ahl20006/House_git/taif_house/docs/DESIGN_LANGUAGE.md

# Taif / Palm House · design language

**Theme: modern classic with a Taif spirit.** Calm, warm, simple; the Taif references are in the stone, the arches, the colonnade and a little mashrabiya, not in ornament. Recorded 30 Oct 2026 (owner); every study and detail from here on follows it. The 3D character study (`3d/character.yaml`) is to be brought in line with this list when it is next touched.

*V9.0 (layout freeze, 6 Nov 2026):* the plan is frozen; the facades and the details are the next design stage and follow this list and the facade principle R-37 (the house stands inside a fully walled private farm: the facades are designed for light, views, climate and composition, not for privacy from outside). The 3D now shows the existing farm round the house (the old house, its covered parking, the walls and the gate, the palms) as plain approximate masses, not as design.

**9 Nov 2026 (owner): NO stone on the exterior.** No stone and no stone cladding anywhere outside, the malqaf tower included: every exterior finish is *render (plaster) and paint*. The character comes from the window proportions, the arches, the depth of the recesses and the projections that make shadows, all *built into the structure* in block and concrete, not applied later. Colours: a light sand render; an optional calm honey tone on the projections; a smooth or lightly textured exterior paint. Builder's rules: plaster mesh over every block / concrete junction before rendering; drips and falls on every projection from the start. **This supersedes every "honey stone" on the exterior below** (the plinth and the corners, the colonnade's columns and the arcade, the cornices and copings, the malqaf, the ladder's pilaster): read them as the same forms in render, the projections in the honey tone. **Floors too (owner, 9 Nov 2026): no stone and no marble on any floor, inside or outside: porcelain tiles everywhere**: inside a marble-look porcelain; outside (the courtyard, the colonnade, the riwaq, the paths, the guest path) an outdoor anti-slip porcelain (R11) in a sand / honey tone. Every "stone" or "marble" floor below reads as this porcelain. The facade study (windows, shaping, finishes) follows the plan freeze (open items 20, 21).

| Element | The language |
|---|---|
| Interior walls | Warm white (cream) plaster |
| Floors | **9 Nov 2026: porcelain tiles only**: marble-look porcelain inside; outdoor anti-slip porcelain (R11) in a sand / honey tone in the courtyard, the colonnade, the riwaq and the paths. *Was:* marble inside, matte honey-coloured stone in the courtyard |
| Cornices | Very simple, thin |
| Exterior | **9 Nov 2026: render and paint only** (light sand; the projections in an optional calm honey tone); the base and the corners shaped in the structure, no stone. *Was:* cream plaster with honey stone at the base (plinth) and the corners |
| Metal | Matte black; a few brass touches in the lighting |
| Timber | Medium-to-dark walnut (doors, soffits, built-ins) |
| Arches | Semicircular (Roman): the living's entrance arch and the TV arch; **V7.1:** the courtyard arcade with three arches under the projection (two slender stone columns between C21 and C22, courtyard bay only; the living bay keeps no arches) and arched heads on all the courtyard enclosure windows (six on the gallery edge over the arcade bays, two on the family living's edge, one large one over the living's courtyard glass): a two-tier classical arcade |
| Windows and doors to outside | Black steel with divided lites; the courtyard enclosure windows with semicircular heads (V7.1), the arched heads fixed, the operable lites below |
| Colonnade | Round honey-stone columns (the three two-storey columns of the courtyard) and, in the courtyard bay, two slender Ø0.25 intermediate columns of the arcade (V7.1) |
| Stair railing | Simple black bar railing; **V8.2:** the flipped stair's lower flight open to the riwaq behind a 0.90 m black-bar balustrade, the stair well's railing on the first floor the same |
| Mashrabiya | Only in a few places, not as a theme: the malqaf's carved grille and louvred outlet (V10.0), the non-escape windows (office, suite lobby, women's majlis, dining), never on an escape window (V8.0 fire safety); **adopted (V8.2, owner):** the suite court's south side a mashrabiya screen (timber or black steel lattice, ≈ 40 % open) on the 1.10 m base up to the facade frame's soffit: the palms seen out, no view in |
| Lighting | Mostly hidden (coves, under shelves, in the arches); a few feature pieces (lanterns under the colonnade, one piece over the dining) |
| Roof and roofline (31 Oct 2026, V8.1) | Flat roof, no pitched or tiled roof anywhere. A strong honey-stone **main cornice** on the outer facade edge at roof level, all round. On the north block a raised roof screen (an "attic") set back ≈ 1.0 m behind the cornice, plastered cream with a stone coping, **1.40 m** above the roof finish (V8.1: lower and balanced; it still hides the plant) — a plain pentagon; the south wing (gym and office) keeps the cornice and a **low parapet 0.70 m**, the fall protection a black steel guardrail set back 1.0 m and not seen from the street, so the roofline steps ≈ 0.7 m; across the suite court's south side the cornice and the parapet run on as a facade frame. Above the attic only one vertical: the malqaf head (V10.0) at the courtyard's north-west corner, inside the attic's pentagon, hidden from the gate. A simple thin stone cornice between the two floors. (`studies/roof.typ`) |
| The malqaf (V10.0, owner; L5) | *The symbol of the house, seen from the courtyard where the family lives:* an RC core at the courtyard's north-west corner in render and paint (no stone): at the ground floor the foot chamber's solid rendered face with a built-in bench on the riwaq, a carved timber door with a semicircular head onto the covered strip, the breeze outlet 1.4 × 1.0 with adjustable timber louvres in the first arcade arch; at the first floor the shaft at the gallery's end with a carved arched grille (a sealed provision) and a blind arched recess where W1-1 was; above the roof the head 1.6 × 2.4 on the first bay's axis, an RC frame with rendered block ribs, 3 / 5 slender arched slots per face on the 20 cm module (dark slots, a bird mesh behind), a thin band and a two-step Hijazi crown in the honey tone, 4.5 m above the attic coping; hidden from the gate by the north facade. The plant (the filters, the fan, the silencer) in the foot chamber; nothing on the roof. (`studies/malqaf_L5.typ`, adopted; the L1 tower of V9.3 superseded.) |
| Roof ladder (V8.1) | In the suite court, a honey-stone pilaster on the gym's east wall holds the maintenance ladder behind a flush walnut-finish panel: closed, the court reads a timber panel in a stone frame; the black steel stiles rise 1.10 m above the gym roof beside the court guard. |
| Courtyard (revised 3 Nov 2026) | Matte honey-light stone floor, LEVEL, no step; modern movable outdoor furniture (sofas, armchairs in outdoor fabrics, a low table); the outdoor TV in a semicircular honey-stone surround (a visual frame, no cavity) on the kitchen wall; one honey-stone box on the kitchen wall in front of the sink window for the raised water trough (a laminar lip over stone, no spray) and the tree; linear slot drains in bronze; no pergola. |

How to read it: black steel and divided lites wherever glass meets the outside, including the courtyard enclosure (`studies/courtyard_enclosure.typ`); stone where the hand or the eye meets the ground (plinth, columns, courtyard floor, copings); walnut where the hand meets the house (doors, handrails, the TV cabinet); nothing gilded, nothing carved.
| Coat cupboard and the store door (V8.2) | At the stair's start a full-height walnut coat cupboard (flush doors, no handles seen); the store under the half landing behind a low walnut door on the riwaq. |
| Site (V8.2, `studies/site_plan.typ`) | The guest path a 1.2 m band of honey stone along the driveway with black bollard lights; the garden's 1.2 m wall in honey stone with planting behind it; the hedge a clipped evergreen 1.8 m; the service yard screen plastered cream like the house with a stone base; the LPG cabinet matte black steel. The east stack (plumbing proposal) behind a removable panel of honey-stone slats on a black frame, on the service-yard face only. |
| Facade principle (owner, 3 Nov 2026) | The house stands inside a large, fully walled private farm (a 4 m north gate and a distant south gate; everything else walled and closed). Nobody outside can see the house. The facades are designed for light, views, climate (sun, heat, dust) and composition, NOT for privacy from outside. Blank walls only where a room needs them (furniture, structure, services) or where the owner chooses privacy from the guests' path to the majlis (west side). To be applied at the facade design stage (no geometry change now): the mashrabiya stays a climate and composition element, not a privacy screen, except on the guests' west side. |
| Powder room (3 Nov 2026) | The ground-floor family powder room: a stone or marble vanity with two basins under one large mirror, cove lighting, the wall-hung WC at the far end on a stone-clad service wall, walnut door from the riwaq. |
