ahl20006/House_git/taif_house/docs/REQUIREMENTS.md

# Taif / Palm House · owner's requirements (V6, 30 Oct 2026 · updated for V9.0, the layout freeze, 6 Nov 2026)

The owner's brief written as numbered, testable requirements. Each has a criterion the design can be checked against; where the owner gave no number, the criterion is a reasonable measurable proxy and is marked *(proxy)*. The design review `docs/review/design_review.typ` → `output/Design_Review_V6.pdf` checks every requirement against the project files (`data/*.csv`, the design files and the studies) and records **met / partly / not met** with evidence.

*V9.0 (6 Nov 2026):* the layout is frozen (`PROJECT_V10.md` §5); bedroom 1 is the room for very young children next to the master suite, with no en-suite (they are bathed in the suite's bathroom), which answers R-01 / R-09 for the children's bathing; the site requirements are met at the final position set out on site (B1 5.49 m from M1; the cut wall 0.42 m from a setback counted from the boundary wall as built, 0.90 m from the deed line), to be confirmed by the official survey.

Sources for the criteria: the owner's brief (this file); municipal villa rules as published by the Ministry of Municipal and Rural Affairs and Housing (MOMAH) and reported in July 2024 (building ratio up to 75 %, two parking spaces for villas over 400 m², driver's / maid's room ≥ 6.5 m² and ≥ 2.1 m wide); the Saudi Building Code (SBC 201 general, SBC 1101 residential, SBC 501 mechanical, SBC 601/602 energy, SBC 701 plumbing, SBC 801 fire); international practice (ISO 21542 accessibility, ASHRAE 62.2 residential ventilation, ASHRAE 52.2 / ISO 16890 filters, BS EN 17037 daylight, IRC residential stair and egress figures on which SBC 1101 is based). Where a code figure could not be read from the code text it is marked *not verified* in the review.

## A · Household and life
| ID | Requirement | Criterion |
|---|---|---|
| R-01 | 5–6 permanent residents; children of mixed ages, some sharing a bedroom | ≥ 4 bedrooms (master + 3) or 3 + one room convertible to a bedroom; at least one children's bedroom ≥ 12 m² clear that takes two beds (two 0.9 × 2.0 beds, two wardrobes, a desk) |
| R-02 | Live-in maid: a maid wing as designed, with her own bath and a private route | Maid room ≥ 6.5 m² and ≥ 2.1 m wide (MOMAH 2024), window, lockable door, own bath with shower; reachable without crossing family rooms — **met V7.0:** 7.28 m² clear, 2.49 m at the bed (the kitchen's north wall moved to y 7.0) |
| R-03 | No driver room in the house (the driver lives in the farm's workers' housing) | No driver room drawn |
| R-04 | No ground-floor bedroom; no prayer room | None drawn; a multi-use room may serve prayer informally |
| R-05 | Medium storage | *(proxy)* one general store ≥ 4 m² that is not temporary, a linen cupboard, a coat cupboard at the entrance (**V8.2:** a full-height coat cupboard in the stair's start strip; the store under the half landing), pantry cabinets ≥ 1.8 m run, an outdoor / garden store |
| R-06 | Ageing in place is very important: a lift | **Decided V6.3:** a two-stop lift installed at construction, before the family moves in; car ≥ 1.1 × 1.4 m, door ≥ 0.80 m clear; the shaft size from a supplier's civil drawing (open item) |
| R-07 | Wide corridors and doors | Door clear widths ≥ 0.85 m on every daily route including bathrooms (0.80 m minimum) — **decided V6.3:** every bedroom and bathroom door a 1.00 m opening with a 0.90 m leaf (the guest WC 0.90 m opening and the maid bath 0.70 m are the recorded exceptions); corridors ≥ 1.2 m clear (1.0 m minimum) — **met V7.0:** the gallery 1.405 m clear, 1.235 m at the column sleeves (the projection 1.55 m); a 1.5 m turning circle in at least one bathroom and at the lift |
| R-08 | Step-free routes | No step between the parking, the family entrance, the lift, the living / dining, the kitchen, the courtyard's level edge and every bedroom and bathroom; thresholds ≤ 15 mm |
| R-09 | Safe bathrooms | Level walk-in showers (no tray step), grab-bar blocking at every WC and shower, non-slip floors. **Owner, 3 Nov 2026: NO shower on the ground floor and no hidden provision** (G-07 closed): ageing in place relies on the lift (R-06) and the first-floor bathrooms; the ground floor has the family powder room (WC + two basins, a 1.5 m turning circle) and the guest WC |
| R-10 | Stair safe for life | Handrails on both sides, risers ≤ 170 mm, goings ≥ 280 mm, flights ≥ 1.0 m, straight flights (stairlift-ready), lit at night, headroom ≥ 2.1 m — headroom 2.22 m (**V8.2:** the stair flipped, option B: the lower flight rises south off the lobby, the upper flight arrives beside the lift; headroom 2.22 m at tread 6 under the mirrored trimmers); **V8.0:** the stair stops at the first floor; **V8.1:** the roof by a maintenance ladder in the suite court (not a stair for life: behind a locked panel) |
| R-11 | Daily family entrance directly from the parking; two shaded parking spaces | Two covered spaces inside the plot (MOMAH 2024: two for villas over 400 m²), ≤ 10 m walk to the family door, the walk covered, no step — **V8.2 (site plan, owner):** the family's existing covered parking for two cars south of the old house (beyond the plot) stays, plus one uncovered car in the north setback strip (kept; the municipality allows it), 0.3 m from the family entrance path; the walk from the covered parking is on the driveway, uncovered: *partly* |

## B · Guests
| ID | Requirement | Criterion |
|---|---|---|
| R-12 | New men's majlis for regular weekly guests, ≈ 20–24 | Perimeter seating ≥ 24 × 0.7 m = 16.8 m, a serving route that does not cross the seats, AC not over the seats |
| R-13 | Very large events (30+) use the old majlis on the farm | The new majlis need not seat 30+; no second guest WC is required for that case |
| R-14 | Guest facilities separate from the family | Own entrance, foyer with a majaz (no straight view in), guest WC and basins reached without entering family space |
| R-15 | Full separation: a guest must never see any family area | No sightline from the guest entrance, foyer, majlis or guest WC into any family room, the courtyard, the family entrance or the family's cars; serving without eye contact |
| R-16 | Women guests are rare | A room usable by women guests reached from the family entrance without crossing the men's route |

## C · Kitchen and food
| ID | Requirement | Criterion |
|---|---|---|
| R-17 | Daily heavy Saudi cooking by the owner and his wife; kitchen closed with a door | A door on every opening of the kitchen to living space; hood ≥ 600 m³/h exhausting directly outside with make-up air; durable finishes; ≥ 2 counter runs of ≥ 3.0 m |
| R-18 | Medium pantry (cabinets) | Tall storage ≥ 1.8 m run in or beside the kitchen |
| R-19 | Outdoor kitchen with grill and tannour outside the house, next to the kitchen service door (owner, 3 Nov 2026; was: at the south-east corner) | Drawn at the SE corner, reached from the kitchen service door, downwind of the house (prevailing wind NW), with a family seating area near the palms — **V8.1:** the counter and sink against the east wall at the south-east on the service-door path, the grill and tannour apart in the garden, 3.6 m from the house (`design_gf.typ` site outlines); **V8.2:** on the site plan with the family garden round the palms; **3 Nov 2026:** the counter and sink next to the service door (under the kitchen window, a canopy optional), the grill and tannour a little apart in the yard's south part, ≥ 3 m from every door, window and the hood outlet, 13 m from the HRV intake, downwind |
| R-20 | Service yard (bins, gas) screened from the outdoor-kitchen path | Bins and the gas cabinet at the service door, behind a screen, not on the family's path to the outdoor kitchen — **V8.0:** a 1.8 m screen along the yard, the path in front of it; **V8.2:** the LPG cabinet on the screen's outer face (≥ 1.5 m from every opening, ≥ 3 m from the manhole; the rule stated); **3 Nov 2026:** the screen moved east for the counter's working strip, the gas cabinet at the screen's north end ≥ 3 m from the grill, the bins north of the service door away from the food, the workers' route along the farm's boundary wall (not the house's north facade) ending at the gas and the bins |

## D · Daily life
| ID | Requirement | Criterion |
|---|---|---|
| R-21 | Living + dining in one room ≈ 53.5 m² clear, for TV, family meals and close relatives equally | 50–57 m² clear; a dining table for 10; TV seating for 6–8 |
| R-22 | TV 85″ on the west wall inside the big arch, seating facing it, dining behind; a good sound system, no cinema | The west wall solid and full height with the TV arch and the small entrance arch; sofa 3–5 m from the screen facing west; the dining east of the seating; conduits and speaker positions provided |
| R-23 | The courtyard is the heart: daily sitting, coffee and meals (children's play in the garden, owner 1 Nov 2026) | ≥ 20 m² usable floor, seating for 4 comfortably (6 at most) with a low table for meals, the outdoor TV, lighting, a hose point and drainage; no level play zone required in the courtyard (it moves to the garden, R-30); no pergola or shade structure (`studies/courtyard_layout.typ`) |
| R-24 | **Revised 3 Nov 2026:** the whole courtyard floor LEVEL (no step anywhere), modern movable furniture (sofas, armchairs) for 4–6 with a low table, the outdoor TV on the kitchen wall (**V10.0:** the malqaf outlet moved to the first arcade arch on the west side, L5), the water + tree enclosure on the kitchen wall in front of the sink window | Drawn as decided (`studies/courtyard_layout.typ`): gentle falls from the glass lines to linear drains on the separate rain system with trap primers and an overflow route, the malqaf outlet's bottom 0.10 above the floor in the first arcade arch (V10.0), the raised water trough's rim below the sink sill (seen from the sink), a laminar lip over stone, the two basins drained separately; the north side in front of the women's majlis glass free; no pergola |
| R-25 | Dust: the house is closed most of the time; filtered mechanical fresh air | ERV / HRV with ISO ePM1 ≥ 50 % (≈ MERV 13) or better filters, slight positive pressure; airtight windows and doors; the conditioned envelope closed on all sides — **decided V7.0:** the courtyard enclosure option A; **V8.0:** a 750 m³/h class HRV in the malqaf's base; **V10.0 (owner): no HRV: a 750 m³/h filtered supply fan** (a washable pre-filter + ISO ePM1 ≥ 50 %, a silencer) in the malqaf's foot chamber at the courtyard's north-west corner, the house at a slight positive pressure, two switches and a dust relay, the hood's make-up inlet mandatory (`AIR_SYSTEM.md` v4; the MEP engineer designs it, open item 9) |
| R-26 | Owner's office, used sometimes | An office ≥ 12 m² with a desk, visitor chairs and shelves — **met:** 13.96 m² clear on the east; **V8.1:** for the owner only, reached from the suite court; visitors are met in the men's majlis |
| R-27 | Small family gym (V8.0: on the west band) | ≈ 18 m² clear; the treadmill with a manufacturer-type zone (2.0 m behind, 0.5 m each side); the other equipment; a double wall to the neighbouring bedroom (Rw ≈ 55 dB) — **met V8.0:** 19.9 m² clear incl. the entrance nib |
| R-28 | Master suite: freestanding tub plus walk-in shower; no coffee corner; medium quietness | Tub and walk-in shower drawn; no coffee corner; no noise source (plant, gym, majlis) adjacent without Rw ≥ 50 dB separation; no operable opening from a noisy room into the suite court — **V8.0:** the office (quiet) is the suite bedroom's neighbour, no door between them; the gym 4.7 m away across the court |
| R-29 | No pets | No pet provisions |

## E · Outside, energy, security
| ID | Requirement | Criterion |
|---|---|---|
| R-30 | A garden around the house (trees, lawn, seating); children's play in the garden (owner 1 Nov 2026) | **V8.2 (site plan, owner):** the family garden on the south side only, round the palms (≈ 289 m²), behind a 1.2 m rendered wall (V10.0: no stone) and a 1.8 m hedge; no other garden round the house; **no garden door from the living** (S-04 not needed, owner): the garden is reached from the kitchen's service door round the south-east corner or from the guest entrance side; the palms kept; a level play area in the garden |
| R-31 | Solar PV: full provision now, installation later | Roof area reserved and free of shade; fixing points cast before waterproofing; conduits from the roof to the panel; an inverter / battery room; a load assumed in the roof structure — **partly V8.1:** 9.8 m² on the gym roof and the office roof inside the set-back guardrail and 20.5 m² on the north block (`studies/roof.typ`); **V8.2:** the conduits down the west shaft to the utility room, where the inverter and the battery cabinet go (owner; the electrical engineer confirms space, ventilation and fire safety; the layout with the water kept away in `studies/plumbing.typ`) |
| R-32 | Power cuts with rain: backup | **Changed by the owner (V8.2, review E-05): no generator.** The backup comes from the PV and the batteries when installed; until then there is no backup during power cuts (the lift, the malqaf's fan, the pumps and the gas valve stop; the gas valve and the malqaf's dampers fail closed); an essentials circuit at the main panel for the later batteries (pumps, fridges, network, cameras, some lights, the lift's battery lowering) |
| R-33 | Security high: CCTV, alarm, video intercom at the gates and doors | Camera positions at the gate, the three doors and the yards; an alarm; intercoms at the gate and both entrances. **Owner, 1 Nov 2026: no safe room** (home-level strategy; `studies/fire_escape.typ` §4). **V8.2 (site plan):** a video intercom and camera C1 at the single gate, cameras C2–C7 round the house (the driveway, the family entrance, the guest entrance and path, the service yard, the garden, the suite court's outside), the recorder and the alarm panel in the utility room, keypads at both entrances; positions proposed, the electrical engineer designs it |

## F · Priorities and decisions
| ID | Requirement | Criterion |
|---|---|---|
| R-34 | Quality first (high budget); luxury most important in the living room and the courtyard | The living and the courtyard get the best light, proportions, materials and acoustics; nothing cheap there |
| R-37 | **Facade principle (owner, 3 Nov 2026):** the house stands inside a large, fully walled private farm (a 4 m north gate and a distant south gate; everything else walled and closed). Nobody outside can see the house. The facades are designed for light, views, climate (sun, heat, dust) and composition, NOT for privacy from outside. Blank walls only where a room needs them (furniture, structure, services) or where the owner chooses privacy from the guests' path to the majlis (west side) | Applied at the facade design stage: every wall now drawn blank or with small / high windows for privacy (the north facade first: the women's majlis, the kids' room and the family living above) is a candidate to open with larger windows (north light: soft, no direct sun); the escape windows and the climate rules (shading, dust) still govern; the list in `docs/PENDING_CHANGES.md` |
| R-36 | Fire safety at a family-home level: early warning and safe exit (owner, 1 Nov 2026) | Interconnected mains smoke alarms with sealed battery back-up in every bedroom, outside each sleeping area and on every floor, a heat alarm in the kitchen, a gas detector with shut-off and a CO alarm; every exit door opens from inside without a key; hinged escape casements without screens in every sleeping room (net ≥ 0.53 m², sill ≤ 1.12 m), the suite court as the suite's refuge; a fire blanket and an extinguisher in the kitchen, one per floor at the stair; no sprinklers, fire doors, panel, beam detectors, majlis second door or safe room (`studies/fire_escape.typ`) |
| R-35 | Recent decisions to respect | West living wall full height and solid with the big TV arch and the small entrance arch; no arches between the colonnade columns; colonnade columns to the roof; upturned edge beam; the malqaf outlet in the first arcade arch (V10.0, L5; was on the kitchen wall); kitchen service door; **V7.0:** the courtyard enclosure option A, the maid room at y 7.0, the flat roof with the main cornice and the set-back attic, the design language; **V7.1:** the arched enclosure windows and the three-arch courtyard arcade; **V8.0:** the fire safety at home level, the courtyard layout, the air system v3.1, the internal stair to the first floor only, the south wing v2; **V8.1:** the roof by a maintenance ladder in the suite court, the roofline lowered (attic 1.40 m, south parapet 0.70 m with a set-back guardrail), one site entry (the farm's 4 m main gate); **V8.2:** the stair flipped (option B) with the family bath F-b and the coat cupboard, bedroom 1 without a bath, the suite court's mashrabiya, the clerestories openable, the food route accepted, the site plan's decisions (the north parking kept, the south garden, no garden door, no generator, the septic near C1 and the tank east of peg R); **V10.0:** the malqaf at L5 (the courtyard's north-west corner), no HRV, no stone anywhere (render and paint; porcelain floors), simple controls — each present in the files as decided |
