ahl20006/House_git/taif_house/3d/README_3D.md

# 3D model · Taif / Palm House V10.0 · phases 1–3 + character study + the V7.0 – V9.0 design (enclosure, roofline, arcade, the level courtyard layout, air system v3.1, south wing v2, roof ladder, the flipped stair, the court's mashrabiya, the site elements)

**V10.0** (the malqaf at L5; no stone): the malqaf core at the courtyard's north-west corner from `design_gf.typ` `tower-csv` and the `air-*` data of `studies/air_system.typ` v4: the GF foot chamber (the dust trap `gf_air_trap_*`, the fan cabinet, the cooler's floor mark, the louvred outlet `gf_air_grille` in the first arcade arch, the carved door drawn open `gf_air_door_leaf`), the shaft opening 0.96 m² through the FF and roof slabs, the head 1.6 × 2.4 to +13.20 as an RC frame with the slender arched slots as dark voids (`roof_air_head*`, `roof_air_void_slots`, the band and the crown in the honey tone); the L1 tower, its plant room, plenum and the channel removed; the blind arch where W1-1 was (`arched_windows.blind`); the palette renamed for the no-stone decision (`honey` = the honey-tone render, `sand` = outdoor porcelain, `porcelain` inside); the `court` bookmark (the outlet arch, the blind arch and the head on one axis); the viewer's note. Renders: `char_court.png`, `char_gate.png`, `char_aerial_sw.png`.

**V9.3** (the L1 malqaf tower, superseded by V10.0): the slim shaft along the cut wall (its slab openings ≈ 1.06 m²), the rooms round it from the CSVs (the maid store, bedroom 1's cupboard); above the roof the 1.25 m honey-stone tower on the attic's corner (`roof_air_head*`, `roof_air_cap`; the slender arched openings as dark voids `roof_air_void_slots`), crown +12.18; the HRV plant room behind the attic (`roof_air_plant_*`), the plenum, the exhaust grille; the old head and base removed; a north-east aerial bookmark (`aerial_ne`); the viewer no longer clips above +10.0 m. Renders: `char_gate.png`, `char_aerial_ne.png`.

**V9.2** (small fixes, no new renders): the air tower a rectangle (1.425 × 1.0 on axes, the shaft opening ≈ 0.98 m², the head open on its north, west and east faces), the maid bath and bedroom 1 with the wedge beside it (from the CSVs), the HRV base at its V9.0 footprint, the attic 2 cm lower (coping +8.68).

**V9.1** moved the model to the final site position (`character.yaml` `site.shift` 0.91 / 6.0734, B1 6.00 m from M1; every house-attached site element with it; the parking bay on the car's turning line) and shortens the cut wall a further 0.24 m (the outline, the air tower and its shaft ≈ 1.25 m², the HRV base, the maid room, the maid bath and bedroom 1 from the CSVs, their windows on the cut); render: `char_aerial_sw.png`.

**V9.0 (layout freeze)** brought the model fully up to date, every part generated from the files: the house at its **final site position** (`character.yaml` `site.shift` 0.91 / 5.563, every house-attached site element 0.50 m further south), the **cut wall 0.12 m further out** (the outline, the air tower and its HRV base, the windows on the cut from the design files and `params.yaml`), and the **existing farm round the house** (`character.yaml` `site.elements` with `existing: true`, from `data/site_v2.csv` and the owner's answers; approximate, to be measured): the old house as a plain 3.8 m mass and its annex wall from the deed sketch, the covered parking (posts and a roof), the ground tank's lid, the septic, the farm's north and lane walls on the deed line with the 4 m gate's two posts, the two palms (trunks and crowns, heights assumed). The builder gains the element kinds `block`, `canopy` and `palm`; check 10 checks the existing farm apart (on the ground, in the north zone, nothing touching the house) and the tower's shaft bound follows the bigger tower. **Renders V9.0:** `char_aerial_sw.png` (the house, the driveway, the old house, the palms, from the south-west), `char_gate.png` (the north facade from the main gate, a new view), `char_living.png` (the main courtyard from the living), `char_court_screen.png` (the suite court with the mashrabiya).

**V8.3** rebuilds the **courtyard layout** from `character.yaml` `courtyard_layout`: the floor level (the base model's courtyard floor kept, no pit, no benches), the movable furniture (group `sunken` = the layout toggle in the viewer), the enclosure on the kitchen wall in front of the sink window (the planter rim +0.45, the raised water trough rim +0.95), the TV and its surround moved south over the grille (+0.10 … +0.45), the linear drains and the overflow; check 10 verifies it. The **outdoor kitchen** moved next to the service door (`params.yaml` `outdoor_kitchen`) and the **site elements** follow the re-planned yard (the screen, the gas cabinet, the bins, the workers' path along the boundary wall). The first-floor rooms from the CSV carry bedroom 2's en-suite and the family WC; the ground floor the powder room. Renders: `char_living.png`, `char_lobby.png`.

**V8.2** adds, all generated from the files: the **flipped stair** (`studies/structure.typ` `st` with its direction: the lower flight on the east half rising south off the lobby with its black-bar balustrade on the riwaq, the half landing at the south end with the store under it, the upper flight arriving beside the lift; the trimmers mirrored), the **larger family bath F-b** with its WC compartment (from the CSV), the **coat cupboard** (`character.yaml` `coat_cupboard`), the **suite court's mashrabiya screen** (`character.yaml` `suite_court_v2.south_side` chosen b: a timber lattice from the 1.10 base to the frame soffit, ≈ 40 % open, built by `character_3d.py`), and the **site elements** of the site plan that the builder supports (`character.yaml` `site`, group `site`: the driveway, the family, guest and workers' paths, the north parking bay, the south garden with its stone wall and the hedge, the yard screen and the gas cabinet; study, every position proposed). Check 10 verifies the screen and the site elements. Renders: `char_lobby.png`, `char_court_screen.png`, `char_aerial_sw.png`.

**V8.1** adds, all generated from the files: the **roof ladder** in the suite court (`params.yaml` `roof_design.ladder`: a honey-stone pilaster on the gym's east wall with a 0.90 × 0.30 recess, the closed walnut-finish panel, the stiles and 13 rungs, the stiles 1.10 m above the roof, the self-closing gate in the court's west guard); the **lowered roofline** (the attic 1.40 m above the roof finish, coping +8.70; the south wing parapet 0.70 m, +8.00); the **set-back guardrail** 1.10 m, 1.0 m in from the south wing's faces (`guardrail_setback`); the **outdoor kitchen** (`outdoor_kitchen`: the counter against the east wall, the grill and tannour apart); the office's east window. **Renders V8.1** (`render_views.py`): `output/char_north.png` (the north facade from the street), `char_aerial_se.png` (the roofline and the malqaf tower from the south-east), `char_suite_court_sw.png` (the suite court from its east armchair, looking west-south-west to the gym wall with the ladder panel). The other renders in `output/` are from earlier versions.

**V8.0** added the internal stair stopping at the first floor (the roof slab closed over the well, no stair room), the **air system v3.1** (the malqaf head open on three faces over the **HRV base** on the roof), the **courtyard layout** (the seating one step down, the benches, the TV in its stone surround with the grille below it, the north enclosure with the water basin and the tree; no pergola, no fountain, no sunken pit) and the **south wing v2** (the gym on the west band, the 25 m² suite court open to the south facade over a 1.10 m base with R8 as its frame, the office on the east) with the court's guards and seating.

**V7.1** adds the **courtyard arcade** (two Ø0.25 stone columns on x 5.80 at y 8.667 / 10.833 with three semicircular arch plates under the projection's soffit, courtyard bay only, decorative) and **semicircular heads** on the enclosure windows (W1 six, W2 two, W3 one; the base model cuts each opening to its crown, the character layer draws the spandrel plate and the arched frame); the family living is open to the gallery's north end (W2 only east of C21); marble floors inside, honey-light stone in the courtyard.

**V7.0** adds, all generated from the files: the courtyard enclosure windows **W1 / W2 / W3** (walls with steel windows on the former open edges, the W3 wall piece over the living's courtyard glass), the **1.55 m projection** with the colonnade at x 5.80, the **stair to the roof** (flights 3 / 4, the roof opening with R16–R18, the stair room), the **roofline** of `studies/roof.typ` (the main cornice, the band between the floors, the north block's coping, the south wing's parapet, the set-back attic with its doors and coping; `params.yaml` `roof_design`), the roof guards, the maid-wing change, and the **design-language colours** (`docs/DESIGN_LANGUAGE.md`: cream plaster, honey stone, black steel divided lites, walnut) with stone quoins and divided-lite bars on every window. The gallery railing variants (parapet / glass) are gone: the gallery edge is the wall with W1.

The 3D model is **generated from the project files, never edited by hand**. One script reads the room data, the design files, the two first-floor studies, the presentation's door and window lists and the structural study, and builds the model; any change in those files → run the script again → the 3D updates.

**Every structural element in the model is marked:** orange = *assumed, not approved by the engineer* (sizes from `studies/structure.typ`), red = *unconfirmed load path* (X5). Nothing here is a structural design.

**The character study** (tags `3d-char1`, `3d-char2`, `3d/character.yaml`) is a **STYLE STUDY, PROVISIONAL**: materials and a few added elements for the owner to compare in the viewer; the viewer says so on every view. It changes nothing in the design files, the room CSVs or `params.yaml`; see § Character study below. Revision 2 (`3d-char2`): lighter, warmer colours; the views rendered with the sun and shadows; the malqaf outlet on the kitchen wall (an owner decision recorded in `studies/air_system.typ`, `docs/AIR_SYSTEM.md`, `data/decisions.csv`) with the sunken seating under it (variant, on by default).

## What the model contains (phases 1–3)
- **Slabs** at structural levels: ground slab (−0.28 … −0.08), first-floor slab (top +3.52) with the courtyard sky, the double-height living and the L-shaped stair opening cut out, roof slab (top +7.20) with the courtyard sky and the suite court cut out. **Since V6.3 the first-floor and roof bays carry the thickness of `studies/structure.typ`** (`slabs-ff` / `slabs-roof`: 0.30 ribbed over the kitchen, dining, men's majlis, suite and office, 0.22 flat over the double-height void, 0.20 elsewhere), all assumed; the walls run to the 0.20 underside (+3.32 / +7.00) and the thicker bays hang below it (+3.22 / +6.90, +6.98 under the 0.22). The slabs run to the **outer face** of the outer walls. **Floor finishes** 0.08 on both floors (to ±0.00 and +3.60) and a 0.10 roof finish (to +7.30).
- **Outer walls** of both floors, 0.25 m, centred on the pentagon outline; **interior walls** 0.20 m on the room edges, from the structural slab top to the underside of the slab above; **open edges** (`open_edges.csv`) left open. A room edge that lies on the outline with rounded corners (the cut wall: 10.594 for 10.5943) is the outer wall, not a wall of its own (corrected in `3d-char1`: five 0.20 walls were built inside the outer ring along the cut, and the cut wall's four windows were cut through them instead of the outer wall).
- **Doors and windows of both floors**, cut through the walls with their sill and lintel pieces: 28 doors (leaves modelled closed; the courtyard glass door and the suite court door as glass) and 31 windows (glass, transparent in the viewer), among them the courtyard glazing (full height under the beams), the living glazing split by column C22, the two clerestory windows at +5.00 … +6.00, the kitchen service door and the suite bath's 0.60 m east window (X3). Heights are assumed in `params.yaml` (the plans have none yet).
- **The stair** exactly as drawn in `studies/structure.typ`: two flights of 1.21 m side by side, 22 risers × 0.164, goings 0.28, the half landing at +1.80 (store below, 1.57 m clear), the arrival at +3.60 on the first-floor slab, the L-shaped opening (≈ 8.2 m²), the trimmers B16–B18 (0.20 × 0.40 total, soffit +3.12), the balustrades (0.90 above the nosings) and the first-floor railings round the well (1.10). The headroom over every tread is checked to the underside of the beams / slab.
- **The colonnade – gallery zone:** the three colonnade columns C21–C23 (Ø0.30) from the ground slab to the roof (X8), the edge beam B3 **upturned** on x 5.6 (0.25 × 0.50 total: 0.30 above the structural slab, 0.22 above the finished gallery floor) with the gallery railing on it, the dining-step beam B5 under the suite wall (soffit +2.97), the roof edge beam R11 over the gallery strip; column C33 in the east wall (for the X3 check). **R6** (the gym roof beam on the two gym walls over the men's majlis ribs) and those two walls are **red: unconfirmed** (X5).
- **Railings** 1.10 m on the gallery edge (on the upturned beam), the family living's courtyard edge and the stair well.
- **Coloured room plates** (by room type) with the room names in the plan views; **sun positions** for Taif at 9:00 / 12:00 / 15:00 in summer and winter with shadows; three **eye-level bookmarks**.
- **The air system v3.1** (`studies/air_system.typ`, `docs/AIR_SYSTEM.md`, all assumed, orange): one tower; the dry head 2.5 m above the roof open on three faces (north, west and the cut face; the south face sits behind the HRV base) with its cap; the **HRV base** on the roof (walls 0.20, top +9.10, a door and the exhaust louvre); the shaft through both slabs to the courtyard breeze path; the grille under the outdoor TV on the kitchen's west wall. *History:* the v2.1 pit, the route-E duct and the chamber are withdrawn.
- Not yet (later phases): the rest of the structure (all columns and beams, ribbed slabs, 0.22 flat roof over the void: phase 4), lift, the roof railing on the suite court edge as a design element (phase 5; the character study shows one), IFC/OBJ export (6), site, furniture.

## Character study (style study, provisional)
`3d/character.yaml` → `3d/character_3d.py` (called by `build_3d.py`) adds **53 meshes named `chr_<group>_<material>_<label>`** from the file and the model's own data (openings, columns, beams, voids, the air system). The viewer's **character** toggle shows them and re-colours the model's own meshes by material (`assign` in the yaml: walls plaster, floors light stone, doors timber, railings bronze, the malqaf head stone …); off, the phase-3 model with its orange / red flags is what you see. The plan views always show the plain model. Nothing is edited by hand: change the yaml, run `build_3d.py`.

**Direction:** contemporary, inspired by Taif / Hijazi architecture: clean lines, natural stone, timber, deep shaded openings, a stone colonnade with an upper gallery round a courtyard open to the sky. Simple, not ornate. Flat colours only.

**Light (revision 2):** with the character on, the eye and overview views switch on the **sun with its shadows** (`sun: summer-09` in the yaml: 21 June 9:00, from the east-north-east at 48°, Taif, true north from `base.typ`) over a soft ambient light, so the forms read in light and shade; the viewer's sun menu changes it; the night view switches it off.

| Element | What the study draws | Where set |
|---|---|---|
| materials | cream plaster (light, warm) walls and parapets; warm honey-coloured Taif stone columns, plinth, feature walls, copings, the sunken seating's bench; light natural stone floors; medium warm timber soffit, pergola, screens, doors, louvres; dark bronze frames and railings; glass transparent | `palette`, `assign` |
| plinth | a stone base course 0.6 m high round the outside, 0.04 proud, the three outer doors cut through it | `plinth` |
| deep reveals | the 21 outer-wall windows' glass set back **0.20 m** from the outer face (the base model's centre-line panes are hidden); bronze frames 0.05 on all 31 windows | `reveal`, `frame` |
| colonnade | stone sleeves **Ø0.40** round C21–C23 (the assumed Ø0.30 columns stay inside), plain base and capital bands, from the finished ground floor to the roof underside | `colonnade` |
| soffit | timber soffit 0.05 under the projection (x 4.35–5.725, y 6.6–19.15, +3.27 … +3.32) and a timber fascia on the slab edge and the upturned beam (+3.27 … +3.82) | `soffit` |
| gallery edge (V7.0) | the base model's wall on x 5.80 with the steel window W1 (+3.82 … +6.75) on the B3 upstand; black steel frames and divided lites (mullions ≈ 0.78, rows ≈ 1.0) on every window | `lites` |
| ~~gallery railing on B3~~ | removed in V7.0 (W1 instead); the text here is history: **A** a plastered parapet, **B** glass with a handrail to +4.70 (toggle) | `gallery_railing` |
| ~~pergola~~ | removed in V8.0 (the courtyard layout: no pergola); the viewer's pergola toggle is hidden | — |
| mashrabiya | timber lattice screens (frame 0.06, slats 0.03 at 0.09 / 0.27) flush with the outer face on 11 windows: FF kids' room north (street); FF bedrooms 2 and 3 and the office west (driveway / street); FF bedroom 1 on the lane (2); FF suite bedroom east (service yard / neighbour); FF suite lobby onto the courtyard (the only first-floor window on the courtyard); GF women's majlis north (street); GF dining east. A proposal: edit the list | `mashrabiya.windows` |
| feature walls | Taif stone cladding 0.03 with the openings cut out: the guest entrance wall (west facade, y 19.25–24, both floors to the coping); the courtyard's east wall (kitchen below, suite lobby above, down to the sunken floor); the courtyard's north wall piers beside the women's majlis glass and the band over it (the glass stays complete) | `feature_walls` |
| malqaf outlet (owner decision, `3d-char2`) | the base model's grille (`gf_air_grille`, from `studies/air_system.typ`) now sits on the courtyard face of the **kitchen's west wall**, y 7.7–8.7, +0.15 … +0.75, directly over the sunken seating's bench; the study re-colours it timber (mashrabiya-type) and adds a stone upstand lip at its sill. The north-wall stone pier of revision 1 (A7 option 2) is removed: A7 is resolved by the move | `assign`, `sunken.upstand` |
| ~~fountain~~ | removed in V8.0: the water is in the north enclosure's basin (a laminar lip over stone, no spray) | `courtyard` |
| **courtyard layout** (V8.0, owner) | the seating one step down (−0.15) with a honey-stone nosing and a riser light, three stone benches with cushions and backs, a low table, the pit drain and the overflow; the outdoor TV in a semicircular stone surround on the kitchen's west wall with the malqaf grille below it; the north enclosure: a honey-stone box with the water basin, the lip, the pump cover, a divider, the soil and one tree. *History:* the 0.45 m sunken pit of `3d-char2` is withdrawn. The viewer's former sunken toggle shows the layout (default on) | `courtyard` (built in `character_3d.py`) |
| roof (V7.0 / V8.1) | the parapets, the cornice, the attic, the HRV base, the ladder and the set-back guardrail are base-model meshes (`params.yaml` `roof_design`), re-coloured here; black steel bar guards 1.1 m round the courtyard sky and the suite court's open edges (`suite_court_v2.guards`, with the gap for the ladder's gate), clear of the attic wall; the malqaf head stone with timber louvre slats on its three open faces | `roof`, `malqaf_louvres`, `suite_court_v2` |
| props (scale only) | two hanging lanterns under the soffit edge between the columns (the olive, the bench and the table belong to the sunken seating) | `props` |
| **TV wall** (V6.3, owner) | the living's west wall solid and full height (a base-model wall since V6.3); the character layer adds the 1.40 m entrance arch's head (+2.60, semicircular), the TV niche's 0.25 m pier, its 0.10 m arched face plate (4.40 wide, crown +3.10, segmental rise 0.45) and soffit, the low cabinet, the 85″ screen and the side shelves. The arches variant of r1–r2 is removed: **no arches between the colonnade columns** | `tv_wall` |
| views | living (inside the double-height living, looking north to the courtyard and the sunken seating), street (the guest entrance facade from the west, the driveway side), north facade, aerial from the south-west, the courtyard at night (lanterns, warm room lights, the glass glowing, a low light at the fountain) | `views`, `night` |

**What is not a decision here:** every colour and element; the stone sleeve is cladding, not a column size; the arches are decorative; the fountain is a shape (its water and drain are for the MEP engineer, A8 / A6); the sunken seating is a variant whose drain, overflow and waterproofing are for the MEP and structural engineers; the pergola's bearing on the roof edge beams is for the engineer if it stays. The malqaf outlet's position is an owner decision (`data/decisions.csv`), its sizes stay assumed.

**Renders** (`render_views.py`, headless Edge, the sun on). **V10.0:** `char_court.png`, `char_gate.png`, `char_aerial_sw.png`. *V9.3:* `char_gate.png`, `char_aerial_ne.png`. *V9.1:* `char_aerial_sw.png`. *V9.0:* `char_aerial_sw.png`, `char_gate.png`, `char_living.png`, `char_court_screen.png`. *V8.3:* `char_living.png`, `char_lobby.png`. *V8.2:* `char_lobby.png`, `char_court_screen.png`, `char_aerial_sw.png`. *V8.1:* `char_north.png`, `char_aerial_se.png`, `char_suite_court_sw.png`. *V8.0:* `char_courtyard.png`, `char_suite_court.png`, `char_tv.png`. The older renders below are kept from V7.0 / V7.1 and are not refreshed. *V7.0:* `output/char_north.png` (the north facade from the street: the main cornice, the set-back attic behind it), `char_aerial_sw.png`, `char_eye2.png`, `char_w3.png`.

## Levels: structural and finished
| | Finished (plans, sections) | Structural slab top | Slab | Underside |
|---|---|---|---|---|
| ground floor | ±0.00 | −0.08 | −0.28 … −0.08 | — |
| first floor | +3.60 | +3.52 | +3.32 … +3.52 | +3.32 |
| roof | +7.30 (finish top) | +7.20 | +7.00 … +7.20 | +7.00 |

The **finished** levels are the levels of the plans and sections (±0.00, +3.60); the **structural** slab top lies one floor finish (0.08, assumed: screed + tiles) below them. Slabs and beams are modelled at structural levels; doors, windows, the stair (risers, half landing, arrival) and the railing heights at finished levels. So a beam of 0.55 total depth under the first floor has its soffit at +2.97 = 2.97 m above the finished ground floor (the structural study quotes 3.05 "before finishes"; the difference is the finish). The engineer fixes the final levels (`docs/OPEN_ITEMS.md` item 6).

**Slab thicknesses:** 0.20 everywhere in the model for now. The structural study proposes 0.30 ribbed slabs for the 4.36–4.75 m bays (kitchen and dining roofs, men's majlis roof, suite, office) and a 0.22 flat roof over the double-height living; they are modelled when the structure is added (phase 4).

**The white dots of phase 2** along the slab lines were real: the slabs stopped at the wall centre line, 0.125 m inside the outer face, leaving a groove where the ends of the interior walls met the slab edge. The slabs now run to the outer face; the check confirms the plan extent of every slab and that every wall end meets another wall, the outer wall or an open edge.

## Files
| File | What it is |
|---|---|
| `params.yaml` | every dimension the model uses (levels, finishes, slab and wall thicknesses, opening heights, railing heights, stair waist, the marked structural elements, the sun and the bookmarks) and the source paths; nothing is hard-coded in the script |
| `build_3d.py` | builds the model → `output/taif_house_V10.0.glb`, `output/taif_house_V10.0.js` (the GLB as base64 + rooms, flags, sun, bookmarks and the character palette for the viewer), `output/model_summary.json` |
| `character.yaml`, `character_3d.py` | the character study (style, provisional): the palette, every element's sizes, the mashrabiya list, the feature walls, the arches variant, the extra views; the module that builds the `chr_*` meshes from them |
| `open_edges.csv` | the room edges that have no wall, with the source of each |
| `check_3d.py` | the checks (below); also run by `tools/check.py` |
| `viewer.html` + `lib/` | the viewer (three.js r147, vendored, works offline from the repo) |
| `render_views.py` | screenshots with headless Edge → `output/view_nw.png`, `view_se.png`, `plan_gf.png`, `plan_ff.png`, `plan_air.png`, `eye1.png` … `eye3.png`, `sun_summer_09.png` … `sun_winter_15.png`, and the character study's four `char_*.png` (others by name) |

## How to run
```
pip install trimesh shapely numpy pyyaml mapbox_earcut
python taif_house/3d/build_3d.py       # build the GLB (phases 1–3 + the character meshes)
python taif_house/3d/check_3d.py       # check it (3D CHECKS PASSED + the flagged items)
python taif_house/3d/render_views.py   # screenshots (Windows, Microsoft Edge; headless Edge needs the real GPU process: run it outside a sandbox)
```
`python taif_house/tools/check.py` runs the build and the checks as its step 6.

**Viewer:** open `taif_house/3d/viewer.html` in a browser (double-click; no server needed). Left drag orbits, the wheel zooms, right drag pans. Buttons: north-west / south-east overviews, **plan GF / plan FF** (orthographic, room colours and names, cut 1.5 m above the floor), **eye 1–3** (eye level 1.6 m: inside the double-height living looking north to the courtyard; from the courtyard looking west to the colonnade and the gallery; from the stair landing along the gallery), **living → sunken seating / street / north facade / aerial SW / courtyard at night**; a **sun** menu (Taif, true north from `base.typ`) switches on the shadows (with the character on, the eye and overview views pick the yaml's sun by themselves). Toggles hide the first floor and the roof; the slider cuts the model at any height; the flags are listed in the panel. The **character** box: character on / off, the **arches variant**, the **pergola**, the **sunken seating**, the gallery railing **parapet / glass**, **night**; a badge at the bottom right says *style study, provisional* on every character view. URL options for screenshots: `?view=nw|se|top|top_gf|top_ff|top_air|eye1|eye2|eye3|living|street|north|aerial_sw|night&roof=0&ff=0&cut=5&sun=winter-12&labels=0&ui=0&character=0|1&pergola=0|1&sunken=0|1&railing=parapet|glass&night=0|1`.

## Frame and units
- Metres. The model is in the **CSV frame** of the plans: origin = the building's north-west wall corner, x east, y south (the DXFs are in the site frame, shifted by (0.91, 3.525) m; the 3D is not shifted).
- The GLB is Y-up as glTF expects: **X = east, Y = height, Z = south** (= the plans' y). This keeps the model right-handed (not mirrored): the plans' north is −Z.
- **True north** (`base.typ`, `#let north`) is 21.4° east of the plans' north; the sun positions use it (the north arrow in the viewer shows it).

## Parameters (params.yaml)
| Parameter | Value | Note |
|---|---|---|
| finished levels | ±0.00 / +3.60 / roof slab top +7.20 | to confirm with the engineer |
| floor finish / roof finish | 0.08 / 0.10 | assumed |
| slab thickness | 0.20 default | the first-floor and roof bays from `studies/structure.typ` (0.30 / 0.22), V6.3 |
| outer / inner walls | 0.25 / 0.20 | on the centre lines |
| doors | 2.10 high | all doors; the living's entrance arch +2.60 (`openings.doors`); the lift's sliding landing doors are cut (V6.3) |
| windows | sill 0.90 / head 2.10 | default; the courtyard glazing 0.00–2.90, kitchen 1.10–2.10, bath and maid windows 1.50–2.10, majlis high windows 1.80–2.90, clerestory +5.00–6.00 … listed in params |
| railing / handrail | 1.10 / 0.90 | above the finished floor / above the nosings |
| headroom | ≥ 2.10 | over every tread, to the underside of the beams / slab |
| stair waist | 0.15 | flight slabs |
| projection width | 1.55 | checked against proj-x in `studies/ff_family.typ` (V7.0: x 5.80) |
| roof_design | cornice 0.45 × 0.30 at +6.90; band 0.12 at +3.40; north coping +7.65; south parapet +8.00 (V8.1: 0.70 above the finish); attic 1.40 above the finish set back 1.0 (coping +8.70); the HRV base (top +9.10); the ladder (`ladder`) and the set-back guardrail (`guardrail_setback`); no stair room | V7.0 / V8.1, `studies/roof.typ`, all assumed |
| sun | 21.4° N, 21 Jun / 21 Dec, 9 · 12 · 15 h | solar time |

## What is read from where
- `data/rooms_gf.csv`, `data/rooms_ff.csv`: every room, rectangles or `pts` polygons (`#` switches a row off).
- `design_gf.typ`: the outline (`outline-csv-gf`) and the air tower polygon (`tower-pts`).
- `studies/ff_family.typ`: the projection edge (`proj-x`) and the first-floor fixed elements (`fixed`: stair, lift shaft, west shaft, air tower).
- `presentation.typ`: the ground-floor doors (`gf-doors`, with their kind: hinged / sliding / double / open) and windows (`gf-windows`).
- `studies/ff_family.typ`, `studies/ff_suite.typ`: the first-floor doors (`doors`, `D(...)`) and windows (`windows`).
- `studies/structure.typ`: the stair (`st`), the columns (`columns`) and the beams (`beams-ff`, `beams-roof`) used in this phase.
- `studies/sections.typ`: the clerestory levels (`cl-sill`, `cl-head`) and the latitude; `base.typ`: true north; `studies/east_wing.typ`: the kitchen fixtures (service door check).
- `studies/air_system.typ`: every `#let air-*` tuple (tower, head, base, route, duct, clear, invert, chamber, cover, grille).
- `3d/character.yaml`: the character study (the mashrabiya windows are matched to the windows of the plans by their coordinates; the feature walls' openings are cut from the built openings).
- Doors of the plans that lie on an open edge (no leaf) cut nothing; the open edges are in `open_edges.csv`.

## Checks (check_3d.py)
1. Every room of both floors is enclosed: each piece of every room edge is on the outline, on a built wall or on a listed open edge.
2. Walls: no overlaps, every wall 0.20 m (measured in the GLB), from the structural slab top to the slab underside (or 1.20 m); the outer ring 0.25 m; **no gaps**: every wall end meets another wall, the outer wall or an open edge; **no interior wall on the outline** (the duplicate walls along the cut, corrected in `3d-char1`).
3. Slab areas measured in the GLB: GF = outline + half the outer wall (318.77 m²); FF = the same minus the courtyard sky, the double-height void and the stair opening (267.85 m²); roof minus the courtyard sky and the suite court (285.02 m²); inside the outline the floors equal the CSV rooms (309.68 m²); the voids 21.77 + 20.94 m², the stair opening 8.21 m².
4. The plan extent is the outline plus half the outer wall (13.561 × 24.25 m); the levels are those of `params.yaml` (finished and structural); every slab bay has its study thickness at the structural top (V6.3). The character meshes are excluded here and checked in 10.
5. Doors and windows: every door and window of the plans is built (28 + 31), or lies on an open edge, or is listed as skipped; every opening sits in a wall with its head below the slab; the clerestory windows at the levels of `studies/sections.typ`; the kitchen service door clear of the counters (the cooking counter starts 0.10 m south of it) and of the columns (C32 +0.40 m); the X3 window / column C33 clearance is reported as a flag (−0.05 m with the assumed 0.25 × 0.60 column along the wall: a clash that the engineer resolves by the column's size, not hidden).
6. The stair: 22 risers to +3.60, the top riser on the first-floor slab (the arrival strip), the opening edged by the trimmers, the headroom over every tread ≥ 2.10 m (minimum 2.14 m under B16; the study's 2.22 m before finishes). **V8.0:** the internal stair stops at the first floor (no flights above +3.60, the roof slab closed over the well). **V8.1:** the roof ladder (the pilaster from the court floor to the roof finish, the wall not cut, 13 rungs at 0.25–0.30, the top rung at the roof finish, toe clearance ≥ 0.18, the stiles 1.10 above the roof, the gate in the court guard), the set-back guardrail (1.10 high, 1.0 m from the faces), the outdoor kitchen (the grill ≥ 3 m from the house).
7. The structure of the zone: the colonnade from the ground slab to the roof underside (X8), the upturned edge beam and the railing on it, B5's soffit, the gym walls flagged unconfirmed (V8.0: R6 removed, R8 across the court's south side).
8. The sun: the noon altitudes equal the formulas of `studies/sections.typ` (winter 45.2°, summer 88.0°), 9:00 / 15:00 symmetric.
9. The air system: the duct (route E) runs only under the maid bath, the laundry and the kitchen (between their wall faces); the chamber under the kitchen floor against the kitchen's west wall; 0.10 m clear of the assumed pads of C25, C26, C31 (C24 / C30 stand on the tower base pit); the duct top under the assumed tie beams (−0.90); the head 2.5 m above the roof; the shaft open through both slabs; the outlet a grille on the courtyard face of the kitchen's west wall with the plenum in its base, ≥ 0.3 m north of the kitchen sink window, no floor opening and no water.
10. The character study: every `chr_*` mesh named `chr_<group>_<material>_<label>` with a palette material and listed in the summary; the viewer replaces only the 21 outer windows' centre-line glass and the B3 railing (they exist); every recessed pane 0.20 m behind the outer face (measured in the GLB); every mashrabiya on a window of the plans, inside its opening, flush with its face; the stone sleeves Ø0.40 (base band Ø0.50) from the finished ground floor to the roof underside; the parapet and the glass railing on B3 from the beam top to +4.70, the parapet as wide as the beam; the pergola inside the courtyard sky's y range, on the roof finish, ≤ 15 % of the sky; the roof parapet from the roof finish with its coping; every character mesh within the outer face + 0.04 (plinth, cladding, coping); the sunken seating: it replaces the base courtyard floor meshes (their area = the courtyard between its wall faces), the pit floor at −0.45 and the treads at −0.15 / −0.30 measured in the GLB, the level edges ≥ 1.0 m and no floor-level courtyard opening nearer than 1.0 m to the pit, the grille over the bench and ≥ 0.15 above the seat and the sunken floor with its upstand, the drain at the lowest point and the overflow above it; the fountain between the grille and the sink window; the TV wall (V6.3): the living's west wall solid to the slab underside, the entrance arch 1.40 m with its +2.60 head, the niche frame and pier, eye-to-screen ≈ 3.45 m, a ≥ 1.0 m path at the sofa's north end.
11. The roofline and the enclosure (V7.0 / V7.1); V8.0: the HRV base under the head, the suite court's south base and frame. Section 10 also checks the courtyard layout (the step, the benches, the TV surround, the enclosure, the drains).
It ends with `3D CHECKS PASSED` and the list of **flags**, or the problems. `ALL CHECKS PASSED` (tools/check.py) means the model is consistent with the files; it does not mean anything was calculated, and the character study is not a decision.

## Phases
| Phase | Content | State |
|---|---|---|
| 1 | setup, params, slabs, outer walls, voids, viewer | done (tag `3d-p2`) |
| 2 | interior walls, open edges, checks | done (tag `3d-p2`) |
| 3 | doors and windows, the stair with its opening and trimmers, the colonnade – gallery – living zone (columns, edge beam, B5, R6, R11), railings, finished / structural levels, plan views, eye-level bookmarks, sun and shadows | done (tag `3d-p3`) |
| character | the style study: materials, plinth, deep reveals, mashrabiya, stone colonnade, timber soffit, parapet / glass railing, pergola, roof parapet, fountain, props, the arches variant, more views, night | done, provisional (tag `3d-char1`) |
| character r2 | lighter, warmer colours; the sun and shadows in the views; the malqaf outlet on the kitchen wall (owner decision, air study v2.1); the sunken seating variant with its bench under the grille, drain and overflow | done, provisional (tag `3d-char2`) |
| V6.3 | the slab bays from the structural study; the TV wall (solid, entrance arch, niche) and the arches variant removed; the lift's landing doors; X3 window 0.55 |
| V7.0 | the enclosure W1–W3, the 1.55 m projection, the stair to the roof and the stair room, the roofline (cornice, band, copings, parapet, attic), the guards, the quoins and divided lites, the design-language palette; check sections 6 (upper stair) and 11 (roofline and enclosure) | done (tag `v7.0`) |
| V7.1 | the courtyard arcade (`arcade`) and the arched enclosure windows (`arched_windows`); the W3 view; marble inside | done (tag `v7.1`) | done (tag `v6.3`) |
| V8.0 | the internal stair to the first floor only, the HRV base and the three-face head, the courtyard layout (no pergola / fountain / pit), the south wing v2 with the suite court's frame and guards | done (tag `v8.0`) |
| V8.1 | the roof ladder (pilaster, recess, panel, stiles, gate), the lowered attic and parapet, the set-back guardrail, the outdoor kitchen, the office's east window; the V8.0 stair tower removed; three renders | done (tag `v8.1`) |
| V8.2 | the flipped stair (direction-aware builder and checks), the family bath F-b, the coat cupboard, the suite court's mashrabiya screen, the site elements (group `site`); three renders | done (tag `v8.2`) |
| V8.3 | the level courtyard layout (movable furniture, the enclosure on the kitchen wall, the TV moved, the drains), the outdoor kitchen by the service door and the re-planned yard, bedroom 2's en-suite and the family WC, the powder room; two renders | done (tag `v8.3`) |
| V9.0 | the final site position, the cut wall 0.12 m further out, the existing farm round the house (the old house, its annex, the covered parking, the tank, the septic, the walls and the gate posts, the two palms; kinds `block`, `canopy`, `palm`), the gate view; four renders | done (tag `v9.0`) | |
| V9.1 | the final site position (B1 6.00 m from M1), the cut wall a further 0.24 m out, the parking bay on the turning line; one render | done (tag `v9.1`) |
| V9.2 | small fixes: the rectangular air tower, the wedge to the rooms, the HRV base at V9.0, the attic +8.68; no new renders | done (tag `v9.2`) |
| V9.3 | the new malqaf tower (the slim shaft, the tower on the attic's corner, the plant room); renders: the gate, the north-east aerial | done (tag `v9.3`) |
| V10.0 | the malqaf at L5 (the core, the foot chamber's parts, the head as a frame with dark slots, the blind arch, the no-stone palette, the court bookmark; the L1 tower and the plant room removed); renders: the courtyard, the gate, the south-west aerial | done (tag `v10.0`) |
| 4 | the whole structure from the structural study (all columns and beams, ribbed slabs, the 0.22 roof over the void), marked assumed until the engineer approves | to do |
| 5 | lift, air tower head, parapets and the roof railing, the remaining railings (as design elements: the character study shows provisional ones) | to do |
| 6 | IFC / OBJ export | to do |
