ahl20006/House_git/taif_house/docs/AIR_SYSTEM.md

# Taif / Palm House · V10.0 · air system v4 · the malqaf at L5 (one tower at the courtyard's north-west corner, two separate air paths; the owner's decisions D1–D11 of 9 Nov 2026)

**V10.0 (9 Nov 2026, owner; `studies/malqaf_L5.typ` adopted, variant V-c + head F3; the fall-back F2 if the structural engineer refuses the beam additions).** The malqaf moves from the north-east cut corner (V8.0 – V9.3, superseded) to the **courtyard's north-west corner**: an *independent RC core* (walls 0.20) from its own pad to the head, inside the covered strip under the first-floor projection, against the women's majlis's wall (rebuilt in RC); nothing taken from the majlis or the family living; *no bedroom touches it* (D10). The drawings are `output/air_system.pdf` (from `studies/air_system.typ` v4: the foot chamber in plan, the section through the core, the head, the dampers, the separations, the breeze estimate, the ventilation airflow, the controls and the maintenance table) and the six-phase study `output/malqaf_L5.pdf`. **Every size and performance figure here is assumed, to be designed by the MEP engineer** (open item 9); the structure by the structural engineer (open item 22).

**v3 / v3.1 (V8.0 – V9.3) are superseded:** the tower in the cut tip, the HRV in a base or a plant room on the roof, the 10.6 m breeze channel in the ground slab under the maid bath, the laundry and the kitchen, and the grille under the outdoor TV are gone. **v1 and v2 are withdrawn** (tags `air-p1`, `air-p2`). The courtyard water is a separate system (`studies/courtyard_layout.typ`).

## The owner's goals and decisions
One tower, the symbol of the house (seen from the courtyard where the family lives, not from the gate: accepted), with two completely separate air paths: **(a) a large natural breeze for the courtyard seating** in pleasant weather (the goal, D1: ≈ 4 × the L1 system's flow), unfiltered by design (a bird mesh only); **(b) the fresh air of the house**, filtered, all year, *without an HRV* (D2): a filtered supply fan keeping the house at a slight positive pressure. No water in the air system (D9: a mobile evaporative cooler is an *option*: its space, a power point and a drain only; the water point capped); no human entry anywhere; all maintenance from a door at ground level. **Simple controls (owner, 9 Nov 2026):** two wall switches and one dust-sensor relay; every damper spring-return; no controller, no modes. **No stone:** render and paint; the honey tone on the band, the crown and the slot surrounds.

## A · The core
- **The foot chamber (GF):** outer 1.6 × 2.37 m (x 4.30–5.90, y 6.4–8.767), **1.2 × 1.97 m clear (2.36 m²)**, ≈ 3.1 m high, open above into the shaft. Inside: the *dust trap* under the shaft (a 0.8 × 0.7 GRP basin 0.30 m deep within the slab depth, a lift-out stainless grating, a trapped gully with a trap primer to the west run); the *filter cabinet + EC fan + silencer* on the west wall; the *cooler's space* 0.8 × 0.7 at the outlet (an option); a floor fall to the gully, the walls tanked to +0.30, IP44 sockets on their own RCD circuit, a lockable isolator, a capped water point. **The door:** a carved timber door **1.0 × 2.4** with a semicircular head on the south face onto the covered strip: the cooler rolls in, every cleaning task passes here.
- **The breeze outlet:** **1.4 × 1.0** (+0.10 … +1.10) in the core's east face, in the *first arch of the courtyard arcade*, adjustable timber louvres aiming the jet along the seating, the damper **D2** behind; ≈ 1 m from the seating zone's west edge; no channel.
- **The shaft (FF and above):** outer 1.6 × 1.2 m, **1.2 × 0.8 m clear (0.96 m²)**: the breeze part 0.84 m² beside the sealed Ø250 riser of path (b); smooth-rendered, self-cleaning (the dust falls to the trap); the gallery's turn past bedroom 2's bath stays 1.5 m clear. On its south face a carved arched timber grille 0.8 × 1.6 (sill +4.20): **a sealed provision** (owner), no damper now. **D1** at the shaft's head (+7.75, 1.2 × 0.8).
- **Structure (for the engineer; `studies/structure.typ` § 7, X18, X19):** the core absorbs C17, C21 and the first arcade column (now structural) and becomes *the fourth support of the west projection*: B3 / B4 first spans 6.50 → 4.33 m; its own pad ≈ 2.4 × 3.0 × 0.6 (≈ 595 kN service, ≈ 100 kPa on an assumed 150); the FF and roof slabs tied into it; the slabs' openings framed by its walls; the old north-east openings (B15 / R9) closed.

## B · The head (F3)
- Outer **1.6 × 2.4 m** on the shaft and the gallery roof (the overhang south over the gallery roof: its walls on R3 widened to 0.40 over y 6.5–8.8, on R11 and on the new beam **R-L5** (1.55 m, 0.25 × 0.45) under the south wall); an RC frame (0.30 corner piers, ring beams at the band +10.6 and the crown +12.9), the slender ribs in rendered block; a light sand render, the band, the two-step Hijazi crown (+12.9 … +13.2) and the slot surrounds in the honey tone; every projection with a drip. **Crown +13.20** (4.5 m above the attic coping); hidden from the gate and the north boundary by the north facade, 1.9 m above the roofline from the street at 14 m, seen whole from the courtyard seating.
- **Openings +11.2 … +12.6** on all four faces: 3 slender arched slots on the short faces, 5 on the long (W / E), each 0.20 m wide on the 20 cm module (free ≈ 0.83 / 1.38 m² per face); they start above the roof's recirculation bubble (≈ +11.4). The W and N faces are the catchers (Taif's warm-season evening wind W ≈ 50 %, NW ≈ 30 %, ≈ 21 km/h; the climate basis in `studies/malqaf_L5.typ` Phase 0, from the public station records; the on-site weather station confirms the faces before the head is detailed).
- Inside: a wide **20 mm bird mesh only** (no insect mesh on the breeze path) in frames lowered on cords to a 0.50 m **hatch in the west face** (+7.6 … +8.1, by the x 3.5 roof walkway), the thin **+ divider** and four lightweight **back-draught flaps** (the windward quarter feeds, the leeward shut); no louvres, no motor, no sensor in the head.
- **Wind and earthquake:** self-weight ≈ 160 kN; wind ≈ 14 kN / ≈ 40 kN·m; *earthquake as a rooftop appendage governs* (ASCE 7 § 13.3, Sds 0.15–0.35 assumed: 29–68 kN, 86–201 kN·m): the structural engineer (open item 22).

## C · Path (a): the courtyard breeze
- **Route:** the head's windward face → the flaps → D1 → the shaft (0.84 m²) → the dust trap at its foot → the chamber → the louvres and D2 → the seating. No channel, one turn.
- **The breeze, honestly** (`studies/air_system.typ` § 4, assumed loss coefficients referred to a 0.10 m² section: the L5 chain ≈ 0.12 against V9.3's 1.50): at the summer-evening mean wind (21 km/h at the mast) ≈ **1.8 m³/s**, ≈ 2.1 m/s at the louvres and ≈ 0.5–0.8 m/s at the seating 2 m away: *a clearly felt breeze*, ≈ 3.6–4.3 × the L1 system; a gentle 10 km/h wind ≈ 0.85 m³/s; a calm evening little (the stack ≈ 0.3 m³/s). About 1 800 pleasant, dust-free seating hours a year (Phase 0). The family closes the switch when it is too much.
- **The cooler (D9, option):** a 90–150 L portable evaporative cooler in the chamber moves ≈ 0.8–1.4 m³/s and cools the dry afternoon air from ≈ 35 to ≈ 20–22 °C (RH 12–20 %, ≈ 15–25 L/h of water); it cools *the people in the jet*. Provided now: the space, a power point, the floor drain; the water point capped; the malqaf is a *dry system*.

## D · Path (b): the house's fresh air (no HRV)
- **The inlet:** a downward-facing hood under the head's south overhang (+7.6), a bird mesh, **never closes** → a Ø315 duct down the chamber's south-east corner → a washable **ISO Coarse 60 % (G4) pre-filter** + an **ISO ePM1 ≥ 50 % (F7 class) fine filter** → a quiet **EC fan 750 m³/h at 250 Pa** (≈ 160 W) on anti-vibration mounts → a **0.9 m lined silencer** (≈ −15 dB; ≈ 38 dB(A) in the chamber, nothing heard in the courtyard through the 200 RC wall) → a sealed Ø250 riser in the shaft's west side → high grilles (+6.4) into the **family living** (the core's north face) and the **gallery** (south face), and at the GF (+2.7) into the **riwaq** (west face) and the **women's majlis** (north wall); the other rooms through the open plan and 15 mm door undercuts or transfer grilles. *No bedroom is ducted from the core.*
- **Airflow** (ASHRAE 62.2-2022 § 4.1.1: 0.15 L/s·m² + 3.5 L/s per bedroom + 1; ≈ 470 m² clear, 5 bedrooms): ≈ **330 m³/h normal**; the men's majlis full (24 guests, ASHRAE 62.1 assembly): ≈ **705 m³/h boost**; the fan covers it with the filters loaded. To be confirmed against SBC 501 / 1101.
- **Positive pressure:** the supply exceeds the continuous extracts (the bathrooms ≈ 150–250 m³/h, the dryer): ≈ +5–10 Pa; the house tight (D5); during a 150 µg/m³ dust event the house stays at roughly a quarter of the outdoor level. **The kitchen hood** (600–1 000 m³/h) exceeds the fan: **its interlocked, filtered, motorised make-up inlet (≈ 300 m³/h, opens with the hood) is mandatory** (owner) — without it the house would go negative and pull dust through every crack.
- **Winter:** the breeze closed, the fan at normal: ≈ 1.1 kW of heat at a 10 K difference (no heat recovery): small; boost when the house is full.
- **Filters:** a mechanical gauge on the cabinet; the fine filter changed at 200 Pa (≈ 6 months), the pre-filter washed monthly.

## E · Dampers and controls (simple)
- **D1** (the shaft's head) and **D2** (behind the outlet): insulated blades, low-leakage, **spring-return (closed on power loss)**, driven together. **No D3** (the gallery grille is a sealed provision). **D4:** a passive gravity louvre Ø160 from the chamber to the outlet, so the chamber never stays damp. The hood's make-up damper: its own, interlocked with the hood.
- **Switch 1 · MALQAF open / closed:** D1 + D2 open for the courtyard breeze whenever the family finds the evening pleasant; closed in winter, dust and when away. **Switch 2 · HOUSE FAN normal / boost:** the filtered path never stops; boost for guests, a full house, after a dust day (two speeds set once at commissioning).
- **The dust relay:** an outdoor PM2.5 sensor in a weather hood on the head's north face: above **50 µg/m³ for 10 min** D1 and D2 close by themselves and the switch's lamp shows "dust"; they reopen when the air has been below 25 µg/m³ for 30 min and the switch is on. A manual override on each actuator for the technician. *No controller, no modes.*

## F · Intake and exhausts (ASHRAE 62.1-2022 Table 5-1 allowances; `studies/air_system.typ` § 3.3)
The head and the filtered inlet ↔ the kitchen hood outlet 12.6 / 10.5 m (≥ 4.6), the east stack's vent 8.7 / 8.6 m (≥ 3), **the west stack's vent re-routed in the attic to the south-east strip** (owner, 9 Nov 2026: no exhaust stands upwind of the head in the summer-evening west wind) 10.1 m (≥ 3), the AC condensers in Z2b 3.7 m east and 2.6 m below the openings (≥ 2; their plume rises leeward in a W wind), the LPG cabinet / the generator point ≈ 12 m (≥ 4.6 / 9). The grill and tannour ≈ 12 m downwind.

## G · Maintenance (all from the carved door at ground level; no routine task enters a shaft or climbs a ladder)
| Component | Task | Interval |
|---|---|---|
| the dust trap | lift the grating, sweep / vacuum, hose to the gully | monthly; weekly in Mar–Apr |
| the pre-filter | slide out, wash, dry | monthly (the gauge) |
| the fine filter | replace | ≈ 6 months (200 Pa) |
| the gully trap | fill / flush (the trap primer) | monthly |
| the outlet louvres, the room grilles | brush, vacuum | 3 months |
| D1, D2, the dust relay | stroke test, seals; the sensor's lens | yearly (before spring) |
| the fan and the silencer | listen, check the mounts | yearly |
| the head's mesh and flaps | *the roof hatch only:* lower the frames on their cords, brush, raise; free the flaps | yearly; after a dust storm |
| the cooler (if bought) | tank and pads cleaned; drained and parked for winter | weekly in summer; October |

## Open
Owner (decided 9 Nov 2026): L5 adopted (V-c + F3, fall-back F2); no HRV; the gallery grille a sealed provision; the cooler an option; render and paint; two switches and a dust relay; the west vent re-routed; the hood's make-up inlet mandatory; the on-site weather station before the head is detailed. **MEP engineer (open item 9):** everything sized above (the fan, the filters, the silencer, D1 / D2 and the relay, the louvres and grilles, the make-up inlet, the vent re-route, the chamber's gully and electrics); the breeze estimate confirmed (a CFD or wind-tunnel check if wanted). **Structural engineer (open item 22):** the core and its pad, B3 / B4, R3 widened, R-L5, the head frame for earthquake. Sources: `studies/malqaf_L5.typ` Phases 0–6, `studies/air_system.typ` v4, `studies/roof.typ`, `studies/structure.typ`, `studies/plumbing.typ`.
