ahl20006/House_git/taif_house/docs/DETAILS.md

# Taif / Palm House · V9.0 · construction and detail notes

*V9.0 (layout freeze):* the cut wall 0.12 m further out (its columns, W4 and the tower move with it, `STRUCTURE_STUDY.md`); the set-out on site (`SITE_SETOUT.md`: the outer wall faces from M1 / D, the tolerances ± 0.10 m on a corner); no change to the building rules below. The details stage (the facades, the bathrooms' interiors, the acoustics) is next.

*V8.3:* **the courtyard level** (no step: the floor falls 1 % from the three glass lines and the riwaq door, −0.015 at the glass, to a slot drain along the kitchen wall foot at −0.06 and a slot drain at the riwaq door's threshold, an overflow gully at −0.03 on its own pipe, all to the east rain chamber; automatic trap primers; the enclosure's two basins tanked separately: the planter 0.70 deep, the raised trough rim +0.95); **the first-floor service wall on y 9.2** (a 0.20 steel-frame wall from the shaft to x 4.25 carrying the family WC's and bedroom 2's wall-hung WCs, the basin and the shower channel's trap; every outlet in the wall into the shaft); **the ground-floor powder room** (the 0.25 service wall on y 16.1 with the WC frame and bedroom 3's stack, an access panel from the serving passage; B14 a drop beam or a 3.2 m span, X21); **the outdoor kitchen** by the service door (the counter under the kitchen window, a canopy optional) and the grill platform ≥ 3 m from every opening; the facade principle R-37 for the facade stage.

*V8.2:* **the flipped stair** (the lower flight on the east half rising south off the lobby, the first riser 1.45 m in front of the entrance strip; the 0.90 m black-bar balustrade on the riwaq edge y 2.3–6.55; the store under the half landing with a low walnut door, head 1.55; the obscured half-landing window x 0, y 6.7–7.6, sill +2.60, head +3.30 in a deep shaded reveal; the glazed obscured side light at the family entrance x 2.4–2.9, sill +0.30, head +2.10; the coat cupboard 1.26 × 1.45 full height in the start strip's west half); **the family bath F-b** (the WC compartment's stack in the west shaft's wall; the wall on y 7.9 on B12; its slab on the solid west band: a thickened bay or suspended drains over the utility room and the hospitality kitchen behind panels, plumbing study principle 4); **the night lights** on bedroom 1's route (low-level, motion-sensor, for the electrical design); **the gas cabinet** (ventilated, 1.0 × 0.5, on the service-yard screen's outer face, the pipe through the screen base to the hob ≈ 3 m, the detector and the automatic valve inside); **the plumbing proposals** (`studies/plumbing.typ`: the suite bath's east service wall and the tub's plinth, the east stack's removable cladding panel 0.6 × 2.4 with a rodding eye at the yard level and at +3.3, the tanked depressed slab as the second line, leak sensors and the automatic main shut-off) are proposals until the owner decides.

*V7.0 / V8.0:* the courtyard enclosure windows W1–W3, the main cornice, the band, the attic and the parapets (`studies/courtyard_enclosure.typ`, `studies/roof.typ`); V8.1: the maintenance ladder (`studies/roof.typ` page 2); V8.0: the air system's channel and the HRV base (`studies/air_system.typ`), the courtyard layout (`studies/courtyard_layout.typ`) and the fire safety equipment (`studies/fire_escape.typ`); `PROJECT_V10.md` §4.25–4.36. Their details join this file at the detail round.

House-wide building rules and details, for the engineer, the carpenter and the contractor. The layout decisions and their reasons are in `PROJECT_V10.md`, and the open items in `OPEN_ITEMS.md`. *Concept notes, to be confirmed by the engineers.*

## Structure

### West projection (1.35 m) on an edge beam and three columns
- **What:** a first-floor slab beyond the courtyard wall line x 4.25, along y 6.5–19.25, carrying the gallery and its railing.
- **Edge beam on x 5.6:** spans ≈ 6.5 m and 6.25 m. It is seen from the courtyard and the living, so express it as the colonnade's beam.
- **Three columns**, each in an existing wall or glass line, none free-standing in a room:
  - the women's majlis south wall (y 6.5);
  - a pier in the courtyard / living glass (y 13.0);
  - the living's south wall (y 19.25).

  Each column needs its own foundation.
- **The structural engineer sizes** the slab, the beam depth, the columns and the pads.
- **Ground floor:** it changes only by the columns, their foundations, the beam line and a lower ceiling under the projection.
- **Walls on walls:** the rooms' east wall (x 4.25) stands on the ground-floor courtyard edge line, and the first-floor outer walls on the ground-floor outer walls.

### The south wing v2 over the men's majlis and the guest block (V8.0)
- **The gym** (x 0–4.25) sits inside the column frame C6 / C13 / C19 (y 19.25) – C7 / C14 / C20 (y 24): its floor the west wash block's 0.20 solid slab (2.75 m between the west outer wall and B10) plus a 1.5 m strip of the majlis roof; its east wall on **B19 between C19 and C20**; the double wall to bedroom 3 on B8 (x 2.75–4.25) and a new drop beam **B22** (C6 – C13, over the guest passage); the treadmill on the 2.75 m solid bay next to the outer wall.
- **The office** (x 10–13.311): its roof ribbed N–S onto R5 / R8 with an edge rib R19 on the court, so its west wall x 10.0 is non-load-bearing (own weight on rib B21).
- **The suite court** (x 4.25–10): a terrace on the majlis roof; its structural slab depressed 0.10–0.15 for the falls and the low thresholds; across its south side R8 carries the cornice and the parapet as a facade frame over a 1.10 m base.
- **The gym nib** (1.55 × 1.3 at the gallery end): light partitions; its roof on R3 and a 1.3 m cantilever R21 from C23.
- *History:* the L-shaped gym of V6.2 (the treadmill arm on x 11.586) and the gym roof beam R6 are gone.

### Walls on the women's majlis roof
- **The y 3.0 partition** (kids' room / family living) stands over the women's majlis, which has no wall below. Use a light partition on the slab, or a beam.

## Acoustics

### The gym and bedroom 3 (mandatory, V8.0)
- **The problem** is mostly structure-borne (footfall, the treadmill's motor); airborne noise second.
- **Wall** between the gym and bedroom 3 (y 19.25, x 0–4.25): a **double wall**, e.g. 200 mm dense block plus an independent stud lining with 50 mm mineral wool and two layers of 12.5 mm acoustic plasterboard; target **Rw ≈ 55 dB** (≈ 50 dB on site); sealed at the top; no sockets back to back, no duct through it; nothing fixed to it (the power rack is freestanding).
- **Floor:** a floating floor (resilient layer + screed, perimeter strip) or at least 20–40 mm dense rubber under the treadmill and the weights.
- **Treadmill:** anti-vibration pads; 0.5 m off the walls (the manufacturer-type zone: 2.0 m behind, 0.5 m each side); a cushioned deck and a quiet motor.
- **The office** is the suite bedroom's neighbour (quiet): a single 200 mm wall; the master bedroom has no door to it.

## Drainage and services
- **No east duct:** the kitchen extract leaves straight through the east wall; the vent stack and the suite bath drain run in one stack on the outside face of the east wall, down to the east-yard manhole. The kitchen service door (owner decision) sits at the north end of the east wall (y 6.7–7.6); the stack goes between the door and the kitchen window (y ≈ 7.8–8.3) and the hood south of y ≈ 8.4. MEP engineer to confirm.
- **Sunken bath floors:** the suite bath (over the ground-floor kitchen) and the family bath (partly over the hospitality kitchen) carry all their pipes in the floor build-up; nothing hangs in a kitchen ceiling; no drain over the master bedroom.
- **Stacked wet rooms:** the bedroom 3 bath stands exactly over the ground-floor family WC; the family bath WC is on the west shaft wall.
- **Suite court (V8.0, near-flush doors):** waterproofing on the men's majlis roof slab in a depressed zone; the floor falls **south** at 1.5 % away from the three doors to a box gutter along the south side (two outlets, internal downpipes in the south wall) with an **overflow spout** through the south wall below the threshold level; **linear slot drains** in front of each door; the membrane turned up ≥ 150 mm behind the slot drains and under the door sills (a low-threshold detail: threshold ≤ 20 mm, the grating flush). The engineer details it.
- **Courtyard (revised V8.3):** the whole floor level, falling 1 % from the glass lines (−0.015) to the slot drain along the kitchen wall foot (−0.06) and a slot drain at the riwaq door; an independent overflow gully (rim −0.03) at the south-east corner; the pipes 1 % east under the kitchen floor to the east RAIN chamber (never the foul chamber); the raised water trough and the planter each with its own drain; trap primers. The V8.0 step and benches are withdrawn.
- **Gas, if used:** a cylinder cabinet outside the east wall in the service yard, reached through the kitchen service door.

## The TV wall (V6.3)
- The living's west wall on x 4.25 (y 13.0–19.25) is a full-height 200 mm wall to the projection's slab underside; beam B4 above it bears on it from y 14.5 (the engineer may treat B4 as a hidden beam there).
- **Entrance arch** 1.40 m wide at the north end (y 13.1–14.5), head +2.60 (semicircular, springing +1.90); no leaf.
- **TV niche** between a 0.25 m pier (y 14.5–14.75) and the south wall: 4.40 m wide, 0.70 m deep into the living (the frame projects, the wall stays 200 mm), a segmental arch with its crown at +3.10 under the soffit (+3.27); inside: a long low cabinet 3.8 × 0.5 × 0.45 (y 15.05–18.85), the 85″ TV (1.9 × 1.08) centred at y 16.95 with its bottom at +0.70, shelves 0.4 deep at both ends, hidden LED in the arch and behind the TV; conduits for the sound system to the side shelves and the ceiling.
- Sofa 3.8 m facing west with its back at x 8.45 (eye ≈ x 7.90): eye-to-screen 3.47 m; the dining table behind it from x 10.4; a 1.9 m path at the sofa's north end from the entrance arch to the dining and the kitchen.

## Doors (V6.3)
- Every bedroom and bathroom door on both floors: a **1.00 m structural opening, 0.90 m leaf** (frame 50 mm each side, stop and leaf thickness ≈ 50 mm → ≈ 0.85 m clear), lever handles, 100 mm bottom rail for later kick plates.
- Hinge sides: family bath hinged at its north jamb (y 9.3) so the leaf clears the basin; bedroom 3's door at y 15.2–16.2 (south of the entry wardrobe); bedroom 3's bath door sliding (y 15.0–16.0); the suite WC closet door **sliding** (V8.0: a hinged leaf opening into the bath clashed with the bath door).
- **South wing (V8.0 / V8.1):** the gym's door from the gallery end sliding; the three suite court doors on the court's north strip: the bedroom's sliding glass, the gym's hinged into the court, the office's hinged into the office (the office's only door, V8.1); simple doors with privacy locks at most. **The roof ladder (V8.1):** the walnut-finish panel (exterior grade, marine ply or aluminium composite) on the south jamb, opening 180° onto the pilaster face, a floor drop-bolt to hold it open, a key cylinder; flush and without a hold when closed; the ladder a manufactured product with its fall-arrest rail; the self-closing gate at the top in the court's west guard.
- Not reached: the guest WC (0.90 m opening, ≈ 0.75 clear: the room is 1.3 m clear wide) and the maid bath (0.70 m: column C31 and the cut wall; to revisit with the maid wing).
- The lift: sliding landing doors (≥ 0.80 m clear) from the lobby and the gallery at y 0.9–1.9.

## Joinery and doors
- **Built-in cupboards in niches** (linen cupboard, bedroom 2 wardrobe niche):
  - **preferred:** a joinery box with its own 18 mm sides, top and frame, scribed to the walls;
  - **10 cm block jamb:** only where a side is open or a heavy sliding door needs a solid fixing, and then draw the niche 20 cm wider.
- **10 cm partitions** (an idea for later): they give a room +10 cm of clear width. Check any beam on the line, and the sound (plaster both sides, or an insulated drywall).
- **Sliding doors** to the gym (from the gallery), the suite WC closet, the suite court (from the bedroom) and the dressing wardrobes.
