ahl20006/House_git/taif_house/docs/NEXT_SESSION.md

# Next session · start here

Taif / Palm House · **V10.0, the malqaf (L5)** (git tag `v10.0`, GitHub Release "V10.0", 9 Nov 2026; V9.3 the L1 tower, superseded; V9.1 the final site position; the layout frozen since V9.0 with one approved exception at V10.0; the branch `work` is reset to `main` for the next round)

## Where we are
- **The layout is frozen** (`PROJECT_V10.md` §5, since V9.0; **one approved exception at V10.0: the malqaf at L5**, which changed the courtyard's covered strip, the riwaq's first panel and the gallery's north end): the room positions and sizes, the stairs, the wet-room positions and the site position. What may still change: the suite bathroom's drainage approach, the water system, the bathroom interiors, the facades and details (render and paint, porcelain: no stone), the engineers' results, the official survey, the levels.
- **V10.0 · the malqaf at L5** (`studies/malqaf_L5.typ`, six phases, adopted; `PROJECT_V10.md` §4.63): an independent RC core at the courtyard's north-west corner inside the covered strip: the GF foot chamber (1.2 × 1.97 clear: the dust trap, the filters + EC fan 750 m³/h + silencer, the space for a mobile cooler as an option, a carved door 1.0 × 2.4 onto the strip), the breeze outlet 1.4 × 1.0 with timber louvres in the first arcade arch facing the seating (≈ 1.8 m³/s at the summer-evening mean wind, ≈ 4 × L1), the FF shaft 1.2 × 0.8 clear at the gallery's end (the gallery grille a sealed provision), the head 1.6 × 2.4 on the roof (openings +11.2 … +12.6, crown +13.20; an RC frame, rendered block ribs, 3 / 5 slender arched slots per face, the Hijazi cornice; hidden from the gate, seen from the courtyard). The core absorbs C17, C21 and the first arcade column and is the fourth support of the west projection (B3 / B4 4.33 + 6.25; R3 widened to 0.40; the new beam R-L5; the fall-back F2 if the engineer refuses). **No HRV:** a filtered supply fan; **simple controls:** two wall switches (MALQAF open / closed, HOUSE FAN normal / boost) and one dust-sensor relay, every damper spring-return; the hood's make-up inlet mandatory; the west stack's vent re-routed to the south-east. **The north-east corner restored** to its V9.1 rooms (the maid bath straight, the maid's store the whole cut tip, bedroom 1 with the tip, no cupboard); W1-1 a blind arch; the riwaq's first panel the core's solid face with a bench.
- **No stone anywhere (owner, 9 Nov 2026):** every exterior finish render and paint (a light sand render, the projections in a calm honey tone, the forms built into the structure); porcelain floors everywhere (marble-look inside, outdoor anti-slip R11 in a sand / honey tone outside). `DESIGN_LANGUAGE.md`; the 3D palette `honey` / `sand` / `porcelain`.
- **V9.1 · the final site position:** B1 exactly 6.00 m from M1 (the shift 0.91 / 6.0734); the cut wall 6.08 m on the outer faces, 0.42 m from the boundary wall as built, 0.91 m from the deed setback line. **On site:** the third set-out (`docs/SITE_SETOUT.md` § 7, `output/setout.pdf`).
- **Levels:** from the official survey (`SITE_SETOUT.md` § 9, open item 18). **The whole farm:** approximate, to be measured (open item 16).
- **3D** up to date (V10.0: the core, the head, the blind arch, the no-stone palette, the `court` bookmark); the V10.0 renders `3d/output/char_court.png`, `char_gate.png`, `char_aerial_sw.png`.
- **Review status V10.0:** `output/Design_Review_status_V10.0.pdf` (E-01 resolved by L5; E-02 the filtered fan, open for the MEP design).

## The next work, in this order
1. **The bathrooms and WCs interior study** (use `output/Taif_House_V10.0_presentation.pdf`): the master suite's bath and WC closet, bedroom 2's and bedroom 3's en-suites, the family WC upstairs, the ground-floor powder room, the guest WC and basins, the maid bath (back to its V9.1 shape, no channel under it): the fixtures, their clearances, the finishes (porcelain, no stone or marble), the lighting, the vanities, the ventilation (the extracts against the malqaf's positive pressure); the suite bath's drainage approach (a / b) decided with it (open items 10, 11).
2. **The water system study:** the tankers, the ground tanks, a roof tank, the pumps, the greywater lines to the south garden with diversion chambers; the malqaf's capped water point and gully (open item 10; V&V V-05).
3. **The engineers' package:** the structure (X5, the malqaf core and head: the pad, B3 / B4, R3, R-L5, earthquake; the soil report), the MEP (the air system v4: the fan, the filters, the dampers and the dust relay, the hood's make-up inlet, the vent re-route; the plumbing), the lift supplier (open items 2–7, 9–11, 14, 22); with it the official survey and the engineering office's answer on the setback (open items 1, 18) and the measurements of the existing farm (16).
4. **The full verification and validation review** of the frozen layout.
5. **The facades and the details** (open items 20, 21: the facade study in three stages, D11 bands; render and paint; acoustics R-37, items 8, 15, 17).

## What to open
| File | What it is |
|---|---|
| `output/Taif_House_V10.0_presentation.pdf` | the A3 set, 12 sheets (the plans with every room, door and fixture, the site at the final position, the roof, the sections, the elevations, the decisions) |
| `output/malqaf_L5.pdf` | the malqaf L5 study (Phases 0–6: the climate, the variants, the structure, the facade, the air system, the head, the decision sheet), adopted |
| `output/Design_Review_status_V10.0.pdf` | the review status after V10.0; the reviews: `output/Design_Review_V6.pdf`, `archive/VV_Review_V8.3.pdf` |
| `output/setout.pdf`, `docs/SITE_SETOUT.md` | the set-out sheet (re-issued 8 Nov 2026) and the field record |
| `output/air_system.pdf`, `output/roof.pdf`, `output/structure.pdf` | the air system v4, the roof (the head, the zones), the structure (the core, X18 / X19) |
| `output/site_plan.pdf`, `output/whole_farm.pdf`, `output/plumbing.pdf` | the site and services plan, the whole farm, the plumbing study (proposals) |
| `output/design_gf.pdf`, `output/design_ff.pdf`, `output/guest_wing.pdf`, `output/east_wing.pdf`, `output/ff_family.pdf`, `output/ff_suite.pdf` | the plans and the room studies |
| `output/taif_ground_floor_V10.0.dxf`, `output/taif_first_floor_V10.0.dxf`, `output/taif_roof_V10.0.dxf` | CAD, see `docs/README_DXF.md` |
| `3d/viewer.html` | the 3D (the plain model and the character study, with the site and the existing farm; the `court` bookmark) |

## Compile and check
```
python taif_house/tools/check.py      # compiles everything (the presentation and the review status included), rebuilds the three DXFs and the 3D: must end with ALL CHECKS PASSED
typst compile --root taif_house taif_house/presentation.typ taif_house/output/Taif_House_V10.0_presentation.pdf
typst compile --root taif_house taif_house/docs/review/review_status.typ taif_house/output/Design_Review_status_V10.0.pdf
python taif_house/3d/render_views.py char_court.png char_gate.png char_aerial_sw.png   # the V10.0 renders (headless Edge)
```
Tools: Typst 0.15, Python 3.10+ with ezdxf, shapely, trimesh, pyyaml, mapbox_earcut, pdftotext (on Windows from Git for Windows: `C:\Program Files\Git\ucrt64\bin`) or pypdf (`pip install pypdf`). The 3D renders need headless Edge outside a sandbox (`3d/README_3D.md`). Work on the branch `work`; record every change in `docs/PENDING_CHANGES.md`.
