ahl20006/House_git/taif_house/docs/OPEN_ITEMS.md

# Taif / Palm House · V10.0 · open items

Grouped by who has to act. **V10.0 (9 Nov 2026):** the malqaf at L5 adopted (item 9 rewritten for the air system v4; item 22 added for the structural engineer; item 2's spans); the breeze channel under the maid bath is gone, so the bathrooms interior study has no constraint from it any more. **V9.3 (8 Nov 2026):** the L1 tower (superseded by L5). The numbers match `data/open_items.csv` and presentation sheet 10. `tools/check.py` checks that every item is listed here. **V9.1 (8 Nov 2026):** item 1 updated (B1 6.00 m from M1 after the owner's car test, the cut wall a further 0.24 m shorter: 0.91 m / 0.42 m); item 18 gains the levels note (the finished floor, the plinth, the entrance steps or ramps, the courtyard and garden levels and the sewer falls from the official survey). **V9.0 (layout freeze, 6 Nov 2026):** item 1 updated (the house set out on site at its final position, the cut wall shorter: 0.90 m / 0.42 m); **bedroom 1's shower closed** (the young children's room, bathed in the master suite: no en-suite); item 16 is now the existing farm to measure; items 10 and 18 updated (the septic serves both houses, the inlet −1.24). **Closed in V8.3:** the ground-floor shower (G-07: not needed, owner; the powder room instead); the plumbing decisions of 3 Nov 2026 (the east stack external, trap primers, rain / sewage separate). **Closed in V8.2:** the clerestory glazing (openable, as drawn), bedroom 1's bathroom (option A), the suite court's south side (a mashrabiya screen), the food route (accepted), the site and services plan (done as a study: its open points are the survey, the municipality and the plumbing decisions below).

## Survey
1. **Envelope gap (the setback margin): 0.91 m from the deed setback line, 0.42 m from the wall as built** (8 Nov 2026: B1 6.00 m from M1 after the owner's car test, the cut wall a further 0.24 m shorter to keep the 0.42 m; V9.0: the owner set the house out on site and moved it 1.24 + 0.50 m south, B1 5.49 m from M1; the cut wall 0.12 m shorter after the field reading of 2.30 m to the boundary wall at its tightest point; the governing line is the lane notch on the cut wall). The official survey, and **the engineering office's answer on whether the setback is counted from the deed line or from the wall as built** (the wall stands 0.62 m inside the deed line along the cut): `docs/SITE_SETOUT.md` with `studies/setout.typ`.

## Structural engineer
2. **Edge beam and columns:** the edge beam on x 5.80 (spans ≈ 4.33 m to the malqaf core and 6.25 m, V10.0; was 6.5 + 6.25) and the three columns under the first-floor west projection: beam depth, column sizes and their foundations.
3. **Men's majlis roof and the guest block under the south wing v2** (X5 revised, improved, not verified): the gym inside the column frame (B19 between C19 and C20, a new B22 under the double wall), the suite court terrace on the majlis roof (a depressed zone, falls, planters), the office wall x 10.0 on rib B21 (non-load-bearing), R8 across the court's south side carrying the cornice, the parapet and the mashrabiya screen; the treadmill bay's vibration.
4. **Roof ladder** (V8.1): the rendered pilaster (V10.0: no stone) on the gym's east wall in the suite court that holds the ladder's recess (the 0.20 wall on B19 not cut, X20), the ladder's fixings and the gate posts on R3; the 1.10 m guardrail set back 1.0 m on the south wing (anchors through the waterproofing). The engineer and the ladder supplier; the fall protection confirmed by the specialist under the Saudi requirements.
5. **First-floor walls off ground-floor lines:** y 3.0 over the women's majlis; the suite walls over the kitchen (and, if the plumbing proposal (b) is adopted, the suite bath's 0.20 m service wall on the depressed slab); the gym nib and the office wall over the men's majlis. Light partitions on the slab, or beams. The family bath's wall on y 7.9 stands on B12.
6. **Floor-to-floor height 3.6 m** (assumed): confirm the levels; **the flipped stair (V8.2):** headroom 2.22 m at tread 6 under the mirrored trimmers B16′–B18′ (0.30 m trimmers give 2.32), the first-floor opening turned round; the handrails.
7. **Soil report:** none yet: the footing type and depth, the lift pit, the malqaf core's pad (V10.0)'s base and sump (X9), the soakaways.

## Acoustics
8. **Acoustic wall** between the gym and bedroom 3 (south wing v2): a double wall (target Rw ≈ 55 dB airborne, sealed at the top, nothing fixed to it), a floating floor or dense rubber under the treadmill, anti-vibration pads. Acoustic / structural engineer to set the build-ups, then test on site. Details in `DETAILS.md`.

## MEP / plumbing engineer
9. **Main ventilation system** (`docs/AIR_SYSTEM.md`, v4, V10.0: the malqaf at L5): the breeze path (the head's mesh and flaps, D1 at the shaft's head, the dust trap, the outlet louvres and D2), the filtered supply fan 750 m³/h (a washable pre-filter + an ISO ePM1 ≥ 50 % filter, a silencer) with high grilles into the family living, the gallery, the riwaq and the women's majlis, the hood's interlocked make-up inlet (mandatory), the west stack's vent re-routed to the south-east, the chamber's gully and electrics, the two switches and the dust relay. *MEP engineer:* size and confirm (the breeze ≈ 1.8 m³/s at 21 km/h, the separations); every figure assumed.
10. **Plumbing study rounds 1–2** (`studies/plumbing.typ` → `output/plumbing.pdf`, 11 pages, **proposals**) **with the owner's decisions of 3 Nov 2026:** the east stack external on the east wall behind removable cladding; automatic trap primers on the rarely used drains; rain and sewage fully separate, the condensate by tundishes / trapped air-breaks; no ground-floor shower. **Still open:** the suite bath's drainage approach (a: every drain in the sunken tanked slab, they fit at the limit / b: the east service wall + the tub's plinth, recommended); the heaters (two cylinders, west ≈ 100–120 L in the utility room, east ≈ 150 L in the laundry, or a roof heat pump with a ring main); the utility room's door moved south (y 9.45–10.2); the water system (**the next study**: the tankers, the ground tanks, a roof tank, the pumps, the greywater lines to the south garden with diversion chambers); the septic's inlet level (−1.24 computed; a pump at the gate's collector chamber if the surveyed inlet is higher than −1.19). Then the plumbing engineer designs everything marked assumed.
11. **East-wall stack:** the stack outside the east wall at y 7.05 behind a removable cladding panel (recommended over an internal duct, plumbing round 2 A3), its four branch fittings at +3.4 … +3.9 and a rodding eye, the vent 1.0 m above the roof; the kitchen extract through the east wall; the hood clear of the stack. The MEP engineer sizes and details it.

## Owner
12. **Laundry service door · decided:** a lockable 0.90 m door in the kitchen's east wall at its north end, to the east service yard. Lock and hardware with the joinery.
13. **Foyer majaz only partial:** the entrance door and the majlis opening overlap in the short foyer. Accept it, or add a curtain or a short screen.
14. **Lift shaft size:** the lift is installed at construction (two stops); the shaft 2.25 × 2.2 is a placeholder until a supplier's civil drawing is chosen. Its headroom above the first-floor stop must be **≤ 3.40 m** (or ≤ 3.70 m with a 0.30 m raised head hidden behind the coping); the lift does not serve the roof.

## Design (next rounds)
15. **Daylight:** a daylight simulation of the courtyard and the double-height living with the final levels.
16. **The existing farm to measure** (V9.0; the owner's answers placed approximately): the old house and its annex (W1–W4, A1–A4), the covered parking (P1–P4), the ground tank (K0–K2, its lid and fill point), the reserved tank's place, the septic's position and inlet level; where guests park; the south gate, the workers' house, the service gate. The tapes from M1, D and R are on the field sheet (`docs/SITE_SETOUT.md` § 8); then `data/deed_sketch.csv` and the studies are corrected. *(Bedroom 1's shower, the former item 16, is closed in V9.0: the young children's room, no en-suite.)*
17. **Facade principle (R-37):** to be applied at the facade design stage: the walls now blank or with small / high windows for privacy are candidates to open (the women's majlis north window, the kids' room north window, a north-light clerestory for the family living, the dining and suite east windows, the office's east window, the men's majlis south sills); the west guest side keeps its privacy (owner); the escape windows and the climate rules still govern.

## Survey, municipality (from the site plan, V8.2; V9.0)
18. **Septic, tanks and levels (survey):** the existing septic *outside the north wall near corner C1* serves the old house and takes the new house's drains (owner, V9.0): its inlet level, its capacity for both houses and its condition; the street level at the gate, the farm's levels: all approximate in `studies/site_plan.typ`. Then the drainage falls are re-checked (a pump at the gate's collector chamber if the inlet is higher than −1.24). **Levels (8 Nov 2026):** the ground falls slightly to the south; the owner accepts raising the house on a plinth if needed: the finished floor level, the plinth, the steps or a ramp at the family and guest entrances, the courtyard and garden levels and the sewer falls are to be set from the official survey's levels (`SITE_SETOUT.md` § 9).
19. **Municipality:** the septic's reuse and its legal position outside the wall (the drain crossing under it), the rain soakaways and their overflows, the gas cabinet and the Civil Defense's villa requirements (access, water, alarms). Parking in the north setback strip is allowed (owner, 2 Nov 2026).

## Structural engineer (V10.0)
22. **Malqaf core and head (L5):** an independent RC core at the courtyard's north-west corner on its own pad (≈ 2.4 × 3.0 × 0.6; ≈ 100 kPa assumed on 150), absorbing C17, C21 and the first arcade column; the fourth support of the west projection (B3 / B4 first spans 6.50 → 4.33 m: re-size); R3 widened to 0.40 over y 6.5–8.8; the new beam R-L5 (1.55 m) under the head's south wall; the head frame for wind and *earthquake* (Sds for the site); the slabs' ties; the north-east slab openings closed. Fall-back F2 if the beam additions are refused.

## Facades (after the plan freeze; owner, 9 Nov 2026)
20. **Facade study (three stages):** after the plan freeze and once the windows are set: (1) the windows (sizes, positions, the GF and FF windows on one vertical axis, the 20 cm module); (2) the shaping with the structure: the recesses, the projections, the arches and the cornices built in block and concrete; (3) the finishes: *render and paint only, no stone* (a light sand render, an optional calm honey tone on the projections). Builder's rules from the start: plaster mesh over every block / concrete junction, drips and falls on every projection.
21. **D11 facade bands:** walls in 20 cm block; around the windows 30 cm block bands projecting 10 cm (inner face flush), full height from the base to the cornice like pilasters; the GF and FF windows on one vertical axis; all window and band sizes on a 20 cm module. Checks: 30 cm block in Taif (availability, price), the continuity of the wall insulation, the render and mesh at the band edges.

## The next items, in order (from the review status `output/Design_Review_status_V10.0.pdf`; V10.0: the bathrooms interior study first, then the water system, then the engineers' package)
1. **The official survey and the engineering office's answer on the setback** (deed line or wall as built) (1).
2. **Measure the existing farm on site:** the old house, the covered parking, the tanks and the septic's inlet level (16, 18).
3. **The water system study:** the tankers, the ground tanks, a roof tank, the pumps, the greywater lines to the south garden with diversion chambers (10).
4. **The suite bathroom's drainage approach** (10, 11).
5. **The full verification and validation review of the frozen layout (V9.1).**
6. **The engineers:** structure X5 (2–6), the soil report (7), the MEP sizing (9–11), the lift supplier (14).
7. **The bathrooms' interior study.**
8. **The facades and the details**, acoustics included (8, 15, 17, 20, 21: after the plan freeze; render and paint, no stone); the municipality (19).
