ahl20006/House_git/taif_house/docs/PROJECT_V10.md

# Taif / Palm House · V10.0 · master document · layout freeze, final site position, the malqaf (L5)

Concept design of a two-storey courtyard house in Taif. This document describes the whole house as of **V10.0** (git tag `v10.0`, 9 Nov 2026: **the malqaf moved to the courtyard's north-west corner (L5)**, adopted from `studies/malqaf_L5.typ`: an independent RC core inside the covered strip with the foot chamber (the dust trap, the filters and the fan, the space for a cooler, a carved door onto the strip) and the breeze outlet in the first arcade arch facing the seating (≈ 4 × the L1 breeze), the shaft at the gallery's end, the head 1.6 × 2.4 on the roof in render and paint; the core the fourth support of the west projection; the HRV replaced by a filtered supply fan; the north-east corner restored to its V9.1 rooms; no stone anywhere (render and paint; porcelain floors); simple controls: two switches and a dust relay), **V9.3** (git tag `v9.3`, 8 Nov 2026: **the new malqaf tower**, adopted from `studies/malqaf_tower.typ`: at the north-east corner, a slim shaft along the cut wall with straight room walls, a honey-stone tower on the attic's corner with a head of slender arched openings 3.5 m above the attic and a Hijazi cornice, the HRV in a hidden plant room behind the attic, the breeze channel at full width), **V9.2** (git tag `v9.2`, 8 Nov 2026: small fixes: the utility room's label, **the air tower back to a rectangle of 0.90 m² clear** with the wedge beside it given to the maid bath and bedroom 1, the HRV base at its V9.0 footprint, **the attic 2 cm lower** so it is hidden from the north boundary) and **V9.1** (git tag `v9.1`, 8 Nov 2026): **the final site position**, corner B1 exactly **6.00 m from M1** after the owner's car test on site (a full forward turn into the north strip without any manoeuvre needs it; a further 0.51 m south), and **the cut wall shortened again** (a further 0.24 m outwards) so it keeps **0.42 m from the boundary wall as built** (0.91 m from the deed setback line); the set-out sheet re-issued, the site items updated, the levels to be set from the official survey. The layout stays frozen (§5) since **V9.0, the layout freeze** (git tag `v9.0`, 6 Nov 2026), which added to V8.3 the **site set out on site** by the owner (day 1, the diagonals exact) and the **final position** (1.24 + 0.50 m further south, corner B1 5.49 m from peg M1); the **cut wall 0.12 m shorter** after the field reading of 2.30 m at its tightest point (0.42 m from the boundary wall as built, 0.90 m from the deed setback line); the **whole-farm base v2** (the deed is the boundary authority) with **the old house and its majlis, the covered parking, the water tanks and the septic** placed from the owner's answers (approximate, to be measured); and **bedroom 1 as the young children's room without an en-suite** (§4.54–4.60). V8.0–V8.3 brought the fire safety, the courtyard layout, the air system, the south wing v2, the roof ladder, the stair flip, the site and services plan, the plumbing study and decisions, bedroom 2's en-suite and the family WC, the powder room, the level courtyard, the outdoor kitchen by the service door and the facade principle R-37 (§4.31–4.53). The open items are listed in `OPEN_ITEMS.md`, the next steps in `NEXT_SESSION.md`, the field record in `SITE_SETOUT.md`. The figures below come from the project files: `data/*.csv`, the design files and the studies. They match the presentation `output/Taif_House_V9.0_presentation.pdf` (12 sheets; sheet 01 the site, sheet 06 the south wing and the suite, sheet 09 the decisions, sheets 11–12 the roof and the elevations) and the review status `output/Design_Review_status_V9.0.pdf`. The plumbing study, the site plan and the whole-farm study are studies: their positions and sizes are proposals until the survey and the engineers confirm them.

*Concept design, not for construction. Structure, services, levels and the site survey still need the engineers' and the municipality's review.*

---

## 1. Coordinates and site

- **Units:** metres. **Origin:** survey peg **M1**, the east post of the gate.
- **Axes:**
  - x runs east, square to the M line;
  - y runs along the M line, **southwards**;
  - the DXFs draw y pointing up, so a point (x, y) is (x, −y) in the DXF.
- **Two frames:**
  - **CSV frame:** the room coordinates in `data/rooms_gf.csv` and `data/rooms_ff.csv`. The ground floor's north-west wall corner is at (0, 0).
  - **Site frame:** CSV + shift.
- **Placement** (`design_gf.typ`, also used by the first floor):
  - shift **(0.91, 6.0734)** (V9.1, 8 Nov 2026): **B1 (the north-west outer corner) exactly 6.00 m from M1** (0.785 m east of the M line, 5.948 m south), a further 0.5104 m south: the owner's car test on site showed that a full forward turn from the gate into the north strip, in one move, needs it (`studies/site_plan.typ` page 2: the swept path); total 2.248 m south of the V8.3 design position (3.825); before (V9.0, 5.563): the owner set the house out on site on 4 Nov 2026 with corner B1 exactly 5.00 m from M1 (shift 5.063, 1.238 m further south than V8.3's 3.825), then moved it a further **0.50 m south** on 6 Nov 2026 (`studies/shift_south.typ`): B1 5.49 m from M1; the west face 0.785 m east of the M line throughout; to be confirmed by the official survey;
  - rotation **0°**, so the house is square to the M line;
  - true north is **21.4°** off the M line and the prevailing NW wind **23.6°** off.
- **Site data** (`base.typ`, fixed):
  - the plot and the buildable envelope (**667.87 m²**);
  - the driveway on the west, the lane on the north-east, the north street wall;
  - pegs M1–M4 on the M line (y 0, 6.36, 18.52, 28.8; M2–M4 are gone on site, M4 is re-established from M1 and D); **V9.0: the site baseline v2** (`data/site_v2.csv`, written by `tools/site_frame.py` from the field check of 3 Oct 2026 in UTM; `base.typ` asserts its literals against it within 2 cm): the dakka corner **D** (−5.49, 27.89), the reference pegs **R** (−1.19, 35.05) and **S** (16.27, 34.48), the plot corner C1 (−16.70, 3.08), the well (−4.63, 64.11); **the deed is the boundary authority**;
  - palms **P1 (20.6, 28.09)** and **P2 (21.39, 31.87)**, both beyond the south facade.
- **Set out on site (V9.0; the sheet re-issued for V9.1 on 8 Nov 2026: B1 6.00 / 22.82, B2 12.90 / 27.72, B3 18.25 / 25.87, B4 33.43 / 19.97, B5 30.21 / 6.69 from M1 / D; the third set-out moves every block 0.51 m straight south from its V9.0 place, then B2 0.27 m east and B3 0.51 m north; `docs/SITE_SETOUT.md`, `studies/setout.typ` → `output/setout.pdf`):** the owner set the five corners out with a string and two tapes from M1 and D on 4 Nov 2026 (M1 → D 28.50 against 28.43; the sides and the diagonals 27.78 / 26.33 exact; four corrections kept as lessons: two arcs cross twice, confirm every corner with a third distance or a diagonal); then the field readings: B2 2.40 m and the cut wall's tightest point **2.30 m** (re-measured precisely) to the boundary wall's inner face (the model gives 2.92 to the deed line: the wall stands **0.62 m inside the deed line** along the cut), B1 4.77 m to the old house's yard wall. The second set-out moves every block 0.50 m straight south along the string and B2 / B3 for the shorter cut wall (§4.55–4.56). Targets from M1 / D: B1 5.49 / 23.31 · B2 12.43 / 27.96 · B3 18.25 / 25.87 · B4 32.97 / 19.92 · B5 29.70 / 6.53.
- **The whole farm (V9.0, `studies/whole_farm.typ` → `output/whole_farm.pdf`):** the 20 deed corners (7 737.7 m²), the 4 m main gate (M1 its east post) and the estimated east service gate, the well, the palms, D, R, S, the sheep barn and the shade house, the workers' house (estimated), and the **existing buildings from the owner's answers of 5 Nov 2026** (approximate, to be measured, `SITE_SETOUT.md` § 8): the **old house** (one storey, reinforced concrete, the old majlis inside it) **west of the driveway** along the west boundary as on the deed sketch (digitised, ± 1–3 m); its **covered parking for two cars south of it**, west of the driveway; the **existing ground tank south of it, west of the driveway near peg R**, the reserved tank beside it (west), the water truck on the driveway, the supply pipe across the driveway to the utility room (27.8 m); the **septic outside the north wall near C1 serves the old house and takes the new house's drains**. Nothing of the farm lies south of the build land; where guests park is still to be decided.
- **The site and services plan (V8.2; V9.1 at the final position; `studies/site_plan.typ` → `output/site_plan.pdf`, 5 pages, 19 checks, a study: every position proposed, to confirm with the official survey and the engineers):** one entry, the farm's 4 m main gate; the 3.95 m driveway stays (nothing of the house, its cornice or its windows enters it; the cornice 0.49 m clear); **one uncovered family car in the north setback strip, kept** (V9.1: the bay on the car's turning line, y 1.77–4.27, 1.68 m off the north wall; **the swept path of the design car, a large SUV 5.0 × 2.0 m with an 11.8 m turning circle: one forward move from the gate into the bay, 0.69 m from the house's walls (0.18 at V9.0 on the same line), 0.55–0.56 m from the gate posts: the 4 m gate now governs**; the family entrance path 8.76 m); guests walk a 1.2 m honey-stone **guest path** along the driveway's east edge from its south end to the guest entrance (13.2 m, bollard lights); workers and deliveries along the farm's north boundary wall and the lane-side strip to the **service yard** (bins, the 1.8 m screen, the LPG cabinet ≥ 1.5 m from every opening and ≥ 3 m from the grill); the **family garden on the south only** round the palms (≈ 236 m² at V9.1), behind a 1.2 m honey-stone wall (west) and a 1.8 m hedge (north-east); no garden door from the living (owner). Utilities: the tanks as above; the foul drains of both clusters (the east main 38.8 m, the west branch 19.8 m) run north and west to a collector chamber inside the gate, a chamber at every change of direction, the driveway crossed once, under the wall 1.4 m west of the gate's post to the septic (the inverts on assumed falls: the inlet at **−1.24**; its capacity for both houses, its inlet level and a pump if it is higher are for the engineer and the survey); **rainwater fully separate** (two soakaways with surface overflows, V9.1 moved to stay ≥ 5 m from the walls: the east one into the garden's east corner, the south one into the garden's deep west part; never into the septic); **solar PV provision** with the inverter and batteries in the utility room; **no generator** (owner); a video intercom at the gate, seven cameras, the alarm panel in the utility room; Civil Defense: the gate 4.02 m and the driveway 3.95 m take a vehicle. Levels to be set from the survey.
- **Outside the house (V8.3, `design_gf.typ` site outlines, `3d/params.yaml` `outdoor_kitchen`, `studies/site_plan.typ`):** the outdoor counter and sink against the east wall *next to the kitchen's service door* (CSV y 8.3–10.1, under the kitchen window, a few steps from the door; a canopy over it optional); the grill and tannour a little apart in the yard's south part (x 16.5–17.6, y 12.6–13.8: ≥ 3 m from every door, window and the hood outlet, ≈ 12 m from the malqaf's filtered inlet (V10.0), downwind of the house in the north-west wind); the service yard re-planned: the 1.8 m screen at x 15.2 (a 1.15 m working strip at the counter), the LPG cabinet on the screen's outer face at its north end (≥ 3 m from the grill), the bins north of the service door away from the food; the workers' route proposed along the farm's north boundary wall and the lane-side strip (not the house's north facade), ending at the gas and the bins. One entry to the site: the farm's 4 m main gate.

## 2. Outline, envelope and gaps

- **Ground-floor outline** (wall centre lines, CSV): (0, 0) → (10.461, 0) → (13.311, 5.245) → (13.311, 24.0) → (0, 24.0) (V9.1: the cut wall a further 0.24 m outwards, parallel; V9.0 (10.188, 0) → (13.311, 5.749); V8.3 (10.051, 0) → (13.311, 6.0)).
  - A pentagon whose north-east corner is cut parallel to the lane down to y 5.245; the east wall then runs straight south. The cut wall is 5.97 m on centre lines, **6.08 m on the outer faces** (V9.0 6.65, V8.3 6.93).
  - **13.311 × 24.0 m on axes, 13.561 × 24.25 m outside.** Outline on axes 311.99 m²; outside footprint **321.11 m²**, including the courtyard.
- **First-floor outline:**
  - the same as the ground floor: the first-floor outer walls stand on the ground-floor outer walls (311.99 m² on axes);
  - the courtyard sky and the double-height void (40.16 m², 3.15 m wide) have no floor; the suite court (25.30 m², V8.0) is a terrace open to the sky on the men's majlis roof, its south side the facade frame;
  - the 1.55 m west projection over the courtyard and the void is carried by an edge beam and three columns at x 5.80 (§4.15, §4.25);
  - the conditioned house is closed round the open courtyard by the steel windows W1 / W2 / W3 (§4.25), arched since V7.1 (§4.30), over a three-arch arcade in the courtyard bay.
- **Walls:**
  - allowances 250 mm outer, 200 mm inner, 100 mm dry block partitions (maid wing), ≈ 60 mm steel window frames on the courtyard edges (V7.0);
  - rooms are stored on wall centre lines; clear areas subtract half of each wall.
- **Gaps:**

| Gap | Value | Where it comes from |
|---|---|---|
| Ground-floor outer west face → M line | **0.785 m** | `design_gf.typ` (m-gap) |
| First-floor outer west face → M line | **0.785 m** | `design_ff.typ` (on the ground-floor wall) |
| Nearest outer wall face → setback line (the lane notch on the cut wall; the north street line 3.04 m away at B1) | **0.91 m** from the deed line · **0.42 m** from the wall as built (field 2.30 m; V9.1) | `design_gf.typ` (env-gap), `SITE_SETOUT.md` row 25 (to confirm by survey) |
| Palms P1 / P2 → outer walls (trunk faces) | **5.99 m / 6.97 m** | `presentation.typ` (sheet 01) |
| Floor to floor (assumed) | **3.60 m** | `studies/sections.typ` (to confirm) |

- **Grid of main lines (CSV):**
  - x = 0 · 2.75 · 4.25 · 5.80 (the colonnade) · 8.95 · 10.0 (the office wall, V8.0) · 13.311;
  - y = 6.5 · 13.0 · 19.25 · 24.0 (the kitchen's north wall is a partition at y 7.0 since V7.0; the beam line stays at y 6.5).
- **Bands, west → east:**
  - west band 0–2.75;
  - riwaq 2.75–4.25;
  - middle band 4.25–8.95 (4.70 m on axes = **4.50 m clear**);
  - east band 8.95–13.311.

## 3. Room schedules

Room numbers follow the CSV order (G.. ground floor, F.. first floor), as in the presentation and the DXFs. *Axes* = wall centre lines; *clear* = inside the walls as drawn.

### 3.1 Ground floor (`data/rooms_gf.csv`, `design_gf.typ`, studies `guest_wing.typ` and `east_wing.typ`)

| No. | Room | Axes (m) | Axes m² | Clear m² | Purpose · doors · rules |
|---|---|---|---|---|---|
| G01 | Courtyard | polygon | 27.19 | – | The cool heart, open to the sky, enclosed on four sides; its west 1.55 m under the first-floor projection, a colonnade with a three-arch arcade in this bay (V7.1). **V10.0 (L5):** an L-shape: the malqaf core takes the north-west corner of the covered strip (x 4.40–5.80, y 6.5–8.667), so the first arcade arch holds the *breeze outlet* 1.4 × 1.0 with its timber louvres facing the seating; the first arcade column is absorbed in the core. **V8.3 layout** (`studies/courtyard_layout.typ`): the whole floor level (no step), movable modern sofas and armchairs for 4–6 facing the outdoor TV on the kitchen wall (in a rendered surround), the water + tree enclosure in front of the sink window, linear drains on the rain system. Floor: outdoor anti-slip porcelain in a sand / honey tone (V10.0: no stone). |
| G02 | Women's majlis | 4.7 × 6.5 | 30.55 | 28.24 | North of the courtyard. Women guests come in through the family door. Solid wall to the maid wing. |
| G03 | Living (double height) | 4.7 × 6.25 | 29.38 | 27.83 | South of the courtyard: double height with two clerestory windows on the suite court (V8.0: the winter noon sun on their whole height). Entered from the riwaq through a 1.40 m arched opening; its west wall is solid with the arched TV niche 4.40 × 0.70 m (V6.3). Column 2 stands in the glass to the courtyard, column 3 in its south wall. |
| G04 | Men's majlis | 10.56 × 4.75 | 50.16 | 46.77 | The full width on the south. Entered only from the foyer, through a 1.80 m opening with no door. High south windows; the main seating at the east end. Its roof carries the gym's strip, the suite court terrace and the office (V8.0). |
| G05 | Maid bath | polygon | 4.58 | 3.77 | WC, basin and compact shower; door from the maid room only, 0.70 m. **V10.0:** back to its V9.1 shape (y 1.0–2.8 up to the cut wall, straight walls; the WC in the cut-wall corner, the basin and the shower on the west wall); no breeze channel under it any more (the malqaf moved to the courtyard, L5); a store off it (G21). |
| G06 | Maid room | polygon | 9.55 | 8.41 | Behind a 100 mm partition, y 2.8–7.0 (V7.0); the municipal minimum met; **V9.0 / V9.1: the cut wall 0.12 + 0.24 m further out (7.28 → 7.69 → 8.41 m² clear)**. V8.0: its window an escape casement 1.14 × 1.00 at sill +1.10, obscured below +1.60, no screen (V9.1: slid north along the cut, y 3.4–4.4). |
| G07 | Laundry | 1.7 × 4.2 | 7.14 | 6.2 | y 2.8–7.0. Open entrance from the kitchen. Machines, sink, shelves on the solid west wall, 0.95 m walkway (the breeze channel's covers in its floor, V8.0). |
| G08 | Kitchen | 4.36 × 6 | 26.17 | 23.99 | y 7.0–13.0. The heavy kitchen, isolated: door to the dining, an open entrance to the laundry, a lockable 0.90 m service door to the east service yard. **V8.0:** the sink under its courtyard window (y 7.3–8.9) looking at the water and the tree, the dishwasher south of it, the counter on to y 12.9 (the outdoor TV on the other face of the wall); the cooking run on the east wall (hob and hood y 10.2–11.2); a filtered make-up air inlet under the stone band, interlocked with the hood. **V8.2 (plumbing proposal):** the suite bath above it keeps all its drains out of the kitchen's ceiling (a service wall or the sunken tanked slab); nothing under the hood zone. **V8.3:** the outdoor counter outside the service door; the courtyard enclosure in front of the sink window. |
| G09 | Living (normal height) · dining | 4.36 × 6.25 | 27.26 | 25.63 | One room with the living; the ceiling height changes on x 8.95. Door to the kitchen. |
| G10 | Lift (shaft placeholder) | 2.25 × 2.2 | 4.95 | 4 | Installed at construction (V6.3), two stops; the roof is not served. |
| G11 | Family lobby + riwaq | polygon | 30.3 | 26.02 | From the family entrance (with a glazed obscured side light, x 2.4–2.9) to the men's majlis wall; **V8.2:** the lobby takes the former entry cupboard's strip; the flipped stair's lower flight rises south off it behind a 0.90 m black-bar balustrade (the stair open to the riwaq); the coat cupboard at the stair's start, the store under the half landing. **V10.0 (L5):** its first courtyard panel (y 6.8–8.9) is the malqaf core's solid rendered face with a built-in bench; the riwaq keeps the 0.15 m sliver between its glazing line and the core's wall; a high filtered-air grille on the core's west face. |
| G12 | Stair | 2.75 × 5.7 | 15.68 | 13.89 | Open, no door. **V8.2 (flipped, option B):** the lower flight on the east half rises south straight off the lobby (the first riser 1.45 m in front of the entrance strip), the half landing at the south end (a small obscured west window, sill +2.60), the upper flight on the west half arrives at the north end beside the lift's first-floor door; a full-height **coat cupboard** in the west half of the start strip; the **store under the half landing** (south end, 1.65 m, a low door onto the riwaq). It stops at the first floor; the roof by the maintenance ladder in the suite court (V8.1). Headroom 2.22 m at tread 6. |
| G13 | Utility room (shaft inside) | 2.75 × 2.5 | 6.88 | 5.81 | The west shaft, the main panel, the manifold and the water heater behind one door; **V8.2:** the inverter and battery cabinet here too (owner), kept away from the water (the plumbing study's layout; the room flagged small, ≈ 4.3 m² free; the door proposed moved south). |
| G14 | Hospitality kitchen | 2.75 × 2.5 | 6.88 | 5.81 | A light kitchen for coffee, tea, dates and desserts, open to the riwaq. |
| G15 | Family powder room (WC · 2 basins) | 2.75 × 3.2 | 8.8 | 7.58 | **V8.3 (owner):** the family basins and WC as one luxurious powder room (≈ 7.6 m² clear): a stone / marble vanity with two basins under a large mirror on the north wall, cove lighting, the wall-hung WC at the south end on a 0.25 service wall (bedroom 3's stack inside it, an access panel from the serving passage), a 1.00 door from the riwaq, a 1.5 m turning circle; separate from the hospitality kitchen; **no shower on the ground floor** (ageing in place relies on the lift and the first-floor bathrooms). |
| G16 | Serving passage (2 doors) | 2.75 × 1.4 | 3.85 | 3.03 | The only family / guest link: two doors never open together, both locked from the family side. |
| G17 | Guest WC | 1.5 × 1.75 | 2.63 | 2.02 | Door 0.90 m in the south wall behind a screen wall. |
| G18 | Guest basins (trough · 3 taps) | 1.5 × 2.15 | 3.22 | 2.53 | One trough with three taps. |
| G19 | Guest passage | 1.25 × 3.9 | 4.88 | 3.79 | From serving door 2 to the foyer. |
| G20 | Foyer + entry | 2.75 × 2.6 | 7.15 | 6 | Double door 1.40 m; a 1.80 m opening into the men's majlis. |
| G21 | Maid store | polygon | 1.78 | 1.29 | **V10.0:** the whole cut tip north of the y 1.0 partition, off the maid bath (door 0.60): cleaning things and linen on shelves (was the L1 air tower's shaft and a small store, V9.3). |
| – | Malqaf core (not a room) | 1.4 × 2.167 | 3.03 | 2.36 | **V10.0 (L5): the malqaf's foot chamber** at the courtyard's north-west corner inside the covered strip (RC walls 0.20; outer faces x 4.30–5.90, y 6.4–8.767): the dust trap, the filter cabinet + EC fan + silencer, the space for a mobile evaporative cooler (an option), a carved timber door 1.0 × 2.4 on its south face onto the strip, the louvred breeze outlet 1.4 × 1.0 in its east face (the first arcade arch); the shaft (1.2 × 0.8 clear) above it at the gallery's end, the head 1.6 × 2.4 on the roof (§ 4.63). |

- **Rooms:** 281.76 m² on axes, excluding the courtyard and the malqaf core.
- **Totals:** 308.95 m² on axes including the courtyard (27.19 m², the L-shape), and 311.99 m² with the malqaf core (3.03 m², V10.0) = the outline on axes.

### 3.2 First floor (`data/rooms_ff.csv`, `design_ff.typ`, studies `ff_family.typ` and `ff_suite.typ`)

| No. | Room | Axes (m) | Axes m² | Clear m² | Purpose · doors · rules |
|---|---|---|---|---|---|
| F01 | Upper gallery (on the west projection) | polygon | 31.86 | 27.84 | The family corridor on the 1.55 m projection, closed to the courtyard by the arched steel windows W1 (**V10.0:** five windows and one blind arch: W1-1 is a blind arched recess beside the malqaf shaft); **V8.2:** the flipped stair arrives at its north end beside the lift; **V10.0 (L5):** the malqaf shaft (1.2 × 0.8 m clear) stands in its north end against the family living's wall, the gallery turning past bedroom 2's bath at 1.5 m clear, a carved arched grille on the shaft's south face as a sealed provision; at its south end the gym's door and the suite door. |
| F02 | Linen cupboard | 2 × 0.7 | 1.4 | 0.95 | At the gallery's north end. |
| F03 | Family WC (gallery) | 2.75 × 1.3 | 3.57 | 3.15 | **V8.3 (owner):** the F-b bath's north strip as a family WC (≈ 2.8 m² clear): a wall-hung WC in the west cell behind a screen wall (not seen from the gallery when the door stands open), a basin on the screen's face; its door from the gallery (x 2.75, y 8.2–9.1); the fixtures on the service wall y 9.2 straight into the shaft. Serves the family living, the kids' room and the gallery; **V9.0 (owner): it stays WC + basin** (bedroom 1's young children are bathed in the master suite). |
| F04 | Bedroom 2 bath (en-suite) | polygon | 5.85 | 4.67 | **V8.3 (owner):** bedroom 2's en-suite from the F-b bath's south part plus the former wardrobe niche (≈ 4.7 m² clear): a level walk-in shower 1.0 × 1.6 at the east end with a linear channel along the service wall (its trap in the wall), the wall-hung WC on the same service wall (shared with the family WC, both into the shaft), the vanity in the west niche under the shaft's south wall; its door from inside bedroom 2 (x 1.7–2.6 on y 11.0). No pipe in the floor; over the GF utility room and hospitality kitchen. |
| F05 | Bedroom 2 | 4.25 × 3.4 | 14.45 | 12.88 | Bed 1.4 × 2.0 with its head on the south wall, a 2.0 m wardrobe on the east wall, a desk under the west window (an escape casement, no screen); **V8.3:** its own bath beside the shaft (the former wardrobe niche is the bath's vanity niche); the bed is in view from its door (noted). |
| F06 | Bedroom 3 bath | 2.2 × 1.7 | 3.74 | 2.96 | En-suite, over the GF family WC. |
| F07 | Bedroom 3 | polygon | 16.87 | 15.02 | An entry with a wardrobe, then the room; its south wall is the double wall to the gym (V8.0, Rw ≈ 55 dB). |
| F08 | Kids' room (study + gaming) | 4.7 × 3 | 14.1 | 12.49 | Desks under the north window, a gaming corner. |
| F09 | Family living | 4.7 × 3.5 | 16.45 | 14.85 | On the courtyard edge behind two arched windows W2. |
| F10 | Family link | 1.2 × 1.2 | 1.44 | 1.1 | To bedroom 1 and the suite door. |
| F11 | Bedroom 1 | polygon | 19.43 | 17.3 | **The young children's room next to the master suite (V9.0, owner):** one room, **no en-suite**; the children are bathed in the master suite's bathroom. **V10.0:** the cut tip is the room's again (y 0–5.3 to the cut wall, no slanted inner wall, no cupboard): the bed's head on the north wall, a north window beside it, the two cut-wall windows (the first an escape casement); nothing of the malqaf touches it (D10). |
| F12 | Owner's office | 3.31 × 4.75 | 15.73 | 13.96 | **East** beside the suite bedroom, **no door to it**. For the owner only (V8.1): reached from the suite court (the owner bedroom → court → office, the family gym → court → office); visitors are met in the men's majlis. One simple door from the court (into the office); a 0.90 east window at y 22.8–23.7 and the south window. Desk facing the south window, sofa, shelves, a fixed TV. |
| F13 | Gym | polygon | 22.2 | 19.92 | **V8.0, the west band** (4.25 × 4.75 + an entrance nib 1.55 × 1.3 at the gallery end) inside the column frame C6 / C13 / C19 – C7 / C14 / C20: the treadmill (Life Fitness T5 class, assumed) along the length on the stiff 2.75 m solid bay with 2.0 m behind and 0.5 m each side, a power rack with the barbell and the pull-up bar, kettlebells, a bike, the pilates mat, a fixed TV; windows west and south; its court door free from the gym side. |
| F14 | Suite court (open to the sky) | polygon | 25.3 | – | **V8.0** from the gym to the office, open to the sky, four sides: the three court doors (bedroom, gym, office) on a 1.2 m strip along its north edge, the seating (a sofa, two armchairs, a table, plants) in the south part; the floor falls south to a box gutter with an overflow, linear drains at the near-flush doors; its south side the facade frame with a 1.10 m base, the infill the owner's choice (a mashrabiya screen recommended). **V8.1:** the roof ladder in a honey-stone pilaster on the gym's east wall at its north end (behind a locked walnut-finish panel). A fresh-air area, not an exit. |
| F15 | Suite lobby | 1.35 × 5.4 | 7.29 | 5.98 | From the family link to the bath, the dressing and the bedroom. |
| F16 | Suite bath | polygon | 10.24 | 8.84 | Freestanding tub by the east window (it stays), walk-in shower on the east wall, double vanity on the west wall; the floor depressed 0.15 and tanked over the kitchen, to the stack outside the east wall. **Plumbing proposal (b), V8.2:** an east service wall (wall-hung WC, a wall-drain channel, the tub on a plinth) so nothing but the channel body lies in the floor and nothing in the kitchen's ceiling. |
| F17 | Suite WC (closet) | 1.1 × 1.5 | 1.65 | 1.14 | WC with shattaf; its door sliding (V8.0). The plumbing proposal (b) hangs the WC on the service wall straight into the stack behind it. |
| F18 | Suite dressing | 3.01 × 3.45 | 10.39 | 9.05 | His and hers wardrobes, display, make-up table. |
| F19 | Suite bedroom | polygon | 26.03 | 23.6 | King bed facing south; its court door (sliding glass) opens onto an entry zone formed by a full-height wardrobe 0.6 × 2.3 (the sight-line test: the bed hidden from the gym and office doors and from the court seating with the doors open); the east escape window y 15.0–18.6. |

- **Rooms:** 222.7 m² on axes indoors (V9.0: bedroom 1 +0.67 with the cut wall), plus the suite court 25.30 m².
- **Master suite:** **55.60 m²** (lobby, bath, WC closet, dressing, bedroom).
- **Doors:** every bedroom and bathroom door a 1.00 m opening with a 0.90 m leaf (≥ 0.85 m clear), except the guest WC (0.90) and the maid bath (0.70).
- **Fixed elements:** stair (flipped, V8.2: it arrives at the gallery's north end beside the lift), lift shaft, west shaft and the malqaf shaft (V10.0, at the gallery's north end) rise from the ground floor.

## 4. Design decisions and their reasons

1. **Courtyard house.** A small, shaded courtyard at the centre, enclosed on four sides and open to the sky; the rooms the family uses most open onto it; quiet outer walls with small openings.
2. **One living room, two heights.** The courtyard half double height (a chimney with high windows), the east half (the dining) normal height with the first floor above.
3. **West service band.** The family entrance, the lift, the stair (with the coat cupboard in its start strip, V8.2), the utility room with the shaft and the west wash block in one band: services rise in one place, one stiff core.
4. **West wash block and the two-door serving passage.** One strip of wet rooms on one drain run; the guest side has no door onto the riwaq; the only link is a passage with two doors never open together, both locked from the family side.
5. **Hospitality kitchen.** A light kitchen beside the serving passage; the east kitchen is the heavy one.
6. **Guest foyer and majaz.** The double door at one end of the foyer and the majlis opening at the other (partial in the short foyer: open item 13).
7. **Trough basins.** One trough with three taps for the guests.
8. **Men's majlis.** Full width on the south, entered only from the foyer; high south windows; the main seating at the east end.
9. **East service block and maid wing.** The kitchen on the courtyard lines, isolated; the laundry along the women's majlis wall; the maid room and bath in the sloped corner, reached only through the kitchen and the laundry. The maid room meets the municipal minimum since V7.0 (§4.26).
10. **The malqaf** (V8.0: §4.33; V9.3: §4.62; **V10.0: §4.63**). An independent RC core at the courtyard's north-west corner (the foot chamber with the breeze outlet in the first arcade arch, the shaft at the gallery's end, the head 1.6 × 2.4 on the roof); the north-east corner back to its V9.1 rooms.
11. **Lift at construction, two stops (V6.3).** Ground and first floor; the shaft 2.25 × 2.2 a placeholder; the lift does not serve the roof (the roof by the maintenance ladder, V8.1).
12. **Utility room and shaft.** The west shaft inside a utility room with the panel, the manifold and the water heater.
13. **Plumbing strategy** (V8.2: the plumbing study rounds 1–2, `studies/plumbing.typ`; V8.3 decisions, §4.49: the east stack external behind removable cladding, automatic trap primers on the rarely used drains, rain and sewage fully separate with the condensate by tundishes; the suite bath's approach still open). Two clusters, no third: west round the shaft (one buried run under the wash block, now falling *north* to the driveway's chamber), east along the east wall (kitchen, laundry, maid bath buried east to the yard's foul chamber; the suite bath to one stack outside the east wall behind removable cladding). Both to a collector chamber inside the gate and under the wall to the septic near C1. Rain fully separate: the courtyard's drain and overflow and the suite court's gutter to their own chambers and soakaways. Every size assumed, to be designed by the plumbing engineer.
14. **First-floor zoning.** The family part on the north and west around the courtyard; the south wing (V8.0: the gym west, the suite court, the office east) and the master suite to the south and east.
15. **West projection on columns** (V5.0; restored in V6.1; 1.55 m since V7.0). The gallery on a 1.55 m projection over the courtyard and the void, carried by an edge beam on x 5.80 on three columns in existing wall or glass lines; the first-floor west wall on the ground-floor west wall, 0.785 m from the M line. *History:* the split projection of V5.1 was reverted in V6.1 (branch `v5-split-projection`, tag `v6.0`).
16. **Kids' room.** Study and gaming on the north side; a fourth bedroom later.
17. **Family living on the courtyard.** A view, not a path.
18. **Bedrooms.** Bedroom 1 one room without a bath, the young children's room next to the master suite (option A of V8.2; V9.0, §4.60); bedroom 2 with its en-suite and bedroom 3 with its own bath; a family WC (WC + basin) off the gallery by the shaft (V8.3, §4.47).
19. **Master suite.** A lobby to the bath, the dressing and the bedroom (a bent entry); the bedroom on the suite court; V8.0: no door to the office, an entry zone at its court door (§4.35).
20. **Owner's office.** On the east beside the suite (V8.0); for the owner only, reached from the suite court; visitors are met in the men's majlis (V8.1, §4.37).
21. **Gym.** V8.0: on the west band (§4.35). *History:* the L-shaped gym of V6.2 (the treadmill alone in an arm at the east end against the suite bedroom) is replaced.
22. **Suite court and the clerestory light.** V8.0: the court runs from the gym to the office and to the south facade (§4.35); the double-height living's two clerestory windows (+5.00 … +6.00) get the winter noon sun on their whole height (V7.1: 81 %), the obstruction seen from them falls from 40° to 31°. Their privacy: the sill is 1.40 m above the court floor; they stay openable, as drawn (decided V8.2; the court is no escape route, so no fire-resisting glazing is needed).
22a. **Decisions of 3D phase 3** (24 Oct 2026): X8 the colonnade to the roof; drop beams hidden by gypsum ceilings; the projection edge beam upturned (preference); the kitchen service door; X3 resolved in V6.3.
23. **V6.3 quick fixes from the design review** (tag `review-1`): the TV wall, the lift at construction, door widths, X3, slab thicknesses in the 3D, the two-children test, the house 0.30 m south.
24. **Two-children bedroom test (V6.3).** Bedroom 3 takes two beds, two wardrobes and two desks; bedroom 2 two beds, two wardrobes and one desk (`tools/bedroom_test.py`).
25. **Courtyard enclosure, option A** (V7.0): black steel divided-lite windows W1 / W2 / W3 close the conditioned house round the open courtyard; the projection 1.55 m, the sky 3.15 m.
26. **Maid room to the municipal minimum** (V7.0): the kitchen's north wall to y 7.0 as a partition; maid room 7.28 m² clear, 2.49 m at the bed.
27. **Roof access** (V7.0, *superseded*): the main stair continued to the roof with a stair room; since V8.0 the stair stops at the first floor, and since V8.1 the roof is reached by the maintenance ladder (§4.34).
28. **Roofline: flat roof, main cornice, set-back attic** (V7.0; lowered in V8.1, §4.38). A honey-stone main cornice at +6.90 … +7.35 all round, a thin band at +3.40, honey stone at the plinth and the corners; on the north block a coped upstand (+7.65) and the attic screen set back 1.0 m, a plain pentagon (no stair room) with openings to the strip, the gym roof and the office roof; the south wing a low parapet with a set-back guardrail, so the roofline steps. Above the attic only the malqaf on its HRV base (north-east).
29. **Design language** (V7.0, `DESIGN_LANGUAGE.md`): modern classic with a Taif spirit.
30. **Arched enclosure windows and the courtyard arcade** (V7.1): semicircular heads on W1 (six), W2 (two), W3 (one), crowns +6.60; two Ø0.25 stone columns between C21 and C22, three arches under the projection (decorative unless the engineer uses them).
31. **Fire safety at home level** (V8.0, owner; review E-08; `studies/fire_escape.typ`). Early warning and safe exit: interconnected mains smoke alarms with sealed battery back-up in every bedroom and on the routes, a heat alarm in the kitchen, CO and gas detectors, extinguishers on each floor and in the kitchen, a fire blanket; escape casements without screens or fixed mashrabiya in every sleeping room (the maid room's at sill +1.10); thumb-turns on the exit doors; the family escape plan. Not adopted: sprinklers, fire doors, a panel, beam detectors, a second majlis door, a safe room (R-33). *The first floor's exits (V8.1):* the main stair plus the escape window of every sleeping room (the home-level strategy); no second stair. The suite court is a fresh-air area for the suite, the gym and the office (open to the sky, walled, no way down), not an exit; the maintenance ladder in it is no escape device and the roof is no escape route.
32. **Courtyard layout** (V8.0, owner; *revised in V8.3, §4.50: the step and the benches removed, the enclosure moved to the kitchen wall*; review Y-02 / Y-03 / Y-04 / E-03; `studies/courtyard_layout.typ`). The seating one step down (−0.15, a honey-stone nosing, a riser light) from the colonnade edge to the kitchen wall, three built-in benches for six to eight and a low table; the outdoor TV (65″ outdoor-rated) in a semicircular honey-stone surround on the kitchen wall, the malqaf grille below it with a manual louvre, the switches for the damper, the assist fan and the fountain beside it; the north enclosure: one honey-stone box with a water basin (a laminar lip, no spray) and a planter for one tree (Laurus nobilis or Ficus nitida); no pergola (open item 18 of V7 resolved); children play in the garden; the drainage section (levels, the drain, an independent overflow, pipes east). **The kitchen sink window** moved north to y 7.3–8.9 over the sink (the dishwasher south of it), leaving the TV wall solid.
33. **Air system v3 / v3.1** (V8.0, owner; review E-01; `studies/air_system.typ`, `AIR_SYSTEM.md`). **One tower, two completely separate paths:** (a) a gentle natural breeze for the courtyard seating in pleasant weather — a head open on three faces with back-draught flaps (its south face is behind the HRV base), a breeze shaft ≈ 0.54 m², a spring-return damper, a shallow 0.9 × 0.20 channel inside the ground slab with eight removable covers (no pit, no entry, nothing notched), the plenum and the grille under the TV, a quiet EC assist fan behind the grille on its own switch; (b) the fresh-air intake of the house's ventilation: a service compartment ≈ 0.21 m² with its own louvre and a pre-filter, a 750 m³/h class HRV in a **base under the tower** (one mass, top +9.10, 0.40 above the lowered attic coping since V8.1, 1.65 m clear, serviced from the roof through doors), supply and extract risers in the compartment; ASHRAE 62.2 rates ≈ 330 m³/h continuous / ≈ 705 m³/h with 24 guests; an ISO ePM1 ≥ 50 % filter; the AC condensers south of the tower; the kitchen hood separate with an interlocked make-up inlet; continuous + boost, a dust mode, everything closing on a power failure. No water, no pads, no earth pipes. Every figure assumed, to be designed by the MEP engineer.
34. **Roof access by a maintenance ladder** (V8.1, owner: cost and appearance; `studies/roof.typ` page 2). A manufactured vertical fixed ladder (black matte, non-slip rungs, corrosion-protected, a central fall-arrest rail) in a 0.90 × 0.30 recess of a honey-stone pilaster added on the court face of the gym's east wall at its north end (the 0.20 wall on B19 not cut; X20), away from the seating and the door strip; 3.70 m from the court floor to the gym roof, 13 rungs at 0.28, the top rung level with the roof finish, toe clearance 0.20 m, the stiles 1.10 m above the roof as the transfer handholds; behind an exterior-grade walnut-finish panel that opens 180°, held open by a drop-bolt, locked with a key and not climbable when closed (children); a self-closing gate in the court's west guard onto a landing pad on the gym roof; an IP65 light and a slot drain at the foot. The guarding is continuous from the ladder to every piece of equipment. Workers enter through the house (gym → court); the fall protection is confirmed by the specialist under the Saudi requirements. **The internal stair stops at the first floor** (V8.0): no flights 3–4, no stair room, the roof slab closed over the well.
35. **South wing v2** (V8.0, owner; `studies/ff_suite.typ`, `studies/south_wing.typ`). *The gym* on the west band over the guest block, inside the column frame (its load path traced: the west outer wall, B10, B19 between C19 and C20, the double wall on B8 and a new B22), with an entrance nib at the gallery end (the gym and the gallery only touch at a corner); the treadmill along the length with the manufacturer-type zone on the stiff 2.75 m bay; a double wall to bedroom 3. *The suite court* from the gym to the office, open to the sky (25.30 m² axes): the three court doors on a 1.2 m strip along its north edge (bedroom sliding; gym into the court, free from the gym; office into the office, free from the court, key from the office side), the seating in the south, near-flush doors with linear drains and a box gutter. *The office* on the east, no door to the bedroom, one fixed TV in it and one in the gym (no pivoting panel). *Privacy without a screen:* the sight-line test with the doors open fails at the court seating without a fix; the smallest fix, an entry wardrobe 0.6 × 2.3 inside the bedroom, hides the bed from every point tested. *The court's south side* (solid / mashrabiya / 1.1 m wall) compared; the mashrabiya recommended, drawn as proposed, the owner chooses (open item 18). *Structure:* R6 removed; X5 revised, improved, not verified.
36. **Smaller V8.0 changes:** the maid bath's WC in the cut-wall corner (the air channel's throat); the maid room's escape casement at sill +1.10; the suite WC door sliding; the PV zones moved to the gym and office roofs; a fourth attic opening to the office roof.
37. **The office for the owner only** (V8.1, owner). Office visitors are met in the men's majlis; the office is reached from the suite court only (the owner from the bedroom, the family from the gym), with one simple door and no visitor lock logic; a 0.90 east window; the suite bedroom's escape window y 15.0–18.6.
38. **Roofline lowered and balanced; the outdoor kitchen; one site entry** (V8.1, owner; `studies/roof.typ`). The attic 1.40 m above the roof finish (coping +8.70; was 1.80 / +9.10; **V9.2: 1.38 / +8.68**, hidden again from the north boundary at the final site position): the sight lines re-run, it hides 1.2 m condensers on 0.10 pads (+8.60) and the tank from the street and the lane at every distance (the units specified ≤ 1.2 m). The south wing a visible parapet 0.70 m above the finish (+8.00; was 1.10 / +8.40) with a continuous 1.10 m black steel guardrail set back 1.0 m (not seen from the street), the strip outside it a no-go zone; the step 0.70 m; the 1.0 m strip in front of the attic a no-go zone (harness). Walkways from the ladder's pad to the tank, the HRV doors, the condensers and the PV; the PV inside the guarded zones (south wing 9.8 m², north block 20.5 m²). The HRV base stays at +9.10 as the malqaf's plinth (option: lower it). The outdoor kitchen: the counter and sink against the east wall on the service-door path, the grill and tannour apart in the garden (3.6 m from the house). The lane service gate is dropped: the farm's single 4 m main gate is the only entry.

39. **Main stair flipped, option B; the larger family bath F-b; the lobby** (V8.2, owner, from `studies/stair_flip.typ`). The lower flight on the east half rises south straight off the family lobby (the first riser 1.45 m in front of the entrance strip), the half landing at the south end, the upper flight on the west half arrives at the gallery's north end beside the lift's door; the trimmers mirrored (B16′–B18′), the first-floor opening turned round, headroom 2.22 m at tread 6. The freed south landing room and the old bath become **one family bath (F-b)** with a separate WC compartment by the shaft's stack, a double basin and the shower; the entry cupboard removed (the lobby takes its strip) and a full-height **coat cupboard** in the west half of the start strip; the lower flight open to the riwaq behind a 0.90 m black-bar balustrade; the **store under the half landing** with a low door onto the riwaq; a small obscured **west window at the half landing** and a glazed obscured **side light at the family entrance**.
40. **Bedroom 1 without a private bathroom** (V8.2, owner, option A of `studies/bedroom1_bath.typ`): the wet areas stay in the two clusters; low-level motion-sensor night lights along the route bedroom 1 → living → gallery → family bath (a note for the electrical design).
41. **The ground-floor shower deferred to the plumbing study** (V8.2, owner; `studies/gf_shower.typ`): P1 preferred (the family WC + basins as one accessible wet room with a level shower, B14 becomes a drop beam), P1-lite the fallback; decided with the plumbing scenario (§4.46).
42. **The suite court's south side: a mashrabiya screen** (V8.2, owner): a timber or black steel lattice on the 1.10 m base up to the frame soffit (+4.70 … +6.60, ≈ 40 % open): the palms seen out, no view in; built in the 3D.
43. **The clerestory windows stay openable** (V8.2, owner): the double-height living's clerestories on the suite court as drawn (sill 1.40 m above the court floor); open item 14 closed.
44. **The food route to the men's majlis accepted** (V8.2, owner; review X-01): the route from the kitchen through the dining and the riwaq to the serving passage stays; very large events use the old majlis on the farm; no outside service path, no serving door.
45. **The site and services plan** (V8.2, owner's brief and decisions; `studies/site_plan.typ`, a study): see §1. The decisions: the single 4 m gate; the north-strip parking kept; the guest path; the south garden and no garden door; the service yard and the gas cabinet rule; the existing tank east of peg R and the reserve beside it; the septic outside the wall near C1 with the drains north and west to it; no generator; the inverter and batteries in the utility room; intercom and cameras. Every position proposed, to confirm with the survey and the engineers.
46. **The plumbing study, rounds 1–2** (V8.2, `studies/plumbing.typ` → `output/plumbing.pdf`, **proposals, not applied**; review E-03, G-07; open item 10). Round 1: the principles (two clusters, buried GF drains with cleanouts and a chamber per cluster, stacks in the shaft or an accessible duct, FF baths on sunken tanked slabs or suspended only over service rooms, real vents, deep traps, anti-odour drains, a manifold water system with a cabinet per floor, one heater per cluster, leak sensors and an automatic shut-off), the inventory of 22 wet points, the overlay (every first-floor wet room over a wet or service room except the suite bath over the kitchen), the constraints map, the scores, the scenarios A / B / C with the recommendation B (+ C's duct, reversed in round 2), the utility room layout (flagged small). Round 2: the baseline (B; the tub stays by the window); rain and sewage fully separate and the condensate connections per device; **the suite bath over the kitchen** in dimensioned sections: (a) every drain in the sunken slab (they fit, at the limit) or **(b) an east service wall** (wall-hung WC straight into the stack, a wall-drain channel with its trap in the wall, the tub on a 0.12 m plinth with its trap and an AAV accessible, the vanity's jointless chase; the channel body ≈ 1.4 × 0.3 m the one local opening; nothing in the kitchen's ceiling, nothing under the hood zone) — **(b) recommended**; **the east stack external behind removable cladding** (recommended over an internal duct in the kitchen's corner); one page of every drain-smell source and its prevention. Every size assumed, to be designed by the plumbing engineer; the owner's decisions are open item 10.

47. **Bedroom 2's en-suite and the family WC upstairs** (V8.3, owner; `studies/ff_family.typ`). The F-b bath by the west shaft is split: bedroom 2's en-suite (y 9.2–11.0 with the former wardrobe niche as its vanity niche, ≈ 4.7 m² clear: a level walk-in shower 1.0 × 1.6 with a linear channel along the service wall, a wall-hung WC, the vanity; its door from inside bedroom 2) and a family WC (y 7.9–9.2, ≈ 2.8 m² clear: a wall-hung WC behind a screen wall, a basin; its door from the gallery). Every fixture on one 0.20 service wall on y 9.2 into the shaft, no pipe in the floor; the gallery and the guard round the stair opening untouched; bedroom 3's bath unchanged. Result: the suite, bedrooms 2 and 3 have their own bathrooms plus a family WC upstairs; bedroom 1 waits (§4.53).
48. **No ground-floor shower; the family powder room** (V8.3, owner; review G-07 closed as not needed; `studies/guest_wing.typ`). Ageing in place relies on the lift and the first-floor bathrooms. The family basins and the family WC become one powder room 2.75 × 3.2 (≈ 7.6 m² clear): a stone / marble vanity with two basins and a large mirror on the north wall, a wall-hung WC on a 0.25 service wall at the south end (bedroom 3's stack inside it, an access panel from the serving passage), a 1.00 door from the riwaq, separate from the hospitality kitchen; the hidden beam B14 becomes a drop beam or the slab spans 3.2 m (the engineer, X21).
49. **Plumbing decisions** (V8.3, owner; `studies/plumbing.typ`). The east stack external on the east wall behind removable cladding (not the internal duct); automatic trap primers on the rarely used drains; rain and sewage fully separate and the condensate by tundishes / trapped air-breaks adopted; the suite bathroom's drainage approach (option b, the service wall) not decided, open for discussion.
50. **Courtyard layout revised** (V8.3, owner; `studies/courtyard_layout.typ`). The sunken step and the built-in benches removed: the whole courtyard floor level with gentle falls to linear drains (the rain system, trap primers, an overflow gully); modern movable sofas and armchairs for 4–6 with a low table facing the TV; the fountain + tree enclosure moved to the north end of the east (kitchen) wall in front of the sink window (the tree north, rim +0.45; a raised water trough south, rim +0.95 under the sill +1.10, seen from the sink); the TV and its stone surround moved south (y 9.82–11.28, +0.60 … +1.46) with the grille below (+0.10 … +0.45); the north side in front of the women's majlis glass freed; the seating zone 12.1 m² (+1.6 m²) and the whole 28 m² floor on one level; no pergola.
51. **The outdoor kitchen next to the service door; the service yard re-planned** (V8.3, owner; `studies/site_plan.typ`): see §1.
52. **Facade principle** (V8.3, owner; R-37, `DESIGN_LANGUAGE.md`). The house stands inside a large, fully walled private farm; nobody outside can see it. The facades are designed for light, views, climate (sun, heat, dust) and composition, not for privacy from outside; blank walls only where a room needs them or where the owner chooses privacy from the guests' path to the majlis (west side). Applied at the facade design stage; the walls now blank or with small / high windows for privacy are candidates to open (the list in the changelog's V8.3 fold-in).
53. **Bedroom 1's hotel-layout en-suite (B4) studied, not applied** (V8.3; `studies/bedroom1_bath.typ` page 3). The room is a 13.9 m² clear wedge; the programme (a 3.84 m² shower room, a 1.9 m² entry, a ≥ 10 m² clean bedroom) needs more than the room holds; criteria 2 and 3 fail in every variant; B4-b is the best (a 7.3 m² L bedroom, the two doors at a corner, the shower room over the laundry and the maid bath only). Option A stands; *V9.0: not adopted* (§4.60: the young children's room).

54. **The site set out on site** (V9.0, owner, 4 Nov 2026; `docs/SITE_SETOUT.md`, `studies/setout.typ`). With a string and two tapes from M1 and D (R and S as checks), all five corners set and checked; M1 → D 28.50 (+0.07); the sides and the diagonals 27.78 / 26.33 exact; the perimeter string 74.0 (round the blocks, accepted). The four corrections (B5, B4 at the wrong arc crossing, B3 at a tangent crossing, B2) are the lesson: two arcs cross twice, confirm every corner with a third distance or a diagonal. The house **1.238 m further south** than V8.3 (B1 5.00 m from M1, the owner's car test at the gate); the set-out sheet takes the status from the tightest point on any wall (every edge sampled at 5 cm), not only the corners.
55. **The final position: a further 0.50 m south** (V9.0, owner, 6 Nov 2026; `studies/shift_south.typ`, 0.50 m adopted). The field readings (B2 2.40 m and the cut wall's tightest point 2.20–2.30 m to the boundary wall's inner face) showed the wall 0.6–0.7 m inside the deed line, so the day-1 position kept only 0.20–0.30 m from a setback counted from the wall; 0.50 m south is the smallest move that reaches the owner's 0.40 m target at both readings, within the ground the owner checked, for 7 m² of garden: **B1 5.49 m from M1**, the north strip 5.58 m deep at B1, the car bay 2.04 m off the north wall, the palms 5.99 / 7.14 m. Studied and *not adopted* (for the record): a rotation about B2 (`studies/rotation_b2.typ`), the three steps west / rotate / cut (`studies/placement_steps.typ`).
56. **The cut wall 0.12 m shorter** (V9.0, owner, 6 Nov 2026; option A of `studies/cut_wall.typ` at the precise field reading of **2.30 m**). The cut wall moved outwards, parallel: B2 (10.051, 0) → (10.188, 0), B3 (13.311, 6.0) → (13.311, 5.749), the cut 6.93 → **6.65 m** on the outer faces; the margin **0.42 m from the wall as built** (a 2 cm tape cushion over the 0.40 target; 0.32 m at the 2.20 reading) and **0.90 m from the deed setback line**; 0.14 m possible later. The maid room +0.42 m² (7.69 clear), the maid bath +0.25, the air tower and its HRV base +0.14, bedroom 1 +0.67; the cut-line columns C30–C32 and the RC wall W4 move with it, the tower beams B15 / R9 1.78 m, the roof's cut edge, the cornice and the attic's set-back follow. The second reading of that day (14.63 m to the string on the opposite side) does not match the model and is kept as a loose check only (`SITE_SETOUT.md` row 25).
57. **The whole-farm base v2** (V9.0; `tools/site_frame.py`, `data/site_v2.csv`, `studies/whole_farm.typ`). The owner's field check of 3 Oct 2026 in UTM is the source of truth for the site, converted into the design frame; `base.typ` asserts its literals against it; **the deed is the boundary authority** (20 corners, 7 737.7 m²). R and S are least-squares reference pegs (no longer ± 2 m helpers); C1 is 10 m further west than assumed; the well at (−4.63, 64.11). The old house and its annex were digitised from the deed's sketch (`data/deed_sketch.csv`, 7 corners, rms 1.36 m).
58. **The existing buildings: the owner's answers** (V9.0, 5 Nov 2026; `studies/site_plan.typ`, `studies/whole_farm.typ`). The old house (the old majlis inside it) west of the driveway as on the deed sketch; its covered parking (2 cars) south of it, west of the driveway, the car route gate → driveway → a right turn into it; the existing ground tank south of it near peg R (3.4 m from R, 8.4 m from the new house), the reserved tank beside it, the truck on the driveway, the supply pipe across the driveway at y 36.5 and under the guest path band to the utility room (27.8 m); the brief's south boxes (farm parking, tanks) withdrawn; nothing of the farm south of the build land. *Open:* where guests park; every position approximate until measured (`SITE_SETOUT.md` § 8).
59. **The septic serves both houses** (V9.0, owner, 5 Nov 2026). The existing septic outside the north wall near C1 serves the old house and takes the new house's drains: a chamber at every change of direction (a new chamber inside the wall at (−4.8, 1.7), the wall crossed 1.4 m west of the gate's post), the driveway crossed once at the gate; the east main 38.4 m, the west branch 19.3 m, the inlet at −1.24 on the assumed falls (≈ 0.84 m below the assumed ground at the gate). Its capacity for both houses, its inlet level and a pump if it is higher are for the engineer and the survey.
60. **Bedroom 1: the young children's room** (V9.0, owner). Bedroom 1, next to the master suite, is the room for very young children; they are bathed in the master suite's bathroom: no en-suite (option A kept); the family WC upstairs stays WC + basin; `studies/bedroom1_bath.typ` (B, B4) and `studies/bedroom1_ensuite.typ` (a simple shower room that works by the numbers, barely as a room) are *not adopted*. The V&V finding V-03 is closed.

61. **The final site position: B1 6.00 m from M1; the cut wall shortened again** (V9.1, owner, 8 Nov 2026). The owner's car test on site: a full forward turn from the gate into the north strip, without any manoeuvre, needs corner B1 exactly 6.00 m from M1 (the west face kept 0.785 m east of the M line): the house moved a further 0.5104 m south (the shift 0.91 / 6.0734; 2.248 m south of the V8.3 design position, 1.01 m south of the day-1 blocks). The move gave the cut wall 0.24 m of margin, so the cut wall moved outwards a further 0.24 m, parallel (B2 x 10.188 → 10.461, B3 y 5.749 → 5.245 on the centre lines; the outer cut 6.65 → **6.08 m**) and keeps **0.42 m from the wall as built** (the same 2 cm tape cushion at the 2.30 field reading; 0.32 at 2.20) and **0.91 m from the deed setback line**; B2 0.58 / 1.20 m. The maid room 8.41 m² clear (+0.72), the maid bath 3.68 (+0.44), bedroom 1 15.74 (+1.10), the air tower 1.78 m² on axes; the maid room's escape window and bedroom 1's second window slid north along the cut; the cut-line columns C30–C32, W4, B15 / R9 (2.05 m), the roof's cut, the attic line, the HRV base and the plant zone follow. The site re-checked edge-sampled (`studies/site_plan.typ`, 19 checks; `studies/setout.typ`): the swept path of a large SUV fits in one forward move (0.69 m to the house, 0.55 m to the gate posts); the parking bay on the turning line (1.68 m off the wall); the route to the old house 4.77 m at B1 (measured, it widens southwards); the driveway 3.95 m; palm 1 5.99 m, palm 2 6.97 m; the south garden ≈ 236 m²; the tanks 7.8 m from the house; the sewer's main 38.8 m with the septic's inlet still at −1.24 (assumed falls); the two soakaways moved to stay ≥ 5 m from the walls (the east one out of the narrow strip into the garden's east corner, the south one into the garden's deep west part). **Levels:** the ground falls slightly to the south; the owner accepts raising the house on a plinth: the finished floor, the plinth, the entrance steps or ramps, the courtyard and garden levels and the sewer falls are set from the official survey's levels.

62. **The new malqaf tower** (V9.3, owner, 8 Nov 2026; `studies/malqaf_tower.typ`, adopted: L1, head (c), 3.5 m, the flat Hijazi cornice). The old tower looked like a box on a box at the corner and its shaft made awkward corners inside. *Inside:* a slim shaft hugging the cut wall, 0.575 × 1.565 m clear = 0.90 m² (the breeze shaft 0.54, the HRV compartment 0.30, an airtight partition), behind one new 200 mm wall parallel to the cut with a square end wall, the tip a solid corner pier; the maid bath (3.04 m² clear) and bedroom 1 (15.10) each with one straight wall parallel to the cut; a store (0.56) off the maid bath and a cupboard (0.56) in bedroom 1 north of the y 1.0 partition; bedroom 1's first cut window slid 0.15 m south. *Cleaning without entry:* a 0.40 × 0.40 access panel at the shaft's foot from the maid bath, nothing into bedroom 1, a 0.50 m roof hatch in the tower's south face behind the attic (the top damper, the pre-filter), the bird-mesh frames lowered on cords to it, the shaft smooth-rendered. *Above the roof:* a 1.25 m square honey-stone tower on the attic's corner (1.0 m behind the north facade, 0.77 m behind the cut facade): a plain shaft, a cornice band, a head of 4 slender openings per face each with a small semicircular top, a flat two-step Hijazi cornice, its crown +12.18 (3.5 m above the attic coping); a low plenum behind the coping joins it to the shaft; no louvres. *The HRV* in a 1.6 × 1.4 m plant room behind the attic (top +8.60, never seen; doors on its south face), its exhaust low in the attic's cut wall 4.6 m from the intake on the tower's west face; the old wide base removed. *The breeze channel* at its full 0.90 m width under the maid bath (no throat): ≈ 1.37 × the V9.2 courtyard flow; **constraint for the bathrooms interior study: the maid bath's WC and shower drains stay off the channel's line.** *The location* (the study's pages 6–7): the corner kept against the courtyard corner, the west band and the kitchen: only service space taken, the cleanest intake, seen from the gate (3.3 m) and the street. *Structure (for the engineer):* the tower ≈ 71 kN, the wind ≈ 21 kN·m at the roof (assumed), on the roof slab over W3 with a ring beam.

63. **The malqaf moved to the courtyard's north-west corner (L5)** (V10.0, owner, 9 Nov 2026; `studies/malqaf_L5.typ`, a six-phase study, adopted: variant V-c, head F3; the fall-back F2 if the engineer refuses the beam additions; an *approved exception to the layout freeze*: the courtyard's covered strip, the riwaq and the gallery change). *Why:* the breeze at the seating is the goal (D1): the L5 outlet in the first arcade arch, ≈ 1 m from the seating with no channel, delivers ≈ 4 × the L1 system's flow in the same wind (≈ 1.8 m³/s at the summer-evening mean of 21 km/h, ≈ 0.5–0.8 m/s felt); the tower touches no bedroom (D10); all maintenance from a door at ground level; the core helps the structure; the symbol of the house seen from the courtyard where the family lives (not from the gate: accepted). *The core:* RC walls 0.20 from its own pad (≈ 2.4 × 3.0 × 0.6) to the head, inside the covered strip against the women's majlis's wall (rebuilt in RC): the GF foot chamber 1.2 × 1.97 m clear (the dust trap, a 0.8 × 0.7 × 0.3 GRP basin with a lift-out grating and a trapped gully; the filter cabinet + EC fan 750 m³/h + a 0.9 m silencer; the space for a mobile evaporative cooler, an option: a power point, the floor drain, the water point capped; IP44 sockets; a carved timber door 1.0 × 2.4 on the south face onto the strip), the breeze outlet 1.4 × 1.0 (+0.10 … +1.10) with adjustable timber louvres and the damper D2 in the first arcade arch; the FF shaft 1.2 × 0.8 clear (0.96 m²) at the gallery's end (the gallery's turn past bedroom 2's bath 1.5 m), a carved arched grille on its south face as a sealed provision; D1 at the shaft's head. *The head (F3):* 1.6 × 2.4 outer on the shaft and the gallery roof (its walls on R3 widened to 0.40 over y 6.5–8.8, on R11 and on the new beam R-L5 of 1.55 m), an RC frame (0.30 corner piers, ring beams at +10.6 and +12.9) with rendered block ribs, 3 / 5 slender arched slots per face (+11.2 … +12.6, free ≈ 0.83 / 1.38 m² per face), a 20 mm bird mesh in frames lowered on cords to a 0.5 m hatch in the west face, the + divider and four back-draught flaps, the band and the two-step Hijazi crown in the honey tone, the crown +13.20 (4.5 m above the attic coping); hidden from the gate and the north boundary by the north facade, seen whole from the courtyard seating. *Structure:* the core absorbs C17, C21 and the first arcade column (now structural) and becomes the fourth support of the west projection: B3 / B4 first spans 6.50 → 4.33 m; ≈ 595 kN on the pad; earthquake governs the head (all assumed, `studies/structure.typ` § 7, X18, X19). *Air (v4, `studies/air_system.typ`, `AIR_SYSTEM.md`):* two paths after the head: the large unfiltered breeze (bird mesh only) and the small filtered supply (a never-closing inlet under the head's south overhang → a washable pre-filter + an ISO ePM1 ≥ 50 % filter → the fan → the silencer → a Ø250 riser → high grilles into the family living, the gallery, the riwaq and the women's majlis; the house at a slight positive pressure); *no HRV*; the kitchen hood's interlocked make-up inlet mandatory; the west stack's vent re-routed in the attic to the south-east strip. *Controls (owner): simple:* two wall switches (MALQAF open / closed; HOUSE FAN normal / boost) and one outdoor dust-sensor relay that closes D1 and D2 above 50 µg/m³; every damper spring-return; no controller, no modes. *The rooms:* the courtyard an L-shape (27.19 m² on axes), the riwaq's first glass panel the core's solid face with a built-in bench, the women's majlis's small 0.5 m courtyard panel lost, W1-1 a blind arch, the gallery less the shaft; the L1 tower, its HRV plant room, plenum and the breeze channel under the maid bath removed; the north-east corner back to its V9.1 rooms with straight walls: the maid bath (3.77 m² clear), the maid's store the whole cut tip (1.78 m² on axes), bedroom 1 taking the tip (19.43 m² on axes, no slanted inner wall, a north window). *Record:* `studies/malqaf_L5.typ` (adopted), `studies/malqaf_tower.typ` (L1, superseded), `studies/ne_corner.typ`; the renders `3d/output/char_court.png`, `char_gate.png`, `char_aerial_sw.png`.

64. **No stone anywhere; porcelain floors** (V10.0, owner, 9 Nov 2026; `DESIGN_LANGUAGE.md`). No stone and no stone cladding on the exterior (the malqaf included): every exterior finish is render and paint (a light sand render; the projections, the bands, the cornices, the plinth, the quoins, the colonnade's sleeves and the arcade's columns formed in block and concrete and rendered in a calm honey tone), the character from the window proportions, the arches, the depth of the recesses and the projections; plaster mesh over every block / concrete junction, drips and falls on every projection. No stone and no marble on any floor: a marble-look porcelain inside, an outdoor anti-slip porcelain (R11) in a sand / honey tone outside (the courtyard, the colonnade, the riwaq, the paths, the guest path). **Every "honey stone", "stone" or "marble" in the decisions above reads as the same form in render, or as this porcelain.** The 3D palette follows (`3d/character.yaml`: `honey`, `sand`, `porcelain`).

## 5. Layout freeze (V9.0)

From V9.0 the layout is frozen: a change to anything in the first list needs a new owner decision recorded in `data/decisions.csv` and a new version. **One approved exception (V10.0, owner, 9 Nov 2026): the malqaf at L5** (§ 4.63): the courtyard's covered strip, the riwaq's first panel and the gallery's north end changed for the malqaf core; the north-east corner went back to its V9.1 rooms. The freeze continues from V10.0.

**Frozen:**
- **The room positions and sizes** of both floors as in `data/rooms_gf.csv` and `data/rooms_ff.csv` (§3), the outline with the shortened cut wall, the west projection and its three columns, the courtyard and its enclosure, the double-height living, the suite court.
- **The stairs and the lift:** the flipped main stair (V8.2), its headroom, the lift shaft's place (its size waits for the supplier), the roof ladder in the suite court.
- **The wet-room positions:** the two clusters (west round the shaft: the powder room, the guest WC and basins, the hospitality kitchen, the utility room; bedroom 2's en-suite, the family WC, bedroom 3's bath upstairs; east along the east wall: the kitchen, the laundry, the maid bath; the suite bath, the suite WC upstairs), the east stack outside the east wall, no ground-floor shower, no en-suite for bedroom 1.
- **The site position (V9.1):** the shift (0.91, 6.0734), B1 6.00 m from M1, square to the M line, the cut wall 6.08 m (0.42 m from the wall as built), the set-out tapes of `SITE_SETOUT.md` § 4. The levels (the finished floor, the plinth, the entrance steps or ramps) are not frozen: they come from the official survey.

**May still change:**
- **The suite bathroom's drainage approach** (a: every drain in the depressed slab / b: the east service wall) and the utility room's fit-out.
- **The water system:** the tankers, the ground tanks, a roof tank, the pumps, the greywater lines to the south garden with diversion chambers.
- **The bathroom interiors** (fixtures, finishes, lighting, the vanities).
- **The facades and the details** (R-37: the walls to open, the window sizes and heights within the rooms' walls, the mashrabiya, the finishes (render and paint, porcelain: no stone, § 4.64), the acoustics; the facade study in three stages, open items 20, 21).
- **The engineers' results:** the structure (X5, X21, the edge beam, the soil), the MEP sizing (the malqaf's filtered fan and dampers, the heating, the plumbing), the lift supplier's shaft: a structural size may move a wall face by centimetres, not a room.
- **The official survey:** if it moves the deed line or the wall, the house moves as a whole (the shift), never room by room.

## 6. Construction notes

The construction and detail notes (structure, the edge beam and columns, the gym's acoustic separation, the suite court's low thresholds, drainage, joinery, doors) are in **`docs/DETAILS.md`**.

## 7. Changelog

| Version | Date | What changed |
|---|---|---|
| V1–V2 (C1) | before 11 Oct 2026 | Early concept: 6 × 5 m courtyard, west service band, men's majlis 10 × 5.5 m (`archive/rooms_C1.csv`). |
| V3.0 | 11 Oct 2026 | Compact courtyard house on site option Z3; services in a utility room; one living room with two heights. |
| V3.1 | 15 Oct 2026 | Site option Z4; one west wash block with the two-door serving passage; the east service block; `pts` column for non-rectangular rooms. |
| V3.2 | 16 Oct 2026 | Slope to y 6.0 and width 13.311 m; building 0.26 m east (west face 0.785 m from the M line); middle band 4.50 m clear; living low partition. |
| V3.3 | 16 Oct 2026 | Building 0.5 m longer south; future lift placeholder; hospitality kitchen; serving passage 1.4 m; trough basins; foyer double door and majlis opening. |
| V3.4 | 16 Oct 2026 | Smaller air tower (1.0 m deep); the freed space to the maid wing. |
| V4.0 | 16 Oct 2026 | Ground floor final: maid bath 1.8 m, maid room ≈ 6.0 m² clear accepted; repo cleaned. |
| V4.1 | 17 Oct 2026 | First-floor baseline: zoning (suite east, children west, family living north) and the first room layout. |
| V5.0 | 20 Oct 2026 | First floor designed room by room; ground floor coordinated (east duct removed, three columns for a 1.35 m inward projection); first presentation set. |
| V5.1 | 24 Oct 2026 | Split west projection accepted (M-line approval pending, no columns); L-shaped gym rejected; treadmill at the gym's west end. |
| V6.0 | 24 Oct 2026 | Clean release: everything labelled V6.0; A3 presentation with 10 sheets; first-floor DXF; master document and open-items list; extended checks. No design change. |
| V6.1 | 24 Oct 2026 | Split projection reverted to the V5.0 columns solution: the full 1.35 m inward projection on an edge beam and three columns at x 5.6. |
| V6.2 | 24 Oct 2026 | L-shaped gym with the treadmill arm at the east end (owner's choice), with acoustic separation; suite court 11.97 m². |
| 3D phases 1–3 | 24 Oct 2026 | 3D model generated from the CSVs (`3d/`), doors and windows, the stair, the colonnade zone, viewer and checks; tags `3d-p2`, `3d-p3`. |
| Structural study | 24 Oct 2026 | `studies/structure.typ` / `docs/STRUCTURE_STUDY.md` (tags `struct-p1`, `struct-p1b`): column grid, beams, slabs, items for the engineer; every size assumed. |
| Air system studies | 24 Oct 2026 | Tags `air-p1` (a walk-in tunnel with a water channel) and `air-p2` (a dry malqaf with a small duct): both withdrawn by the V8.0 concept (§4.33). |
| 3D character | 28 Oct 2026 | `3d/character.yaml` (tags `3d-char1`, `3d-char2`): the style study. |
| Design review | 30 Oct 2026 | `docs/REQUIREMENTS.md` and `docs/review/design_review.typ` → `output/Design_Review_V6.pdf` (tag `review-1`): 55 findings, 3 critical. |
| V6.3 | 30 Oct 2026 | Quick fixes from the design review (§4.23). |
| V7.0 | 31 Oct 2026 | Courtyard enclosure (option A), maid room to the municipal minimum, roof access with the main stair and the stair room, the set-back attic and the main cornice, the design language; the roof study, the enclosure study, the review status; the 3D; a roof DXF. |
| V7.1 | 31 Oct 2026 | Arched courtyard enclosure windows and the three-arch courtyard arcade. |
| V8.0 | 1 Nov 2026 | **Fire safety (home level), courtyard layout, air system (one tower: courtyard breeze + HRV intake), external stair tower (office visitors and roof access; internal roof stair removed), south wing v2 (gym west, large suite court, office east), maid room and kitchen window changes.** In detail, folded from `PENDING_CHANGES.md`: the fire study (review E-08) and the owner's home-level decision applied (alarm marks on both plans, the bedroom windows without fixed mashrabiya, the maid window as an escape casement at +1.10; R-33 without the safe room, R-36); the courtyard layout study and decisions (the seating one step down, the TV wall with the stone surround and the grille below it, the north enclosure, no pergola, the drainage section); the kitchen sink window to y 7.3–8.9; the air system v3 / v3.1 (`studies/air_system.typ`, `AIR_SYSTEM.md`: one tower, two paths, the shallow channel, the assist fan, bird mesh, the HRV base, the condensers south, the make-up inlet; structure note X19); the south wing study (`studies/south_wing.typ`), its first application (an L gym, a 2.5 m court) and the v2 adopted (the gym west, a 25 m² court, the office east; the sight-line test and the entry wardrobe; the court's south side compared); the external stair tower, the internal stair stopped at the first floor, the roof study rewritten (no stair room, a plain-pentagon attic, PV on the gym and office roofs, walkways from the tower), the outdoor kitchen and the service gate; the structure (B19 / B20 / B21 / B22, R6 removed, R8 as the court's frame, R19–R21, X4 superseded, X5 revised and improved, not verified, X16, X19); the fire route via the court not counted while the clerestories are openable glass; the 3D builder brought up to date (the stair tower, the HRV base, the three-face malqaf head, the courtyard layout, the suite court with its base and frame, no stair room, the attic door-head fix) and five renders; the presentation rebuilt (12 sheets), the DXFs regenerated, the review status `Design_Review_status_V8.pdf`. Two check failures fixed on the way (the east wing study's label, the decisions sheet's overflow). |
| V8.1 | 1 Nov 2026 | **V8.1: external stair tower removed (office visitors met in the men's majlis; the office reached from the suite court only); roof access by a maintenance ladder in a recess of the gym's east wall in the suite court; roofline lowered and balanced (attic 1.40 m, south-wing parapet 0.70 m with a set-back 1.10 m guardrail); lane service gate dropped (the farm's single 4 m main gate is the only entry); outdoor kitchen relocated; fire study updated (main stair + escape windows).** In detail, folded from `PENDING_CHANGES.md`: the external stair tower, its gates, landings, roof door and the office's visitors' door removed; the office from the suite court only with simple doors and a 0.90 east window, the suite bedroom's escape window restored to y 15.0–18.6; the maintenance ladder in a recess of a stone pilaster on the gym's east wall (one enlarged plan and section in `studies/roof.typ` page 2; X20 in `studies/structure.typ`); the attic 1.40 m (+8.70), the south parapet 0.70 m (+8.00) with the 1.10 m guardrail set back 1.0 m, the walkways and the PV re-planned, a no-gap check of the guarding; the outdoor kitchen relocated (the counter at the east wall, the grill apart), the lane service gate dropped; the fire study (one stair + the escape windows, the court a fresh-air area, not an exit); the 3D (the ladder, the panel, the stiles, the gate, the set-back guardrail, the outdoor kitchen; three renders), the DXFs, the presentation, the review status V8.1. *Study only at V8.1:* the stair flip (`studies/stair_flip.typ`, recommendation: flip with conditions; adopted in V8.2). |

| V8.2 | 3 Nov 2026 | **V8.2: stair flipped (option B), larger family bath F-b, coat cupboard and lobby; bedroom 1 without a private bath (night lights); ground-floor shower deferred to the plumbing study (P1 preferred); suite court's south side a mashrabiya; clerestories openable; food route accepted; site and services plan (single 4 m gate, optional north parking kept, guest stone path, south family garden, service yard and gas cabinet, existing water tank + reserved tank, existing septic near C1, PV provision without a generator, intercom and cameras); plumbing study rounds 1–2 (proposals).** In detail, folded from `PENDING_CHANGES.md`: the stair flip applied (`studies/structure.typ` `st` with its direction, B16′–B18′, X15; the 3D's direction-aware stair; `studies/ff_family.typ`, `studies/fire_escape.typ`, the plans' alarm marks), the family bath F-b with its WC compartment (`data/rooms_ff.csv`: the landing row removed), the lobby and the coat cupboard (`data/rooms_gf.csv`: the entry cupboard row removed; `design_gf.typ` inner boxes), the riwaq balustrade and the store door, the half-landing window and the entrance side light; the stair flip study marked adopted; the studies bedroom 1's bath (A adopted) and the ground-floor shower (deferred, P1 preferred); the food route accepted (X-01); the owner's decisions recorded (bedroom 1 A with night lights, the GF shower deferred, the court's mashrabiya, the clerestories openable); the site and services plan (`studies/site_plan.typ`, 5 pages, 14 checks) with the owner's corrections (the parking kept with the swept path; the septic outside the wall near C1 and the tank east of peg R; the drains rerouted north with the inverts computed; the rain separate; the inverter and batteries in the utility room); the plumbing study rounds 1–2 (`studies/plumbing.typ`, 11 pages, 16 checks; proposals); the 3D (the flipped stair with its balustrade, the coat cupboard, the larger family bath, the suite court's mashrabiya screen, the site elements the builder supports; three renders: `char_lobby.png`, `char_court_screen.png`, `char_aerial_sw.png`), the presentation (sheet 01 the site plan, the stair, the decisions), the DXFs V8.2, the review status V8.2. The plumbing recommendations stay proposals. |

| **V8.3** | **3 Nov 2026** | **V8.3: bedroom 2 en-suite and family WC upstairs; ground-floor powder room (no ground-floor shower); level courtyard with movable seating, the fountain and tree in front of the kitchen window, the TV moved south; outdoor kitchen by the service door; plumbing decisions (external east stack, trap primers, rain / sewage separate); facade principle R-37; bedroom 1 hotel en-suite studied, not applied.** In detail, folded from `PENDING_CHANGES.md`: bedroom 1's B4 studied in three variants (page 3 of its study, not applied); the F-b bath split into bedroom 2's en-suite and the family WC on one service wall (`data/rooms_ff.csv`, `studies/ff_family.typ`, `studies/sections.typ`, `studies/fire_escape.typ`, X21, the 3D open edges); the plumbing decisions recorded; the courtyard revised (`studies/courtyard_layout.typ` rewritten; the 3D builder and checker rewritten; `studies/air_system.typ` grille +0.10 … +0.45; `design_gf.typ` marks); the outdoor kitchen by the service door and the yard re-planned (`studies/site_plan.typ` 16 checks, `design_gf.typ`, `3d/params.yaml`, the 3D site elements; no leftover stair-tower element); the facade principle (R-37, the design language) with the list of walls to open at the facade stage: (1) the women's majlis north window → a wide north window without a screen; (2) the kids' room north window → full height / wider; (3) a north-light clerestory over the kids' room for the family living (no outer wall of its own); (4) the dining east window → clear glass; (5) the suite lobby / dressing east windows → larger; (6) the office's east window → larger; (7) the men's majlis high south windows → lower sills for the garden; (8) the west guest-side windows keep their privacy (the owner's choice), bedrooms 2 and 3's escape windows as they are, the maid wing's cut-wall windows as they are (the lane is outside the farm wall); the workers' route proposed along the farm's boundary wall; no ground-floor shower and the powder room (`data/rooms_gf.csv`, `studies/guest_wing.typ`, `design_gf.typ`, `presentation.typ` doors, the 3D open edges); the decisions 47–53; the 3D model (two renders: `char_living.png`, `char_lobby.png`), the presentation V8.3 (12 sheets; the decisions table at 4.0 pt), the DXFs V8.3, the review status V8.3. |

| V9.0 | 6 Nov 2026 | **V9.0 Layout freeze: site set out on site (day 1, diagonals exact) and final position (1.24 + 0.50 m south, B1 5.49 m from M1); cut wall shortened 0.12 m (field 2.30 m; margin 0.42 m from the wall as built, 0.90 m from the deed); whole-farm base v2 (the deed is the boundary authority), the old house with its majlis, the covered parking, the water tanks and the septic placed; stair flipped; bedroom 2 en-suite, family WC upstairs, ground-floor powder room; bedroom 1 for young children without en-suite; level courtyard with movable seating, the fountain and tree at the kitchen window; outdoor kitchen by the service door; plumbing decisions (external east stack, trap primers, rain / sewage separate); facade principle (walled private farm).** In detail, folded from `PENDING_CHANGES.md` (23 entries, 4–6 Nov 2026): the field instructions and the set-out sheet (`docs/SITE_SETOUT.md`, `studies/setout.typ`, the status from the tightest point on any wall; `studies/site_test.typ` superseded); the field results of day 1 with the four corrections and the method warning; the house 1.238 m south (the shift 5.063, every house-attached site element moved with it); the site base v2 (`tools/site_frame.py`, `data/site_v2.csv`, `base.typ` asserts it; R, S, C1, the well); the whole farm (`studies/whole_farm.typ`, the deed sketch digitised); the field sheet § 8 for the old house, the carport and the tank; the owner's answers on the existing buildings and the septic (the route with a chamber at every bend, the inlet −1.24); the field readings B2 2.40 m and B1 4.77 m (rows 23–24), the tightest point 2.20–2.30 m (row 18) and its precise re-measure 2.30 / 14.63 (row 25); the studies `rotation_b2`, `placement_steps`, `shift_south`, `cut_wall`, `bedroom1_ensuite` (for the record); the 0.50 m south adopted (the shift 5.563, every site literal, the set-out sheet re-issued); the cut wall 0.12 m further out (the outline, the rooms, the structure, the roof, the air tower, the windows on the cut, the 3D data); bedroom 1 the young children's room (§4.60); the layout freeze (§5); the 3D brought up to date (the final position, the shortened cut wall, the existing farm round the house: the old house, its annex, the covered parking, the tank, the septic, the walls and the gate, the two palms; four renders: `char_aerial_sw.png`, `char_gate.png`, `char_living.png`, `char_court_screen.png`); the presentation V9.0 (sheet 01 the site position and the farm, sheet 03 the bands, sheet 09 every decision, sheet 10 the open items); the DXFs V9.0; the review status V9.0 (the V6 review and the interim V&V review of V8.3); the V8.x outputs to `archive/`; `design_gf.typ`'s env-gap measured to the setback lines only (the M line has no setback; at the final position it had returned the west face's 0.785 m). |
| V9.1 | 8 Nov 2026 | **V9.1: final site position, B1 6.00 m from M1 (car test); cut wall shortened again to 0.42 m from the wall as built; set-out sheet re-issued; site items updated; levels to be set from the survey.** In detail, folded from `PENDING_CHANGES.md`: the house a further 0.5104 m south (the shift 0.91 / 6.0734; every house-attached item of the site plan and the 3D site data moved with it); the cut wall a further 0.24 m out (the outline, the tower, the HRV base, the maid room, the maid bath, bedroom 1 and their windows, C30–C32, W4, B15 / R9, the roof's cut, the attic line and the plant zone, the room CSVs, the east wing, the family part, the suite, the plumbing, the fire and the shower studies); the record studies (the cut wall study, bedroom 1's en-suite study) kept at their V9.0 geometry; the set-out sheet and `SITE_SETOUT.md` §§ 4, 5, 7 (the third set-out); the site re-checked: the swept path of the design car drawn (one forward move, the gate now governs), the parking bay on the turning line, the soakaways moved (≥ 5 m from the walls), the garden, the palms, the tanks, the sewer, the guest path; the levels note (`SITE_SETOUT.md` § 9, open item 18); the roof study's sight line from the north boundary updated to the new distance (6.09 m, was 3.8 at V8.3: the attic coping's top edge now shows ≈ 7 mm above the cornice line from there; the condensers and the tank stay hidden from every distance); the site plan's pages fitted again; the decision row; the review status V9.1 (S-01, S-03, S-08, V-01, V-06, V-07); the 3D (the new position, the shorter cut wall; one render: the aerial from the south-west); the presentation V9.1 (12 sheets, checked sheet by sheet), the DXFs V9.1; the V9.0 set archived. |
| V9.2 | 8 Nov 2026 | **V9.2: small fixes: utility room label, air tower back to ≈ 0.90 m² (rooms gain), attic hidden.** In detail, folded from `PENDING_CHANGES.md`: the utility room G13 labelled on the presentation's plans and the low store door under the stair's half landing labelled "store"; the air tower a rectangle 8.95–10.375 × 0–1.0 on axes (1.43 m², was the whole cut tip 1.78 m²), 1.20 × 0.75 = 0.90 m² clear (the breeze shaft 0.54, the partition, the HRV intake compartment 0.28), its east face a new 200 mm wall on x 10.375, the head still +9.80, the 3D shaft opening 0.98 m²; the wedge between it and the cut wall to the maid bath (a shelf niche, 3.68 → 3.85 m² clear) and bedroom 1 (a shelf cupboard, 15.74 → 15.91 m² clear); the maid room does not touch the tower (8.41 m², unchanged); the HRV base kept to its V9.0 footprint (5.84 m², was 6.49); B15 / R9 1.43 m and the structure note; the east wing study's overlap test for the non-convex maid bath; the attic 2 cm lower (1.38 m above the finish, coping +8.68): hidden again from the north boundary (13 mm below the cornice's sight line, was 7 mm above), the condensers and the tank still hidden, the roof check back to "hidden"; the presentation V9.2 (12 sheets, checked), the DXFs V9.2, the 3D rebuilt (no new renders); the V9.1 presentation, DXFs and model archived. |
| V9.3 | 8 Nov 2026 | **V9.3: the new malqaf tower (north-east corner, slim shaft with straight room walls, head of slender arched openings 3.5 m above the attic, Hijazi cornice, honey stone; the HRV in a hidden plant room; the breeze channel at full width).** In detail, folded from `PENDING_CHANGES.md`: the slim shaft (0.575 × 1.565 m clear = 0.90 m²) behind one new wall parallel to the cut, the square end wall and the corner pier; the maid bath (3.04 m² clear) and bedroom 1 (15.10) with straight walls, the new maid store (G21, 0.56) and bedroom 1's cupboard (F20, 0.56), the bath's fixtures and the bed re-placed, bedroom 1's first cut window 0.15 m south; the access panel, the roof hatch, the mesh frames on cords; the 1.25 m honey-stone tower on the attic's corner (head (c), +12.18, the Hijazi cornice), the plenum; the HRV plant room behind the attic (1.6 × 1.4, top +8.60), the old base removed, the walkways; the channel at full width (≈ 1.37 × V9.2's flow) and the drains' constraint for the bathrooms study; the structure notes; the 3D (the tower, the plant room, the north-east aerial, the viewer's +10 m clip lifted; renders: the gate and the north-east aerial); the malqaf study marked adopted; the presentation V9.3, the DXFs V9.3; the V9.2 set archived. |
| **V10.0** | **9 Nov 2026** | **V10.0: the malqaf moved to the courtyard's north-west corner (L5): breeze at the seating ≈ 4× L1, foot chamber with dust trap, filters, fan and cooler space, head F3 on the first bay's axis, the core as the fourth support of the west projection; the HRV replaced by a filtered supply fan; the north-east corner restored; no stone anywhere (render and paint; porcelain floors); simple controls (two switches and a dust relay).** In detail, folded from `PENDING_CHANGES.md`: the six-phase L5 study (`studies/malqaf_L5.typ`: the climate basis from the public station records, three variants, the structure, the facade, the air system and the controls simplified by the owner, the head F3, the decision sheet) and its renders on a copy of the model; the north-east corner study; the no-stone and porcelain decisions; the adoption: the room data (the courtyard L-shape, the riwaq's sliver, the gallery less the shaft, the maid bath and the store back to V9.1, bedroom 1 with the tip), `design_gf.typ` (`tower-csv`, the door and the outlet), the FF studies, the east wing, the plumbing (the gully to the west run, the vent re-routed), the roof (the head 1.6 × 2.4, no plant room, the guard from the head's corner, the hatch, the elevations), the structure (the core, C17 / C21 / the arcade column absorbed, B3 / B4 4.33 + 6.25, R3 widened, R-L5, B15 / R9 removed), `studies/air_system.typ` v4, the courtyard layout study (the outlet in the west arcade), the presentation (the malqaf door, the outlet, the blind arch, the texts, render and porcelain), the 3D (the core, the head as a frame with dark slots, the trap, the fan cabinet, the cooler mark, the louvres and the open door; the blind arch; the palette `honey` / `sand` / `porcelain`; the `court` bookmark; the checks rewritten), the DXFs; the L5 study marked adopted, the L1 study superseded; open items 9 and 22; the V9.3 set and the V9.1 review status archived. |

Earlier documents (the ground-floor V4 description, the first-floor brief, the decisions log, the construction notes, the split-projection study and the V8 and V9 master documents `PROJECT_V8.md`, `PROJECT_V9.md`) are in `archive/docs/`. Every version is a git tag (`v3.1` … `v10.0`); the branch `work` is reset to `main` after each release for the next round. The construction notes are in `docs/DETAILS.md`.
