ahl20006/House_git/taif_house/docs/README_DXF.md

# DXFs · Taif / Palm House V10.0 · ground floor, first floor and roof

*V10.0:* the malqaf core at the courtyard's north-west corner (the AIR-TOWER layer, from `tower-csv`), the L-shaped courtyard, the riwaq's sliver, the maid store in the whole cut tip, bedroom 1 with the tip (no cupboard), the gallery less the shaft; the malqaf head (1.6 × 2.4, +13.20) on the roof plan, no plant room. *V9.3:* the L1 slim shaft along the cut wall, the malqaf tower (1.25 square, +12.18) and the HRV plant room (superseded). *V9.2:* the air tower a rectangle (0.90 m² clear), the maid bath and bedroom 1 with the wedge beside it, the attic coping +8.68. *V9.1:* the house at its final site position (the shift 0.91 / 6.0734, B1 6.00 m from M1) with the cut wall a further 0.24 m out (6.08 m on the outer faces); the three DXFs are regenerated from the same files. *V9.0 (layout freeze):* B1 5.49 m, the cut wall 0.12 m out.

Two DXFs for anyone working in CAD (AutoCAD, BricsCAD, DraftSight, LibreCAD, QCAD …), one per floor. Both are in the same coordinate frame, so they overlay exactly.

| File | Shows | Same plan as |
|---|---|---|
| `output/taif_ground_floor_V10.0.dxf` | the site, the ground-floor outline, every room, doors, windows and openings, special walls, the fixtures of both blocks, the first-floor edges above | `output/design_gf.pdf` |
| `output/taif_roof_V10.0.dxf` | the site, the roof outline, the north block / south wing line, the holes (courtyard sky, suite court, malqaf shaft), the attic line, the maintenance ladder's pilaster in the suite court and the set-back guardrails (V9.0), the lift shaft, the reserved zones, the outlets, the walkways, the guards and the attic doors (`tools/make_dxf_roof.py` from `studies/roof.typ`) |
| `output/taif_first_floor_V10.0.dxf` | the site, the first-floor outline (and the ground-floor outline dashed), every room with its number, the voids, the fixed elements, doors, windows, furniture | `output/design_ff.pdf` |

## Units and coordinates
- **Units:** metres (`$INSUNITS = 6`). Draw scale 1:1.
- **Origin:** (0, 0) = survey peg **M1** (east post of the gate).
- **Axes:** x is east, square to the M line; y runs along the M line. The Typst drawings count y southwards; the DXFs have y pointing **up** (north up), so a Typst point (x, y) is (x, −y) in the DXF.
- **The building** sits on site option **Z4**, shifted (0.91, 3.825) from the room coordinates (V6.3: 0.30 m further south than before, provisional until the survey) in `data/rooms_*.csv`, with rotation 0°:
  - **ground floor:** a pentagon 13.311 × 24.0 m on wall centre lines (13.561 × 24.25 outside), its north-east corner cut along the lane down to y 6.0;
  - **first floor:** the same outline (the first-floor walls stand on the ground-floor walls); the 1.55 m west projection over the courtyard and the void (V9.0) is carried by an edge beam on x 5.6 and three columns.
- **Walls:** room outlines are on **wall centre lines**; wall thickness is not drawn. Clear sizes (`docs/PROJECT_V6.md`) assume 250 mm outer, 200 mm inner and 100 mm dry partition walls.
- **Extended data:** every room polyline carries its name and area as extended data (application `HOUSE`), so a CAD user can list them. The first-floor room labels carry the room numbers F01–F21.

## Layers
**Ground floor:**
| Layer | What is on it |
|---|---|
| SITE-LAND / -ENVELOPE / -DRIVEWAY / -LANE / -SOUTH | plot, buildable envelope, driveway, lane and north wall, south line |
| SITE-PALMS · SITE-PEGS | palm trunks (r 0.265) and 1 m circles · survey pegs M1–M4 |
| BUILDING-OUTLINE · COURTYARD | ground-floor outline · courtyard, open to the sky |
| ROOMS-FAMILY / -GUEST / -SERVICE / -CIRC / -CORE · ROOM-LABELS | one closed polyline per room, by use · name and area |
| AIR-TOWER | the malqaf core at the courtyard's north-west corner (V10.0, L5) |
| DOORS · OPENINGS · WINDOWS · WALLS-SPECIAL | doors · openings without a door · windows · solid wall to the women's majlis, kitchen / basins wall, WC screen wall, family / guest line |
| FIXTURES | east block: counters, machines, bed, wardrobe, shower, WC, basin · west block: hospitality counter, basin counter, trough, shoe cabinet |
| MARKS | service shaft, under-stair store, the three columns, the living's ceiling-height change, the first-floor edge beam above (x 5.8) |
| ENTRIES · ANNOTATION | family and guest entry arrows · title, north arrow, scale bar |

**First floor:**
| Layer | What is on it |
|---|---|
| SITE-* | as on the ground floor |
| BUILDING-OUTLINE · GF-OUTLINE | first-floor outline · ground-floor outline below (dashed) |
| VOIDS | the courtyard (open to the sky) and the double-height living (no floor) |
| ROOMS-FAMILY / -GUEST (master suite) / -SERVICE / -CIRC / -OPEN (suite court) / -GYM / -CORE · ROOM-LABELS | one closed polyline per room · number, name and area |
| DOORS · OPENINGS · WINDOWS | hinged doors · sliding doors and openings · windows |
| FURNITURE | furniture and fixtures from the two first-floor studies, including the treadmill on the gym's west band and the suite court's seating (V9.0) |
| MARKS | the edge beam of the west projection (x 5.8) and the three columns below it |
| ANNOTATION | title, scale bar |

## How to regenerate
```
pip install ezdxf
python taif_house/tools/make_dxf.py       # ground floor
python taif_house/tools/make_dxf_ff.py    # first floor (needs typst on PATH)
python taif_house/tools/make_dxf_roof.py  # roof (needs typst on PATH; reads the <roof-data> metadata of studies/roof.typ)
```
- **`make_dxf.py`** reads:
  - `base.typ` (site);
  - `design_gf.typ` (shift, rotation, outline, the malqaf core, marks, door and window lines);
  - `data/rooms_gf.csv`;
  - `studies/east_wing.typ` and `studies/guest_wing.typ` (fixtures).
- **`make_dxf_ff.py`** reads the `<ff-data>` metadata of `design_ff.typ` with `typst eval`. That is the rooms of `data/rooms_ff.csv` already placed on the site, plus the doors, windows and furniture of the two first-floor studies.

Nothing is typed in twice: change the design there, then run the scripts again.

## How to check
```
python taif_house/tools/check.py
```
It rebuilds both DXFs and checks that every room in each DXF has the same area as its CSV. It must end with **ALL CHECKS PASSED**.

## Limits
These are concept drawings: wall centre lines, no wall thickness, no dimensions, no levels. Ground-floor doors and windows outside the two studied blocks are not in the DXF; the presentation shows them as indicative.
