ahl20006/House_git/taif_house/docs/notes.md

# Taif / Palm House · decisions log

The current version is **V5.1** (24 Oct 2026, git tag `v5.1`). The ground floor is described in full in **`docs/GROUND_FLOOR_V4.md`** (with its V5.0 and V5.1 changes); the first floor in **`docs/FIRST_FLOOR_BRIEF.md`** (V5.1 section); construction notes in **`docs/DETAILS.md`**. This file is the running log: what was decided, version by version (newest first). Older sections keep the file names and sizes of their time.

## Files and how to check
- `design_gf.typ` + `data/rooms_gf.csv`: the ground floor (plan, schedules, philosophy). `design_ff.typ` + `data/rooms_ff.csv`: the whole first floor (plan, schedule, light check). Both use the site in `base.typ`.
- `data/rooms_*.csv`: one row per room (name, x, y, w, d, angle, frame, colour, pts). `#` at the start of a name switches a row off. `pts` ("x y; x y; …") is only for rooms that are not rectangles.
- `studies/guest_wing.typ` (west wash block), `studies/east_wing.typ` (east service block): ground-floor studies. `studies/ff_family.typ` (first floor part 1: family part) and `studies/ff_suite.typ` (part 2: owner's office, gym, suite court, master suite): the first-floor design with furniture, doors, drains and checks; `design_ff.typ` checks that `data/rooms_ff.csv` matches them room for room. `studies/site_test.typ` + `studies/building.csv`: the footprint against the site.
- `tools/check.py` compiles everything into `output/`, cross-checks the studies and the CSV and rebuilds the DXF (`output/taif_ground_floor_V5.1.dxf`, see `docs/README_DXF.md`); it must end with "ALL CHECKS PASSED". `tools/schedule.py` prints the room schedule (axes and clear areas).
- Versions on GitHub: tags `v3.1` … `v3.4`, `v4.0` (ground floor final), `v4.1` (first-floor baseline), `v5.0` (first floor designed, ground floor coordinated) and **`v5.1`** (split west projection, rectangular gym); GitHub Releases up to V5.0; superseded files are in `archive/`.

## Changes in V5.1 (24 Oct 2026 · git tag `v5.1`)
Two study branches, two owner decisions:
- **Split west projection: accepted** (branch `v5-split-projection`, merged; record `docs/VARIANT_SP.md`, comparison on `design_ff.pdf` page 5 and presentation sheet 07).
  - The V5.0 1.35 m projection over the courtyard and the double-height void is split: **0.675 m inward** (x 4.25–4.925, a plain cantilever carrying only the gallery and its railing, **no columns**: the three V5.0 columns at x 5.6 are removed from both floors) and **0.675 m outward** beyond the ground-floor west wall (x 0 → −0.675, south of y 10.4; the first-floor west wall on cantilever beams). The whole west band moves 0.675 m west; stair, lift, landing and west shaft stay.
  - West rooms 4.25 m on axes (≈ 4.0 m clear); gallery ≈ 1.225 m clear; **courtyard sky opening 3.35 → 4.025 m on axes (≈ 3.825 m clear)**, the double-height void the same. The outward part shades the top of the ground-floor west wall from the afternoon sun and roofs the guest entrance.
  - **Condition (top open item, before construction drawings):** the first-floor west face is **0.11 m from the M line**. Municipality / engineering office to confirm that an upper-floor projection this close is allowed. **If not, go back to the V5.0 solution** (full 1.35 m inward projection on three columns at x 5.6, tag `v5.0`).
  - Forced changes, accepted: **family bath 2.075 m wide (≈ 3.74 m², was 4.95)** because the shaft is fixed; bedroom 2 wardrobe niche 1.5 → 2.175 m; gym 9.06 → 9.74 m and suite court 7.71 → 8.39 m (both 0.675 m longer); gallery 2.18 m wide at the stair top; west doors, windows and furniture 0.675 m west.
  - Engineer: the first-floor west wall on cantilever beams (beams, wall load, deflection); confirm the 0.675 m inward cantilever needs no columns.
- **L-shaped gym: rejected** (branch `v5-gym-L`, not merged, kept for reference; study `studies/ff_gym_L.typ` on that branch). A treadmill arm up the east end to the suite bedroom wall would have taken 3.45 m² from the suite court (15.42 → 11.97 m² on V5.0) and put the treadmill's noise and vibration against the master bedroom. The gym stays a rectangle along the south facade, not touching the suite bedroom; the suite court stays full size, open to the sky and private.
- **Treadmill at the gym's west end** (away from the master suite): 0.9 × 2.0 m, 0.5 m clear behind and on each side, dense rubber floor and anti-vibration pads. It runs along the gym's length (east–west): along the depth (north–south) it would fill 2.5 of the 2.525 m clear depth and block the way from the door, which is also at the west end. Then barbell + rack, kettlebells, pull-up bar, pilates mat, one cardio machine, and an optional bench at the east end; a 1.0 m walkway along the north wall (checked in `studies/ff_suite.typ`).
- **Files:** everything labelled V5.1; DXF renamed `taif_ground_floor_V5.1.dxf`; presentation `output/Taif_House_V5.1_presentation.pdf` (9 sheets: the 8 sheets + the split-projection comparison as the record of the decision); new `studies/sp_compare.typ`; the V5.0 presentation PDF stays in tag `v5.0` and its GitHub Release.

## V5.0 · first floor designed, ground floor coordinated (20 Oct 2026 · git tag `v5.0`)
- **First floor, family part** (`studies/ff_family.typ`):
  - north band: *kids' room (study + gaming)* 4.7 × 3.0 and the *family living* 4.7 × 3.5 on the courtyard edge, a view not a path (the way to the family link walks behind the sofa);
  - *west projection* 1.35 m over the courtyard and the double-height void (x 4.25–5.6) carrying the gallery; courtyard sky and void 4.70 → 3.35 m; three columns at x 5.6 (or a plain cantilever, engineer);
  - west band 4.25 m wide: *family bath* by the west shaft (bedrooms 1, 2, family living, kids' room), *bedroom 2* 4.25 × 3.4, *bedroom 3* with its *own bath* over the GF family WC;
  - *bedroom 1*: one room, no bath, its south wall straight on y 6.5 (the courtyard's north edge, on the GF kitchen wall);
  - the visitors' office upstairs is gone; the WC became the family bath; linen in the gallery's north cupboard.
- **First floor, the L** (`studies/ff_suite.typ`): *owner's office* 4.25 × 4.75 (west), *gym route*, *gym* 9.06 × 2.75 (sliding doors), the *suite court* 7.71 × 2.0 (the old light strip + terrace, walled on four sides, open to the sky, in front of the clerestory windows), and the *master suite* 55.6 m²: lobby 1.35 m (entered from the family link), *luxury bath* (freestanding tub, walk-in glass shower, double vanity, WC in its own closet), *luxury walk-in dressing*, bedroom with the king bed facing the court.
- **East duct removed:** kitchen extract straight through the east wall; vent stack and suite bath drain to a stack outside the east wall.
- **Ground floor V5.0** = V4.0 + the duct removal + the three projection columns (x 5.6, y 6.5 / 13.0 / 19.25). Nothing else moved.
- **Presentation:** `presentation.typ` → `output/Taif_House_V5.0_presentation.pdf`, 8 sheets for sharing (walls drawn with thickness, doors and fixtures, room IDs G01–G22 / F01–F21, Arabic notes); some ground-floor doors and windows outside the studied blocks are indicative.
- **Files:** `design_ff.typ` and `data/rooms_ff.csv` rebuilt for V5.0 (the V4.1 versions and `zones_ff.csv` are in `archive/`); DXF renamed `taif_ground_floor_V5.dxf`; `docs/DETAILS.md` started (construction notes); `tools/check.py` also compiles and checks the two first-floor studies.
- **Open:** engineer (projection, gym loads over the men's majlis, y 3.0 partition), MEP (east-wall stack, hood position), clerestory sill vs the court floor, daylight check of the narrower courtyard, bedroom 1 far from a bathroom (≈ 17 m).

## First floor V4.1 · baseline frozen (17 Oct 2026 · git tag `v4.1`)
- The coordinated revision is frozen as **First floor V4.1**, the baseline; the ground floor stays V4.0. No geometry changed.
- **Decisions:**
  - suite east (the lobby distributes to the bedroom, dressing and bathroom); children west around the shared bath; family living north at the stair top; office at the stair top; bedroom 1 + bath at the east duct;
  - men's majlis roof fully used: bedroom 3 (west), gym (middle), terrace (east), 2.0 m light strip in front of the two small clerestory windows, a railing (not a parapet) on the gym roof edge;
  - gym kept (≈ 16 m², small family gym; the engineer checks loads and vibration);
  - terrace kept (may be reduced later).
- Open items and review order: `docs/FIRST_FLOOR_BRIEF.md` (V4.1 section). Next session: `docs/NEXT_SESSION.md`.

## First floor · coordinated revision (17 Oct 2026)
- **Men's majlis roof now used:** bedroom 3 (west, 3.05 × 4.75 = 14.5 m²), gym (middle, 16.2 m²) behind a 2.0 m open light strip only as wide as the double-height living's south wall (9.4 m²), suite terrace (east, 20.7 m²).
- **Gym access:** a 1.2 m route from the end of the upper gallery (no bedroom, not the suite, not across the strip). This is why bedroom 3 is 3.05 m wide, not the 4.25 m asked for.
- **Clerestory:** two small windows 1.0 × 1.0 m (sill +5.00, head +6.00); the main light comes from the courtyard.
- **Light check:**
  - gym with a parapet: 0 % winter noon sun on the windows, 42 % sky;
  - gym with a railing: 81 % / 100 %;
  - proposal: a railing on the gym roof.
- **Suite:** the lobby now opens to the bedroom, dressing and bathroom; the bed is not visible from the suite door.
- **Family living:** seating 15.75 m² outside a 0.9 m route.
- **Office and bedroom 1:** office 10.6 m² (≈ 9.1 m² clear); bedroom 1 13.8 m² + bath 5.0 m² round the east duct.
- **Children's study** (4.5 m²) in the freed west-band piece.
- **Circulation:** 45.6 m² + 4.2 m² route in the family living.
- **Not committed:** waiting for the owner's comments.

## First floor · re-zoned layout (17 Oct 2026)
- **Re-zoned** as one move, instead of fixing option A room by room: master suite east · children together in the west around the west shaft · family living north at the stair top · office north · bedroom 1 + bath at the east duct · linen in gallery cupboards · gym deferred.
- **Results:**
  - bedroom 2 13.3 m², bedroom 3 17.6 m², shared bath 5.5 m², 1–2 m from both bedroom doors and stacked over the ground-floor wet strip;
  - family living 18.3 m²; office 12.2 m²; visitors' WC kept;
  - suite: lobby 3.5, bathroom 10.0, walk-through dressing 9.7, bedroom 32.1 m²;
  - circulation 38.5 m² (was ≈ 48).
- **Men's majlis roof:** no room on it; open roof 29.5 m² + terrace 20.7 m².
- **Light check** with clerestory size, sky view and reflection, three open-roof sizes compared: a 1.5 m strip blocks the winter sun; 3.5 m is the minimum; the full roof is proposed.
- **Open:** children's rooms 2.75 m wide; bedroom 1 small; walk-through dressing in the suite.
- **Not committed:** waiting for the owner's comments.

## First floor · first room layout from option A (17 Oct 2026)
- **Furnished test:** option A as zoned does not work. With bedrooms 2 + 3 over the women's majlis, bedroom 1 and the suite can only be reached through a bedroom.
- **Adjusted layout:**
  - a family gallery along the courtyard's north side, with a link to the suite door;
  - bedroom 2 north (14.6 m²); bedroom 3 south-west (20.2 m²);
  - family living 10.3 m² + the open gallery;
  - bedroom 1 11.7 + bath 4.0 m² over the maid wing;
  - master suite over the kitchen + dining (lobby / passage 7.8, bathroom 10.7, dressing 9.5, bedroom 27.3 m²) with a 20.7 m² terrace on the men's majlis roof (palm side);
  - office, visitors' WC, shared bath and linen store in the west band.
- **Gym deferred:** it can't be reached without crossing the open strip. The whole roof over the men's majlis middle stays open (22.3 m²).
- **Section:** a 1.5 m open strip with a room behind blocks the winter sun on the clerestory; ≈ 3.5 m would be needed, so keep the full roof open.
- **Plumbing rule corrected:** short sloped drain runs to the shaft / duct as coordination points. The suite bath drains in a sunken floor (not in the kitchen ceiling).
- **Not committed:** waiting for the owner's comments.

## First floor · programme and zoning options (17 Oct 2026)
- Programme and rules recorded in `docs/FIRST_FLOOR_BRIEF.md` §7–8.
  - Private suite: lobby, bedroom, dressing, bathroom, private terrace.
  - Family: bedroom 1 with bath; bedrooms 2 + 3 with a shared bath; family living; gym over the men's majlis.
  - Upper gallery.
  - Office and visitors' WC at the stair top.
  - No laundry upstairs.
- Key finding: with the plumbing rule (wet rooms only at the west shaft or the east duct), bedroom 1 + bath must go over the maid wing and the master suite over the kitchen, with their bathrooms back to back at the east duct; the visitors' WC and the shared bath go at the west shaft.
- Available first-floor area 225.6 m² on axes, programme ≈ 153.5 m² + gallery + terrace + open roof: almost no spare.
- Two zoning options drawn in `design_ff.typ` (zones in `data/zones_ff.csv`):
  - **A:** bedrooms 2 + 3 north, family living + gym south-west, suite with a large terrace over the men's majlis east.
  - **B:** family living north (the hub at the stair top), bedrooms 2 + 3 south-west, gym south-east, smaller suite and terrace.
- Waiting for the owner's choice before drawing rooms.

## Changes in V4.0 (16 Oct 2026 · ground floor final)
8. The 0.2 m freed by the smaller air tower goes to the maid bath, not the maid room:
   - Air tower unchanged from V3.4: 1.0 m deep, 1.37 m² on axes, ≈ 0.88 m² clear, at least ≈ 0.93 m wide.
   - Maid bath from the tower (y 1.0) to y 2.8, 1.8 m deep, up to the cut wall: 3.84 m² on axes, ≈ 3.03 m² clear.
   - Maid room and laundry back to V3.3: maid room y 2.8–6.5, 7.06 m² on axes, ≈ 6.04 m² clear; laundry 1.70 × 3.7, walkway ≈ 0.95 m.
   - Doors back to their V3.3 places: maid room → maid bath 0.70 m clear (the wall on the maid side is ≈ 0.73 m long, so it is tight: sliding or opening out); laundry → maid room at the north end of the partition. Bath vent window back to y 2.0–2.6.
   - **Decision:** the maid room stays at ≈ 6.0 m² clear; the 6.5 m² target is dropped (the sloped cut wall makes the north part too narrow).
- East duct (≈ 0.6 × 0.6 m) placed in the kitchen's north-east corner (CSV x 12.711–13.311, y 6.5–7.1), next to the hood and the outside wall; position to confirm with the MEP engineer.
- Repo cleaned and frozen as V4.0: folder `taif_house/` (was `concept_V3.0/`); `design_gf.typ`, `data/rooms_gf.csv`; `docs/`, `output/`, `archive/`; `tools/check.py`, `tools/schedule.py`; master document `docs/GROUND_FLOOR_V4.md`; first-floor starting point `design_ff.typ`, `data/rooms_ff.csv`, `docs/FIRST_FLOOR_BRIEF.md`. base.typ: only two text lines changed (comment and the empty-room message), no geometry.

## Changes in V3.4 (16 Oct 2026 · change 7)
7. Smaller air tower, the space goes to the maid wing:
   - Air tower 1.2 → 1.0 m deep (its south edge 0.2 m north), still bounded by the north wall, the cut wall and the solid wall to the women's majlis: 1.37 m² on axes, ≈ 0.88 m² clear, at least ≈ 0.93 m clear wide at its narrow north end (one person can step in to clean; main cleaning from a roof hatch).
   - Maid bath moved 0.2 m north, same 1.6 m depth (y 1.0–2.6), still up to the cut wall: 3.33 m² on axes, ≈ 2.57 m² clear (was ≈ 2.72: it sits where the slope is narrower). Door from the maid room now 0.60 m (sliding or opening out).
   - Maid room grew 0.2 m north (north wall on the bath's new south wall, y 2.6): 7.24 m² on axes, ≈ 6.18 m² clear (was ≈ 6.04; the 6.5 m² clear target is still not reached, because the added strip is the narrowest part of the slope). Bed 0.9 × 2.0 and wardrobe still fit; both maid doors stay at the north end.
   - Owner decision: the laundry also grows 0.2 m north (1.70 × 3.9, y 2.6–6.5) so no strip is left above it; the 100 mm partition just gets 0.2 m longer. Laundry ≈ 5.74 m² clear, walkway ≈ 0.95 m unchanged.
   - Unchanged: kitchen, exterior walls, the windows in the cut wall (the bath vent moved 0.2 m north with the bath), the access chain kitchen → laundry → maid room → maid bath.

## Changes in V3.3 (16 Oct 2026 · six owner changes on Revision 02)
6. Building 0.5 m longer to the south (north wall and NE cut unchanged on site). The 0.5 m goes in at y 6.0 in the middle and east columns and at the utility / coffee line (y 10.4) in the west column:
   - middle: women's majlis 6.0 → 6.5 m; courtyard, living and men's majlis 0.5 m south, sizes unchanged;
   - east: the maid wing gains 0.5 m (to y 6.5); the kitchen moves 0.5 m south unchanged (still on the courtyard lines);
   - west: coffee corner 2.0 → 2.5 m; everything south of it 0.5 m south; family lobby + riwaq 0.5 m longer.
   - Maid wing: 100 mm dry block partition between laundry and maid room, moved 0.15 m towards the maid room (x 10.5 → 10.65); laundry 1.70 × 3.7 with ≈ 0.95 m clear beside the 0.6 m machines; maid room 7.06 m² on axes, ≈ 6.04 m² clear (the 6.5 m² clear target is NOT reached even with all the extra space; the slope ends at y 6.0, so the maid room now has 0.5 m of straight east wall again). Exterior walls and air tower unchanged; interior walls straight and square.
   - Kitchen: no island, two parallel counter runs (sink on the courtyard wall, hob and hood on the east outside wall).
1. Lift becomes a future placeholder: "Lift (future · shaft placeholder)" 2.25 × 2.2 at the west of the column (≈ 2.0 × 2.0 m clear shaft) + "Entry cupboard" 0.5 × 2.2 beside it (shallow, ≈ 0.4 m clear, opening onto the family lobby: shoes, coats).
   - For about 10 years from now; two stops only (ground and first, no roof stop; the roof by the stair); sized for a standard Saudi-market villa lift (4–6 persons, wheelchair-capable); final size from a supplier's civil drawing (use the largest of 2–3 quotes); ask the supplier what a future roof stop would need.
   - Build now: shaft walls on both floors; pit (≈ 1.2 m, to confirm) built and covered, clear of drains and the air tunnel; first-floor roof slab over the shaft designed to open later; a separate electrical line; the shaft is a store until then.
   - Lift door onto the family lobby: the entry cupboard stands in front of the shaft's east wall, so its south ≈ 1.0 m is built as removable joinery; when the lift comes, that part is removed to form the lift door reveal (drawn as "future lift door").
2. "Coffee corner (open use)" becomes "Hospitality kitchen" 2.75 × 2.5 (≈ 5.8 m² clear): light (clean) kitchen for coffee, tea, dates, desserts and reheating; serving base for the men's majlis. Open to the riwaq, no door, no hob; L-counter on the north wall and the west wall (the wall shared with the family basins stays plain), small sink, under-counter fridge, microwave, kettle and coffee things, storage for cups and trays, small extract fan. The full-height wall to the family basins stays. The main east kitchen is the heavy (dirty) kitchen.
3. Serving passage: no shelf, no fixed equipment; 1.6 → 1.4 m on axes (1.20 m clear). The guest WC's south wall is on the men's majlis north wall line (y 19.25); the guest WC grew northwards to 1.5 × 1.75 (≈ 1.3 × 1.55 clear). Guest basins 2.0 → 2.15 m deep (owner decision: they take the 0.15 m left by the new line); guest passage 3.7 → 3.9 m; foyer unchanged. The two serving doors stay.
4. Guest basins renamed "Guest basins (trough · 3 taps)": one trough ≈ 1.8 m with three taps on the east wall.
5. Foyer: outside entrance = double door 1.40 m (two leaves, opening in) at the north end of its west wall; opening into the men's majlis = 1.80 m, no door, at the south end of its east wall (≈ 0.65 m of wall left at its north end); shoe cabinet and bisht / shemagh hooks on that wall facing the entrance. NOTE: in a 2.6 m foyer a 1.40 m door and a 1.80 m opening cannot be fully offset; they overlap by ≈ 0.75 m, so the bent entry is partial (a curtain or a short screen in front of the opening would close the view). Guest entry arrow and door marks updated.
- Documentation-only notes (no geometry change):
  - Stair 2.75 × 5.7 m is good (≈ 16.4 cm risers, 28 cm goings, ≈ 1.10 m flights, ≈ 1.2 m half landing for a 3.6 m storey); the engineer confirms the floor-to-floor height, headroom at the slab opening (≥ ≈ 2.1 m) and handrails. The store under the half landing stays.
  - Utility room and shaft: size and position correct; the west shaft serves the west wash block and first-floor bathrooms above or beside it only.
  - Plumbing: kitchen, laundry and maid bath drain under the slab straight out to the east (manhole in the east service yard), with a small east duct (≈ 0.6 × 0.6 m) for the vent stack, any first-floor bathroom above the east side and the kitchen extract. Water: one line from the main manifold through the ceiling, with a small secondary manifold in the laundry. Coordinate drain depths with the air tunnel, which also runs under the east side. A separate plumbing study (plumbing.typ) will be made later.
  - Family basins: straight counter, no cupboards opposite (≈ 0.75–0.8 m in front, plus the open riwaq). Family WC: WC and basin, no shower (showers on the first floor).
  - Men's majlis: size unchanged (10.561 × 4.75); high windows on the south wall (light and privacy); main seating at the east end, away from the entrance; air-conditioning hidden in the ceiling or on the end wall, not above the seats.
  - Maid room window in the sloped wall: high sill (≥ 1.5 m) for privacy from the lane.
  - Gas (if used): cylinder / tank cabinet outside the east wall in the service yard, short line to the kitchen.
- Site test: data/building.csv active row "Z4 V3.3" (outside faces 13.561 × 24.25, NE cut 3.311 × 6.093, centre (7.5655, 15.525)); the V3.2 row is kept switched off. Envelope gap still 0.05 m (the 0.5 m env-margin test still shows NO).

## Changes in V3.2 (16 Oct 2026 · Revision 02, five owner notes)
1. The slope runs on to the south end of the maid room (y 6.0); the east wall then goes straight south. Width on axes 13.0 → 13.311 m; the extra 0.311 m went to the kitchen, dining and men's majlis.
2. Building moved 0.26 m east (shift 0.65 → 0.91): outer west face 0.525 → 0.785 m from the M line, inside the fixed north position and rotation.
3. Middle band exactly 4.50 m clear: 4.75 → 4.70 m on axes (its east edge moved 0.05 m west to x 8.95; the laundry gained those 5 cm).
4. Walls and openings: a full-height wall between the coffee corner and the family basins (each opens to the riwaq on its own); no stair door and no living-room door (open entrances); the living room's west wall becomes a 1.20 m low partition.
5. Serving passage 1.1 → 1.6 m on axes (1.40 m between walls = 0.20 m shelf + 1.20 m clear); door 1 0.90 m, door 2 1.05 m. The guest block (guest WC, 3 basins, guest passage, foyer) moved 0.50 m south as one; the south facade moved 0.50 m south, so the living, dining and riwaq are 0.50 m longer and the men's majlis keeps 4.75 m.
- Privacy note: with the low partition opposite serving door 1, the living room is no full screen for someone standing; family privacy now rests on the two serving doors never being open together (the V3.1 rule "solid living-room wall opposite door 1" is withdrawn).
- Laundry: ≈ 0.75 m clear beside the 0.6 m machines (below the earlier 0.9 m aim); check the real appliances.
- Site drawing extras of Revision 02 (garden, parking) are illustrations only and not in the model.
- design_v3.typ now stops with an error if the outer wall face crosses the envelope, and prints the envelope and M-line gaps in the plan note.
- Site test: data/building.csv now has the active row "Z4 Rev 02 (V3.2)" on outside wall faces: 13.561 × 23.75 m, NE cut 3.311 along the north facade × 6.093 down the east facade, centre (7.5655, 15.275); the old Z3 and Z4 rows are kept switched off with #. Result: 311.99 m², west face 0.79 m from the M line, palms 6.06 / 8.21 m clear, but only 0.05 m to the envelope, so the 0.5 m env-margin test in site_test.typ shows NO (decision open: keep the 0.5 m allowance or lower it).

## Changes in V3.1 (15 Oct 2026)
- Building moved from Z3 to Z4 (0.75 m wider through the middle): courtyard, women's majlis and double-height living each 4.75 m wide; east rooms moved 0.75 m east; building 0.375 m further west.
- Men's majlis west wall moved onto the west band line (x = 2.75).
- Family basins, family WC and guest wing redesigned as ONE west wash block, with a two-door serving passage as the only family / guest link.
- East service block redesigned: kitchen 4 × 6.5 on the courtyard lines, laundry on the women's majlis wall, maid room and maid bath running up to the sloped cut wall.
- `base.typ`: optional `pts` column for rooms that are not rectangles (site data unchanged).
- Studies moved to `studies/`; one DXF of the whole design added (`design_v3.dxf`).

## Open choices
- OPEN DECISION (not drawn): a small service door from the laundry to the east service yard, kept locked with the owner's key only, for rubbish and deliveries.
- Foyer: accept the partial bent entry (≈ 0.75 m overlap of door and majlis opening) or add a curtain / short screen.
- Maid room ≈ 6.2 m² clear (V3.4), still below the 6.5 m² target.
- Stair size with the engineer (≈ 2.75 × 5.7 m for a 3.6 m storey).
- Use of the coffee corner (open use) in the west wash block.
- Deliveries reach the kitchen through the family entrance (no service door, to keep the kitchen isolated).
- Structure: the engineer to set the grid; the east band works as its own 4 m bay.
- First floor: later (wet rooms to stack over the north of the west wash block and over the maid bath / laundry).

## Ideas for later (not in the drawing)
- Removable desert (evaporative) cooler with a fan at the tunnel's courtyard outlet, in a wall niche with water, drain and power; removed when not needed.
- Tunnel cleanable (≈ 1.2 m high), sloped to a drain, hatches at both ends.
- Use the tunnel as the pre-cooled fresh-air intake for the AC; consider an ERV (energy recovery ventilator).
- Route AC condensate water to the evaporative cooler pad.
- Split AC outdoor units on a screened roof plant area (or one VRF outdoor unit), not in a shaft; refrigerant and condensate pipes run in the service shaft.
- Services built for life: walk-in service shaft, service ceiling above the riwaq, manifolds, access panels, wet rooms stacked over the shaft.

## Services built for life (V3.0, 11 Oct 2026; updated 15 Oct)
- The service shaft sits INSIDE a utility room (2.75 × 2.5 m): shaft, main electrical panel, water manifold with isolation valves, water heater (ventilated) and cleaning equipment, all behind one door from the riwaq.
- Shaft: closed box ≈ 1.0 × 1.2 m clear (≈ 1.5 × 1.2 m with walls), sealed walls, one full-height maintenance door facing east; a 0.9 m clear zone in front of that door is never used for storage.
- The shaft is in the corner touching the west wash block (coffee corner), so drainage runs stay short; first-floor bathrooms must stack above or beside it.
- Store under the stair's half landing (≈ 2.75 × 1.0 m, ≈ 1.6 m headroom), door onto the riwaq; drawn inside the stair, not counted as extra area.
- Code note: the Saudi Building Code sets no fixed size for a closed pipe shaft; ≈ 0.6 × 0.6 m is the practical minimum for a pipe-only duct and ≈ 1.0 × 1.2 m is comfortable for a two-storey villa. Sources were general professional guidance, not the code text; confirm with the SBC, the municipality and the plumbing engineer.

## One living room, two heights (V3.0, 11 Oct 2026; sizes updated for Z4)
- Living is one open room, 9.061 × 6.25 m in V3.2 (8.75 × 5.75 m in V3.1), split by a ceiling-height change only (no wall):
  - Living (double height), middle band south of the courtyard, 4.70 × 6.25 m (V3.2): faces the courtyard, high operable clerestory windows for stack ventilation; simple 4.70 m roof span; open to the riwaq through a 1.40 m opening, then a 1.20 m low partition.
  - Living (normal height) · dining, east band south of the kitchen, 4.361 × 6.25 m (27.26 m², V3.2): daily dining beside the kitchen door; ducts and lighting in its ceiling; the first floor continues above it (and above the kitchen and maid wing).
- No upper floor over the double-height part or the courtyard.
- Possible south clerestory windows over the men's majlis roof: first-floor decision, noted only.

## West wash block (V3.0 on Z4, 15 Oct 2026)
- Family basins, family WC and the guest wing are now ONE section: the west wash block, x 0–2.75, y 10.4–24.0 (2.75 × 13.6 m = 37.4 m² in V3.3; 13.1 in V3.2; 12.6 in V3.1), between the utility room (north), the riwaq (east, x 2.75–4.25) and the men's majlis (east, from y 18.75). Layout study: studies/guest_wing.typ (local y + 10.4 = CSV y); the same rooms are in data/rooms_v3.csv.
- One strip of wet rooms on one drain run, north → south:

  | Room | w × d (m) | m² |
  |---|---|---|
  | Hospitality kitchen (V3.3, was Coffee corner) | 2.75 × 2.5 | 6.88 |
  | Family basins (2) | 2.75 × 1.5 | 4.13 |
  | Family WC + basin | 2.75 × 1.7 | 4.68 |
  | Serving passage (2 doors) | 2.75 × 1.4 (V3.3) | 3.85 |
  | Guest WC | 1.5 × 1.75 (V3.3) | 2.63 |
  | Guest basins (trough · 3 taps) | 1.5 × 2.15 (V3.3) | 3.23 |
  | Guest passage | 1.25 × 3.9 (V3.3) | 4.88 |
  | Foyer + entry | 2.75 × 2.6 | 7.15 |
  | **Block** | **2.75 × 13.6** | **37.40** |

- Family side: coffee corner and family basins are each open to the riwaq (no doors), with a full-height wall between them (V3.2); the family WC door is off the basin niche. The coffee corner (counter, small sink, under-counter fridge) is the serving base; its final use is still open.
- Serving passage = the ONLY link between family and guests, with only two doors (no wall or door in the middle). V3.2: 1.6 m deep on axes, 1.40 m between walls: a 0.70 × 0.20 shelf and 1.20 m clear in front of it; door 1 0.90 m, door 2 1.05 m. The family opens door 1 from the riwaq, puts coffee, trays or food on the shelf, closes door 1 and calls the host; the host opens door 2 from the guest passage, collects and closes it. The two doors are never open together. Door 1 locks from the riwaq side and door 2 from inside the passage, so the family controls both.
- Bent entry (majaz): an open door 2 shows only the passage, the blank south wall of the family WC and the closed door 1 at the far end. The guest side has no door onto the riwaq.
- V3.1 rule withdrawn in V3.2: the living-room west wall opposite door 1 is now a 1.20 m low partition, so privacy rests on the two serving doors.
- Guest side: guest WC (WC + hand spray only), door in its south wall at the west end, opening inwards; its west wall continues 0.6 m south as a screen wall so the WC door is out of sight from the passage. Three guest basins in one row along the east wall, open to the guest passage. Guest entrance in the foyer's west wall (y ≈ 22.1), door to the men's majlis in its east wall. V3.2: the whole guest side moved 0.50 m south (sizes unchanged); guest passage ≈ 1.025 m clear.
- Plumbing: the family WC and guest WC sit 1.1 m apart; the drain crosses under the serving passage floor, with a cleanout access point there. First-floor bathrooms should stack over the north part of the block, near the shaft.
- Replaces: Family basins (2) 2.75 × 2.8, Family WC + basin 2.75 × 3.5, Guest wing 2.75 × 6.3 and the old riwaq → guest wing door. The men's majlis west wall is on the west band line (x = 2.75), 10.25 × 4.75 m.

## East service block (V3.0 on Z4, 15 Oct 2026)
- Layout study: studies/east_wing.typ (stand-alone; main CSV = local + (8.95, 0)). Block = the east band x 8.95–13.311, from the north wall (y 0) to the kitchen's south wall (y 13.0 in V3.3); not a rectangle, the NE corner is cut by the lane wall from (10.051, 0) to (13.311, 6.0), one continuous slope to y 6.0, then straight (V3.3: 0.5 m of straight east wall at the maid room's south end). Block 46.91 m², no leftover slivers.
- Rooms, north → south:

  | Room | Where (main CSV) | Size | m² |
  |---|---|---|---|
  | Air tower | tip of the cut corner, 1.0 m deep (V3.4) | polygon | 1.37 |
  | Maid bath | y 1.0–2.6, up to the cut wall | sloped, 1.6 m on the majlis wall | 3.33 (≈ 2.57 clear) |
  | Laundry | x 8.95–10.65, y 2.6–6.5, on the women's majlis wall | 1.70 × 3.9 | 6.63 |
  | Maid room | x 10.65 → cut wall, y 2.6–6.5 | sloped + 0.5 m straight | 7.24 (≈ 6.18 clear) |
  | Kitchen | x 8.95–13.311, y 6.5–13.0 | 4.361 × 6.5 (≈ 4.14 clear) | 28.35 |

- Main cross walls on the house lines: y 6.0 (women's majlis / courtyard) and y 12.5 (dining). The kitchen runs exactly with the courtyard.
- Kitchen isolated: door only to the dining (south) and an open entrance (no door) to the laundry at its north-west corner; no door to the courtyard, riwaq or women's majlis. Sink run on the courtyard wall under the window, hob and hood on the east (outside) wall, fridge and tall storage at the south-east beside the dining door, extra window on the east wall. ≈ 2.94 m between the counter lines (V3.2); no island (only 0.6 m deep would fit); room for a small breakfast table.
- Laundry: washer, dryer, utility sink and folding counter in one line on the solid west wall (women's majlis side, no opening), ≈ 0.75 m clear beside the machines (V3.2); no outside wall, so a mechanical extract fan to the roof.
- Maid route only kitchen → laundry → maid room → maid bath; no external door. Both maid doors sit at the north end (laundry → maid room at the north end of the laundry's east wall; maid room → maid bath in the room's north wall), so the single bed (0.9 × 2.0) takes the wide south part along the y 6.0 wall, with a wardrobe on the west wall. Make the bath door sliding or opening out so the two doors do not clash.
- Maid room ≈ 6.21 m² on centre lines (≈ 5.10 m² clear, under the earlier 6.5 m² target, accepted); high-sill window in the cut wall (lane side). Maid bath (WC, basin, compact shower) with a vent window in the cut wall.
- One wet line down the west side of the block: maid bath, laundry machines and kitchen sink; cleanout access in the laundry.
- Air tower kept in the tip of the cut corner (V3.4: 1.0 m deep, ≈ 1.37 m² on centre lines, ≈ 0.88 m² clear; was ≈ 1.71 m² on centre lines, ≈ 1.1 m² clear), cleaned from a roof hatch.
- Solid wall (no door, no window) between the maid wing / laundry and the women's majlis.
- Replaces: Maid bath 1.7 × 2, Maid room 2.75 × 2.8, Laundry 4 × 1.5, Kitchen 4 × 5.
- Drawing engine: base.typ now accepts an optional `pts` column in the room CSV ("x y; x y; …", CSV coordinates) for rooms that are not rectangles; design_v3.typ shifts and rotates those points with the building. Site data in base.typ is unchanged. The maid bath and maid room use it.
