ahl20006/House_git/taif_house/output/east_wing.pdf

# East service block · kitchen, laundry, maid wing · layout study (V10.0: the malqaf moved to the courtyard, L5)

Taif / Palm House · Ground floor V7.1 · block = CSV x 8.95–13.311, y 0–13.0 (NE corner cut) · 49.22 m² · scale 1 m = 1.15 cm · north up

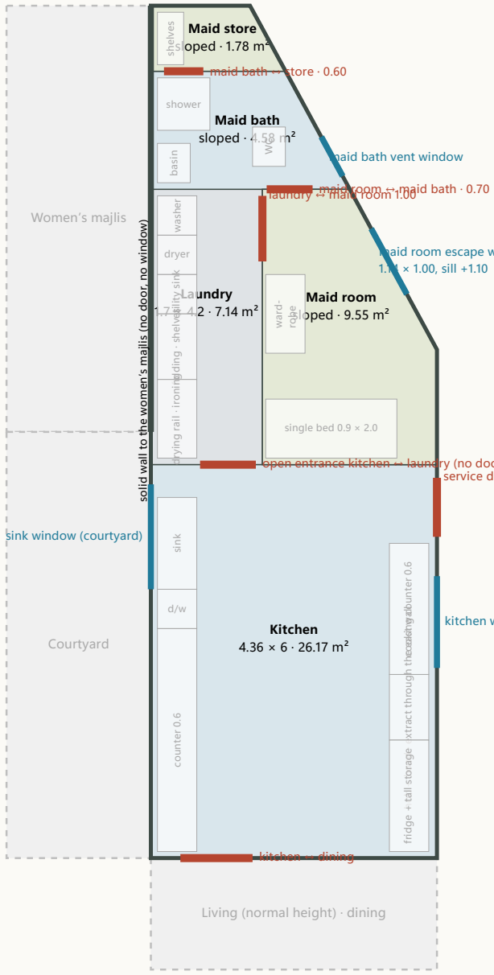
[picture p10: figure]
Women’s majlis; Courtyard; Living (normal height) · dining; Laundry 1.7 × 4.2 · 7.14 m²; Kitchen 4.36 × 6 · 26.17 m²; Maid bath sloped · 4.58 m²; Maid store sloped · 1.78 m²; Maid room sloped · 9.55 m²; sink; d/wcounter 0.6; washer; single bed 0.9 × 2.0; ward-; robe; shower; basin shelves; sink window (courtyard); 1.14 × 1.00, sill +1.10; maid bath vent window; kitchen ↔ dining; maid bath ↔ store · 0.60

cooking counter 0.6 hob + hood · extract through the east wall fridge + tall storage

# dryer utility sink folding · shelves drying rail · ironing

solid wall to the women’s majlis (no door, no window)

kitchen window (east)

maid room escape window

service door 0.90 · east yard · lockable open entrance kitchen ↔ laundry (no door) laundry ↔ maid room 1.00 maid room ↔ maid bath · 0.70

1 m

### Rooms

Room | w × d (m) | m²
Maid bath | sloped (to the cut wall) 4.58
Maid store | sloped (to the cut wall) 1.78
Maid room | sloped (to the cut wall) 9.55
Laundry | 1.7 × 4.2 | 7.14
Kitchen | 4.36 × 6 | 26.17
Leftover slivers along the cut | | 0
Block | | 49.22

✓ All rooms inside the block, no overlaps

Route Family: living (normal height) · dining → kitchen

(south door).
Maid: kitchen → laundry → maid room → maid bath. No external door and no other door: all her movement passes through the kitchen.
Cooking: sink on the courtyard wall under its window (y 7.3– 8.9, looking at the courtyard’s fountain and tree; the outdoor TV on the courtyard face of the wall further south), hob and hood on the east (outside) wall, so heat and smoke leave the house; fridge and tall storage at the south-east, next to the dining door; the east duct in the north-east corner.

### Rules

- Kitchen isolated: doors only to the dining area (south) and the laundry (north). No door to the courtyard, riwaq or women’s majlis.
- Kitchen 4.361 × 6.0 m on axes (26.17 m², ≈ 24.0 m² clear, ≈ 4.136 m clear wide), y 7.0–13.0 (V6.4: its north wall is a nonload-bearing partition 0.5 m south of the structural line y 6.5, so the maid room reaches the municipal minimum). No island: two parallel counter runs, the sink run 5.4 m on the courtyard wall and the cooking run 3.0 m (y 8.2–11.2, the hob and hood at y 10.2–11.2 south of the east window) plus the fridge and tall storage on the east outside wall; ≈ 2.94 m between the counter fronts. The heavy (dirty) kitchen; the hospitality kitchen in the west block is the light one.
- Laundry vertical on the west wall (women’s majlis side), 1.70 × 4.2 m (x 0–1.70, y 2.8–7.0; ≈ 6.2 m² clear), from the kitchen up to the maid bath: open entrance from the kitchen in its south wall (no door); washer, dryer, utility sink, folding shelves and a drying rail in one line on the west wall (solid, no opening, the wet wall 200 mm); 0.95 m clear walkway beside the 0.6 m machines; maid room door at the north end of its east wall. The maid’s only route. No outside wall: a mechanical extract fan to the roof.
- Maid room east of the laundry behind a 100 mm partition (insulated gypsum board or 100 mm block, the owner may change it later), y 2.8–7.0; the slope ends at y 5.245, then 1.0 m of straight east wall (≈ 9.55 m² on centre lines, ≈ 8.41 m² clear (8 Nov 2026: the cut wall a further 0.24 m out; V9.0 7.69), 2.49 m clear wide at the bed (y 6.0–7.0), 2.22 m at y 6.0: the municipal ≥ 6.5 m² and ≥ 2.1 m are met, V6.4). Doors from the laundry and to the maid bath both in the north part (the laundry door’s swing y 2.9–3.9 stays clear of the wardrobe at y 4.1–5.3); single bed 0.9 × 2.0 along the south wall and a wardrobe on the west wall; window in the cut wall: an escape casement 1.14 × 1.00 with the sill at +1.10 (fire safety, owner 1 Nov 2026; net clear 1.04 × 0.90 = 0.94 m²), obscured glass below +1.60 for the privacy from the lane, no screen.
- Maid bath 1.8 m deep (y 1.0–2.8, from the store to the maid room), running up to the cut wall (V10.0: back to its V9.1 shape, ≈ 4.58 m² on axes, ≈ 3.77 m² clear; the WC back in the cut-wall corner: no breeze channel under the bath any more): WC, basin, compact shower; vent window in the cut wall; door only from the maid room, 0.70 m clear (sliding or opening out; the wall there is only ≈ 0.73 m long).
- Main cross walls: y 7.0 (kitchen / maid wing, V6.4: a straight non-load-bearing block partition on a thickened slab or ground beam; the structural line y 6.5 keeps its beam B6 inside the laundry / maid room ceiling, hidden by the gypsum ceiling, carrying the first-floor wall above) and y 13.0 (dining). Exterior walls and the air tower fixed; all interior walls straight and square. Walls: the maid bath block with waterproofing (wet room); 100 mm for the dry laundry / maid partition; 150–200 mm for walls carrying pipes (maid bath, laundry sink wall).
- Solid wall (no door, no window) between the maid wing and the women’s majlis.
- Breeze channel (studies/air_system.typ v3): a 0.9 × 0.20 channel inside the ground-slab depth on x 1.25 (CSV 10.2) under the maid bath (a 0.5 throat between the shower and the WC, moved to the cut-wall corner), the laundry walkway and the kitchen walkway to the plenum under the sink counter (CSV y 10–11) and the grille under the outdoor TV; removable sealed covers flush with the laundry and kitchen floors; the walls y 1.0, 2.8 and 7.0 cross it with a slot above their ground beams (A3, nothing notched).
- The cut tip (V10.0): the maid’s store, ≈ 1.78 m² on axes (≈ 1.3 m² clear), shelves on its west wall, the 0.60 door from the maid bath; the malqaf moved to the courtyard’s northwest corner (studies/malqaf_L5.typ, adopted): nothing of the air system in this block.
- Plumbing: kitchen, laundry and maid bath drain under the slab straight out to the east, to a manhole in the east service yard; no east duct; the vent stack runs up the outside face of the east wall and the kitchen extract leaves straight through the east wall at the hood. Coordinate drain depths with the air tunnel (also under the east side).
- Service door (owner decision): a lockable 0.90 m door in the kitchen’s east wall at its north end (y 7.2–8.1, V6.4), near the laundry, to the east service yard (rubbish, deliveries, gas); the cooking counter starts 0.1 m south of it (y 8.2); the stack outside the east wall sits between the door and the kitchen window (y 8.1–8.7, 0.6 m: MEP to confirm); the hood (y 10.2–11.2) is clear of the door and of column C32 (y 5.7–6.3). Gas (if used): cylinder cabinet outside the east wall in the service yard.
