ahl20006/House_git/taif_house/output/malqaf_L5.pdf

# Malqaf L5 · the courtyard’s north-west corner · a decision-grade study in phases

ADOPTED (V10.0, owner, 9 Nov 2026): L5, V-c + F3 (the fall-back F2 if the engineer refuses the beam additions) · applied in the design files (studies/air_system.typ v4, the room data, the plans, the roof, the structure,
the 3D, the presentation); this study stays the record of the decision.

STUDY ONLY: no design file is changed until the owner adopts L5 · the owner’s decisions D1–D11 (9 Nov 2026) are the brief · PHASE 0: the geometry check and the climate basis (the next phases follow the owner’s reply) · every figure ASSUMED unless measured; final sizes by the structural and MEP engineers.

### 0.1 · The brief’s coordinates against the repo (V9.3)

The brief | The repo
Courtyard x 4.25–8.95, y 6.5–13.0 | rooms_gf.csv: 4.7 × 6.5 centred 6.6 / 9.75 | ✓
Seating zone x 5.925–8.85, y 7.1–12.3 | air_system.typ air-sunken | ✓
GF covered strip x 4.25–5.80, y 6.5–13.0 | the FF projection 1.55 m (B4 x 4.25 → B3 x 5.80); clear ≈ 1.35–1.45 (the riwaq’s glazing line and the colonnade) | ✓
Women’s majlis x 4.25–8.95, y 0–6.5 · FF family living x 4.25–8.95, y 3.0–6.5 | rooms_gf.csv, rooms_ff.csv | ✓
Family lobby + riwaq x 2.25–4.25 | partly: x 2.25–4.25 only for y 0–2.2 (the lobby); along the courtyard x 2.75–4.25 (1.5 m) | ≠
Riwaq glazing on x 4.25 | glass y 6.8–8.9 and 10.7–12.7, the courtyard glass door y 9.1–10.5 (presentation.typ) | ✓
FF gallery x 4.25–5.80 (y 6.5–19.25) + x 2.75–4.25 (y 2.2–9.2), ≈ 3.05 m wide at y 6.5–9.2 | rooms_ff.csv (also x 2.25–4.25 for y 0.7–2.2) | ✓
W1 × 6 on x 5.80: y 6.783–8.383 … 17.408–19.008; sill +3.82, springing +5.80, crown +6.60 | ff_family.typ, 3d/params.yaml | ✓

C21 (5.8, 6.5), C22 (5.8, 13.0), C23 (5.8, 19.25), Ø 0.30 · and
C17 at (4.25, 6.5)
structure.typ (C17: 0.25 × 0.50, to the roof) | ✓
B3 on x 5.80, 6.50 + 6.25, upturned or drop · B4 on x 4.25, drop, soffit +3.10 · R11 on C21–C22, soffit +6.75 · the projection slab 0.20 E–W 1.55 m | structure.typ | ✓

Levels GF ±0.00, FF +3.60, roof finish +7.30, attic coping
+8.68 · Z3 x 2.85–4.15, y 1.0–3.5
roof.typ (V9.2 attic) | ✓
Baseline L1 (V9.3): NE corner, shaft 0.90 m², crown +12.18 | air_system.typ, roof.typ (V9.3) | ✓

Mismatches: (1) the riwaq is 1.5 m wide along the courtyard (x 2.75–4.25), 2.0 m only at the lobby (y 0–2.2); (2) the covered strip’s clear width ≈ 1.35–1.45 m depending on the glazing build-up (to fix in Phase 1). Also noted: a column C17 already stands at (4.25, 6.5), the corner the L5 core starts from (Phase 2); at y 6.5–9.2 the FF gallery is 3.05 m wide only because its west half (x 2.75–4.25) is the stair’s arrival zone: a core across the whole strip (V-b) leaves 1.5 m on axes, ≈ 1.3 clear, below the brief’s 1.5 m clear (⚠ caution for Phase 1).

### 0.2 · The wind (Taif station, 10 m mast, 2011–2025)

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
May–Sep · evening

20.7 km/h · calm 1.2 %

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
May–Sep · afternoon

21.3 km/h · calm 0.6 %

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
Nov–Feb · night

6.9 km/h · calm 26.6 %

Mon | N | NE | E | SE | S | SW | W | NW | km/h | calm
Jan | 7.1 | 5.9 | 10.1 | 12.9 | 21 | 16.1 | 16.3 | 10.6 | 11.7 | 14.2
Feb | 6.3 | 6.3 | 11.3 | 12.4 | 17.9 | 18.2 | 17.7 | 9.8 | 13.9 | 10.9
Mar | 4.2 | 4.1 | 7.8 | 11 | 19.1 | 17.4 | 24.9 | 11.4 | 15 | 8.5
Apr | 3.2 | 4 | 7.1 | 11.3 | 18.2 | 19.4 | 26.5 | 10.2 | 14.9 | 6.7
May | 4.5 | 5.2 | 6.2 | 7.1 | 13 | 16.9 | 33.2 | 13.9 | 13.8 | 6.8
Jun | 8 | 8.4 | 6.4 | 3.9 | 4.4 | 8 | 35.7 | 25.3 | 16.8 | 3.8
Jul | 7.2 | 3.8 | 1.4 | 0.6 | 1.1 | 4.2 | 44 | 37.6 | 21.7 | 1.4
Aug | 8.9 | 6.2 | 2.9 | 1.4 | 2.1 | 5 | 40.7 | 32.8 | 19.6 | 2.3
Sep | 7.2 | 10.6 | 10.8 | 7.2 | 8 | 10.6 | 25 | 20.7 | 13.8 | 7.4
Oct | 3.4 | 6.8 | 14.3 | 19.1 | 18.9 | 10.8 | 15.9 | 10.7 | 11.5 | 12.1
Nov | 4.6 | 4.5 | 10.3 | 15.2 | 22.1 | 14.1 | 17.6 | 11.7 | 10.7 | 13.9
Dec | 5.6 | 4.7 | 12 | 15.8 | 21.2 | 14.1 | 15.1 | 11.3 | 10.9 | 14.5

% of the non-calm hours by the direction the wind blows FROM; calm < 2 km/h. Bold blue: ≥ 25 %. Station at the airport (21.48 N 40.54 E, 1 478 m), ASSUMED representative of the farm (its terrain and obstacles to be checked on site).

## Phase 0 · when the malqaf works · dust · summer cooling · winter closing

Month | Jan | Feb | Mar | Apr | May | Jun | Jul | Aug | Sep | Oct | Nov | Dec
Tmax / Tmin (°C) | 23 / 10.2 | 25 / 11.7 | 27.6 / 14.6 | 30 / 17.2 | 33.5 / 20.4 | 36.2 / 24 | 35.5 / 25.3 | 35.5 / 24.9 | 35 / 22.6 | 31 / 17.9 | 26.6 / 14.1 | 23.9 / 11.3
the coldest nights (p10, °C) | 7 | 8 | 11 | 14 | 18 | 21 | 23 | 23 | 20 | 15 | 12 | 8
15 h: T · RH | 22.2 · 36% | 24.3 · 30% | 26.9 · 25% | 28.9 · 26% | 32.4 · 19% | 35.6 · 12% | 34.9 · 15% | 34.7 · 20% | 34.2 · 15% | 30.2 · 19% | 25.6 · 34% | 23.3 · 36%
21 h: T · RH | 16.3 · 57% | 18.2 · 50% | 20.8 · 45% | 22.7 · 46% | 26.2 · 36% | 29.3 · 24% | 29 · 26% | 28.5 · 37% | 28 · 35% | 24 · 45% | 19.8 · 59% | 17.3 · 57%
evening wind (km/h) | 12 | 14.7 | 16.4 | 16.9 | 17.5 | 21.1 | 24.6 | 22.9 | 17.5 | 13.3 | 11 | 11
dust days / year | 3.1 | 6.3 | 11 | 8.3 | 5 | 8 | 5.5 | 7.8 | 3.7 | 1.2 | 0.5 | 1.8
seating 16–23: dust hours | 4.7 % | 8.5 % | 17.3 % | 10.8 % | 6.4 % | 12.1 % | 8.4 % | 11.4 % | 4.8 % | 1.3 % | 0.7 % | 2.9 %
pleasant & dust-free | 21 % | 43 % | 65 % | 70 % | 76 % | 47 % | 53 % | 62 % | 71 % | 89 % | 65 % | 34 %
≈ hours / month | 53 | 96 | 162 | 169 | 188 | 113 | 132 | 154 | 170 | 221 | 157 | 84
too hot > 32 °C | 0 % | 0 % | 0 % | 1 % | 14 % | 36 % | 29 % | 25 % | 22 % | 2 % | 0 % | 0 %
too cool < 18 °C | 46 % | 24 % | 8 % | 5 % | 1 % | 0 % | 0 % | 0 % | 0 % | 1 % | 11 % | 35 %
cooler outlet at 15 h (°C) | – | – | – | 18.6 | 19.8 | 20.3 | 20.8 | 21.8 | 20.2 | 18.3 | – | –

Pleasant = 20–32 °C with 7–35 km/h at the 10 m mast (the head at ≈ +12 m: ≈ 4 % more), the family’s seating hours 16:00–23:00 (ASSUMED); dust = an ISD synoptic report with dust or sand in the present weather (06–09, 30–35). Cooler = a direct evaporative cooler at 80 % saturation efficiency on the 15 h mean (wet bulb by Stull 2011), ASSUMED.

### 0.3 · What the climate says

- When the malqaf works: ≈ 1699 h a year of pleasant, dust-free seating hours (58 % of 16:00–23:00): the best months October
(89 %), May (76 %), April, September, March and November (65–71 %); the summer evenings 47–62 % (the rest too hot → the cooler, D9); December–January 21–34 % (too cool → closed).
- The faces that matter: the warm-season evening wind comes from the west (≈ 50 %) and the north-west (≈ 30 %), at ≈ 21 km/h (≈ 6 m/s, calm 1 %); the afternoons add the north and north-east (≈ 25 %). Priority: the W face, then the N face (a NW wind strikes both at 45°); E and S faces matter only in the cool season’s light night winds (S / SE, calm 27 %), when the malqaf is closed anyway.
- Dust: ≈ 62 dust days a year (mostly dust in suspension; a dust-storm code or a visibility below 1 km on less than 1 day a year), the most in March (11) and June–August (8); ≈ 5–17 % of the seating hours. The dust arrives as often from the east and south-east (≈ 35 %) as from the west: a dust trap at the foot and a PM2.5 sensor are essential; the filtered path must never depend on the breeze path.
- Summer cooling (D9): the afternoon air is very dry (RH 12–20 %, the wet bulb 16–19 °C): a direct evaporative cooler would deliver ≈ 20–22 °C air from 35 °C, June–September: an excellent potential for a mobile cooler in the shaft’s foot.
- Winter: the evenings below 18 °C on ≈ 35–46 % of December–January seating hours, the coldest nights ≈ 7–8 °C: the breeze path must close tight and insulated (D5).
- ⚠ CAUTION · the station is the airport’s 10 m mast; the farm’s own exposure (terrain, trees, the old house to the west) is unknown: a simple anemometer on the roof for a few weeks would confirm the faces before Phase 5.

### 0.4 · Thresholds for the control modes (to finalise in Phase 4)

Mode | Switching (outdoor sensors; ASSUMED)
Normal | breeze damper open: 20 ≤ T ≤ 32 °C and PM2.5 ≤ 35 µg/m³; the filtered fan always on
Clear day | also the gallery window: 18 ≤ T ≤ 30 °C, PM2.5 ≤ 15, wind ≤ 30 km/h
Dust | all breeze openings shut: PM2.5 > 50 for 10 min (reopen < 25 for 30 min); the fan up for positive pressure
Cold | breeze shut: T < 18 °C (or < 20 °C after sunset, Nov–Mar); the fan at its minimum
Summer | T > 32 °C: the cooler on in the foot, the breeze damper open to feed it, the gallery window shut
High wind | gusts > 45 km/h: the damper half-closed (dust and noise)

### Open questions for the owner

1. Where exactly is the farm (distance and height from the airport; hills or trees to the west and north-west)? Can a small roof anemometer run for a few weeks?
2. Are 16:00–23:00 and 20–32 °C the right seating hours and comfort band for the family?
3. Accept the PM2.5 thresholds (35 / 50 µg/m³) and the winter closing at 18 °C?
4. L5 frees the north-east corner: the corner study’s bedroom swap (studies/ne_corner.typ) is then not needed. Confirm Phase 1 can assume the corner returns to its V9.1 rooms?

ًء مساًء غربية )نحو ٪50( وشمالية غربية )نحو ٪30( بسرعة نحو 21 كم/س، فاألولوية لوجهي البرج الغربي ثم الشمالي. في السنة نحو 1699 ساعة جلوس )من 4 عصرا إلى 11 ليال( لطيفة وخالية من الغبار، وأفضلها أكتوبر ومايو والربيع
ملخص المرحلة :0 الرياح في الطائف صيفا والخريف؛ صيفا تكون الحرارة عالية في ثلث الوقت تقريبا فيعمل المبرد الصحراوي )الهواء جاف جدا فيخرج المبرد ًء هواًء بنحو 20–°22م(، ًء وشتاًء ُيُيغلق الملقف حين تقل الحرارة عن °18م. الغبار نحو 62 يوما في السنة وأكثره في مارس والصيف، فال بد من مصيدة غبار وحساس للغبار. البيانات من محطة مطار الطائف وتحتاج تأكيدا في موقع المزرعة.

Phase 0 checks passed (4) · Sources: Meteostat bulk hourly data, station 41036 Taif (bulk.meteostat.net), 2011–2025, 128 500 records; NOAA NCEI Integrated Surface Database (ISD) global-hourly, station 41036099999, 2015–2024, synoptic reports (noaa-global-hourly-pds); Windfinder, Taif Regional Airport statistics (prevailing W, 259°, 2011–2026); weatherandclimate.eu, Climate of Taif (monthly normals, which agree with the station means above); “Spatial and temporal variations in the incidence of dust storms in Saudi Arabia revealed from in situ observations” (Geosciences 2019; Cranfield and Exeter repositories: the west 5–15 dust-storm events a year, the spring peak). Reproduce: python tools/climate_taif.py.

Phase 1 · L5 geometry and variants · the north-west corner of the courtyard, inside the covered strip

The owner’s answers to Phase 0 (9 Nov 2026) applied. Every core by its outer faces (RC walls 0.20, ASSUMED); its north wall is the y 6.5 wall rebuilt in RC (nothing taken from the women’s majlis or the family living); its west face on x 4.30 keeps the gallery’s west passage 1.52 m clear. GF: the outlet (green) and the door (brown). FF: the passage widths (red). Roof: the head may grow north over the family living’s roof (D7: ≥ the shaft, a funnel). 1 m = 0.415 cm.

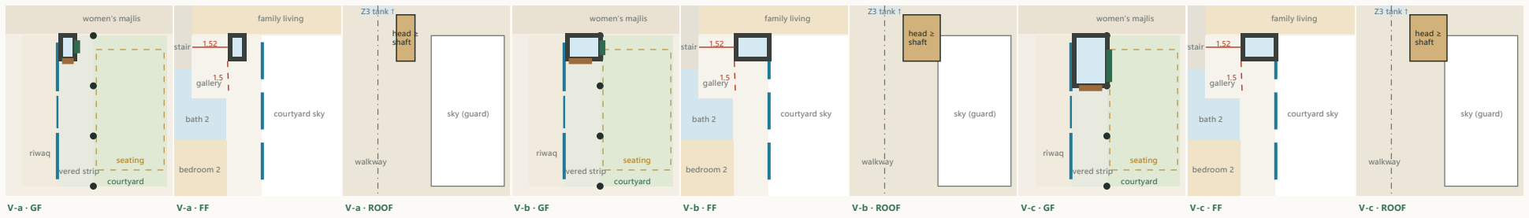
[picture p15: figure]
courtyard; seating; covered strip; women’s majlis; riwaq; family living; bath 2; stair; gallery; bedroom 2; courtyard sky; sky (guard); Z3 tank ↑; walkway; head ≥ shaft; V-a · ROOF; V-b · ROOF; V-c · ROOF

Variant | Shaft clear | Breeze area | Foot chamber | Outlet (free) | Door | Fits (cooler / filters / dust trap) | What is lost | Breeze (L1 V9.3 = 1)
V-a · corner core (west half of the strip) | 0.4 × 0.8 = 0.32 m² | 0.2 m² | 0.4 × 0.8 = 0.32 m² | 0.7 × 0.9 (0.38 m²) | 0.5 m | no: 0.40 m clear wide, no cooler, no door ≥ 0.9 | strip 0.9 m² · gallery 0.9 m² · riwaq glass 0.8 m solid · W1-1 untouched (a 0.7 m dead pocket beside the core) | 1.2 (≈ 0.53 m³/s)
V-b · full-strip core | 1.2 × 0.8 = 0.96 m² | 0.84 m² | 1.2 × 0.8 = 0.96 m² | 0.8 × 0.9 (0.43 m²) | 1 m | tight: the cooler OR the filter cabinet, no standing room, the door must slide | strip 1.7 m² · gallery 1.7 m² · riwaq glass 0.8 m solid · W1-1 covered (Phase 3) | 2.7 (≈ 1.12 m³/s)
V-c · full-strip core, the foot chamber in the first arcade bay | 1.2 × 0.8 = 0.96 m² | 0.84 m² | 1.2 × 1.97 = 2.36 m² | 1.4 × 0.9 (0.76 m²) | 1 m | yes: the cooler at the outlet, the filter cabinet + EC fan, the dust trap, a standing space at the door | strip 3.5 m² · gallery 1.7 m² · riwaq glass 2.1 m solid · W1-1 covered (Phase 3) | 3.5 (≈ 1.48 m³/s)

Finishes (owner, 9 Nov 2026): render and paint, no stone. The L5 core and its head are designed in render and paint: a light sand render; the projections (the cornice band below the head, the crowning Hijazi cornice, the arch surrounds of the head’s openings and of the courtyard outlet) in the optional calm honey tone. Every projection, arch and cornice is formed in the RC core and block (not applied), with a drip and a fall on its top; plaster mesh over every block / concrete junction before rendering. No stone anywhere on the tower (this replaces the “honey stone” of studies/malqaf_tower.typ and of the V9.3 tower). Phase 5 designs the head on this basis.

Breeze: the air study’s loss chain referred to its 0.10 m² section, with the same head pressure for all (ΔCp 0.8, the summer-evening mean wind 21 km/h): L1 (V9.3, the channel at full width) 0.42 m³/s. The L5 head’s pressure is not yet the same (§ 1.3). Riser = the filtered path’s Ø315 duct compartment (0.12 m²) inside the core. All ASSUMED.

Phase 1 · the foot chamber (V-c), the outlet, the door · the passage limit · the wind shadows

shaft above

dust trap (floor basin,
grating, drain)

riser (b)

mobile cooler
0.8 × 0.7 × ≤ 1.6

filters
+ EC fan

outlet 1.4 × 0.9 (louvres)

carved door 1.0 m → the covered strip

water · drain · IP44

C21 inside the wall

V-c · the GF foot chamber · 1 m = 2.3 cm

### 1.1 · The passage limit sets the shaft (a finding)

- At the first floor the gallery’s north arm (x 2.75–4.25, beside the stair) turns into the strip (x 4.25–5.80) between the core’s south face and bedroom 2′s bath (its north-east corner at (4.35, 9.10)). For ≥ 1.5 m there the core’s south face must stay at y ≤ 7.6: the shaft is at most 1.2 × 0.8 m clear (0.96 m²), the same order as L1. It is enough aerodynamically (its loss is ≈ 2 % of the chain: the head and the outlet govern), but it is not the “large” shaft of D7. Options: accept a 1.2 m turn (the shaft 1.2 × 1.1 = 1.32 m²), or move bath 2′s north-east corner (a room change).
- The foot chamber is free of that limit: under the gallery floor it may run south; V-c ends it at the first arcade column (y 8.667), so the outlet fills the first arch of the courtyard arcade, facing the seating along the colonnade line (no channel, the route ≈ 1 m).

### 1.2 · The foot chamber (V-c), the outlet, the door

- Clear 1.20 × 1.97 m (2.36 m²), ≈ 3.1 m high (to the FF slab) and open above into the shaft. The dust trap: a 0.8 × 0.7 floor basin under the shaft (a lift-out stainless grating, a 0.25 m deep sump, a drain to the courtyard drainage); the filtered path’s riser in the north-west corner, its filter cabinet + EC fan (0.45 × 0.60) at the west wall; the cooler’s place at the outlet; a water point (capped until a cooler is bought: the malqaf is a dry system, owner 9 Nov 2026), a floor drain, a dedicated circuit and IP44 sockets.
- The cooler (D9): the common portable desert coolers sold in the Kingdom run from ≈ 45 L tanks (≈ 0.4 × 0.35 × 1.0 m) to 90–150 L (≈ 0.6–0.8 × 0.5–0.7 × 1.3–1.6 m); the chamber is laid out for the larger envelope 0.8 × 0.7 × 1.6 m (ASSUMED: the owner’s shortlist to confirm), rolled in through the door, its outlet against the grille.
- The outlet: 1.4 × 0.9 m in the first arch, sill +0.10, adjustable timber louvres or a pierced precast-concrete grille, rendered and painted (≈ 60 % free, 0.76 m²) aiming the air along the seating; a motorised insulated damper behind it (Phase 4).
- The door: 1.0 m clear, full height (≈ 2.4 m), a carved timber door on the chamber’s south face, opening onto the covered strip (the strip south of the core, 1.55 × 4.2 m, stays the riwaq’s courtyard edge).

### 1.3 · The wind shadows (first estimate; Phase 5 confirms)

- The old house (one storey, ≈ 4–5 m, the owner): for a due-west wind its east face is 13 m upwind of L5 (12.6 m for WSW; nothing upwind for WNW–NW). Its recirculating wake is ≈ R = 7.6 m long and ≈ 1.5–2 H (≈ 7–9 m) high near it: L5 is beyond it, and a head above ≈ +10 is above its decaying wake. ✓
- ⚠ CAUTION · the new house’s own roof matters more: L5 stands 5.1 m behind the west facade, where the flow separating over the parapet and the attic is at its highest: R = 12.5 m, the recirculation bubble ≈ 2.7 m high at 6.2 m from the west edge (L1 sits near its tail, ≈ 11.2 m). With the L1 head’s openings (+10.35 … +11.73) the L5 west face would breathe partly inside the bubble (top ≈ +11.42). Phase 5 to set the L5 openings from ≈ +11.0 up to ≈ +12.6, the crown ≈ +13.2 (≈ 4.5 m above the attic), or accept a weaker west face in a pure west wind (the north face still catches NW).

### 1.4 · The on-site weather station (the owner’s question)

- Where: on the build land at the L5 spot or as close as possible (≈ 6 m east of the M line, ≈ 14 m south of the gate), in the open, not on the old house’s roof (its own disturbance).
- Height: the anemometer ≥ 6 m above the ground, ideally 10 m (the airport’s standard, and the tower head’s ≈ +12 m), on a guyed telescopic mast; a second, cheap sensor at ≈ 4 m would show the old house’s shadow.
- What: an ultrasonic anemometer (no moving parts) or a cup + vane, temperature / humidity, a PM2.5 sensor if possible; 1-minute averages, logged; ≥ 4–6 weeks, the evenings with a west wind included. We compare it with the airport for the same days.

Open questions for the owner (Phase 1): (1) V-c (recommended) with the shaft limited to 0.96 m² by the gallery’s 1.5 m turn, or accept a 1.2 m turn for a 1.32 m² shaft? (2) The riwaq’s first glass panel (y 6.8–8.9, 2.1 m) becomes solid in V-c (the glass door and the 2.0 m south panel stay): OK? (3) The carved door on the chamber’s south face into the covered strip: OK? (4) The Phase 0 answer had blanks: the farm’s distance and direction from the airport, the trees or hills to the west; and whether to add the winter late mornings (Dec– Jan 10:00–13:00 average ≈ 20–23 °C) to the seating hours.

ملخص المرحلة :1 ُقُقورنت ثالثة بدائل للملقف في الركن الشمالي الغربي للفناء. الممر العلوي يفرض حدا: ليبقى عرض االلتفاف 1.5 م عند حمام غرفة النوم 2 ال يتجاوز المجرى في الدور األول 1.2 × 0.8 م صافيا )0.96 م²(، وهذا يكفي هوائيا ألن الخسارة الكبرى في الرأس والفتحة. التوصية:
: غرفة القاعدة في الدور األرضي تمتد إلى أول عمود في الرواق المقّوّو 1.2 × 1.97 م صافيا( وفيها مصيدة الغبار وخزانة المرشحات والمروحة ومكان المبرد الصحراوي المتنقل، وفتحة الهواء 1.4 × 0.9 م داخل أول قوس مقابل الجلسة مباشرة، وباب خشبي منحوت بعرض 1 م. | البديل )ج( س )
النسيم المق ّدّدر نحو 3.5 أضعاف الموقع الحالي. البيت القديم على بعد 13 م غربا فال يحجب الرأس، لكن سقف البيت الجديد نفسه يحدث دوامة فوقه فيجب رفع فتحات الرأس إلى نحو 11+ حتى 12.6+ م )المرحلة 5(. محطة الطقس: على أرض البناء في موضع البرج، بارتفاع 6 م على األقل واألفضل 10 م، لمدة 4–6 أسابيع.

Phase 1 checks passed (5) · sources: data/rooms_gf.csv / rooms_ff.csv (V9.3), studies/structure.typ (C17, C21, B3, B4, R11), 3d/character.yaml (the arcade columns at y 8.667 / 10.833), data/deed_sketch.csv (the old house), ASHRAE Handbook — Fundamentals 2021, ch. 24 (Airflow around buildings: R, Hc, Xc, Lc); cooler sizes from Saudi and Gulf retail listings (Carrefour KSA 90 L, Aftron / Alhayyat / ALM 150 L).

Phase 2 · structure · the L5 core as an independent RC core, the fourth support of the west projection

The owner’s Phase 1 answers applied: V-c, the shaft 1.2 × 0.8 m clear (the gallery’s turn kept at 1.5 m); the riwaq’s first glass panel solid; the carved door on the chamber’s south face; the winter late mornings added (Dec–Jan 10:00–13:00: ≈ 61 % pleasant, ≈ 113 h a year more, ≈ 1812 h in all); no stone (render and paint). Every figure ASSUMED (no soil report, no SBC 301 site data): concept values for the structural engineer.

pad 2.4 × 3 × 0.6

shaft’s S wall from the FF slab (lintel) B4 4.3 m ⁽was 6.50⁾ | B3 4.3 m · R¹¹ 5.5 m
C17 → core | B2 / R1 → C21 → core

arcade col. → core

arcade col.

C22

outlet

door 1.0

PLAN (structure) · 1 m = 0.95 cm

pad −0.60 … −1.20

FF +3.52

roof +7.20

dust trap

cooler

openings
+11.0 … +12.6

crown +13.20

attic +8.68

SECTION N–S at x ≈ 5.1 · y 5.0–9.6

y 6.5 | 8.67

### 2.1 · The core

- An independent RC core (walls 0.20) from its own pad (−0.60) to the head: the shaft on the wall centre lines x 4.4–5.8, y 6.5–7.5 (outer 1.6 × 1.2), the foot chamber’s walls to the arcade column line y 8.667 at the ground floor. Its north wall is the y 6.5 wall rebuilt in RC (the majlis’s face unchanged); the riwaq’s glazing on x 4.25 is not load-bearing and stays a glazing line south of the chamber.
- Absorbed: C17 (4.25, 6.5) into the core’s north-west corner, C21 (5.8, 6.5) into its north-east corner, the decorative arcade column at y 8.667 into the chamber’s south-east corner (it becomes structural). Kept: C22, C23 and the second arcade column (y 10.833).
- One pad 2.4 × 3 × 0.6 m under the core and the chamber (it replaces three pads), with a 0.35 m recess for the dust trap’s sump.

### 2.2 · The fourth support (the owner’s question)

1. B4 (x 4.25): its first span 6.50 → 4.3 m (cast with the chamber’s west wall).
2. B3 (the edge, x 5.80): 6.50 → 4.3 m on the chamber’s east wall; R11 (the roof edge) 6.50 → 5.5 m on the shaft.
3. Reduced: the first-span moments ≈ 56 % less, the deflections ≈ 80 % less: B3 and B4 could drop from 0.25 × 0.50 to ≈ 0.25 × 0.40 there (B3′s upturn stays: it is W1′s sill); C21 is no longer a separate column; the core also stiffens the west projection sideways (the slender C22 / C23 sway less).
4. C21 and C17 disappear as separate members; B2′s and R1′s first span (C17 → C21, 1.55 m) becomes the core’s north wall.
Beam | Line · how | Span was → now (m) | q kN/m | On the core kN
B3 | x 5.80, FF · bears on the chamber’s east wall to the arcade column line | 6.5 → 4.33 | 12 | 52
B4 | x 4.25, FF, drop · cast with the chamber’s west wall (it overlaps the wall’s outer 0.075 m: a local widening or a nib) | 6.5 → 4.33 | 25 | 108.3
R11 | x 5.80, roof · bears on the shaft’s east wall | 6.5 → 5.5 | 10 | 37.5
B2 / R1 | y 6.5, FF / roof · their first span (C17 → C21) is the core’s north wall | 1.55 → – | 10 | 14
Vertical loads (service, ASSUMED) | kN
the shaft’s walls (−0.60 → +7.20) | 162.5
the foot chamber’s walls (less the outlet and the door) | 58.6
the head above the roof (1.6 × 1.6, to +13.20, the cornices, the top slab) | 162.2
the beams and slabs above (the table on the left) | 211.8
total on the pad | 595.1
the pad’s bearing (with its weight) vs 150 kPa assumed | 97.7 kPa

### 2.3 · The tower above the roof: wind and earthquake

- The head is a cantilever 5.9 m above the roof finish, 1.6 × 1.6 m (the shaft 1.6 × 1.2 plus a 0.4 m funnel overhang north on the head’s base slab, D7), its self-weight ≈ 162.2 kN.
- Wind (q 1.1 kPa, Cf 1.3, ASSUMED SBC 301 for Taif to the engineer): 13.5 kN, 39.8 kN·m at the roof.
- Earthquake as a rooftop appendage (SBC 301 / ASCE 7 § 13.3, ap 2.5, Rp 2.5): with Sds 0.15 / 0.25 / 0.35 (ASSUMED range for Taif) Fp = 29.2 / 48.7 / 68.1 kN, 86.1 / 143.5 / 201 kN·m at the roof: the earthquake governs, not the wind. The RC tube takes it easily (≈ 0.31 MPa, the openings ignored): the head is an RC frame (four corner piers ≥ 0.30 × 0.30, a ring beam at the band, one at the crown) with the slender ribs between the openings as non-structural block or precast infill, rendered.
- Connections: the FF slab and the roof slab cast into the core (starter bars), so the core is tied at both levels; the shaft’s openings in the slabs are framed by its own walls (no trimmers); the head’s base slab cantilevers 0.4 m north over the family living’s roof.

### 2.4 · Openings in the core: lintels and limits

- Ground floor: the outlet 1.4 × 0.9 in the east wall (sill +0.10; a lintel at +1.00, the wall above deep); the south wall is the door: a 1.0 m door in 1.2 m clear, i.e. the wall becomes a 1.4 m lintel at +2.40 over it on the east and west walls; the shaft’s south wall starts at the FF slab on a 1.2 m lintel across the chamber.
- First floor and above (Phase 3 / 4): the gallery window into the shaft and the filtered-air grilles ≤ 50 % of a wall’s length, ≥ 0.25 m from the corners, lintels ≥ 0.30 deep.

Open questions for the owner (Phase 2): (1) The head 1.6 × 1.6 with a 0.4 m funnel overhang north, or the head = the core (1.6 × 1.2) with only the cornices projecting? (2) Agree that the head is an RC frame with block / precast ribs between its openings (rendered)?
(3) The Phase 0 / 1 blanks are still open: the farm’s distance and direction from the airport, what lies to the west. For the engineer: the soil report (q allowable), SBC 301 wind and Sds for the site, B3 / B4 sections after the shorter spans, the pad and the slabs’ ties to the core.

ملخص المرحلة :2 الملقف نواة خرسانية مستقلة بجدران 20 سم على قاعدة واحدة )2.4 × 3.0 م( من األساس إلى الرأس، وجدارها الشمالي هو جدار المجلس نفسه بعد صبه خرسانة. تبتلع النواة العمودين 17C و21C وعمود الرواق األول )فيصير إنشائيا(، فتصبح الدعامة الرابعة للبروز الغربي: يقصر بحر الجسرين 3B و4B من 6.5 م إلى نحو 4.3 م )العزوم أقل بنحو ٪55 والترخيم بنحو ٪80(، ويمكن تخفيف مقطعيهما، وتزيد صالبة البروز جانبيا. الحمل الكلي نحو 595 كيلونيوتن، والضغط على التربة نحو 98 كيلوباسكال )مفترض(. الرأس فوق السطح يحكمه الزلزال ال الرياح، وُيُيبنى إطارا خرسانيا بأعمدة في أركانه واألضالع بين الفتحات حشوة غير إنشائية ملّيّيسة. كل األرقام تقديرية للمهندس اإلنشائي.

Phase 2 checks passed (3) · sources: studies/structure.typ (C17, C21, C22, B2, B3, B4, R1, R11, the projection slab), 3d/character.yaml (the arcade columns), SBC 301 / ASCE 7-16 § 13.3 (the appendage formula), the climate script for the winter mornings. Concept only.

Phase 3 · the courtyard’s west face · the malqaf as the head of the colonnade · three options

The owner’s Phase 2 answers applied: the head 1.6 × 1.6 with a 0.4 m funnel overhang north; an RC frame with corner piers and ring beams, the ribs in rendered block; no stone and no marble anywhere, floors included (marble-look porcelain inside, anti-slip R11 porcelain outside, recorded). Render and paint: a light sand render, the projections (the band, the cornices, the arch surrounds) in the calm honey tone. Red dotted: the bay axes (GF arches = FF windows) and the head’s axis. 1

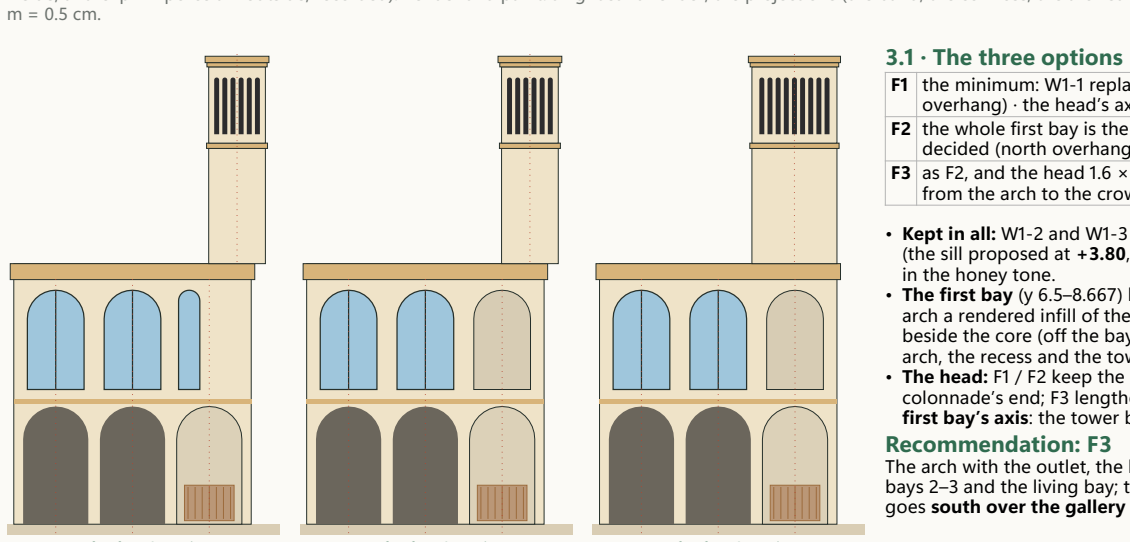
[picture p16: figure]
3.1 · The three options; in the honey tone.; Recommendation: F3

F1 · west face from the seating (N →) | F2 · west face from the seating (N →) | F3 · west face from the seating (N →)
F1 | the minimum: W1-1 replaced by a 0.6 m arched window beside the core (off the bay axis); the head as decided (north overhang) · the head’s axis −0.78 m from the first bay’s axis
F2 | the whole first bay is the malqaf’s: the outlet in the first arch, a blind arched recess above it on the same axis; the head as decided (north overhang) · the head’s axis −0.78 m from the first bay’s axis
F3 | as F2, and the head 1.6 × 2.4 m over the whole first bay (overhang 1.2 m south over the gallery roof, on R11 / R3): one vertical from the arch to the crown · the head’s axis 0.02 m from the first bay’s axis
- Kept in all: W1-2 and W1-3 (bays 2–3) and the three living-bay windows W1-4…6 on their axes; their sill / springing / crown logic (the sill proposed at +3.80, 2.80 m high, on the module); the GF arcade’s bays 2–3 open; the band at +3.40 and the main cornice
- The first bay (y 6.5–8.667) becomes the malqaf’s: at the GF the outlet (1.4 × 1.0, timber louvres) fills the first arch, the rest of the arch a rendered infill of the core; at the FF the core covers the north 0.8 m of W1-1, so W1-1 goes: F1 puts a narrow 0.6 m window beside the core (off the bay axis: ⚠ D11); F2 and F3 make a blind arched recess (1.6 × 2.80, 0.10 deep, render) on the bay axis: the arch, the recess and the tower read as one.
- The head: F1 / F2 keep the decided north overhang: the head stands 0.78 m north of the first bay’s axis, half of it beyond the colonnade’s end; F3 lengthens the head south over the gallery roof (1.6 × 2.4 m, its walls on R11 and R3) so it rises exactly on the first bay’s axis: the tower begins the colonnade.

The arch with the outlet, the blind arch and the head on one vertical axis make the malqaf the head of the row without touching bays 2–3 and the living bay; the head grows to 3.84 m² (a bigger funnel, D7). It changes one Phase 2 answer: the funnel overhang goes south over the gallery roof (1.2 m) instead of north (0.4 m). If the owner keeps the north overhang: F2.

Phase 3 · from the courtyard looking north · from the riwaq · the gallery’s grille into the shaft · the filtered-air grilles · D11

carved
door

gallery (end-on)

lost

looking NORTH from the seating (W ←)

the core’s west face
(was glass 6.8–8.9)

bench

filtered air

glass door

B4 (soffit +3.10)

the RIWAQ looking east (N ←)

family living

bath 2

arched grille 0.8 × 1.6
+ insulated damper

filtered → living

filtered → gallery (high) W¹⁻² →

1.50

FF plan of the core · 1 m = 1 cm

### 3.2 · The gallery’s window into the shaft (path a, clear days)

- On the shaft’s south face at the FF (facing the gallery’s turn): an arched carved-timber grille 0.8 × 1.6 (sill +4.20, springing +5.40, a semicircular head; the W1 language in small) with an insulated, low-leakage motorised damper behind it in the wall: nothing swings into the 1.5 m passage or into the 0.8 m shaft. Owner (9 Nov 2026): a provision only: the opening formed and the grille fitted with a sealed removable panel behind it, no damper now; it reads as a carved panel.

### 3.3 · The filtered-air grilles (path b)

- From the fan in the foot chamber up the sealed riser: a high linear grille (0.8 × 0.2) through the core’s north wall into the family living (+6.4, acoustically lined), one on its south face into the gallery (+6.4, above the timber grille); at the GF high grilles into the riwaq (the core’s west face, +2.7) and the women’s majlis (its north wall, +2.7). D10 kept: no bedroom touches the core.

### 3.4 · What else changes

- ⚠ CAUTION · the women’s majlis loses its small courtyard glass panel at x 5.1–5.6 (0.5 m, inside the core’s north wall); its main courtyard glass x 6.0–8.1 stays.
- The riwaq’s first panel (y 6.8–8.9) becomes the core’s rendered west face: a built-in timber bench along it (the riwaq’s resting place) and the high filtered-air grille.
- The carved door (1.0 × 2.4, a semicircular head) faces the covered strip, seen from the seating beside the first arch.

### 3.5 · D11 compatibility (not designed here)

- On the module: every new size above (checks below); W1′s sill at +3.80 (not +3.82) makes it 2.80 m high.
- ⚠ CAUTION · D11 bands around each W1 (1.6 + 2 × 0.30 = 2.20 m) are wider than the arcade’s bay (2.1667 m): the bands of neighbouring windows would overlap. The facade study should read D11 on this face as shared pilaster bands on the column axes (0.30, 1.87 m clear between them, W1 1.6 inside): the GF columns and the FF pilasters on the same axes.
- ⚠ CAUTION · the arcade’s bays (6.50 / 3 = 2.1667 m) are not on the 20 cm module (the structure’s grid): keep them, or adjust at the facade study.

Open questions for the owner (Phase 3): (1) F3 (the head 1.6 × 2.4 over the first bay, its overhang south over the gallery roof, on the colonnade’s axis) or F2 (keep the decided 1.6 × 1.6 with the north overhang)? (2) The gallery’s “window” into the shaft as a carved arched grille with an insulated damper behind it (not an opening casement): OK? (3) W1′s sill at +3.80 (on the module): OK? (4) The bench along the riwaq’s new solid wall: OK? (5) The farm’s location and what lies to the west are still blank.

ملخص المرحلة :3 يصبح الباكية األولى من الرواق المقّوّوس باكية الملقف: في األرضي فتحة الهواء بشيش خشبي داخل القوس األول، وفي العلوي قوس أعمى غائر بنفس محور القوس )بدل النافذة األولى التي تغطيها النواة(، وتبقى النوافذ األخرى على محاورها فوق أقواس األرضي. التوصية 3F: يمتد رأس البرج جنوبا فوق سقف الممر )1.6 × 2.4 م( ليقوم تماما على محور الباكية األولى، فيبدأ البرج صف األعمدة بخط رأسي واحد من القوس إلى التاج؛ وإن بقي البروز شماال كما تقرر فالخيار 2F. نافذة الممر إلى المجرى شبكة خشبية منحوتة مقّوّوسة خلفها خانق معزول، ومخارج الهواء المرشح عالية إلى الممر وجلسة العائلة والرواق والمجلس. يفقد المجلس لوح زجاج صغيرا )0.5 م(، وفي الرواق كنبة خشبية على الجدار الجديد. مالحظة لدراسة الواجهات: أشرطة 11D حول كل نافذة أعرض من الباكية، فاألفضل أن تكون أكتافا مشتركة على محاور األعمدة.

Phase 3 checks passed (3) · sources: 3d/params.yaml (W1, W2), 3d/character.yaml (the arcade), presentation.typ (the courtyard glass), studies/roof.typ (the cornice, the band). Render and paint only (owner, 9 Nov 2026).

Phase 3 · addendum (owner, 9 Nov 2026) · the riwaq and the strip at eye level, the chamber door open

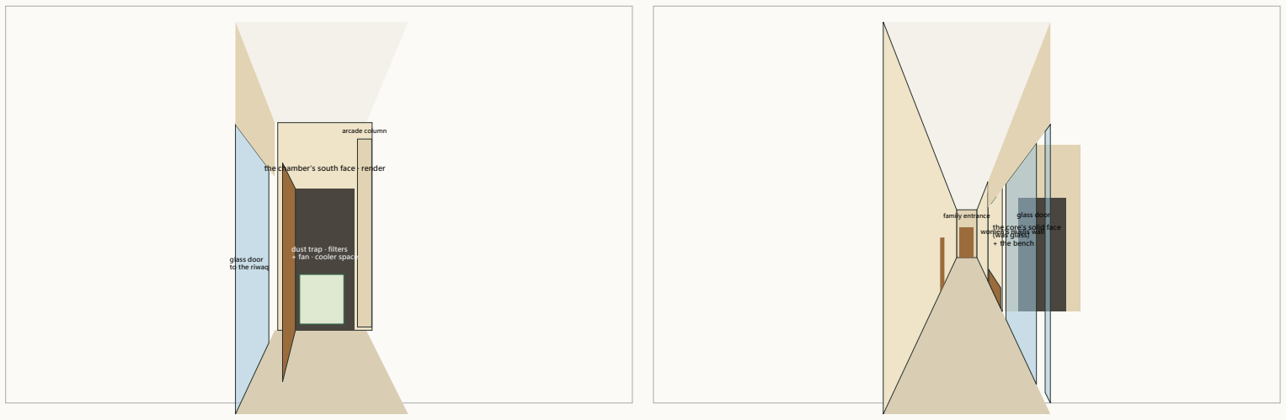
[picture p17: figure]
the chamber’s south face · render; dust trap · filters + fan · cooler space glass door; to the riwaq; arcade column; the core’s solid face (was glass) + the bench; glass door; women’s majlis wall; family entrance

A · in the covered strip, 2.8 m from the chamber, looking north (the door open)

B · in the riwaq, 3.5 m before the glass door, looking north

### What the eye sees

- A · from the covered strip: the strip’s north end is now the chamber’s rendered south face with the carved door (1.0 × 2.4, a semicircular head) opening onto the strip; the glass door to the riwaq on the left, the first arcade column on the right and, beyond it, the courtyard. The door open shows the dust trap’s grating, the filter cabinet and the free space for a cooler. Nothing is seen of the outlet from here (it faces the courtyard, on the chamber’s east face).
- B · from the riwaq: the riwaq’s courtyard side reads, from near to far, the glass panel, the glass door, then 2.4 m of solid rendered wall (the core’s west face, the bench along it at +0.45, the small high grille of filtered air), then the women’s majlis wall. The riwaq keeps its light from the glass door and the south panel; the solid piece ends the glass where the majlis wall begins, so it reads as one wall from the majlis to the glass door, not as a lost window.

### Before fixing the riwaq’s solid wall

- The strip’s first panel (y 6.8–8.9) was glass only because the enclosure study glazed the whole riwaq edge; with the chamber behind it, glass would show a plant room. Recommendation: the solid face with the bench, as drawn; the alternative, a high clerestory strip of obscured glass (+2.2 … +2.6) above the bench, would light the chamber a little and keep a line of glass: the owner’s call, both work.

Both views: one-point perspectives, the eye 1.6 m above the floor; the finishes render and paint (the walls light sand), porcelain floors (owner, 9 Nov 2026); the furniture omitted. The 3D renders of Phase 5 show the same corner from the courtyard.

ملحق المرحلة :3 منظوران بمستوى العين: )أ( من الممر المسقوف نحو الشمال: نهاية الممر صارت واجهة غرفة القاعدة الملّيّيسة وفيها الباب الخشبي المنحوت مفتوحا يكشف مصيدة الغبار وخزانة المرشحات ومكان المبرد؛ باب الفناء الزجاجي يسارا وعمود الرواق يمينا. )ب( من الرواق نحو الشمال: لوح الزجاج ثم الباب الزجاجي ثم 2.4 م من جدار مصمت ملّيّيس )وجه النواة الغربي( عليه الكنبة الخشبية ومخرج الهواء المرشح عاليا، ثم جدار مجلس النساء؛ فُيُيقرأ جدارا واحدا من المجلس إلى الباب الزجاجي ال نافذة ضائعة. التوصية: الجدار المصمت مع الكنبة، والبديل شريط زجاج معتم عا ٍلٍل فوقها.

Phase 4 · the air system · two paths after the head · dampers · positive pressure · exhausts

The owner’s Phase 3 answers applied: F3 (the head 1.6 × 2.4 over the first bay, the overhang south over the gallery roof), the carved grille (a sealed provision), W1′s sill +3.80, the bench, the majlis’s 0.5 m panel lost, D11 as shared pilasters later. Owner, 9 Nov 2026: keep it simple: a family home, not a smart building (§ 4.6). Every figure ASSUMED: the MEP engineer designs and sizes it.

head: 4 faces
bird mesh
+ divider + flaps

the south overhang (F3)

(a) breeze
shaft

# 0.84 m² (b⁾ riser Ø³¹⁵ dust trap

cooler
(option) filters
+ fan

D1 top damper (+7.75)

outlet 1.4 × 1.0
+ D2 damper

gallery grille
+ D3 damper
(b) inlet: a hood under the overhang, +7.6, never closes intake duct in the chamber’s SE corner

→ family living (N), gallery (S)

→ riwaq (W), women’s majlis (N)

SECTION N–S through the core (y 5.8–9.6, stretched ×2.2) | 4.1 · The two paths after the head
- The head (Phase 5): four faces of slender openings +11 … +12.6 behind a 20 mm bird / leaf mesh; inside, the + divider and the four back-draught flaps (the windward quarter feeds, the leeward quarters shut).
- (a) The breeze path: the head → D1, the top damper at the shaft’s head (+7.75, 1.2 × 0.8) → the shaft (0.84 m²) → the dust trap (a 0.8 × 0.7 × 0.3 basin under the shaft, a lift-out grating, a drain) → the foot chamber → the courtyard outlet 1.4 × 1.0 with its louvres and D2 behind them → the seating. Provision only (owner): the gallery’s carved grille, closed and sealed behind a removable panel, no damper now. No filter: mesh only, by design (D3 of the owner).
- (b) The filtered path: its inlet never closes: a downward-facing hood (0.6 × 0.6, a bird mesh) under the head’s south overhang (+7.6; rain- and dust-shadowed, 3.4 m below the breeze openings), a Ø315 duct down the chamber’s south-east corner → the filter cabinet (ISO Coarse 60 % (G4), washable synthetic, 500 × 500 × 48 → ISO ePM1 ≥ 50 % (F7 class), 500 × 500 × 292 bag or compact; ePM2.5 ≥ 65 % if the PM2.5 log asks for more) → the EC fan (750 m³/h at 250 Pa, ≈ 160 W) → a silencer (a 0.9 m lined attenuator, ≈ −15 dB) → a sealed Ø250 riser in the shaft’s west side → high grilles into the family living and the gallery (+6.4), and at the GF the riwaq and the women’s majlis (+2.7); the other GF rooms through the riwaq (door undercuts / transfer grilles, as the house’s air moves anyway). The kitchen hood’s interlocked make-up inlet is mandatory (owner; ≈ 300 m³/h, studies/
air_system.typ).

### 4.2 · The dampers (two, insulated, low-leakage, spring-return)

- D1 at the shaft’s head and D2 behind the outlet’s louvres: both insulated, low-leakage, spring-return (they close on power loss), driven together by the one wall switch MALQAF open / closed and closed by the dust relay. No D3 (the gallery grille is a sealed provision). D4: a passive gravity louvre Ø160 from the chamber to the outlet (no motor). The hood’s make-up damper: its own, interlocked with the hood (mandatory).

### 4.3 · Positive pressure and the hood

- The fan supplies 325 m³/h (normal) / 704 (boost) into a tight envelope (D5); the extracts (the bathrooms, ≈ 150–250 m³/h continuous, the dryer) are smaller: the house runs at ≈ +5–10 Pa (the fan’s speeds set once at commissioning; no sensor). Every door is undercut 15 mm or has a transfer grille so the pressure is one.
- ⚠ CAUTION · the kitchen hood (600–1 000 m³/h) exceeds the supply fan: without its make-up inlet the house would go negative and pull dust through every crack and the malqaf’s grille. The interlocked make-up inlet (filtered, motorised, opens with the hood) is mandatory (owner, 9 Nov 2026); the fan does not replace it.

### 4.4 · Exhausts and plumes relative to the head (openings +11 … +12.6)

Source | Distance | Position
bathrooms' extract (the west stack's vent) | 5.7 m | ⚠ UPWIND in a W wind: re-routed in the attic to the south-east strip (owner, 9 Nov 2026)
kitchen hood outlet (east wall) | 12.4 m | downwind, 7.5 m, 8.8 m below the openings
east stack's vent | 8.7 m | downwind, 7.3 m
AC condensers Z2b (hot air) | 5.8 m | east, 3.7 m in plan from the head’s east face, 3.1 m below the openings; their hot plume rises leeward in a W wind
the plumbing's drain vents (the east stack, the family WC's stack) | 8.7 m | south-west, 6.4 m; terminals ≥ 1.5 m above the roof
the LPG cabinet, the generator point (the yard) | 14 m | downwind, ≥ 8 m, 11 m below

⚠ CAUTION · the bathrooms’ vent in the west shaft is the one source upwind in the summer-evening west wind: its terminal must end ≥ 1.5 m above the roof (+8.8), 2.2 m below the head’s openings and 3.6 m away, or, decided by the owner (9 Nov 2026): re-routed in the attic to the south-east strip (Phase 6 checklist).

Phase 4 · insulation and moisture · sensors · the control modes · maintenance · performance

### 4.5 · Insulation, acoustics, moisture

- The core’s walls facing the gallery and the family living: 200 RC (Rw ≈ 55 dB) + 50 mm mineral wool and a 2 × 12.5 board lining on the room side (the breeze shaft stays smooth render inside); the fan’s cabinet acoustically lined, on anti-vibration mounts; the filtered-air grilles with 0.6 m lined duct before them.
- Thermal: D1 and D3 insulated blades; the shaft’s walls facing rooms with 50 mm insulation inside the lining (the shaft is outdoor air in winter).
- The foot chamber (wet): tanked to +0.30 and a fall to a trapped gully (a trap primer), the dust trap in GRP, the cooler’s space with a drip tray (an option only, D9: the malqaf is a dry system), the water point capped, IP44 sockets at +1.2 on their own RCD circuit, a lockable isolator; the passive D4 louvre so the chamber never stays damp.

### 4.6 · Controls (owner, 9 Nov 2026: a family home, not a smart building)

- Two wall switches by the courtyard door: (1) MALQAF open / closed (D1 + D2 together, a lamp); (2) HOUSE FAN normal / boost. One automatic safety: an outdoor dust sensor relay (PM2.5 > 50 µg/m³ for 10 min → D1 and D2 close by themselves, the lamp shows “dust”; they reopen when the air is clean for 30 min if the switch is on). Every damper spring-return: closed on power loss. No controller, no modes. A mechanical filter gauge on the cabinet (change the fine filter at 200 Pa). Winter nights, dust seasons, holidays: the family turns switch 1 off.

### 4.8 · Maintenance (all from the carved door at ground level)

What | How | When
the dust trap | lift the grating, sweep / vacuum the basin, hose to the drain | monthly; weekly in Mar–Apr
the pre-filter | slide out, wash, dry, back | monthly (the dP light)
the fine filter | replace | ≈ 6 months (dP 200 Pa)
the cooler | tank and pads cleaned; drained and parked for winter | weekly in summer; Oct
the dampers D1–D4 | stroke test, seals | yearly (before spring)
the gully trap, the drain | fill / flush | monthly
the outlet louvres, the grilles | brush | 3 months
the head’s mesh and flaps | the roof hatch only: brush the mesh, free the flaps | yearly; after a dust storm

### 4.7 · What the two switches do

Switch | ON | OFF
1 · MALQAF | D1 + D2 open: the courtyard breeze, whenever the family finds the evening pleasant (Phase 0: ≈ 1 800 such hours a year) | D1 + D2 shut: winter, dust, away. The dust relay forces OFF while the air is dirty
2 · HOUSE FAN | boost (704 m³/h): guests, after a dust day, a full house | normal (325 m³/h): always on; the filtered path never stops; the hood’s own make-up inlet opens with the hood

### 4.9 · Rough performance (ASSUMED, for the MEP engineer)

- The breeze (Normal): at the summer-evening mean wind (21 km/h at 10 m) ≈ 1.82 m³/s through the outlet (≈ 2.2 m/s at the louvres, ≈ 0.5–0.8 m/s at the seating 2 m away: a clearly felt breeze); at 10 km/h ≈ 0.86 m³/s (gentle); in a calm the stack alone ≈ 0.15 m³/s. L1 (V9.3) at 21 km/h ≈ 0.42 m³/s: ≈ 4.3 × (Phase 1 said 3.5 with the smaller head; F3′s head is larger).
- If a cooler is added later (an option, D9): a 90–150 L portable cooler moves ≈ 0.8–1.4 m³/s and cools the dry afternoon air from ≈ 35 to ≈ 20–22 °C (Phase 0: RH 12–20 %); its water ≈ 15–25 L/h; the jet along the seating ≈ 1 m/s. The courtyard is open to the sky: it cools the people in the jet, not the courtyard.
- Winter: the breeze closed; the fan at its minimum ≈ 150 m³/h costs ≈ 0.51 kW at 10 K (≈ 1.11 kW at the normal rate): small; no heat recovery (D2 of the owner), so the family leaves the fan at normal and sets boost when the house is full.
- Dust: the relay has shut the breeze; the fan (boost if the family sets it) with the fine filter (≥ 50 % of PM1, ≈ 80 % of PM2.5) holds the indoor PM2.5 at roughly a quarter of the outdoor level during a 150 µg/m³ event (the house tight, D5).

Answered by the owner (9 Nov 2026): the filters and the fan in the foot chamber with a silencer; the gallery grille a sealed provision; the cooler an option (the malqaf a dry system); the bathrooms’ vent re-routed to the south-east; the hood’s make-up inlet mandatory; wall switches only, one dust relay, spring-return dampers; F3 provisional on one section (Phase 5); the riwaq at eye level (Phase 3 addendum).

ملخص المرحلة :4 بعد رأس البرج مساران: )أ( مسار النسيم الكبير بال مرشح )شبك طيور فقط(: خانق علوي 1D، ثم المجرى، ثم مصيدة الغبار في القاعدة، ثم فتحة الفناء 1.4 × 1.0 م بخانق 2D خلف الشيش؛ وشبكة الممر العلوي تجهيز فقط مغلق ومحكم. )ب( المسار المرشح الصغير: مدخل ال ُيُيغلق أبدا تحت بروز الرأس الجنوبي، ثم مرشح خشن قابل للغسل ومرشح ناعم ومروحة هادئة 750 م/³س مع كاتم صوت في غرفة القاعدة، تدفع ًء هواًء مرشحا إلى الممر وجلسة العائلة والرواق والمجلس فيبقى البيت تحت ضغط موجب. التحكم بسيط كما قرر المالك: مفتاحان على الجدار )الملقف مفتوح/مغلق، والمروحة عادي/قوي( وأمان آلي واحد: حساس غبار يغلق الخانقين بنفسه في الغبار، وكل الخوانق ُتُتغلق عند انقطاع الكهرباء. ال وحدة تحكم وال أنماط. المبرد الصحراوي خيار فقط )مكان ومقبس وتصريف، والماء مسدود(؛ تهوية الصرف الغربية ُتُتحَّوَّول إلى الجنوب الشرقي؛ مدخل الهواء التعويضي لشفاط المطبخ إلزامي. الصيانة كلها من الباب المنحوت في الدور األرضي. النسيم المق ّدّدر نحو 1.8 م/³ث في مساء صيفي عادي.

Phase 4 checks passed (4) · sources: studies/air_system.typ (the ventilation rates 325 / 704 m³/h, the hood’s make-up, the loss chain), studies/plumbing.typ (the vents), studies/roof.typ (Z2b), ASHRAE 62.1 / 62.2-2022, ASHRAE 62.1 Table 5-1 (separations), ISO 16890 (the filter classes), EN 1751 (damper leakage classes). Concept only.

## Phase 5 · the tower head · F3 on the roof beams · visibility · shadows · roof access

Short, as the owner asked. The head 1.6 × 2.4 (F3): an RC frame with 0.30 corner piers and ring beams at the band (+10.6) and the crown (+12.9), the slender ribs in rendered block; render and paint: light sand, the band, the crown and the slot surrounds in the calm honey tone, every projection formed in the structure with a drip. The openings +11.2 … +12.6 on all four faces (the W and N faces matter, Phase 0); the crown +13.2 (4.5 m above the attic coping, 5.9 above the roof finish).

attic +8.68

bubble ≈ +11.4

N face (1.6)

+7.30 roof finish

attic +8.68

bubble ≈ +11.4

W face (2.4)

+7.30 roof finish

R3 widened
0.25 → 0.40

R11
(as is)

gallery roof +7.30

the head’s W and E walls
on R3 and R11

E–W section · y ≈ 8.2 · 1 m = 1.24 cm

the south wall (y 8.7) on a new 1.55 m beam R-L5 (0.25 × 0.45) between R3 and R11

### 5.1 · F3 on the existing roof beams (the owner’s condition)

- East wall (centre x 5.80): on R11 as it is (0.25 × 0.45, C21 → C22). West wall (centre x 4.40): on R3 (x 4.25, 0.25 wide) widened to 0.40 (faces 4.125–4.525) over y 6.5–8.8, cast with the roof slab: the wall (4.30–4.50) then bears fully. South wall (y 8.6–8.8): on a new short beam R-L5 (1.55 m, 0.25 × 0.45) between R3 and R11 under the slab. North part (y 6.4–7.6): the core’s own walls from the foundation.
- Verdict: F3 stands on the existing beams with two small additions (0.15 m more on R3 over 2.3 m, one 1.55 m beam). If the engineer refuses them, F2 (the head 1.6 × 1.6 on the core alone, the north overhang) is the fall-back; nothing else changes.

### 5.2 · Openings and mesh

- 3 slots on the short faces, 5 on the long: free ≈ 0.83 / 1.38 m² per face (the W face the main catcher); 20 mm bird mesh in galvanised frames behind the slots, the + divider and the four back-draught flaps inside; a 0.5 m hatch in the head’s west face (+7.6 … +8.1) from the roof for the mesh, once a year.

### 5.3 · Visibility (the method of studies/malqaf_tower.typ)

From | Seen above the roofline
the gate (the char_gate camera) | hidden
the north boundary, 6.1 m off the facade | hidden
the north street, 14 m off the facade | 1.9 m
the far side of the street, 25 m | 3 m
the courtyard seating | 5.8 m: the whole tower rises from the sky hole’s west edge
- ⚠ CAUTION · unlike L1, L5 is not seen from the gate or the north boundary (it stands 6.4 m behind the north facade): the symbol reads from inside the house (the courtyard, the gallery) and from the street beyond ≈ 10 m; from the gate the house shows its plain roofline.

### 5.4 · Shadows on the courtyard (the head’s top 13.2 m above the courtyard floor; sun positions ASSUMED)

Sun | alt / az | shadow | Where
winter noon | 45.2° / 180° | 13.1 m | off the courtyard (north / west: the family living’s and the gallery’s roofs)
winter 15:30 | 27° / 228° | 25.9 m | off the courtyard (north / west: the family living’s and the gallery’s roofs)
summer noon | 88° / 180° | 0.5 m | off the courtyard (north / west: the family living’s and the gallery’s roofs)
summer 15:00 | 50° / 272° | 11.1 m | across the courtyard’s north part to y ≈ 7.7 at the east wall: welcome shade on the seating’s north end
summer 17:30 | 20° / 290° | 36.3 m | across the courtyard’s north part to y ≈ 9 at the east wall: welcome shade on the seating’s north end
- Winter: the tower shades nothing in the courtyard (its shadow goes north). Summer afternoons and evenings: a moving band of shade across the seating’s north half, 1.6–2.4 m wide: welcome. Mornings: the shadow falls west, outside the courtyard.

### 5.5 · The roof

- The head stands inside the attic (x ≥ 0.875 ✓); the courtyard sky hole’s guard (1.10, black steel) now starts at the head’s south-east corner (y 8.8) instead of C21: the head’s wall is the guard for y 6.5–8.8. The north-block walkway (x 3.5) passes 0.8 m west of the head: the mesh hatch opens onto it. Distances: the tank Z3 (x 2.85–4.15, y 1.0–3.5) ≈ 2.9 m north-west, the condensers Z2b (x ≥ 9.6) 3.7 m east, the west stack’s vent re-routed away (Phase 4).
- Removed with L5: the L1 tower, its plant room and plenum at the north-east corner; the attic’s north-east corner returns to its V9.1 pentagon.
5.6 · 3D
- Rendered on a copy of the adopted model (3d/malqaf_L5_views.py: the L1 tower, plant room and plenum taken out, the roofline rings rebuilt, the L5 core and head added in render colours; the adopted files untouched): the next page, from the courtyard seating and from the gate. The L1 shaft’s interior walls at the north-east corner stay in the copy (not visible from these cameras).

ملخص المرحلة :5 رأس البرج 1.6 × 2.4 م إطار خرساني بأعمدة في األركان وجسور ربط عند الحزام والتاج، واألضالع بين الفتحات بلك ملّيّيس؛ لياسة ودهان: رملي فاتح، والحزام والتاج وإطارات الفتحات بلون عسلي هادئ، وكل بروز مصبوب مع الهيكل. الفتحات من 11.2+ إلى 12.6+ فوق دوامة السطح، والتاج .13.2+ يقوم 3F على الجسور الحالية بإضافتين صغيرتين: توسيع 3R بمقدار 15 سم على 2.3 م، وجسر قصير 1.55 م تحت الجدار الجنوبي؛ وإال فالبديل 2F. البرج ُيُيرى كامال من جلسة الفناء )نحو 5.8 م( ومن الشارع على بعد 14 م فأكثر )نحو 1.9 م(، وال ُيُيرى من البوابة وال من الحد الشمالي ألنه خلف الواجهة بنحو 6.4 م: رمز البيت من الداخل ال من البوابة. ظالله صيفا بعد العصر تعبر شمال الفناء على الجلسة )مرغوب(، ًء وشتاًء تقع شماال خارج الفناء. الصور ثالثية األبعاد في الصفحة التالية على نسخة من النموذج.

Phase 5 checks passed (4) · sources: studies/structure.typ (R3, R11), studies/roof.typ (the attic, the guard, the walkways, Z2b, Z3), 3d/character.yaml (the gate camera), studies/sections.typ (the noon sun), studies/malqaf_tower.typ (the visibility method). Concept only.

## Phase 5 · L5 in 3D (a copy of the model; render and paint; style study, provisional)

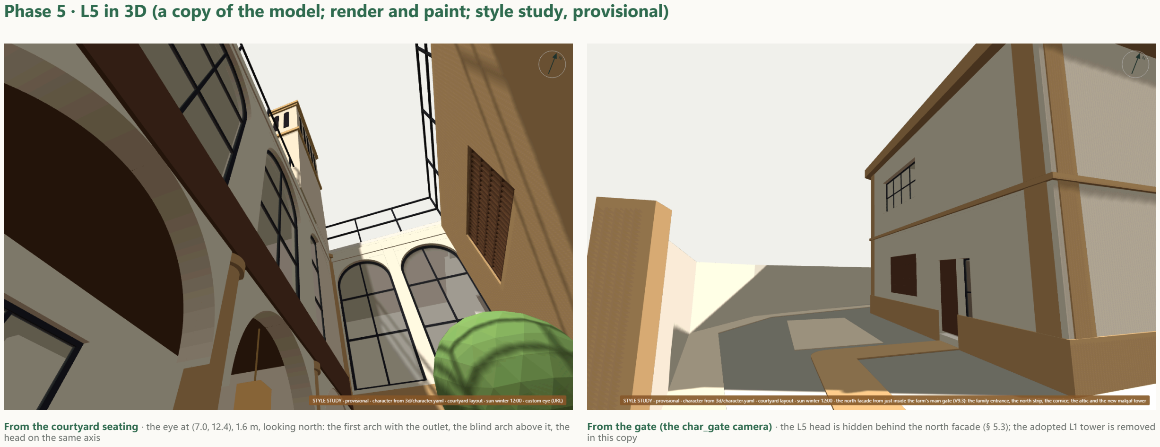
[picture p18: page 12]

From the courtyard seating · the eye at (7.0, 12.4), 1.6 m, looking north: the first arch with the outlet, the blind arch above it, the head on the same axis

From the gate (the char_gate camera) · the L5 head is hidden behind the north facade (§ 5.3); the adopted L1 tower is removed in this copy

## Phase 6 · the decision sheet · L5 (V-c + F3) against L1 (V9.3), L2 for reference

The owner’s Phase 5 answers: the gate visibility does not change his view (the tower is the symbol from the courtyard, where the family lives; the breeze at the seating is the goal, D1); the riwaq’s solid wall with the bench; F3 with the two beam additions (R3 widened to 0.40 over 2.3 m, one 1.55 m beam), F2 the fall-back. Every figure ASSUMED the engineers confirm.

Criterion | L5 · the courtyard’s north-west corner (V-c + F3) | L1 · the north-east cut corner (V9.3, adopted) | L2 · reference
Breeze at the seating (L1 = 1.00; the same wind, assumed) | ≈ 4.3 (≈ 1.8 m³/s at 21 km/h: the outlet in the first arch, no channel) | 1.00 (≈ 0.42 m³/s: 10.6 m of channel, the outlet under the TV) | ≈ 1.1
Breeze route, shaft foot → the seating | ≈ 1 m | ≈ 10.6 m | ≈ 2 m
Filtered-air intake (cleanliness) | good: a never-closing hood under the overhang, every exhaust ≥ 5.7 m, the west vent re-routed | best: the NE corner, the vents 8.3 m, the condensers 4.6 m | fair: 2.7 m to the condensers
Rooms taken | the covered strip 3.5 m² (a by-product, D6), the gallery 1.7 m², the riwaq’s 2.1 m glass panel, the majlis’s 0.5 m panel | the maid bath −0.8 m², bedroom 1 −0.8 m² (+ a store and a cupboard) | the women’s majlis −1.4 m², the family living −1.4 m²
Bedrooms touched (noise, fear) | none (D10: GF the courtyard, FF the gallery) | bedroom 1 shares the shaft’s wall; the maid bath below | none
Structure | an independent RC core from its own pad; the head an RC frame (earthquake governs) | a slim shaft in the cut wall, the tower on W3 with a ring beam, a plenum box | best: on W3 and the courtyard wall
Help to the west projection | yes: the fourth support, B3 / B4 first spans 6.50 → 4.33 m, C17 and C21 absorbed | none | none
Maintenance access | all from the carved door at ground level the roof hatch once a year for the mesh | a 0.4 m panel in the maid bath + the roof hatch; the channel’s 8 floor covers | a panel in the majlis
Cooler readiness (option, D9) | yes: the space, a power point, a drain in the foot chamber | no: a 0.9 × 0.2 channel in the slab, no room | cramped
Winter closing | D1 + D2 shut by the switch; the house unaffected | the top damper; the channel’s covers in the laundry and kitchen floors | a damper
Facade / character | the tower begins the colonnade: the outlet arch, the blind arch and the head on one axis; W1-1 lost | a tower on the attic’s north-east corner, apart from the courtyard | a tower over the majlis corner
Seen from the gate · the street (14 m) | hidden · 1.9 m | 3.3 m · 4.1 m | hidden · 1.4 m
Seen from the courtyard seating | 5.8 m, the whole tower | ≈ 1 m of the crown | 4.9 m
Shadows on the courtyard | summer afternoons: a band of shade on the seating’s north half winter: none | none (far corner) | summer afternoons on the north part
Cost index (assumed; the HRV dropped in all, D2) | ≈ 1.2: the core and pad, the head frame, the door, the beam additions; minus the slab channel, the covers, the plenum, the NE shaft and tower; B3 / B4 lighter | 1.00 (V9.3) | ≈ 0.9

Green = better, amber = a price, red = a drawback. L2 from studies/malqaf_tower.typ pages 6–7 (the courtyard’s north-east corner in the women’s majlis), re-based on L1 V9.3 = 1.00.

### Recommendation

L5. It serves the owner’s goal (D1) about four times better than L1 at the seating, touches no bedroom, is cleaned from a door at ground level, holds a cooler, strengthens the west projection and puts the symbol where the family lives. Its prices are the covered strip’s north end and 1.7 m² of the gallery, one gallery window turned into a blind arch, two glass panels, a cost index of ≈ 1.2 and a tower that the gate does not see. L1 stays the cleanest intake and the one seen from the gate; it remains the adopted design until the owner adopts L5.

### Open items for the engineers (on adoption)

Who | What
Structural | the soil report (the pad’s bearing, assumed 150 kPa); the core’s walls and pad, the ties to the FF and roof slabs; B3 / B4 re-sized for 4.33 m spans; R3 widened, the new R-L5; the head frame for wind and earthquake (Sds for the site); the first arcade column as a structural member; the slab openings closed at the north-east corner
MEP | the fan (750 m³/h, 250 Pa) and its silencer; the filters (ISO Coarse 60 % + ePM1 ≥ 50 %); D1 / D2 insulated spring-return dampers and the dust relay (PM2.5 50 / 25 µg/m³); the outlet louvres and the gallery / living / riwaq / majlis grilles; the hood’s make-up inlet (mandatory); the west vent re-routed to the south-east; the chamber’s gully, the capped water point, the IP44 circuit; the breeze estimate (≈ 1.8 m³/s) confirmed
Owner | the on-site weather station (≥ 6 m, 4–6 weeks); a cooler shortlist (the 0.8 × 0.7 × 1.6 m envelope); the carved door and the outlet grille as joinery
Already recorded | the facade study (open item 20) and D11 (open item 21) for the facades phase after the plan freeze; no stone, render and paint; porcelain floors

## Phase 6 · the adoption checklist (the commit “L5 adopted”, then the release V10.0)

Where | What changes if L5 is adopted
Data | data/rooms_gf.csv: the maid bath and the maid room back to their V9.1 polygons, the maid store removed; the courtyard polygon less the core (x 4.25–5.80, y 6.5–8.767); data/rooms_ff.csv: bedroom 1 back to its V9.1 polygon (no slanted inner wall), the cupboard removed; the upper gallery less the shaft (x 4.25–5.80, y 6.5–7.6); data/decisions.csv: the adoption row (L5 · V-c · F3 · D1–D11 · the simple controls)
Plans | design_gf.typ: tower-pts → the L5 shaft; the women’s majlis’s 0.5 m courtyard glass panel removed; the riwaq’s glass y 6.8–8.9 → the core’s solid face with the bench; the chamber’s carved door; the outlet in the first arch; the maid bath’s fixtures free again (no channel); design_ff.typ (via ff_family.typ): the shaft in the gallery, W1-1 replaced by the blind arch, bedroom 1 V9.1 with its first cut window back at y 1.6–3.2
Air | studies/air_system.typ: v3 → L5: the shaft, the head (+11.2 … +12.6, crown +13.2), the foot chamber, the dust trap, the outlet 1.4 × 1.0 + D2, D1, the filtered path (the inlet under the overhang, the filters, the 750 m³/h fan, the silencer, the grilles), the two switches and the dust relay, the cooler space (option); removed: the HRV, the plant room, the plenum, the breeze channel under the maid bath and its covers; kept: the hood’s make-up inlet (mandatory); docs/AIR_SYSTEM.md rewritten
Roof | studies/roof.typ: the head polygon and levels, the plant room zone removed, the attic’s north-east corner back to V9.1, the sky hole’s guard from the head’s SE corner, the walkway and the mesh hatch, the sight lines; the west stack’s vent re-routed to the south-east (with studies/plumbing.typ)
Structure | studies/structure.typ: the RC core and its pad, C17 and C21 absorbed, the first arcade column structural, B3 / B4 spans 6.50 → 4.33 (sections to re-check), R3 widened to 0.40 over y 6.5–8.8, the new beam R-L5 (1.55 m), the head frame (ring beams at the band and the crown), the slab ties; removed: B15 / R9 and the slim shaft’s wall at the north-east corner (the slabs close)
Other studies | east_wing.typ (the V9.1 maid wing, the tower polygon removed, the expected total in tools/check.py), ff_family.typ, ff_suite.typ, plumbing.typ (the maid bath, the chamber’s gully, the hrv-intake point, the constraint text removed), gf_shower.typ, site_plan.typ (the intake point), courtyard_enclosure.typ / courtyard_layout.typ (the first bay’s outlet, the blind arch, the riwaq’s solid face), sections.typ (check the tower); malqaf_tower.typ, ne_corner.typ, malqaf_L5.typ marked record / adopted
3D | 3d/params.yaml (the plant room removed, W1-1 and the riwaq panel removed, the majlis panel), 3d/build_3d.py (the L5 core, chamber and head; the L1 tower, plant room and plenum code removed; the roofline cuts), 3d/ check_3d.py (the shaft, the head, the attic corner), 3d/character.yaml (no stone: every exterior material plaster / render, the projections in the honey tone; the floors porcelain; the arcade’s first bay; the bookmarks and captions), the viewer’s notes; the renders (the courtyard, the gate, an aerial)
Presentation | presentation.typ: sheets 02, 03, 04, 06 (the plans), 05 (the courtyard enclosure: W1-1 → the blind arch), 08 (the schedules), 09 (the decisions), 10 (the open items), 11 (the roof), 12 (the elevations and sight lines); every “honey stone” and “marble” → render / porcelain (owner, 9 Nov 2026); the DXFs regenerated
Docs | PROJECT_V9.md → V10.0 (§1, §2, §3, §4 the new decisions, §5 the layout-freeze exception: the courtyard’s covered strip and the gallery changed by the owner’s L5 decision, §7), OPEN_ITEMS.md (item 9 rewritten, the new engineer items below), DESIGN_LANGUAGE.md (the malqaf row), NEXT_SESSION.md, the READMEs, PENDING_CHANGES.md cleared

Order of work: the data and the plans first (the room polygons, the courtyard and the gallery, the maid wing and bedroom 1 back to V9.1), then the air, roof and structure studies, then the 3D and the presentation, then the docs and the release; tools/check.py and 3d/check_3d.py must pass at every step (their expected totals and tower checks change with the data). Not changed by L5: the site position, the cut wall, the set-out, the south wing, the suite, the kitchen, the stair, the lift.

Phase 6 checks passed (2) · The study ends here; the owner decides and sends the adoption + release V10.0 prompt.

# الملقف: ملخص القرار للمالك وزوجته

ما هو الملقف ولماذا؟ برج يلتقط ريح الطائف المسائية )غربية وشمالية غربية صيفا( وينزلها إلى جلسة الفناء نسيما طبيعيا قويا، وهو أيضا مدخل الهواء المرشح للبيت. هو الفكرة التي تجعل العائلة تستمتع بجو الطائف في فنائها، ورمز البيت من الداخل.

أين يقف؟ في الركن الشمالي الغربي للفناء، داخل الممر المسقوف تحت بروز الدور األول، مالصقا لجدار مجلس النساء دون أن يأخذ منه شيئا. في الدور األرضي غرفة صغيرة )1.2 × 2 م( بباب خشبي منحوت على الممر المسقوف، فيها مصيدة الغبار والمرشحات والمروحة ومكان لمبرد صحراوي متنقل إن أردتم الحقا. فتحة الهواء داخل أول قوس من الرواق المقّوّوس، مقابل الجلسة مباشرة. في الدور األول مجرى 1.2 × 0.8 م في طرف الممر العلوي، والممر يبقى بعرض 1.5 م. فوق السطح برج 1.6 × 2.4 م بلياسة رملية فاتحة وحزام وتاج بلون عسلي، فتحاته رأسية نحيلة مقّوّوسة، يبدأ به صف أقواس الفناء بخط واحد من القوس إلى التاج.

ماذا نكسب؟ نسيم في الجلسة نحو أربعة أضعاف الموقع الحالي في الركن الشمالي الشرقي؛ ال يالمس البرج أي غرفة نوم )ال ضوضاء وال خوف لألطفال(؛ الصيانة كلها من باب في الدور األرضي بال ساللم؛ مكان جاهز لمبرد صحراوي؛ النواة الخرسانية تصير دعامة رابعة لبروز الدور األول فيقوى الهيكل؛ ظل لطيف على شمال الجلسة في أمسيات الصيف؛ ويختفي البرج القديم وغرفة المعدات من سطح الركن الشمالي الشرقي، وتعود غرفة األطفال وحمام الخادمة وغرفتها إلى أشكالها المستقيمة.

ماذا ندفع؟ نهاية الممر المسقوف )نحو 3.5 م²( ونحو 1.7 م² من الممر العلوي؛ أول نافذة مقّوّوسة في الممر العلوي تصير قوسا أعمى غائرا؛ لوح زجاج الرواق األول يصير جدارا مصمتا عليه كنبة خشبية، ويفقد المجلس لوحا صغيرا )نصف متر(؛ التكلفة نحو 1.2 من البديل الحالي )تقدير(؛ والبرج ال ُيُيرى من البوابة، بل من الفناء ومن الشارع البعيد.

كيف ُيُيستعمل؟ مفتاحان على الجدار: الملقف مفتوح أو مغلق، والمروحة عادي أو قوي. حساس غبار واحد يغلق الملقف بنفسه في الغبار، وكل الخوانق ُتُتغلق تلقائيا عند انقطاع الكهرباء. ًء شتاًء تغلقون الملقف بالمفتاح، والبيت يبقى مهّوّوى بالمروحة المرشحة. ال مبرد اآلن؛ الملقف نظام جاف، والمبرد خيار للصيف القادم.

ماذا يحتاج بعد؟ المهندس اإلنشائي )التربة، النواة وقاعدتها، تقصير الجسرين 3B و4B، توسيع الجسر 3R وجسر قصير جديد، إطار الرأس للزالزل(، ومهندس الميكانيكا )المروحة والمرشحات والكاتم، الخانقان وحساس الغبار، مدخل الهواء التعويضي لشفاط المطبخ، تحويل تهوية الصرف الغربية إلى الجنوب الشرقي(، ومحطة طقس صغيرة في الموقع لبضعة أسابيع لتأكيد اتجاه الريح.

يبقى األنظف لمدخل الهواء والوحيد الذي ُيُيرى من البوابة، لكنه يعطي ربع النسيم ويالمس غرفة نوم وُتُتصان مصيدته من حمام الخادمة. القرار للمالك؛ وبعده ُيُير َسَس | التوصية: اعتماد الموقع 5L( البديل ج مع الرأس 3F). البديل الحالي 1L ل أمر
االعتماد واإلصدار 10.0V.
