ahl20006/House_git/taif_house/output/plumbing.pdf

Plumbing and wet-room study · round 1 · inventory, overlay, constraints, scores, alternatives, three scenarios, the utility

# room · Taif / Palm House V8.1 · STUDY ONLY

Design review E-03, G-07 · open item 10 · 2 Nov 2026 · the latest geometry (the flipped stair, the family bath F-b, the south wing v2, the maid room and kitchen changes, the site plan’s manholes and septic route) · every size is assumed, to be designed by the plumbing engineer · nothing in the design files changes until the owner decides

Principles applied in every scenario (owner’s goals: maintenance without breaking floors or walls, no smells, low

## leak risk, quality, controlled cost)

1. Two clusters only: west round the shaft (the utility room, the hospitality kitchen, the family powder room, the guest WC and basins; above: the family WC and bedroom 2′s bath on one service wall by the shaft (3 Nov 2026), bedroom 3′s bath) and east along the east wall (the kitchen, the laundry, the maid bath; above: the suite bath and its WC closet). No third cluster (bedroom 1 stays without a bath: decided).
2. Ground floor: the drains buried under the ground slab, a cleanout at every change of direction, an inspection chamber outside each cluster (the west manhole on the driveway, the east manhole in the yard), reachable from above; then the collector manhole and the existing septic (site plan).
3. Stacks: vertical stacks inside the west shaft (doors on each floor) or an accessible duct (scenario C: an internal east duct); acoustic (triple-layer) pipes on every stack; the east stack today runs outside the east wall behind a removable cladding.
4. First-floor bathrooms: a sunken waterproofed slab (0.10–0.15 m, the leak kept inside the bathroom) wherever the bay allows it (the ribbed bays; the suite bath has it, X10), OR suspended drains only above service rooms and corridors behind access panels with acoustic lagging; never above bedrooms, the majlis, the living or the kitchen’s hood zone.
5. No smell: real vent stacks to the roof (the west shaft and the east stack; ≥ 3 m from the filtered inlet and the malqaf head; the west vent re-routed to the south-east strip, V10.0), deep-seal traps (≥ 75 mm) on every fixture, anti-odour floor drains (membrane or ball type, with a primer) on the rarely used drains: the courtyard, the suite court, the laundry and the utility room, the malqaf’s dust-trap gully.
6. Water: a manifold system (one continuous PEX pipe from the manifold to each fixture, no buried joints), a manifold cabinet per floor near the shaft with a valve per fixture (west: the utility room GF, the family bath’s wall FF; east: the laundry GF, the suite WC closet’s wall FF); one water heater per cluster close to its bathrooms (west: the utility room; east: the laundry, serving the kitchen, the maid bath and the suite bath above); a booster pump from the tank (site plan) with a main sediment filter in the utility room; an RO unit at the kitchen sink.
7. Leak protection: leak sensors under the heaters, the washer, the dishwasher and every basin cabinet, wired to an automatic main shut-off valve after the filter; drip trays under the heaters and the washer, drained to a floor drain; the first-floor bathrooms’ sunken slabs are the second line.

## 1 · Inventory: every wet point (both floors and the roof)

Fl. | Room | Fixtures | Drains to | Branch m | Use
GF | Hospitality kitchen | sink | W-RUN | 0.3 | daily
GF | Family powder room | 2 stone basins (vanity) | W-RUN | 0.5 | daily
GF | Family powder room | wall-hung WC (south service wall) | W-RUN | 0.5 | daily
GF | Guest WC | WC + basin | W-RUN | 1.1 | guests
GF | Guest basins | trough, 3 taps | W-RUN | 3.2 | guests
GF | Utility room | heater drip tray · condensate | W-SHAFT | 0.3 | rare
GF | Kitchen | sink + dishwasher | E-MH | 9 | daily
GF | Laundry | washer · dryer · utility sink · floor drain | E-MH | 13.5 | daily / rare (floor drain)
GF | Maid bath | WC · basin · shower | E-MH | 14.1 | daily
GF | Courtyard | 2 linear drains (level floor) · overflow · trough + planter | RAIN | 6.2 | rain / washing
GF | Air tower | malqaf foot chamber: the dust trap's gully · the floor drain (V10.0, L5) | W-MH | 22.9 | rare
FF | Bedroom 2 bath | shower channel (trap in the service wall) | W-SHAFT | 2.2 | daily
FF | Bedroom 2 bath | wall-hung WC (service wall) | W-SHAFT | 0.9 | daily
FF | Bedroom 2 bath | vanity basin (niche on the shaft) | W-SHAFT | 0 | daily
FF | Family WC | wall-hung WC + basin (service wall) | W-SHAFT | 0.1 | daily
FF | Bedroom 3 bath | shower · WC · basin | FWC | 0.5 | daily
FF | Suite WC closet | WC | E-STACK | 0.5 | daily
FF | Suite bath | shower (east wall) | E-STACK | 1.6 | daily
FF | Suite bath | tub (by the east window) | E-STACK | 3.1 | weekly
FF | Suite bath | double vanity (west wall) | E-STACK | 3 | daily
FF | Suite court | 3 linear drains · box gutter · overflow | RAIN | 3.2 | rain
roof | Roof | 11 outlets → internal downpipes | RAIN | — | rain
roof | Roof (plant) | AC condensate (Z2b) | E-STACK | — | daily (summer)

Branch = the horizontal drain from the fixture to its collector (the buried run, a stack or the manhole), measured on the routes drawn; the roof outlets (11) and the AC / HRV condensate are listed, not scored. Total of the scored branches: 86.7 m.

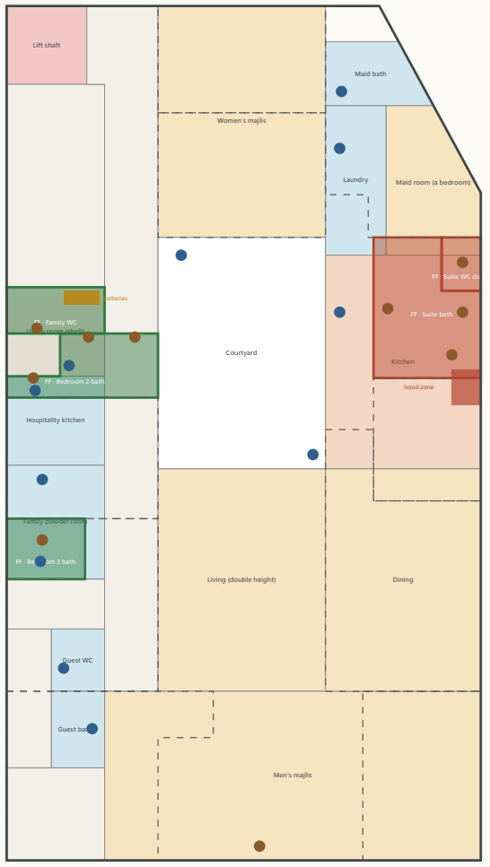
[picture p27: figure]
Lift shaft; Utility room (shaft); Hospitality kitchen; Family powder room; Guest WC; Guest basins; Women's majlis; Courtyard; Living (double height); Men's majlis; Maid bath; Maid room (a bedroom) Laundry; Kitchen; Dining; FF · Bedroom 2 bath; FF · Family WC; FF · Bedroom 3 bath; FF · Suite bath; FF · Suite WC closet; hood zone; batteries

OVERLAY · the first-floor wet rooms (green = over a wet / service room, red = over the kitchen) on the ground floor · dots: wet points (blue GF, brown FF) · 1 m = 0.56 cm

2 · Constraints map · what lies under each first-floor wet room · the stacks and the routes to the septic

west band: solid 0.20

riwaq: solid 0.20

women's majlis roof: solid 0.20 | maid wing: solid 0.20 (no sunken zone without thickening)

kitchen roof: ribbed 0.30 (the suite bath sunken 0.15 inside it, X10)

dining roof: ribbed 0.30
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
