ahl20006/House_git/taif_house/3d/output/char_aerial_se.png

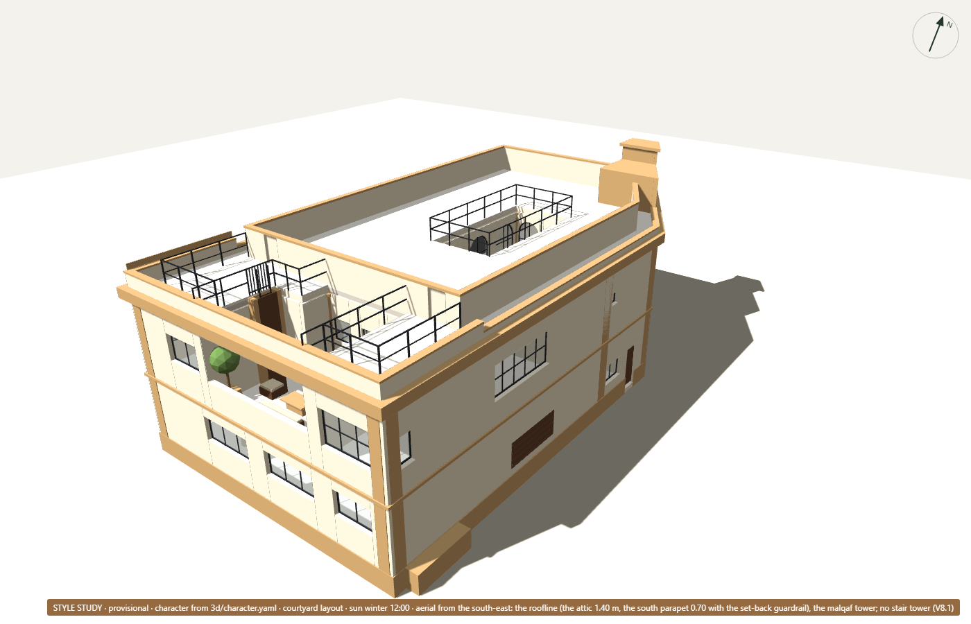
taif_house/3d/output/char_aerial_se.png
