ahl20006/House_git/taif_house/3d/output/char_aerial_sw.png

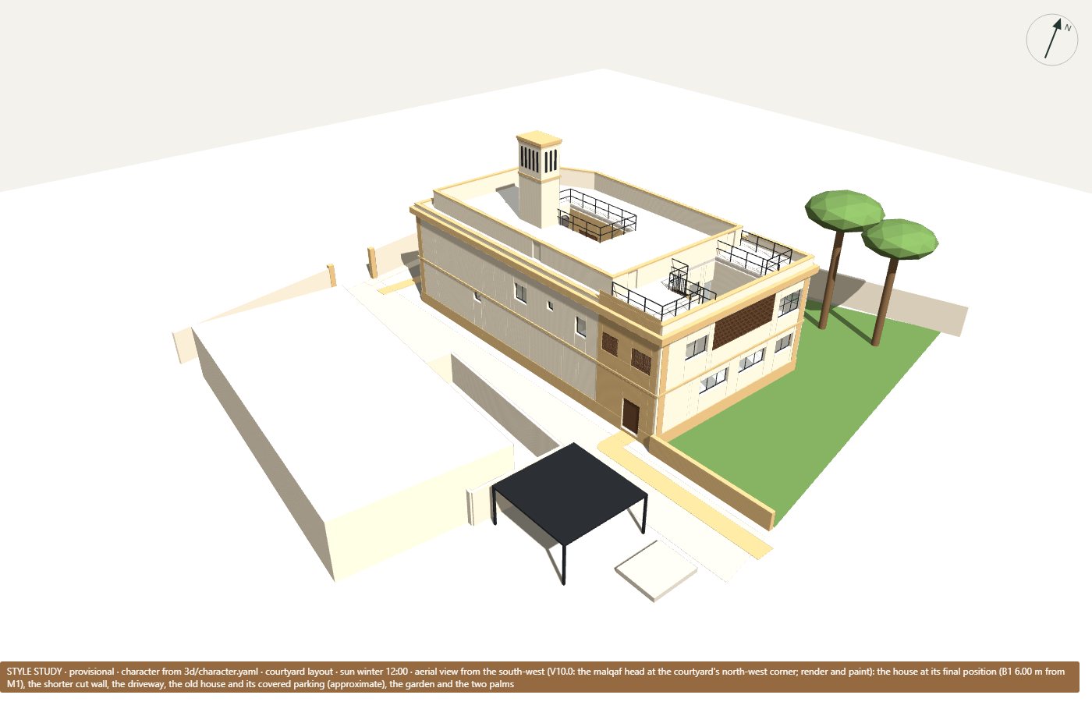
taif_house/3d/output/char_aerial_sw.png
