ahl20006/House_git/taif_house/3d/output/char_court_screen.png

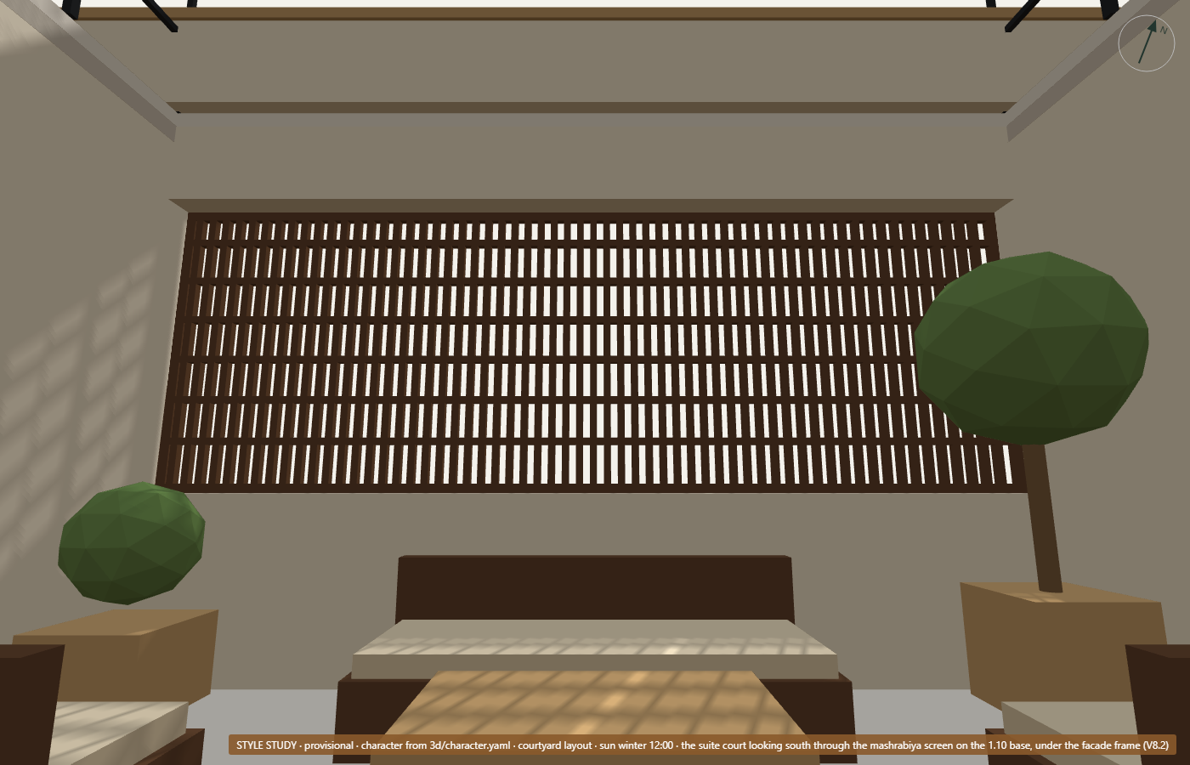
taif_house/3d/output/char_court_screen.png
