ahl20006/House_git/taif_house/3d/output/char_gate.png

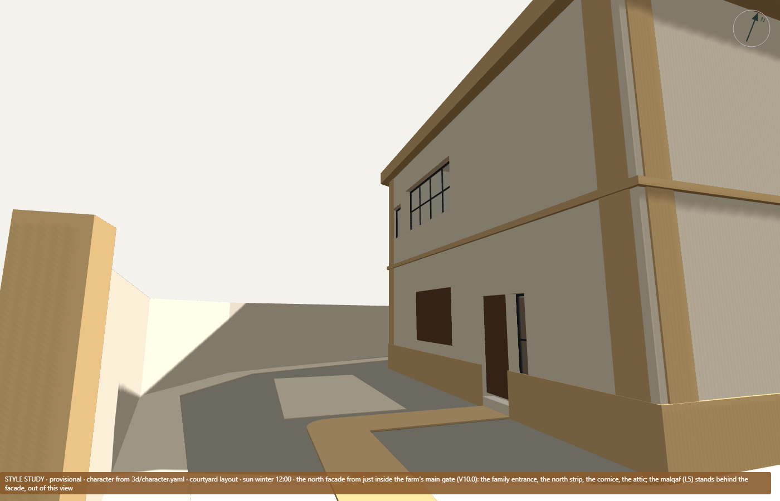
taif_house/3d/output/char_gate.png
