ahl20006/House_git/taif_house/3d/output/char_living.png

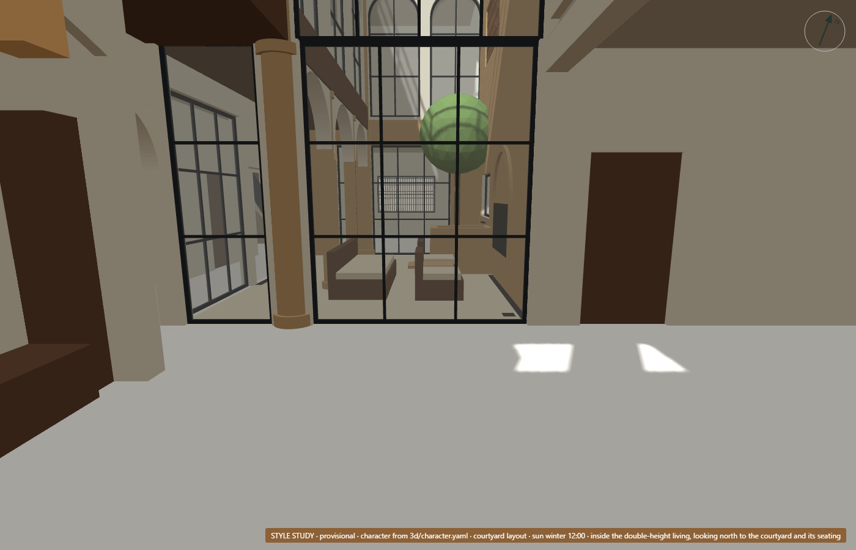
taif_house/3d/output/char_living.png
