ahl20006/House_git/taif_house/3d/output/char_north.png

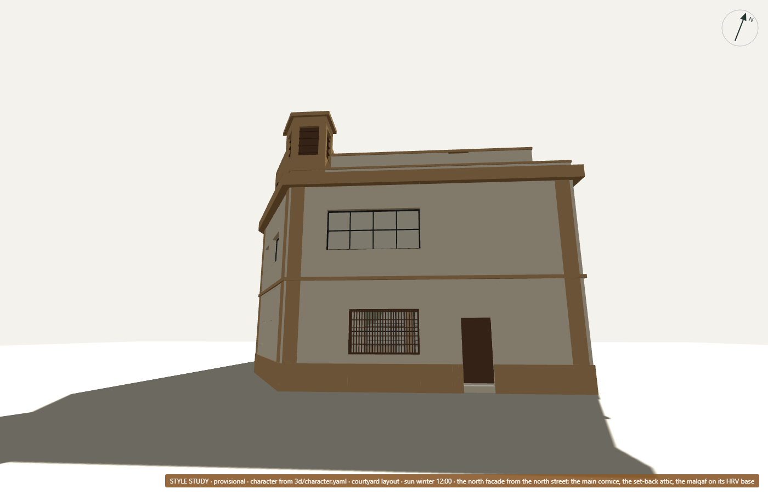
taif_house/3d/output/char_north.png
