ahl20006/House_git/taif_house/3d/output/char_suite_court.png

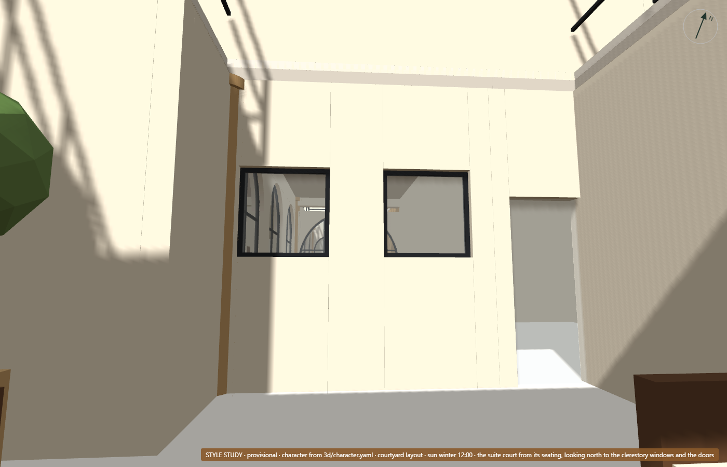
taif_house/3d/output/char_suite_court.png
