ahl20006/House_git/taif_house/3d/output/char_suite_court_sw.png

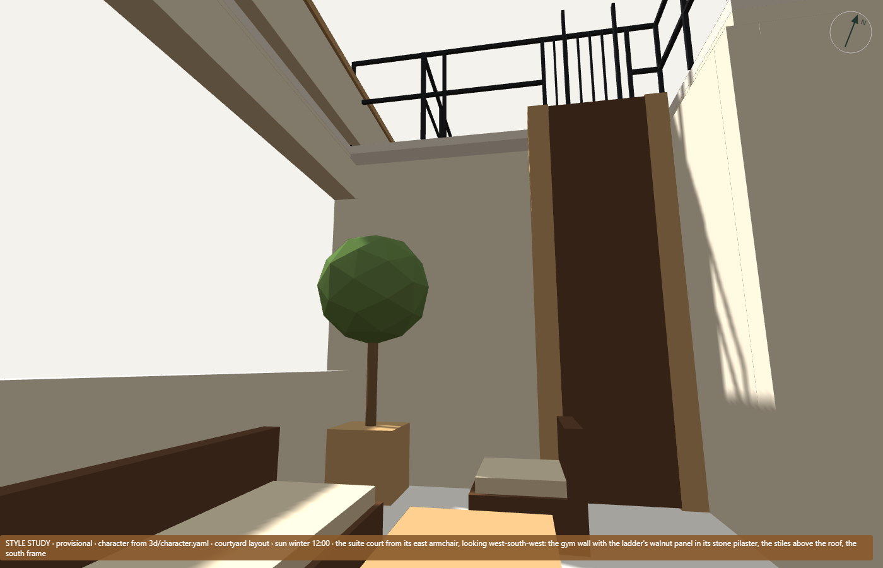
taif_house/3d/output/char_suite_court_sw.png
