ahl20006/House_git/taif_house/3d/output/eye2.png

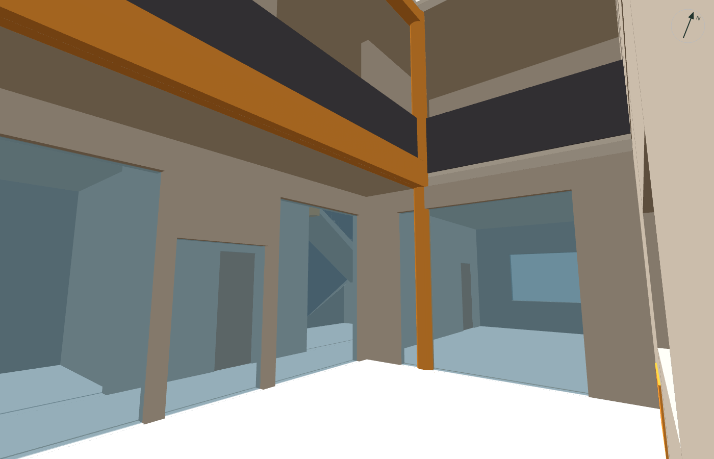
taif_house/3d/output/eye2.png
