ahl20006/House_git/taif_house/3d/output/malqaf_gate_a25.png

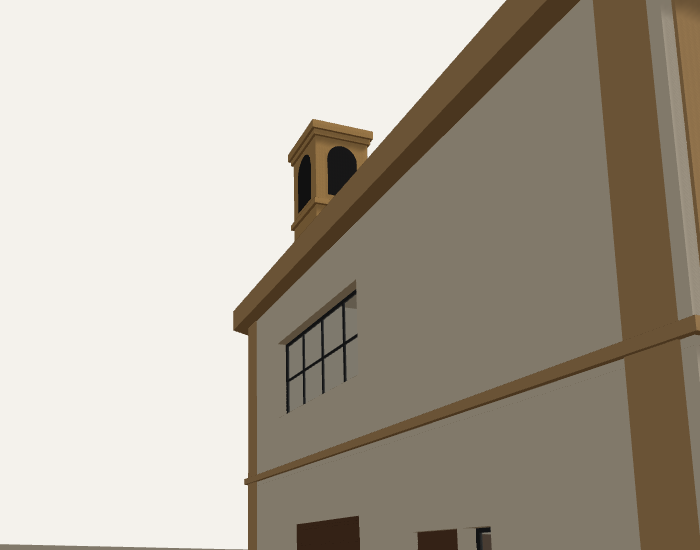
taif_house/3d/output/malqaf_gate_a25.png
