ahl20006/House_git/taif_house/3d/output/malqaf_L5_gate.png

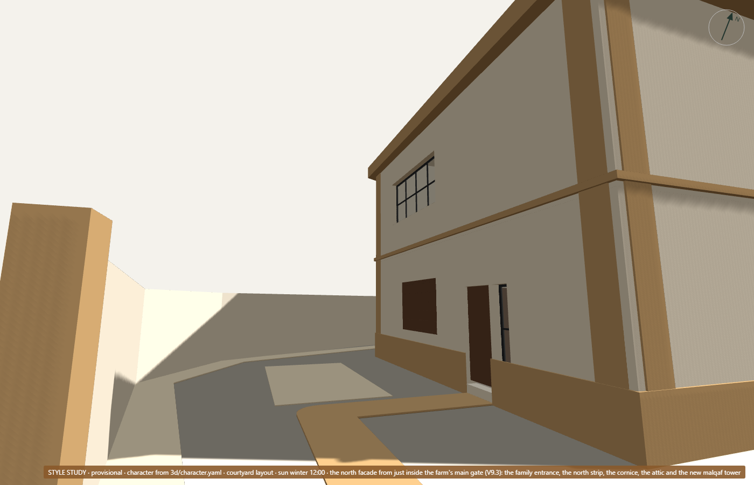
taif_house/3d/output/malqaf_L5_gate.png
