ahl20006/House_git/taif_house/3d/output/plan_ff.png

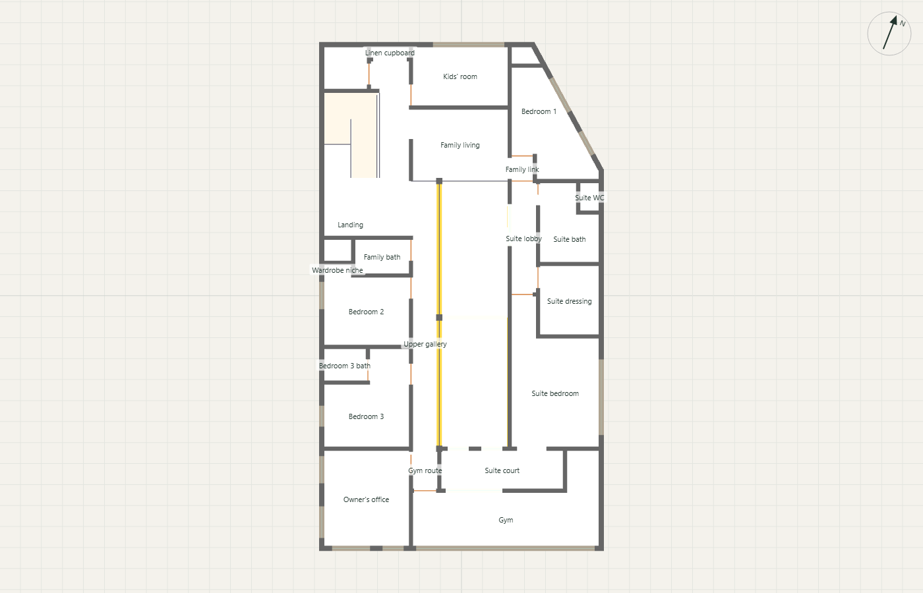
taif_house/3d/output/plan_ff.png
