ahl20006/House_git/taif_house/3d/output/sun_winter_09.png

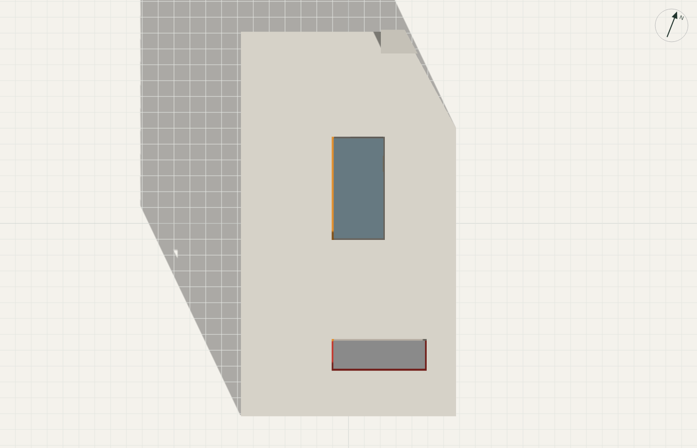
taif_house/3d/output/sun_winter_09.png
