ahl20006/House_git/taif_house/3d/output/sun_winter_12.png

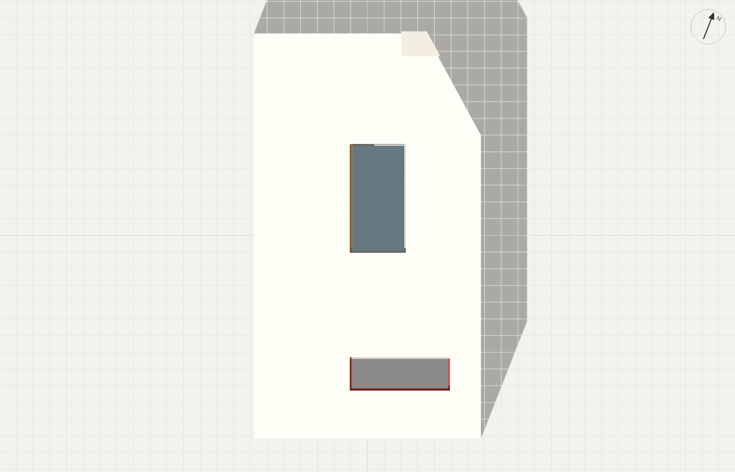
taif_house/3d/output/sun_winter_12.png
