ahl20006/House_git/taif_house/3d/output/view_nw.png

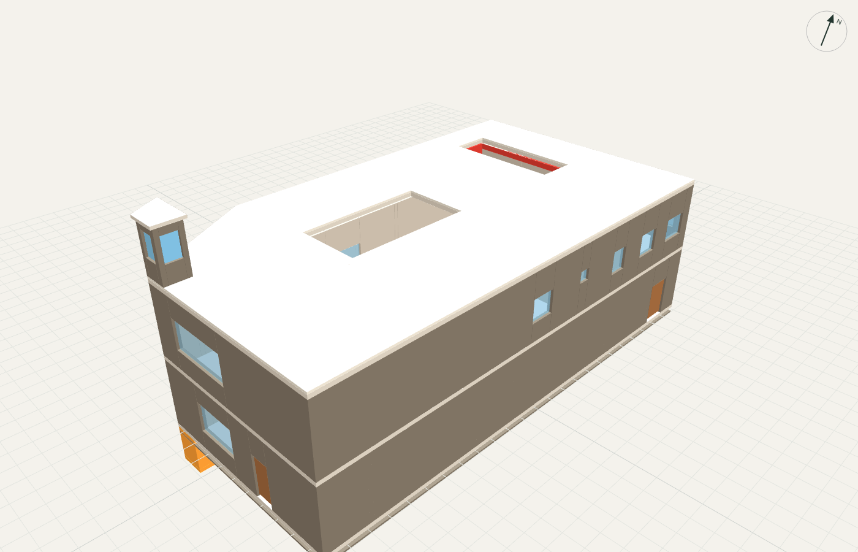
taif_house/3d/output/view_nw.png
