ahl20006/House_git/taif_house/3d/output/view_se.png

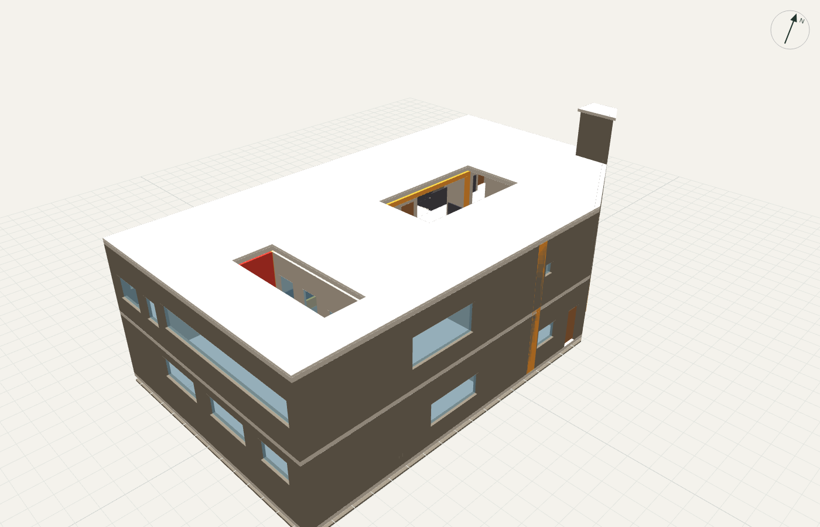
taif_house/3d/output/view_se.png
