ahl20006/House_git/taif_house/site/inputs/taif_north_zone_final_v2.png

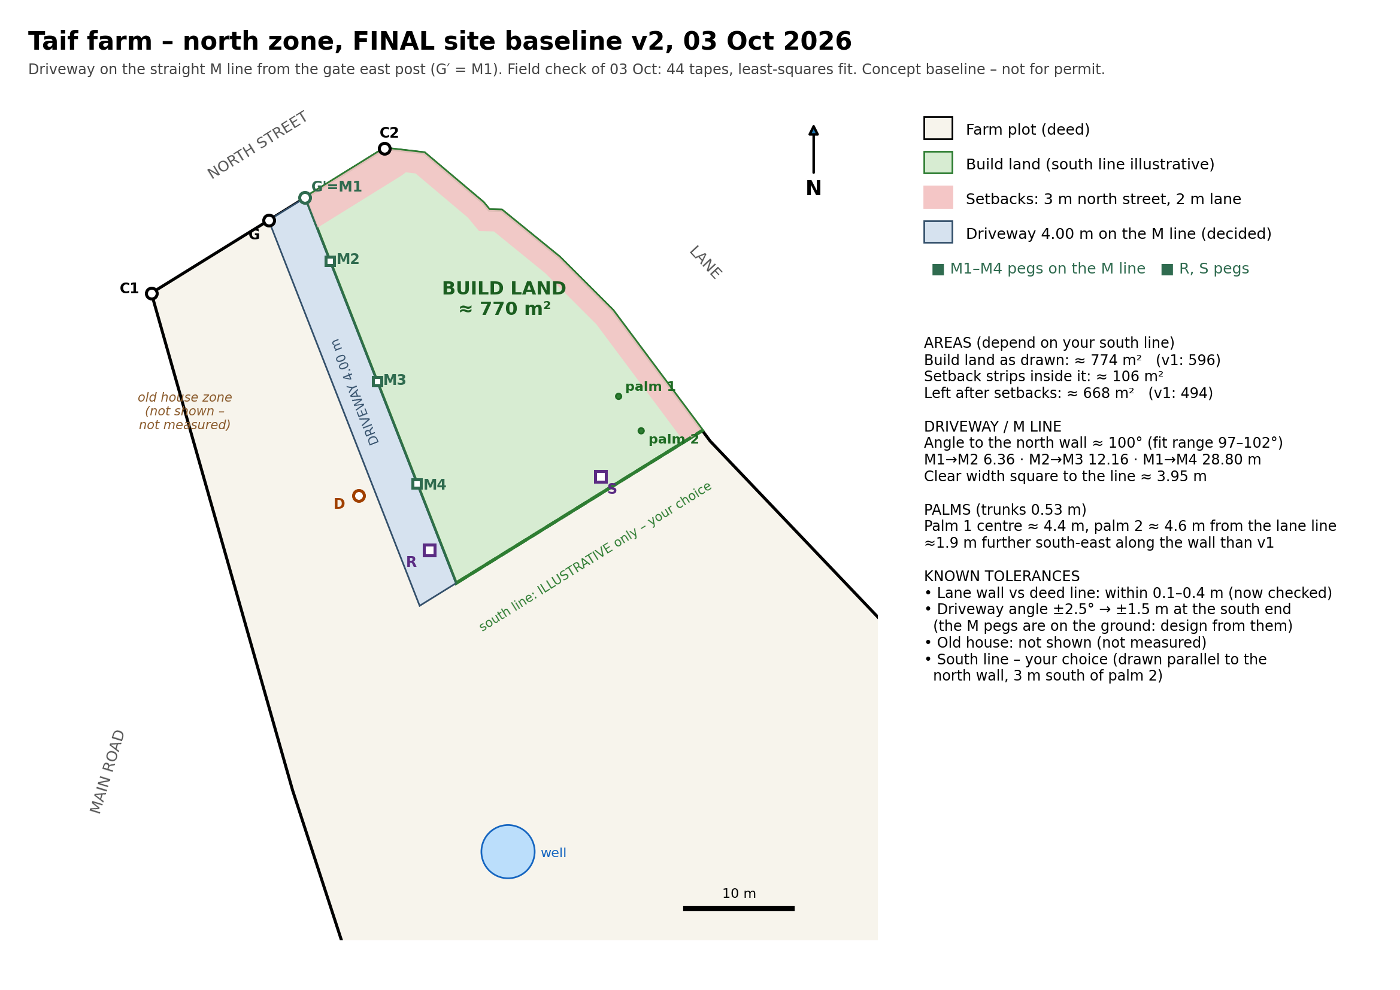
taif_house/site/inputs/taif_north_zone_final_v2.png
