ahl20006/House_git/taif_house/site/inputs/taif_north_zone_final_v2.dxf

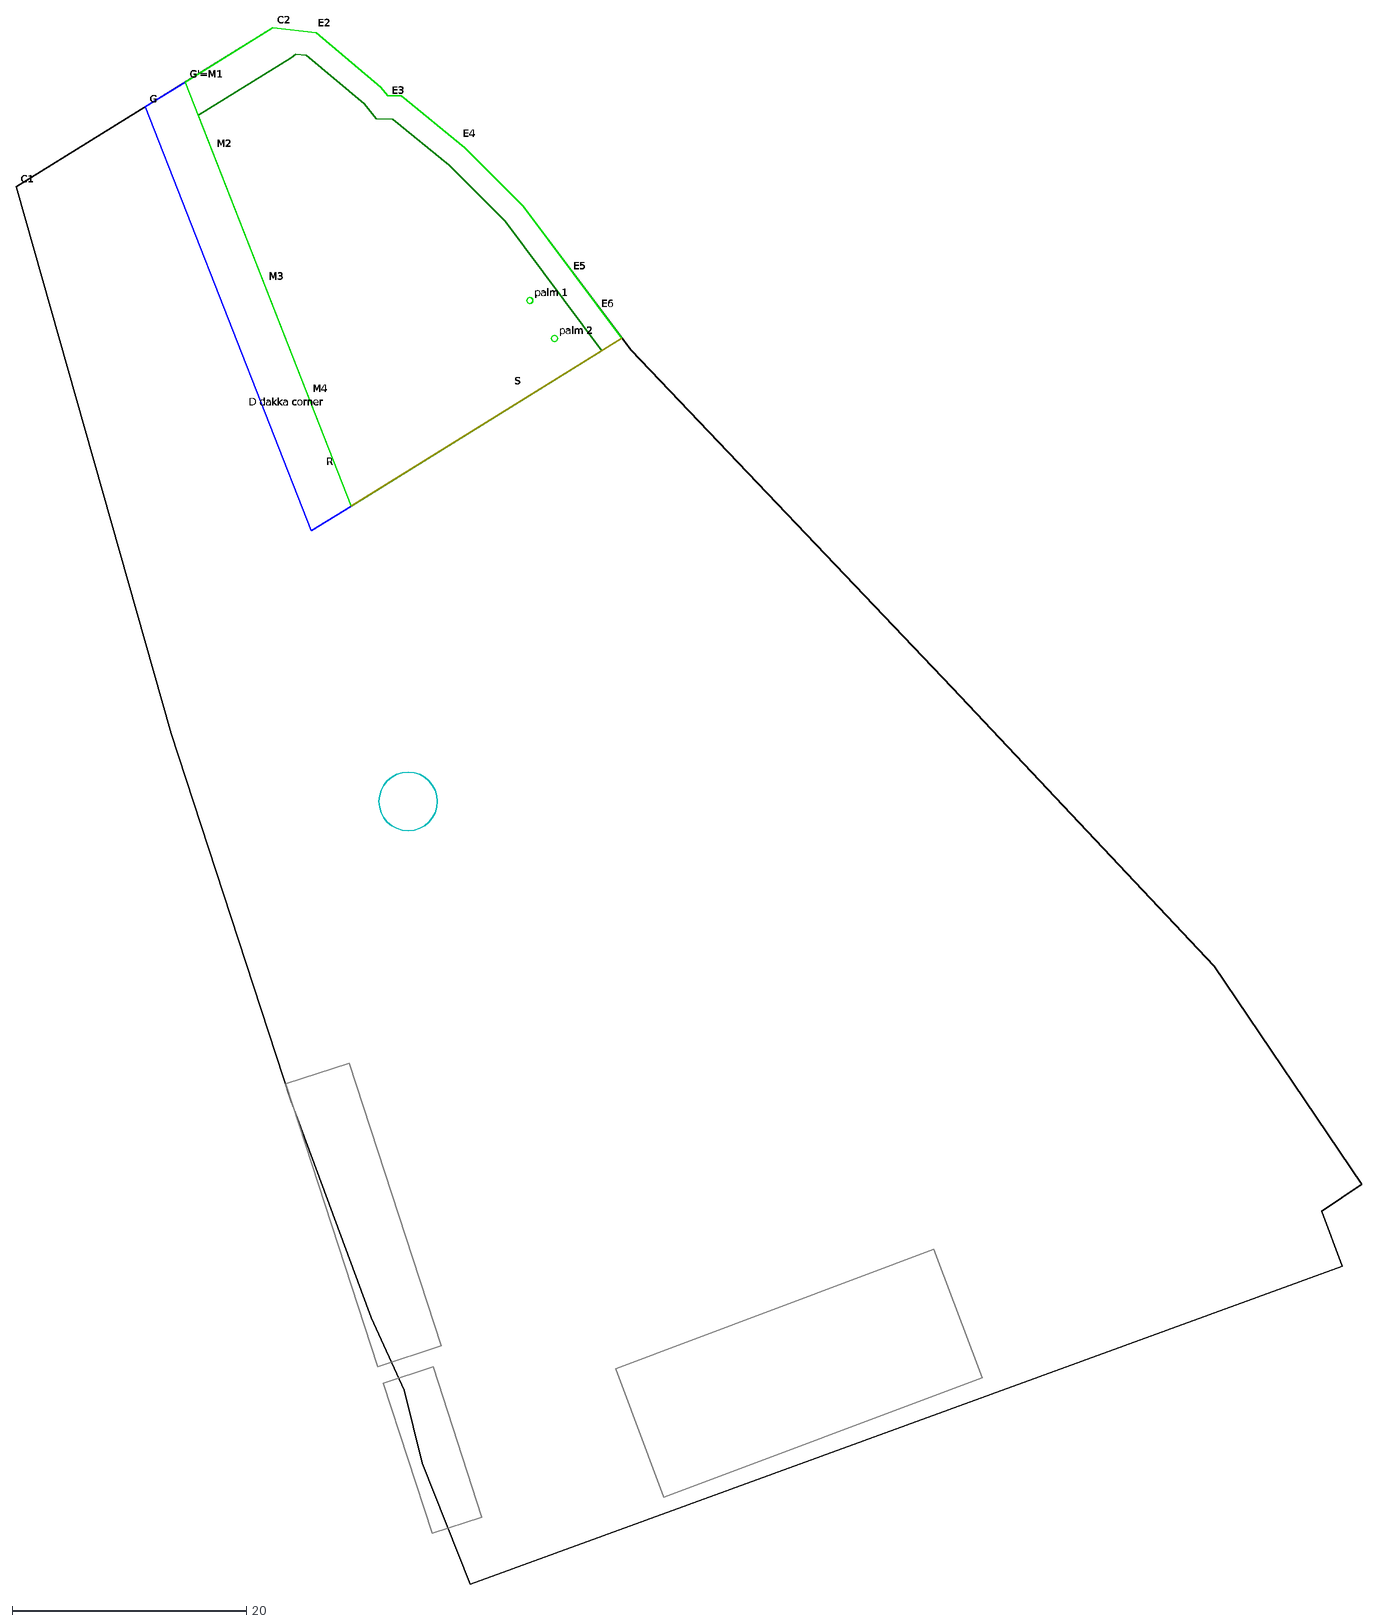
[picture p59: CAD file, 2026-11-05]
taif_house/site/inputs/taif_north_zone_final_v2.dxf
palm 1
palm 2
C1
C2
G
G'=M1
M2
M3
M4
D dakka corner
R
S
E2
E3
E4
E5
E6
