ahl20006/House_git/(list of files, cad)

Other CAD files:
concept_V3.0/design_v3.dxf
taif_house/output/taif_roof_V10.0.dxf
taif_house/output/taif_ground_floor_V10.0.dxf
taif_house/output/taif_first_floor_V10.0.dxf
taif_house/archive/taif_roof_V9.3.dxf
taif_house/archive/taif_ground_floor_V9.3.dxf
taif_house/archive/taif_first_floor_V9.3.dxf
taif_house/archive/taif_first_floor_V9.2.dxf
taif_house/output/taif_roof_V9.3.dxf
taif_house/archive/taif_ground_floor_V9.2.dxf
taif_house/output/taif_ground_floor_V9.3.dxf
taif_house/archive/taif_roof_V9.2.dxf
taif_house/output/taif_first_floor_V9.3.dxf
taif_house/archive/taif_first_floor_V9.1.dxf
taif_house/output/taif_roof_V9.2.dxf
taif_house/archive/taif_roof_V9.1.dxf
taif_house/output/taif_first_floor_V9.2.dxf
taif_house/archive/design_v3.4.dxf
taif_house/archive/taif_first_floor_V6.0.dxf
taif_house/archive/taif_first_floor_V6.1.dxf
taif_house/archive/taif_first_floor_V6.2.dxf
taif_house/archive/taif_first_floor_V6.3.dxf
taif_house/archive/taif_first_floor_V7.0.dxf
taif_house/archive/taif_first_floor_V7.1.dxf
taif_house/archive/taif_first_floor_V8.0.dxf
taif_house/archive/taif_first_floor_V8.3.dxf
taif_house/archive/taif_first_floor_V9.0.dxf
taif_house/archive/taif_ground_floor_V5.1.dxf
taif_house/archive/taif_ground_floor_V6.0.dxf
taif_house/archive/taif_ground_floor_V6.1.dxf
taif_house/archive/taif_ground_floor_V6.2.dxf
taif_house/archive/taif_ground_floor_V6.3.dxf
taif_house/archive/taif_ground_floor_V7.0.dxf
taif_house/archive/taif_ground_floor_V7.1.dxf
taif_house/archive/taif_ground_floor_V8.0.dxf
taif_house/archive/taif_ground_floor_V8.3.dxf
taif_house/archive/taif_ground_floor_V9.0.dxf
taif_house/archive/taif_ground_floor_V9.1.dxf
taif_house/archive/taif_roof_V7.0.dxf
taif_house/archive/taif_roof_V7.1.dxf
taif_house/archive/taif_roof_V8.0.dxf
taif_house/archive/taif_roof_V8.3.dxf
taif_house/archive/taif_roof_V9.0.dxf
taif_house/output/taif_first_floor_V6.0.dxf
taif_house/output/taif_first_floor_V6.1.dxf
taif_house/output/taif_first_floor_V6.2.dxf
taif_house/output/taif_first_floor_V6.3.dxf
taif_house/output/taif_first_floor_V7.0.dxf
taif_house/output/taif_first_floor_V7.1.dxf
taif_house/output/taif_first_floor_V8.0.dxf
taif_house/output/taif_first_floor_V8.1.dxf
taif_house/output/taif_first_floor_V8.2.dxf
taif_house/output/taif_first_floor_V8.3.dxf
taif_house/output/taif_first_floor_V9.0.dxf
taif_house/output/taif_first_floor_V9.1.dxf
taif_house/output/taif_ground_floor_V4.dxf
taif_house/output/taif_ground_floor_V5.1.dxf
taif_house/output/taif_ground_floor_V5.dxf
taif_house/output/taif_ground_floor_V6.0.dxf
taif_house/output/taif_ground_floor_V6.1.dxf
taif_house/output/taif_ground_floor_V6.2.dxf
taif_house/output/taif_ground_floor_V6.3.dxf
taif_house/output/taif_ground_floor_V7.0.dxf
taif_house/output/taif_ground_floor_V7.1.dxf
taif_house/output/taif_ground_floor_V8.0.dxf
taif_house/output/taif_ground_floor_V8.1.dxf
taif_house/output/taif_ground_floor_V8.2.dxf
taif_house/output/taif_ground_floor_V8.3.dxf
taif_house/output/taif_ground_floor_V9.0.dxf
taif_house/output/taif_ground_floor_V9.1.dxf
taif_house/output/taif_ground_floor_V9.2.dxf
taif_house/output/taif_roof_V7.0.dxf
taif_house/output/taif_roof_V7.1.dxf
taif_house/output/taif_roof_V8.0.dxf
taif_house/output/taif_roof_V8.1.dxf
taif_house/output/taif_roof_V8.2.dxf
taif_house/output/taif_roof_V8.3.dxf
taif_house/output/taif_roof_V9.0.dxf
taif_house/output/taif_roof_V9.1.dxf
