ahl20006/House_git/building.csv

name | x | y | w | d | angle | frame | colour
#Z3 pentagon cut 3 x 5.52 | 7.0 | 14.7 | 12.75|3|5.52 | 22.5 | 0 | M | family
Z4 pentagon cut 3 x 5.52 | 7.0 | 14.7 | 13.5|3|5.52 | 22.5 | 0 | M | family
