ahl20006/House_git/taif_house/studies/building.csv

name | x | y | w | d | angle | frame | colour
Z4 ground floor V6.3 pentagon cut 3.311 x 6.093 | 7.5655 | 15.525 | 13.561|3.311|6.093 | 24.25 | 0 | M | family
