ahl20006/House_git/taif_house/output/site_test.pdf

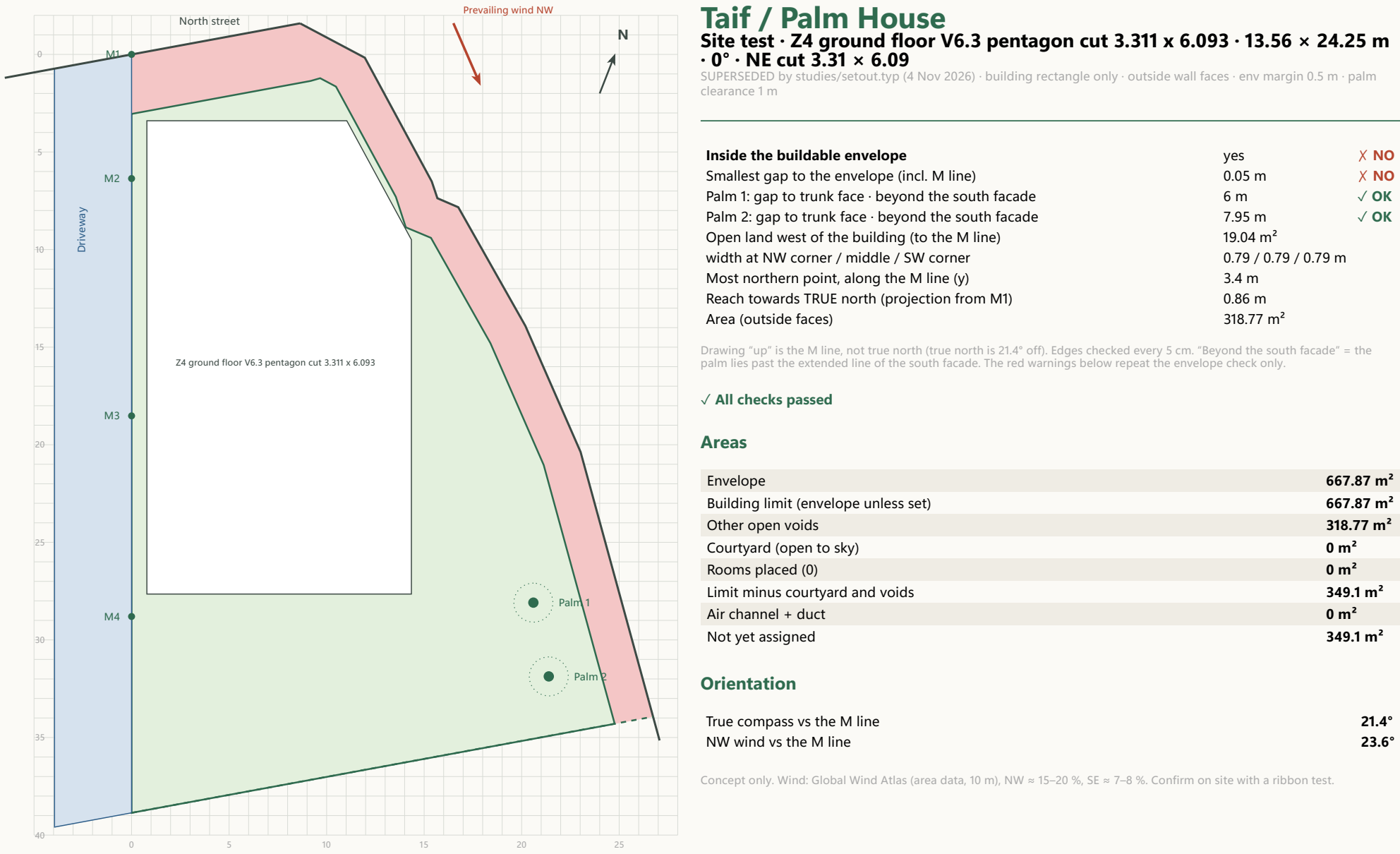
[picture p63: figure]
Prevailing wind NW; Palm 1; Palm 2; Driveway; North street; Taif / Palm House; · 0° · NE cut 3.31 × 6.09; clearance 1 m; Inside the buildable envelope; yes; Area (outside faces); ✓ All checks passed; Areas; Envelope; Building limit (envelope unless set); Other open voids; Courtyard (open to sky); Rooms placed (0); Limit minus courtyard and voids; Air channel + duct; Not yet assigned; Orientation; True compass vs the M line; NW wind vs the M line

Z4 ground floor V6.3 pentagon cut 3.311 x 6.093

10 m · drawing scale 1:256

## Site test · Z4 ground floor V6.3 pentagon cut 3.311 x 6.093 · 13.56 × 24.25 m

SUPERSEDED by studies/setout.typ (4 Nov 2026) · building rectangle only · outside wall faces · env margin 0.5 m · palm

Smallest gap to the envelope (incl. M line) | 0.05 m | ✗ NO
Palm 1: gap to trunk face · beyond the south facade | 6 m | ✓ OK
Palm 2: gap to trunk face · beyond the south facade | 7.95 m | ✓ OK
Open land west of the building (to the M line) | 19.04 m²
width at NW corner / middle / SW corner | 0.79 / 0.79 / 0.79 m
Most northern point, along the M line (y) | 3.4 m
Reach towards TRUE north (projection from M1) | 0.86 m

Drawing “up” is the M line, not true north (true north is 21.4° off). Edges checked every 5 cm. “Beyond the south facade” = the palm lies past the extended line of the south facade. The red warnings below repeat the envelope check only.

Concept only. Wind: Global Wind Atlas (area data, 10 m), NW ≈ 15–20 %, SE ≈ 7–8 %. Confirm on site with a ribbon test.

# Schedules

All coordinates in metres from M1: x east (square to the M line), y along the M line southwards.

Envelope corners

Corner | x | y
V1 | 0 | 38.86
V2 | 0 | 3.05
V3 | 9.18 | 1.36
V4 | 9.67 | 1.22
V5 | 10.48 | 1.65
V6 | 13.55 | 7.3
V7 | 14.06 | 8.86
V8 | 15.35 | 9.4
V9 | 18.4 | 14.8
V10 | 21.13 | 21.04
V11 | 24.77 | 34.3

Rooms

No rooms yet. Add rows to the room CSV.
