ahl20006/House_git/taif_house/docs/PENDING_CHANGES.md

# Pending changes (branch `work`)

One line per change made on the `work` branch since the last release, not yet folded into the documentation, the presentation, the DXFs or the 3D. Fold them in at the next version and clear this table.

**Cleared at V10.0 (9 Nov 2026):** the entries of 8–9 Nov 2026 (the north-east corner study; the malqaf angle test; the six-phase L5 study and its climate tool and renders; the no-stone and porcelain decisions and the facade open items; the L5 adoption: the room data, the plans, the studies, the air system v4, the roof, the structure, the 3D, the presentation, the marks on the two malqaf studies, the decision row and the open items) are folded into `PROJECT_V10.md` (§1, §3, §4.10, §4.63, §4.64, §5 and the changelog §7), `OPEN_ITEMS.md`, `AIR_SYSTEM.md`, `DESIGN_LANGUAGE.md`, `REQUIREMENTS.md`, `NEXT_SESSION.md`, `README_DXF.md`, `README_3D.md`, the READMEs, the review status V10.0, the 3D, the presentation V10.0 and the DXFs V10.0.

**Cleared at V9.3, V9.2, V9.1, V9.0, V8.3, V8.2 and V8.1:** see `PROJECT_V10.md` §7.

| Date | What | Why | Files |
|---|---|---|---|
