ahl20006/House_git/taif_house/site/inputs/taif_north_zone_final_v2.pdf

N

# Taif farm north zone, FINAL site baseline v2, 03 Oct 2026

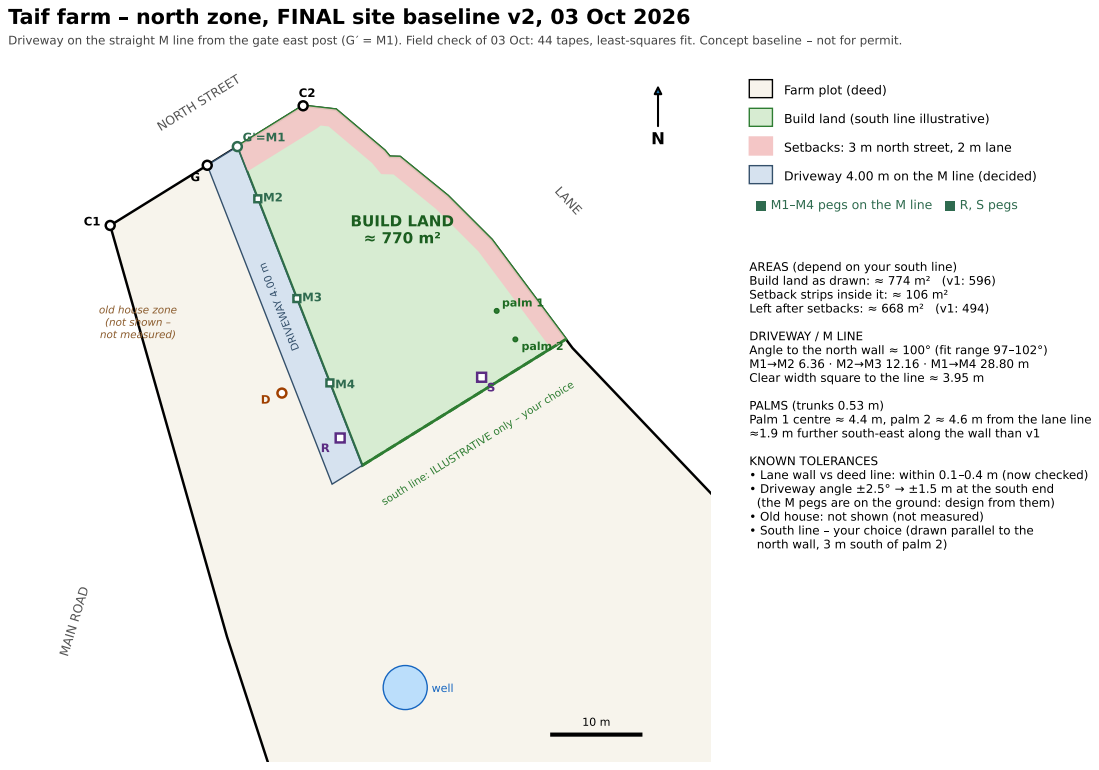
[picture p64: page 1]
well; NORTH STREET; LANE; MAIN ROAD; palm 1 DRIVEWAY 4.00 m; palm 2; BUILD LAND 770 m²; Driveway on the straight M line from the gate east post (G = M1). Field check of 03 Oct: 44 tapes, least-squares fit. Concept baseline; not for permit.; M1 M4 pegs on the M line; R, S pegs; Build land as drawn:; Setback strips inside it:; Left after setbacks:; DRIVEWAY / M LINE; Angle to the north wall; 100° (fit range 97 102°); Clear width square to the line; Palm 1 centre; 4.4 m, palm 2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

Farm plot (deed)

Build land (south line illustrative)

Setbacks: 3 m north street, 2 m lane

Driveway 4.00 m on the M line (decided)

AREAS (depend on your south line)

old house zone
(not shown
not measured)

south line: ILLUSTRATIVE only your choice

PALMS (trunks 0.53 m)
1.9 m further south-east along the wall than v1

KNOWN TOLERANCES
Lane wall vs deed line: within 0.1 0.4 m (now checked)
(the M pegs are on the ground: design from them)
Old house: not shown (not measured)
north wall, 3 m south of palm 2)

# Field check 03 Oct 2026 what it fixed

METHOD

Straight M line pegged from the gate east post (M1 = G ) with pegs M2, M3, M4. Every point taped from several pegs; all 44 usable tapes fitted together (rows 1 4 place the gate) by least squares.

Fit quality: rms 0.27 m. Not used: row 5 (G D, tape not straight), row 11 (G C2, conflicts with row 4), row 19 (M3 E3, 1.9 m off). Rows 57 58 down-weighted (E5/E6 labels doubtful).
RESULTS
North wall: C1 G 12.89 + gate 4.00 + G C2 8.74 = 25.63 m vs whole wall 25.60 m | closes within 0.03 m.
Driveway (M line) meets the north wall at | 100° (all leave-one-out fits 97 102°), heading | 159°.
Lane wall: the taped wall marks E2 E6 sit within 0.06 0.37 m of the deed line | wall = deed line is now confirmed.
Palms: centres | 4.38 m and 4.61 m from the lane line; trunk faces | 2.1 / 2.35 m inside the 2 m setback line.
Palms sit | 1.9 m further south-east along the wall than in v1 (the long tapes from the gate were right).
Dakka corner D: 5.5 m west of the M line | 1.5 m clear of the 4 m driveway.
WARNING | v1 driveway direction was wrong
v1 drew the driveway square to the north wall (88° ± 3°) from the old G | D tape "28 m" with no centimetres. The new tapes (G | D 28.41, M4 D 5.60,
G D 27.30) and the whole east-wall network give | 100°. A square driveway is geometrically impossible with these readings. v2 replaces v1.

WHAT CHANGED FROM v1 (24 Sep)

Item | v1 | v2
Driveway angle to the north wall | 88° | 100°
Build land (illustrative south line) | 596 m² | 774 m²
Buildable envelope after setbacks | 494 m² | 668 m²
Palms along the lane wall | ±1 2 m | 1.9 m further SE, ±0.3 m
Lane wall = deed line? | assumed | checked, ±0.4 m

DECISIONS

D1 Driveway = the straight M line from the gate east post: east edge on M1 M4, west edge parallel through the gate west post (4.00 m gate, 3.95 m clear square to the line).

D2 Setbacks 3 m from the north street, 2 m from the lane (confirm with Balady / the engineering office).

D3 Old house and carport not shown (not measured, outside the build land). South line: open | drawn illustratively.
CLOSED | no more tape; handed to the engineering office survey
Driveway angle ±2.5° ( | ±1.5 m at the south end) · palms ±0.3 m · gate on the deed ±0.3 m. Before the design is final: string the outline on the ground from the M pegs.
