ahl20006/House_git/taif_house/3d/character.yaml

# character.yaml · Taif / Palm House V10.0 · 3D phase "character", revision 8 (V8.3: the level courtyard layout, the enclosure on the kitchen wall, the yard re-planned; V8.2: the suite court's mashrabiya screen built, the coat cupboard, the site elements; V8.1: the roof ladder, the set-back guardrail, the outdoor kitchen; V8.0: the courtyard layout, the suite court v2, the HRV base) · STYLE STUDY, PROVISIONAL
# Simple architectural character for the 3D model (not photorealistic): materials as flat colours and a few added elements, all
# generated by 3d/character_3d.py (called from build_3d.py) from this file and the model's own data. Nothing here changes the
# design files, the room CSVs or params.yaml; every element is a proposal for the owner to compare in the viewer (toggles) and to
# change here. Metres, CSV frame (x east, y south), levels above ±0.00 (finished ground floor).
#
# Direction: contemporary, inspired by Taif / Hijazi architecture: clean lines, natural stone, timber, deep shaded openings,
# a stone colonnade with an upper gallery around a courtyard open to the sky. Simple, not ornate. No arches between the colonnade
# columns (owner, V6.3: the arches variant of r1–r2 is removed); the arches of the house are the living's entrance and its TV niche.
# Revision 3 (V7.0): the design language (docs/DESIGN_LANGUAGE.md): cream plaster, honey stone, black steel divided-lite windows, walnut;
# the courtyard enclosure W1–W3, the attic, the cornice and the parapets come from the base model (3d/params.yaml roof_design).
# Revision 2: lighter, warmer colours; the views rendered with the sun and shadows; the malqaf outlet on the kitchen wall (owner
# decision, studies/air_system.typ) with the sunken seating under it (variant toggle); the north-wall stone pier removed.

enabled: true
note: "style study, provisional: materials and character elements from 3d/character.yaml, for comparison; not a design decision"

# ---------- 1. materials (flat colours, RGB 0–255; glass with alpha) · revision 2: light and warm ----------
palette:                              # V7.0: docs/DESIGN_LANGUAGE.md
  plaster:     [240, 233, 216]        # warm white (cream) plaster: walls, the attic, the parapets
  honey: [214, 182, 128]       # V10.0 (owner, 9 Nov 2026: NO stone): the honey-tone RENDER of the projections formed in the structure (was honey stone): the main cornice, the band, the copings, the plinth, the quoins, the columns, the bench
  sand: [226, 214, 190]     # V10.0: outdoor anti-slip porcelain (R11) in a sand / honey tone (was honey-light stone): the courtyard and colonnade floors, the sunken seating, the stair
  porcelain:   [236, 233, 226]        # V10.0: marble-look porcelain floors inside (was marble, V7.1)
  timber:      [96, 66, 44]           # medium-to-dark walnut (doors, soffit, cabinet, mashrabiya, louvres)
  steel:       [34, 36, 40]           # matte black steel: window frames, divided lites, the roof guards, the stair balustrades
  brass:       [176, 138, 76]         # a few brass touches in the lighting (lantern rods)
  bronze:      [48, 44, 40]           # dark metal: grates, the fountain spout, the drains
  glass:       [120, 185, 225, 110]   # transparent in the viewer
  concrete:    [205, 200, 190]        # slab edges where they show (not assigned by default)
  ground:      [222, 214, 198]        # the ground around the house in the character views (an opaque plane at the plinth's foot)
  foliage:     [104, 138, 76]
  trunk:       [122, 94, 64]
  lantern:     [255, 196, 120]        # glows in the night view
  water:       [96, 150, 172, 215]    # V8.0: the courtyard basin's water

# existing meshes of the model are re-coloured in the viewer when the character is on (first matching rule wins; the rest keep
# their phase-3 colours, e.g. the orange / red structural flags stay visible with the character off)
assign:
  - ["ff_ladder_panel", timber]       # V8.1: the ladder's closed walnut panel in the suite court
  - ["ff_ladder_pilaster|ext_kitchen_counter|ext_kitchen_grill", honey]   # V8.1: the ladder's honey-stone pilaster; the outdoor kitchen
  - ["ext_kitchen_tannour", plaster]
  - ["ff_ladder_stile|ff_ladder_rung|roof_ladder_gate|roof_guardrail_setback", steel]   # V8.1: the ladder, its gate, the set-back guardrail (black steel)
  - ["roof_air_base_door", timber]     # V8.0: the HRV base under the malqaf
  - ["roof_air_base_louvre", steel]
  - ["_outer", plaster]               # outer walls with their sill and lintel pieces
  - ["_wall_", plaster]
  - ["_low_", plaster]
  - ["_slab$", plaster]               # the slab edges between the storeys are plastered over with the walls
  - ["_slab_court$|finish_court$", sand]   # the courtyard floor of the base model (shown when the sunken seating is off)
  - ["finish_floor", porcelain]         # V7.1: marble inside (the courtyard floor stays honey-light stone, below)
  - ["_door_", timber]                # the doors walnut (the store's low door under the half landing too)
  - ["_rail_", steel]                 # the stair balustrades and the well railings: black steel bars
  - ["roof_cornice|ff_band|roof_coping|roof_attic_coping", honey]   # V7.0: the main cornice, the band between the floors, the copings (honey stone)
  - ["roof_attic|roof_parapet|ff_void_wall", plaster]   # V7.0: the attic, the parapets, the W3 wall piece (V8.0: no stair room)
  - ["_stair_", sand]
  - ["_beam_", plaster]               # B3 (behind the fascia and the parapet), R6, R11, trimmers
  - ["roof_air_head_band|roof_air_head_crown|roof_air_cap", honey]   # V10.0: the malqaf head's band and crown in the honey-tone render
  - ["roof_air_head", plaster]        # the head's shaft and ribs: light sand render
  - ["roof_air_void", steel]          # the head's slender openings read dark
  - ["gf_air_grille|gf_air_door_leaf", timber]   # V10.0: the outlet's timber louvres and the carved door
  - ["roof_air_louvre", timber]       # its louvres timber
  - ["all_col_", honey]               # inside the stone sleeves / the wall

# ---------- 2. light ----------
sun: winter-12                        # the sun of the character views (params.yaml sun positions, Taif, true north from base.typ): 21 December noon, 45° from the south: the only sun that reaches down the 3.35 m wide, 7.3 m deep courtyard (it lights the north wall above +0.8 and the gallery); the viewer's sun menu changes it

# ---------- 3. elements ----------
plinth:                               # stone base course around the outside, from the ground to +0.6
  height: 0.6
  thickness: 0.04                     # proud of the wall face; the doors cut through it
  ground: -0.3                        # the ground around the house (the viewer's ground plane)

reveal: 0.20                          # outer-wall windows: the glass set back this far from the outer wall face (deep shaded reveals)
frame: 0.05                           # black steel frame bars (section), on every window at the glass plane
lites: {pitch: 0.78, row: 1.0, bar: 0.035}   # V7.0: divided lites: mullions at ≈ 0.78 m, transoms in rows of ≈ 1.0 m (the guarding transom of W1 / W2 falls at ≈ +4.80)
quoins: {width: 0.5, thickness: 0.03, top: 6.9}   # V7.0: honey-stone quoins at the outer corners, from the plinth to the main cornice

# ---------- V7.1 (owner): the courtyard arcade and the arched enclosure windows ----------
arcade:                               # in the COURTYARD bay only (y 6.5–13.0, between C21 and C22): two slender intermediate columns and three semicircular arches under the projection
  columns: {diameter: 0.25, at_y: [8.6667, 10.8333], base: {diameter: 0.33, height: 0.12}, capital: {diameter: 0.33, height: 0.10}}   # rendered (V10.0: no stone), on x 5.80, three equal bays of 2.1667; V10.0: the first (y 8.667) is absorbed in the malqaf core's east wall
  arch: {thickness: 0.25}             # arch plates under the soffit between the column sleeves, the crown at the soffit bottom; decorative unless the engineer uses the columns (studies/structure.typ X18)
  structural: false                   # the two columns carry nothing in the structural study; the living bay (y 13–19.25) keeps no arches (owner, V6.3)
arched_windows:                       # the courtyard enclosure windows get semicircular heads: the base model cuts each opening to its crown (params.yaml), the spandrel plate above the springing and the arched frame are drawn here
  frame: 0.05
  blind:                              # V10.0 (L5): W1-1 became a BLIND arch: the malqaf shaft stands behind this wall; the surround and a recessed panel on the courtyard face, the same sill, springing and crown as its five sisters (studies/malqaf_L5.typ Phase 3, F3)
    - {floor: FF, at: "5.8 6.783 5.8 8.383", sill: 3.82, crown: 6.60, surround: 0.10, label: "W1-1 blind arch"}
  windows:
    - {floor: FF, at: "5.8 8.95 5.8 10.55", label: "W1-2"}
    - {floor: FF, at: "5.8 11.117 5.8 12.717", label: "W1-3"}
    - {floor: FF, at: "5.8 13.242 5.8 14.842", label: "W1-4"}
    - {floor: FF, at: "5.8 15.325 5.8 16.925", label: "W1-5"}
    - {floor: FF, at: "5.8 17.408 5.8 19.008", label: "W1-6"}
    - {floor: FF, at: "6 6.5 7.3 6.5", label: "W2-1"}
    - {floor: FF, at: "7.55 6.5 8.85 6.5", label: "W2-2"}
    - {floor: FF, at: "6 13.0 8.8 13.0", label: "W3"}

colonnade:                            # the three columns on x 5.6 (C21–C23, assumed Ø0.30 in the structural study), to the roof
  diameter: 0.40                      # the visible stone sleeve around the structural column
  base: {diameter: 0.50, height: 0.15}      # plain band at the foot
  capital: {diameter: 0.50, height: 0.12}   # plain band under the soffit and under the roof

soffit:                               # timber soffit under the projection (the colonnade ceiling), hiding the slab edge and the beam
  thickness: 0.05
  fascia: 0.03                        # timber fascia on the outer face of the slab edge and the upturned beam B3

# pergola: REMOVED (owner, 1 Nov 2026, studies/courtyard_layout.typ): no pergola and no shade structure over the courtyard; character_3d.py and the viewer's toggle to be updated at the next 3D build

mashrabiya:                           # timber screens (simple modern pattern) in the reveal, flush with the outer face: privacy
  depth: 0.05
  frame: 0.06
  slat: 0.03
  pitch: [0.09, 0.27]                 # vertical slats every 0.09, horizontal every 0.27
  windows:                            # "x1 y1 x2 y2" as in the plans; side = the face the screen is on (default: outward)
                                      # fire safety (owner, 1 Nov 2026, studies/fire_escape.typ): NO screen on the escape windows of the bedrooms (1–3, kids', suite) and the maid room;
                                      # mashrabiya only on non-escape windows (the office, the suite lobby, the women's majlis, the dining)
    - {floor: FF, at: "0 19.6 0 20.9", why: "owner's office west window on the driveway / street"}
    - {floor: FF, at: "0 22.0 0 23.5", why: "owner's office west window on the driveway / street"}
    - {floor: FF, at: "8.95 7.6 8.95 9.6", side: [-1, 0], why: "the only first-floor window onto the courtyard (suite lobby): privacy from the courtyard"}
    - {floor: GF, at: "5.4 0 7.8 0", why: "women's majlis north window on the north street"}
    - {floor: GF, at: "13.311 14.5 13.311 17.5", why: "dining east window on the service yard / neighbour"}

feature_walls:                        # Taif stone cladding (0.03) on selected faces; the openings on the face are cut out
  thickness: 0.03
  walls:
    - {name: "guest entrance wall: the west facade south of the living line, both floors to the parapet coping", line: "0 19.25 0 24", side: [-1, 0], z: [-0.3, 8.25]}
    - {name: "courtyard east wall (kitchen below, suite lobby above), both floors: the outdoor TV and the enclosure are on it (V10.0: the malqaf outlet is in the west arcade)", line: "8.95 6.5 8.95 13.0", side: [-1, 0], z: [-0.65, 7.0]}
    - {name: "courtyard north wall: the piers beside the women's majlis glass and the band over it (the glass stays complete)", line: "4.25 6.5 8.95 6.5", side: [0, 1], z: [-0.08, 3.52]}

# fountain: REMOVED (owner, 1 Nov 2026, studies/courtyard_layout.typ): no wall fountain on the kitchen wall (the outdoor TV and the malqaf grille are there); the water basin, the planter and the tree are in the north enclosure (courtyard_layout.enclosure); character_3d.py builds no fountain until the courtyard_layout builder update

courtyard_layout:                     # 3 Nov 2026 (owner, studies/courtyard_layout.typ): the whole courtyard floor LEVEL (no step, no benches), modern MOVABLE furniture, the enclosure
                                      # (water + tree) moved to the NORTH END OF THE EAST (kitchen) WALL in front of the sink window, the TV south of it. Clear faces: the riwaq glass x 4.35,
                                      # the kitchen wall x 8.85, the women's majlis glass y 6.6, the living glass y 12.9; the soffit edge x 5.925
  level: true
  floor: 0.0                          # the whole floor at the inside level less the falls (drainage below); no step anywhere
  seating_zone: [5.925, 7.1, 8.85, 12.3]   # the open strip east of the soffit edge between the north (0.5) and south (0.6) cleaning strips; the enclosure takes its north-east part
  furniture:                          # x0 y0 x1 y1 kind · movable, modern: a 3-seat sofa facing the TV, two armchairs, a low table (4–6 people)
    - [5.95, 9.55, 6.85, 11.75, sofa]
    - [7.3, 9.5, 8.05, 10.25, armchair]
    - [7.3, 11.05, 8.05, 11.8, armchair]
    - [7.15, 10.4, 7.95, 10.9, table]
  tv: {wall: "8.95 6.5 8.95 13.0", y: [9.82, 11.28], z: [0.60, 1.46], model: "65in outdoor-rated (partial sun, IP55/56); size, bracket, ventilation and clearances per the chosen model"}   # on the kitchen wall south of the enclosure, centred on the seating (y 10.55); its bottom +0.60 over the grille (+0.10 … +0.45)
  tv_frame: {inner_width: 1.70, jamb_z: [0.50, 1.50], radius: 0.85, band: 0.10, proj: 0.06, material: honey}   # a semicircular honey-stone surround, visual only, no cavity; crown +2.45
  sink_window: {y: [7.3, 8.9], sill: 1.1, head: 2.1}   # the kitchen sink window (design_gf.typ, params.yaml): the enclosure stands in front of it as the view from the sink
  enclosure:                          # one honey-stone box against the kitchen wall face (x 8.85) from the north cleaning strip: two separate basins
    box: [7.55, 7.1, 8.85, 9.5]
    wall: 0.15
    rim: 0.45                         # the planter's rim (a ledge)
    planter: {inside: [7.70, 7.25, 8.70, 8.30], depth: 0.70}   # the NORTH part (sunny): the tree, its crown in front of the window's north half; own drain, drip irrigation
    water: {inside: [7.70, 8.75, 8.70, 9.35], depth: 0.35, level: 0.85, rim: 0.95, spout_z: 1.05}   # the SOUTH part: a RAISED trough, rim +0.95 (below the sill +1.10, seen from the sink), water +0.85, a laminar lip on the wall side over stone, no spray; own drain + overflow
    pump_cover: [7.75, 8.35, 8.25, 8.58]   # the pump and filter chamber in the divider between the two basins
    tree: {species: "Laurus nobilis standard, or clipped Ficus nitida; final choice by a Taif nursery", stem: 2.0, crown_centre: 3.0, crown_radius: 0.9}
  drainage:                           # levels (studies/courtyard_layout.typ): the inside floors ±0.00; gentle falls AWAY from the three glass lines and the riwaq door to the kitchen wall foot
    court_at_glass: -0.015            # at the three glass lines and the riwaq door (a 15 mm threshold, R-08)
    fall: 0.01
    court_at_wall: -0.06              # at the kitchen wall foot: the main linear drain
    linear_drains:                    # x0 y0 x1 y1: slot drains with silt baskets, each to the separate RAIN system (never the foul); automatic trap primers
      - [8.73, 9.6, 8.85, 12.8]       # along the kitchen wall foot south of the enclosure (under the TV)
      - [4.35, 9.0, 4.47, 10.6]       # at the riwaq door's threshold (wind-driven rain at the door)
    overflow_at: [8.6, 12.6]          # SE corner: an independent gully, rim −0.03, its own pipe east to the rain chamber
    overflow_rim: -0.03
    pipe_z: -0.55                     # the pipe invert at the drains, 1 % east under the kitchen floor to the east RAIN chamber (never the foul chamber)
  pergola: none

# roof (V7.0 / V8.1): the parapets, the cornice, the attic, the HRV base, the ladder and the set-back guardrail are in 3d/params.yaml `roof_design` (base model); the guards round the roof holes here

# malqaf_louvres: removed (V10.0, L5): the head's slender arched slots are its openings (build_3d.py)

props:                                # scale only, simple shapes (the courtyard's movable furniture: courtyard_layout; the suite court's furniture: suite_court_v2)
  lanterns:                           # hanging between the columns under the soffit edge; point lights in the night view
    size: [0.25, 0.25, 0.4]
    drop: 0.6                         # rod from the soffit
    at: [[5.6, 9.75], [5.6, 16.125]]  # the middle of each span

# ---------- 4. the TV wall (V6.3, owner decision): the living's west wall solid and full height, an arched entrance and an arched TV niche ----------
tv_wall:
  entrance: {at: "4.25 13.1 4.25 14.5", head: 2.6}   # the 1.40 m entrance arch (the base model cuts the opening to +2.60 from 3d/params.yaml; the plate above its springing is drawn here)
  niche: {y: [14.75, 19.15], depth: 0.70, head: 3.1, rise: 0.45}   # the niche between the pier (y 14.5–14.75) and the south wall: 4.40 wide, 0.70 deep, a segmental arch with its crown at +3.1 under the soffit
  pier: {y: [14.5, 14.75]}
  cabinet: {y: [15.05, 18.85], depth: 0.5, height: 0.45}   # a long low cabinet; the TV centred above it; shelves at both ends; hidden LED (not modelled)
  tv: {width: 1.9, height: 1.08, bottom: 0.7}            # 85″
  shelves: {depth: 0.4, height: 2.2}
  sofa_back_x: 8.45                                        # the sofa (3.8 m, y 15.0–18.8) faces west; eye 0.55 in front of its back

# ---------- 5. views ----------
views:                                # eye-level and aerial bookmarks: CSV frame (x east, y south) + height above ±0.00 · V8.0: the five release views first
  north:      {title: "the north facade from the north street: the main cornice, the set-back attic, the malqaf on its HRV base", eye: [5.6, -13.5, 1.6], target: [6.6, 0.0, 4.6]}
  aerial_se:  {title: "aerial from the south-east: the roofline (the attic 1.38 m, the south parapet 0.70 with the set-back guardrail), the malqaf tower; no stair tower (V8.1)", eye: [27.0, 37.0, 19.0], target: [8.0, 12.0, 4.0]}
  courtyard:  {title: "the main courtyard from the seating, looking west to the arcade and the arched gallery windows", eye: [8.6, 10.6, 1.35], target: [4.4, 10.2, 2.3]}
  suite_court_sw: {title: "the suite court from its east armchair, looking west-south-west: the gym wall with the ladder's walnut panel in its stone pilaster, the stiles above the roof, the south frame", eye: [8.85, 22.05, 4.75], target: [4.3, 22.9, 5.6]}
  suite_court: {title: "the suite court from its seating, looking north to the clerestory windows and the doors", eye: [7.1, 23.35, 4.8], target: [7.4, 19.0, 5.3]}
  tv:         {title: "inside the double-height living, looking west to the TV wall", eye: [8.3, 16.9, 1.6], target: [4.35, 16.95, 1.9]}
  living:     {title: "inside the double-height living, looking north to the courtyard and its seating", eye: [7.5, 18.3, 1.6], target: [7.5, 9.6, 0.0]}
  street:     {title: "guest entrance facade from the street (west, the driveway side)", eye: [-15.0, 27.0, 1.6], target: [0.0, 16.0, 3.5]}
  court:      {title: "the courtyard from the seating (V10.0): the malqaf's outlet arch, the blind arch above it and the head on one axis", eye: [7.0, 12.4, 1.6], target: [5.1, 7.6, 7.5]}
  aerial_ne:  {title: "aerial view from the north-east (V10.0): the cut wall, the lane side, the malqaf head at the courtyard's north-west corner", eye: [24.0, -9.0, 19.0], target: [9.6, 4.0, 8.5]}
  aerial_sw:  {title: "aerial view from the south-west (V10.0: the malqaf head at the courtyard's north-west corner; render and paint): the house at its final position (B1 6.00 m from M1), the shorter cut wall, the driveway, the old house and its covered parking (approximate), the garden and the two palms", eye: [-30.0, 50.0, 30.0], target: [2.0, 12.0, 0.0]}
  gate:       {title: "the north facade from just inside the farm's main gate (V10.0): the family entrance, the north strip, the cornice, the attic; the malqaf (L5) stands behind the facade, out of this view", eye: [-3.9, -4.9, 1.7], target: [9.0, -0.6, 3.9]}
  lobby:      {title: "the family entrance: from the door, the lobby and the start of the flipped stair (the lower flight rising south off the lobby behind its black-bar balustrade, the coat cupboard in the west half of the start strip)", eye: [3.95, 1.1, 1.6], target: [2.2, 5.6, 1.1]}
  court_screen: {title: "the suite court looking south through the mashrabiya screen on the 1.10 base, under the facade frame (V8.2)", eye: [7.1, 20.2, 4.75], target: [7.1, 24.0, 5.4]}
  w3:         {title: "inside the double-height living, looking north to the courtyard and the large arched window W3", eye: [7.3, 18.6, 1.6], target: [7.3, 13.0, 4.0]}
  night:      {title: "the courtyard at night, from the south-east corner towards the colonnade", eye: [8.6, 12.4, 1.6], target: [5.3, 8.4, 2.4], night: true}
night:                                # the night view: dark sky, the lanterns and warm room lights
  background: "#121826"
  point_lights:                       # (x, y, height, intensity): warm lights inside the rooms round the courtyard, besides the lanterns
    - [6.6, 3.2, 2.6, 0.9]            # women's majlis
    - [6.6, 16.0, 2.8, 1.1]           # double-height living
    - [11.0, 9.8, 2.5, 0.6]           # kitchen
    - [4.9, 12.0, 5.8, 0.6]           # gallery
    - [8.0, 10.5, 0.4, 0.5]           # the courtyard seating (the riser light)

# outdoor_kitchen: V8.1 built from 3d/params.yaml `outdoor_kitchen` (the counter at the east wall, the grill and tannour apart); no service gate on the lane (the farm's single 4 m main gate is the only entry)
suite_court_v2:                      # owner, 1 Nov 2026 (studies/ff_suite.typ, south_wing.typ): DATA for the 3D builder
  court: [[4.25, 20.55], [5.8, 20.55], [5.8, 19.25], [10.0, 19.25], [10.0, 24.0], [4.25, 24.0]]
  strip: [5.9, 19.35, 9.9, 20.55]    # the 1.2 m movement strip in front of the three doors
  floor_drop: 0.12                   # the court's structural slab depressed for the falls (finished floor flush with the rooms)
  fall: 0.015                        # south, away from the doors, to the box gutter at y 23.75
  furniture: [[6.0, 22.95, 8.2, 23.8, "sofa"], [5.0, 21.7, 5.75, 22.45, "armchair"], [8.45, 21.7, 9.2, 22.45, "armchair"], [6.5, 21.95, 7.7, 22.65, "table"], [4.4, 23.2, 5.0, 23.8, "tree"], [9.25, 23.2, 9.85, 23.8, "plant"]]   # V8.1: the tree pot moved off the ladder's pilaster (studies/ff_suite.typ)
  south_side: {base: 1.1, chosen: "b", screen: {from: 4.7, to: 6.7, open: 0.4, frame: 0.06, slat: 0.045, pitch: [0.09, 0.27], depth: 0.05, material: "timber or black steel lattice (mashrabiya) in the design language: the palms seen out, no view in"}, options: {a: "solid wall to the frame", b: "mashrabiya screen on the 1.10 base to the frame soffit (ADOPTED, owner 2 Nov 2026)", c: "1.1 m wall, open above"}, frame: "R8 + the cornice + the parapet +8.00 across (V8.1)"}   # the screen is built at the release
  entry_wardrobe: [10.0, 16.85, 10.6, 19.15]   # inside the suite bedroom: the bed out of sight from the court
  guards: [[[5.8, 19.25], [5.8, 20.55], [4.25, 20.55], [4.25, 20.85]], [[4.25, 21.75], [4.25, 24.0]], [[10.0, 19.25], [10.0, 24.0]]]   # the roof guards on the court's open edges (the gym roof / nib, the office roof); V8.1: the gap y 20.85–21.75 is the ladder's self-closing gate (base model)

# ---------- V8.2 · the coat cupboard (stair flip, owner decision 3 / 4): a full-height walnut cupboard in the west half of the stair's start strip ----------
coat_cupboard: {box: [0.125, 2.3, 1.3875, 3.75], height: 2.4}   # design_gf.typ inner boxes; its doors face the lower flight's start (east); the height assumed (to the door-head line)

# ---------- V8.2 · the site elements of studies/site_plan.typ that the builder supports (STUDY, every position proposed, to confirm with the survey) ----------
# SITE frame (origin peg M1; the house = CSV + shift): the builder subtracts the shift. kinds: path (a polyline strip), slab (a polygon), wall / hedge (a polyline with a height), box (x0 y0 x1 y1 with a height)
site:
  shift: [0.91, 6.0734]   # V9.1: 8 Nov 2026 (owner's car test) B1 6.00 m from M1, a further 0.5104 m south; V9.0 (layout freeze): 6 Nov 2026 (owner) a further 0.50 m south, B1 5.49 m from M1; 4 Nov 2026 (owner, on site): the house 1.238 m further south; the elements attached to the house moved with it, the driveway and the parking bay stayed
  elements:
    - {label: driveway, kind: slab, pts: [[-3.95, 0.73], [0, 0], [0, 38.86], [-3.95, 39.59]], material: concrete, note: "the existing driveway 3.95 m west of the M line (stays)"}
    - {label: path_family, kind: path, pts: [[-1.0, 2.6], [4.41, 2.6], [4.41, 5.9484]], width: 1.0, material: honey, note: "the family entrance path from the driveway"}
    - {label: path_guest, kind: path, pts: [[-1.0, 39.6], [-1.0, 28.2734], [0.9, 28.2734]], width: 1.2, material: honey, note: "the guest path in honey stone along the driveway's east edge to the guest entrance"}
    - {label: path_workers, kind: path, pts: [[-1.0, 0.7], [8.3, -1.0], [11.8, 0.8], [14.6, 7.3], [16.9, 10.6], [16.9, 12.31]], width: 0.9, material: sand, note: "3 Nov 2026 (proposal): the workers' path along the farm's north boundary wall and the lane-side strip to the yard, not along the house's north facade"}
    - {label: parking_bay, kind: box, box: [5.2, 1.77, 10.2, 4.27], height: 0.02, material: sand, note: "the uncovered family car in the north strip (kept, owner 2 Nov 2026)"}
    - {label: garden, kind: slab, pts: [[0.9, 30.1984], [14.35, 30.1984], [14.35, 21.8484], [22.5, 21.8484], [26.74, 33.94], [0.9, 38.7]], material: foliage, note: "the family garden on the south only, round the palms"}
    - {label: garden_wall, kind: wall, pts: [[0.6, 30.1984], [0.6, 38.7]], width: 0.3, height: 1.2, material: honey, note: "the 1.2 m honey-stone wall between the garden and the guest path"}
    - {label: hedge, kind: hedge, pts: [[14.35, 20.7484], [22.2, 20.7484]], width: 0.6, height: 1.8, material: foliage, note: "the 1.8 m hedge between the service yard and the garden"}
    - {label: yard_screen, kind: box, box: [16.11, 13.6734, 16.21, 19.0734], height: 1.8, material: plaster, note: "3 Nov 2026: the 1.8 m service yard screen moved east (CSV x 15.2–15.3, y 7.6–13.0) so the outdoor counter has a working strip"}
    - {label: gas_cabinet, kind: box, box: [16.26, 13.8734, 16.76, 14.8734], height: 1.0, material: steel, note: "the ventilated LPG cabinet on the screen's outer face at its north end, ≥ 3 m from the grill"}
    - {label: bins, kind: box, box: [14.61, 11.3734, 15.41, 12.1734], height: 1.1, material: steel, note: "the bins north of the service door, outside the food area"}
    # V9.0 · the EXISTING farm round the new house (data/site_v2.csv, studies/whole_farm.typ, studies/site_plan.typ; the owner's answers of 5 Nov 2026): APPROXIMATE, to be measured on site
    - {label: old_house, kind: block, pts: [[-16.13, 5.57], [-18.20, 27.55], [-8.04, 28.51], [-5.97, 6.53]], height: 3.8, material: plaster, existing: true, note: "the old house (one-storey RC, the old majlis inside it) from the deed sketch, ± 1–3 m: to be measured (SITE_SETOUT.md § 8, W1–W4)"}
    - {label: old_annex, kind: wall, pts: [[-3.83, 16.67], [-4.83, 28.66], [-10.85, 28.58], [-9.83, 16.60], [-3.83, 16.67]], width: 0.2, height: 2.2, material: plaster, existing: true, note: "the old house's annex (the yard wall / dakka) from the deed sketch: to be measured (A1–A4)"}
    - {label: old_carport, kind: canopy, box: [-10.0, 29.2, -4.5, 34.7], height: 2.6, material: steel, existing: true, note: "the existing covered parking for two cars south of the old house, open to the driveway (assumed 5.5 × 5.5; P1–P4 to be measured)"}
    - {label: old_tank, kind: box, box: [-7.5, 35.7, -4.5, 38.2], height: 0.3, material: concrete, existing: true, note: "the existing ground tank (its lid above the ground), near peg R (assumed 3 × 2.5; K0–K2 to be measured); the reserved tank beside it (west) not drawn"}
    - {label: old_septic, kind: box, box: [-10.5, -1.9, -6.5, 0.5], height: 0.15, material: concrete, existing: true, note: "the existing septic outside the north wall near C1 (approximate; it serves the old house and takes the new house's drains)"}
    - {label: farm_wall_north, kind: wall, pts: [[-16.7, 3.08], [-3.95, 0.73]], width: 0.25, height: 2.4, material: plaster, existing: true, note: "the farm's north boundary wall from corner C1 to the gate's west post (height assumed)"}
    - {label: farm_wall_north_east, kind: wall, pts: [[0.0, 0.0], [8.64, -1.59], [11.96, 0.17], [15.39, 6.51], [15.68, 7.37], [16.75, 7.83], [20.19, 13.91], [23.02, 20.37], [27.07, 35.15]], width: 0.25, height: 2.4, material: plaster, existing: true, note: "the farm's north wall from the gate's east post M1 and the lane wall (on the deed line here; the wall as built stands 0.62 m inside it at the cut wall)"}
    - {label: gate_post_west, kind: box, box: [-4.15, 0.53, -3.75, 0.93], height: 2.6, material: honey, existing: true, note: "the 4 m main gate's west post (the gate drawn open)"}
    - {label: gate_post_east, kind: box, box: [-0.2, -0.2, 0.2, 0.2], height: 2.6, material: honey, existing: true, note: "the gate's east post = peg M1, the origin of the set-out"}
    - {label: palm_1, kind: palm, at: [20.6, 28.09], radius: 0.265, height: 9.0, crown: 2.6, material: trunk, existing: true, note: "palm P1 (base.typ, v2 survey), height assumed"}
    - {label: palm_2, kind: palm, at: [21.39, 31.87], radius: 0.265, height: 8.0, crown: 2.4, material: trunk, existing: true, note: "palm P2 (base.typ, v2 survey), height assumed"}
