ahl20006/House_git/(commit log)

2026-10-14 changed the bulding to be located in Z4
    [rooms_v3.csv]
2026-10-15 V3.1: Z4 design with west wash block and east service block
    - Building on site-test option Z4 (0.75 m wider through the middle);
    men's majlis west wall on the west band line.
    - West wash block: family basins, family WC and guest wing as one
    section with a two-door serving passage (studies/guest_wing.typ).
    - East service block: kitchen 4 x 6.5 on the courtyard lines, laundry on
    the women's majlis wall, sloped maid room and maid bath
    (studies/east_wing.typ).
    - base.typ: optional "pts" column for rooms that are not rectangles
    (site data unchanged).
    - design_v3.dxf: one DXF of the whole design, generated by
    tools/make_dxf.py; tools/check_v3.py checks everything.
    - notes.md rewritten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
    [design_v3.dxf, rooms_v3.csv]
2026-10-16 V3.2: Concept V3.1 Revision 02 (five owner notes)
    - Slope runs on to the maid room's south end (y 6.0); east wall moves
    out 0.311 m (13.311 m on axes). Building 0.26 m further east.
    - Middle band exactly 4.50 m clear (4.70 m on axes).
    - Coffee / basins wall; no stair or living-room door; living room's
    west wall is a 1.20 m low partition.
    - Serving passage 1.6 m deep (1.20 m clear at the shelf); guest block
    and south facade 0.50 m further south.
    - design_v3.typ checks the outer wall face against the envelope.
    - Studies, CSV, DXF, notes and READMEs updated.
    [design_v3.dxf, rooms_v3.csv]
2026-10-16 V3.3: service wing 0.5 m longer, future lift, hospitality kitchen, foyer
    - Building 0.5 m longer to the south (north wall and NE cut unchanged):
    women's majlis 6.5 m, maid wing to y 6.5, coffee corner 2.5 m.
    - Maid wing: 100 mm partition moved 0.15 m east, laundry 0.95 m clear
    walkway; maid room 7.06 m2 axes (about 6.0 m2 clear).
    - Lift becomes a future shaft placeholder + entry cupboard.
    - Coffee corner becomes the hospitality kitchen.
    - Serving passage 1.4 m, no shelf; guest WC on the men's majlis line;
    trough basin; foyer double door and 1.8 m opening to the majlis.
    - Site test row, studies, DXF (west fixtures added), notes updated.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
    [building.csv, design_v3.dxf, rooms_v3.csv]
2026-10-16 V3.4: smaller air tower, maid wing 0.2 m longer to the north
    - Air tower 1.2 -> 1.0 m deep (about 0.88 m2 clear, at least 0.93 m wide).
    - Maid bath 0.2 m north (same 1.6 m depth), door 0.60 m.
    - Maid room and laundry 0.2 m longer to the north (maid room about
    6.18 m2 clear, laundry 1.70 x 3.9).
    - CSV, design, east study, DXF, notes and READMEs updated.
    [design_v3.dxf, rooms_v3.csv]
2026-10-16 Ground floor V4.0 final; first-floor starting point
    - Change 8: the 0.2 m freed by the 1.0 m air tower goes to the maid bath
    (1.8 m deep, about 3.0 m2 clear); maid room and laundry back to V3.3
    (maid room about 6.0 m2 clear, the 6.5 m2 target dropped).
    - East duct placed in the kitchen's north-east corner.
    - Repo restructured: taif_house/ with design_gf.typ, data/rooms_gf.csv,
    studies/, tools/ (check.py, make_dxf.py, schedule.py), docs/, output/,
    archive/. base.typ: two text lines only.
    - docs/GROUND_FLOOR_V4.md (master document), docs/FIRST_FLOOR_BRIEF.md,
    design_ff.typ + data/rooms_ff.csv (first-floor starting point).
    [building.csv, building_options_Z3_Z4_V3.csv, design_v3.4.dxf, rooms_C1.csv, rooms_ff.csv, rooms_gf.csv, taif_ground_floor_V4.dxf]
2026-10-17 First floor V4.1 baseline: zoning and first room layout; details to follow
    - Zoning: master suite east, children west around the shared bath,
    family living and office north at the stair top, bedroom 1 + bath at
    the east duct.
    - Men's majlis roof used: bedroom 3, family gym, suite terrace and a
    2.0 m light strip in front of two small clerestory windows.
    - Light-strip check, furnished test, room table and open items.
    - docs: FIRST_FLOOR_BRIEF V4.1 section, notes, NEXT_SESSION.md.
    [rooms_ff.csv, taif_ground_floor_V4.dxf, zones_ff.csv]
2026-10-20 V5.0: first floor designed, ground floor coordinated
    First floor V5.0 (design_ff.typ + data/rooms_ff.csv, checked room for room
    against studies/ff_family.typ and studies/ff_suite.typ):
    - family part: kids' room (study + gaming), family living on the courtyard
    edge, bedroom 1 (one room, straight wall on y 6.5), family bath, bedroom 2,
    bedroom 3 with its own bath; the gallery on a 1.35 m west projection over
    the courtyard and the double-height void, so the west rooms are 4.25 m wide
    - the L: owner's office, gym route, gym, suite court (open to the sky in
    front of the clerestory windows) and the master suite (lobby from the
    family link, luxury bath with WC closet, walk-in dressing, be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
    [rooms_ff.csv, rooms_ff_V4.1.csv, taif_ground_floor_V5.dxf, zones_ff_V4.1.csv]
2026-10-20 V5.0: presentation set for both floors
    presentation.typ -> output/Taif_House_V5.0_presentation.pdf, 8 sheets:
    site, ground floor, first floor, family part, the L and master suite,
    sections, area schedules, open items for the engineers. Walls drawn with
    thickness from the room data, doors cut into the walls with swings,
    windows, fixture symbols, room IDs G01-G22 / F01-F21, Arabic notes.
    Reads the V5.0 CSVs and studies live. Added to tools/check.py; README,
    notes and NEXT_SESSION updated. ALL CHECKS PASSED.
    [taif_ground_floor_V5.dxf]
2026-10-23 Variant SP (study): split the first-floor west projection 0.675 in + 0.675 out
    Not approved, not for main. The V5.0 1.35 m projection over the courtyard
    and double-height void is split: 0.675 m inward (plain cantilever, no
    columns) and 0.675 m beyond the GF west wall (FF west wall on cantilever
    beams, y 10.4-24). The whole west band moves 0.675 m west; stair, lift,
    landing and shaft stay. Courtyard sky / void 3.35 -> 4.025 m on axes,
    rooms 4.25 m and gallery 1.35 m kept, FF west face 0.11 m from the M line.
    Forced: family bath 2.75 -> 2.075 m wide; niche, gym and suite court longer.
    New studies/sp_compare.typ (comparison + E-W sections), docs/VARIANT_SP.md,
    presentation -> Taif_House_V5.0-S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
    [rooms_ff.csv, taif_ground_floor_V5.dxf]
2026-10-23 V5.1: split west projection (M-line approval pending); rectangular gym with treadmill at the west end
    Split projection accepted (branch v5-split-projection, merged): 0.675 m
    inward over the courtyard / double-height void as a plain cantilever (the
    three V5.0 columns at x 5.6 removed) and 0.675 m beyond the GF west wall
    south of y 10.4 (FF west wall on cantilever beams). West rooms 4.25 m,
    gallery 1.225 m clear, courtyard sky 4.025 m axes / 3.825 m clear; family
    bath 2.075 m wide, wider niche, gym and suite court 0.675 m longer.
    Top open item: municipality / engineering office to confirm the FF
    projection 0.11 m from the M line, else back to V5.0 (tag v5.0).
    L-shaped gym rejected (branch v5-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
    [taif_ground_floor_V5.1.dxf]
2026-10-23 V6.0: clean release, both floors, presentation and full documentation
    No design change from V5.1 (room CSVs and base.typ unchanged).
    - Everything labelled V6.0; version history moved to the changelog.
    - New studies/sections.typ (was sp_compare.typ): levels, split
    projection, light check and both sections, shared by design_ff and the
    presentation; design_ff takes its placement from design_gf.
    - Presentation rebuilt on A3, 10 sheets, English + Arabic notes, every
    number from the files: site, both floors, family part, office / gym /
    suite, the two GF blocks, sections and light, schedules, decisions log
    (data/decisions.csv), open items (data/open_items.csv).
    - First-floor DXF (tools/ma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
    [building.csv, decisions.csv, open_items.csv, taif_first_floor_V6.0.dxf, taif_ground_floor_V5.1.dxf, taif_ground_floor_V6.0.dxf]
2026-10-24 V6.1: split projection reverted to the V5.0 columns solution
    The first-floor west band is back on the full 1.35 m inward projection
    over the courtyard and the double-height void (x 4.25-5.6), on an edge
    beam on x 5.6 and three columns in existing wall / glass lines; the FF
    west wall stands on the GF west wall (0.785 m from the M line).
    data/rooms_ff.csv is identical to tag v5.0; the studies' geometry blocks
    are restored from v5.0, keeping the V5.1/V6.0 decisions (rectangular gym
    with the treadmill at its west end, refitted to the V5.0 gym; court
    naming; corrected suite neighbour outlines).
    - sections.typ reads the projection and the columns; comparison with the
    reverted split projection on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
    [building.csv, decisions.csv, open_items.csv, rooms_ff.csv, taif_first_floor_V6.0.dxf, taif_first_floor_V6.1.dxf, taif_ground_floor_V6.0.dxf, taif_ground_floor_V6.1.dxf]
2026-10-24 V6.2: L-shaped gym with the treadmill arm at the east end
    Owner's decision, from the v5-gym-L study adapted to V6.1:
    - Gym is one L-shaped room in data/rooms_ff.csv: the long arm along the
    south facade (barbell + rack, kettlebells, pull-up bar, pilates mat,
    one cardio machine) and a 1.725 x 2.0 m arm at the east end along the
    suite bedroom wall holding only the treadmill (0.3 m each side, 0.1 m
    off the wall, 0.5 m free behind in the long arm). 28.37 m2.
    - Suite court 5.99 x 2.0 = 11.97 m2, still open, private and enclosed;
    floor falls west to its drain; bedroom window and door unchanged.
    - Clerestory light unchanged (81 % winter noon sun, 100 % sky); the light
    check now takes the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
    [building.csv, decisions.csv, open_items.csv, rooms_ff.csv, taif_first_floor_V6.1.dxf, taif_first_floor_V6.2.dxf, taif_ground_floor_V6.1.dxf, taif_ground_floor_V6.2.dxf]
2026-10-24 3D phases 1-2: masses and walls generated from the CSVs
    New taif_house/3d/: params.yaml (levels, slab and wall thicknesses,
    projection width), build_3d.py (reads data/rooms_*.csv, the outline and
    air tower from design_gf.typ, proj-x and the fixed elements from
    studies/ff_family.typ, open_edges.csv; builds the three slabs with the
    courtyard sky / double-height / suite court voids, the 0.25 m outer wall
    rings and 64 interior walls of 0.20 m on the room edges, the 1.20 m low
    partition; exports a Y-up GLB, a base64 .js for the viewer and a JSON
    summary), open_edges.csv (20 open edges with their sources), check_3d.py
    (rooms enclosed, no duplicate walls, thicknesses and heights, slab areas
    against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
    [open_edges.csv]
2026-10-24 Structural study (preliminary)
    studies/structure.typ (stand-alone, 6 pages) and docs/STRUCTURE_STUDY.md:
    an architectural coordination study, every size assumed for the
    structural engineer. RC skeleton with block infill: 36 columns on the
    existing wall lines, all footing-to-roof (the three colonnade columns to
    the first floor), spans 2.2-6.5 m; a west core (lift, shaft, stair) and
    an east RC box (laundry wall, cut wall, kitchen north wall) for balanced
    stiffness. Slabs solid 0.20 / ribbed 0.30, a flat 0.22 roof over the
    double-height living with no beam in the void. 21 first-floor and 10
    roof beams with assumed depths; what carries every first-floor wall.
    Options compared: the projection edg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
2026-10-24 3D phase 3: doors and windows, stair, colonnade zone; owner decisions X8, B1, kitchen service door
    3D (3d/, generated from the project files):
    - finished vs structural levels in params.yaml (finish 0.08 assumed), slabs to the outer wall face (the phase-2 white dots were a real groove)
    - all doors (28) and windows (31) of both floors cut through the walls, glass transparent; heights assumed in params
    - the stair as drawn in studies/structure.typ: 22 risers, 1.21 m flights, half landing, L-shaped opening, trimmers B16-B18, balustrades; headroom checked (min 2.14 m to the beam soffit)
    - colonnade C21-C23 to the roof (X8), edge beam B3 upturned with the gallery railing on it, B5, R11, C33: orang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
    [decisions.csv, open_items.csv, taif_first_floor_V6.2.dxf, taif_ground_floor_V6.2.dxf]
2026-10-24 Air system study (malqaf, tunnel, water channel)
    - studies/air_system.typ (4 pages) and docs/AIR_SYSTEM.md: tower head 2.5 m above the roof (louvres N + W, screen, damper, hatch),
    base box to -3.15, tunnel route A under the women's majlis (1.0 x 1.4 clear, top -1.30, 1.5 % fall, separate waterproof box),
    water channel in the last 3.5 m (drained daily, no sprays rule), outlet chamber in the courtyard floor (grating, ladder, sump,
    cooler place, louvred kerb), route comparison A vs B, long section, cross sections, maintenance table, 10 items A1-A10
    - structural study: X9, foundations and the air tower paragraph updated to the chosen route (still assumed)
    - 3D: head, base box, tunnel, chan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
2026-10-24 Air system v2: dry malqaf, small duct, wall outlet; main ventilation system
    - studies/air_system.typ and docs/AIR_SYSTEM.md rewritten (v1 air-p1 withdrawn): the house's main ventilation is a calculated
    MEP system (ERV to the closed rooms, exhausts, AC), roof plant area and the west shaft riser reserved (items M1-M3);
    the malqaf is a dry natural supplement for night ventilation (screen + rated filter slot, damper closed by day / dust / cold);
    a small dry sealed duct 0.6 x 0.6 clear (assumed), top -1.00, route A under the women's majlis, cleaned from both ends;
    the outlet a low grille in the courtyard's north wall (+0.2 ... +0.8) through a chamber under the floor with a sealed cover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
    [decisions.csv, open_items.csv]
2026-10-28 3D: architectural character study (Taif-inspired), arches variant
    STYLE STUDY, PROVISIONAL: everything in this phase is driven by 3d/character.yaml and built by 3d/character_3d.py
    (called from build_3d.py) as chr_<group>_<material>_<label> meshes; the viewer re-colours the model by material
    and shows the elements with toggles; nothing in base.typ, the room CSVs, the design files or params.yaml changed.
    - materials as flat colours: warm plaster walls, Taif stone (colonnade sleeves O0.40 on the assumed O0.30 columns,
    plinth 0.6, feature walls: guest entrance wall, courtyard east wall, courtyard north wall piers, copings), light stone
    floors, timber (soffit + fascia under the projection, pe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
2026-10-28 3D character r2: lighter colours, sun shadows, malqaf outlet on the kitchen wall, sunken seating
    STYLE STUDY, PROVISIONAL (3d/character.yaml, character_3d.py, viewer.html). Revision 2:
    - lighter, warmer colours: cream plaster walls, honey-coloured Taif stone, medium warm timber, light stone floors, dark bronze frames
    - the character views render with the sun and its shadows over a soft ambient light (character.yaml sun: winter-12, Taif, true north
    from base.typ: the only sun that reaches down the 3.35 x 7.3 m courtyard); the night view keeps its lanterns and warm room lights
    - malqaf outlet moved to the kitchen wall (OWNER DECISION, recorded in studies/air_system.typ v2.1, docs/AIR_SYSTEM.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
    [decisions.csv]
2026-10-30 Requirements and full design review (V6)
    - docs/REQUIREMENTS.md: the owner's brief as 35 numbered, testable requirements (R-01 … R-35) with measurable criteria
    - docs/review/design_review.typ -> output/Design_Review_V6.pdf: a 23-page A4 review of the current design (main after 3d-char2)
    against the requirements, Saudi regulation and practice (MOMAH villa rules 2024, SBC, Saudi Architecture Map Taif Highlands)
    and global best practice, with short Arabic summaries per section. Every area, width, distance and glazing figure is computed
    from the project files at compile time (the presentation's clear-area helpers, the studies, 3d/params.yaml, 3d/character.yaml).
    Contents: verdict, top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
2026-10-30 V6.3: quick fixes from the design review
    TV wall solid with the entrance arch and the TV niche (no colonnade arches); lift installed at
    construction; bedroom and bathroom doors 1.00 m openings; suite bath window 0.55 m (X3 resolved);
    3D slabs from the structural study; house 0.30 m south (provisional); two-children bedroom test.
    [building.csv, decisions.csv, open_edges.csv, open_items.csv, rooms_gf.csv, taif_first_floor_V6.2.dxf, taif_first_floor_V6.3.dxf, taif_ground_floor_V6.2.dxf]
2026-10-30 Design language; courtyard enclosure study (Y-01): options A and B, recommendation A
    Study only: no CSV, plan or 3D file changed. Changes listed in docs/PENDING_CHANGES.md.
2026-10-30 Maid wing to the municipal minimum (kitchen wall to y 7.0); courtyard enclosure option A applied (projection 1.55 m, W1-W3)
    Source files only (CSVs, design_gf/ff marks, east_wing, ff_family, structure, air_system, courtyard_enclosure,
    3D data, decisions, open items). Presentation, DXFs and 3D not rebuilt: see docs/PENDING_CHANGES.md.
    [decisions.csv, open_edges.csv, open_items.csv, rooms_ff.csv, rooms_gf.csv]
2026-10-30 Roof study (F-07): main stair to the roof, set-back attic 1.8 m behind a stone main cornice, stepped roofline, roof zones
    Owner decisions of 31 Oct 2026. studies/roof.typ + output/roof.pdf; structure.typ (R16-R18, stair well in the roof, X16, X17);
    design language (roof row); decisions and open item 14 (lift headroom). Pending items in docs/PENDING_CHANGES.md.
    [decisions.csv, open_items.csv]
2026-10-30 V7.0: courtyard enclosure, maid room, roof access and attic, design language
    Courtyard enclosure option A (W1-W3 black steel divided-lite windows, projection 1.55 m, colonnade at x 5.80, sky 3.15 m);
    maid room to the municipal minimum (kitchen north wall at y 7.0, 7.28 m2 clear); main stair to the roof with a stair room;
    flat roof with a honey-stone main cornice, set-back attic 1.8 m on the north block, south-wing parapet; design language.
    3D generated with all of it (4 renders); presentation 12 sheets incl. roof plan and elevations; three DXFs; review status
    page; docs (PROJECT_V7.md, OPEN_ITEMS, REQUIREMENTS, NEXT_SESSION, READMEs); PENDING_CHANGES cleared.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
    [taif_first_floor_V6.3.dxf, taif_first_floor_V7.0.dxf, taif_ground_floor_V6.3.dxf, taif_ground_floor_V7.0.dxf, taif_roof_V7.0.dxf]
2026-10-30 V7.1: arched enclosure windows, courtyard arcade
    Semicircular heads on the courtyard enclosure windows (W1 six windows 1.60 m on the gallery edge over the arcade bays,
    W2 two windows 1.30 m, W3 one window 2.80 m; crowns +6.60, 0.15 m below the roof edge beams); a three-arch courtyard
    arcade on two slender stone columns (decorative); the 3D, presentation (12 sheets), three DXFs, review status and
    documentation regenerated for V7.1.
    [decisions.csv, open_edges.csv, taif_first_floor_V7.0.dxf, taif_first_floor_V7.1.dxf, taif_ground_floor_V7.0.dxf, taif_ground_floor_V7.1.dxf, taif_roof_V7.0.dxf, taif_roof_V7.1.dxf]
2026-10-31 Fire safety decision (home level: early warning and safe exit) applied; the study simplified and verified
    Mashrabiya removed from the five bedroom escape windows (data); the maid window an escape casement at sill +1.10; alarm and
    equipment marks on both plans; escape-window lists in the first-floor studies; R-33 without the safe room, R-36 added; the
    decision recorded; studies/fire_escape.typ rewritten with the adopted scheme, the §5 verification (6/6 windows pass, 14 smoke +
    1 heat + 1 CO, one problem: the doorless kitchen-laundry opening -> proposal P1) and the family escape plan.
    [decisions.csv]
2026-10-31 Courtyard layout (owner decisions): seating one step down, outdoor TV with stone surround and the malqaf grille below it, north water/tree enclosure, no pergola, drainage section
    studies/courtyard_layout.typ -> output/courtyard_layout.pdf; data in 3d/character.yaml courtyard_layout (builder update pending),
    the grille/chamber/duct moved in the air study, marks on the ground-floor plan, R-23/R-24/R-30 updated, the decision recorded.
    Conflict found: the kitchen sink window sits where the TV goes (proposal: move it north to y 7.3-8.9, not applied).
    [decisions.csv]
2026-10-31 Kitchen sink window moved north (owner); air system v3: one tower, two separate paths (final concept, all figures assumed, MEP to design)
    Part 1: the sink window at y 7.3-8.9 over the sink, dishwasher south of it; the TV, its surround and the grille unchanged;
    kitchen and courtyard sides of the wall in one elevation (courtyard study). Part 2: studies/air_system.typ and docs/AIR_SYSTEM.md
    rewritten: breeze shaft + service compartment in the tower, four-sided head with back-draught flaps, spring-return damper,
    a 0.9 x 0.20 channel inside the ground-slab depth with removable covers (no pit, no entry, nothing notched), the grille under
    the TV, an honest breeze estimate, a 750 m3/h class HRV in a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
    [decisions.csv]
2026-10-31 Air system v3.1 (owner decisions applied) and the south wing / external stair study
    Part 0: assist fan YES (EC fan box in the plenum behind the grille, own switch, serviced through the grille), bird mesh
    only on the breeze path, the HRV in a base under the malqaf tower (one mass, top +9.10 = the attic coping, doors on the
    roof terrace), the AC condensers south of the tower (2.2 m clear of the base), the make-up inlet proposed under the stone
    band; air, roof (Z2a = the base, new sight-line check), courtyard (fan switch), structure X19, decisions, docs updated.
    Parts 1-2: new studies/south_wing.typ (study only): the swapped south wing with the treadmill's manufacturer zone, the
    pivoting sealed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
    [decisions.csv]
2026-10-31 South wing decisions applied: gym west + south, suite court 2.5 m clear, office east; external stair tower east; internal roof stair dropped; outdoor kitchen
    data/rooms_ff.csv, studies/ff_suite.typ (treadmill zone 2.0 / 0.5 on the west edge, the court's furniture test, the office doors:
    thumb-turn gym side / key office side, visitors' door east, double wall to bedroom 3), ff_family.typ, design_ff.typ, design_gf.typ
    (tower, foot gate, outdoor counter, grill + tannour, service gate, yard screen), structure.typ (B19 under the treadmill, B20 / B21,
    R6 4.4 m, R16-R18 dropped, X5 revised: improved, not verified), roof.typ (the main stair stops at the first floor; the roof from the
    external stair t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
    [decisions.csv, open_edges.csv, rooms_ff.csv]
2026-10-31 South wing v2
    Gym on the west band (treadmill on the 2.75 m solid bay inside the column frame, an entrance nib at the gallery end), the suite court from the gym to the office (25.3 m2 axes, the three doors on a 1.2 m strip, seating south, near-flush doors with linear drains), the office east with no door to the bedroom, fixed TVs; sight lines tested with the doors open (fix: an entry wardrobe); R6 removed, X5 revised (improved, not verified); roof outlines, guards, PV and walkways; the court route counted only with E30 clerestory glazing; the south side compared (mashrabiya proposed). tools/check.py: ALL CHECKS PASSED.
    [decisions.csv, rooms_ff.csv]
2026-11-01 V8.0: fire safety, courtyard, air system, external stair, south wing v2
    Release V8.0 (work merged into main):
    - PROJECT_V7.md -> PROJECT_V8.md (schedules, decisions 4.31-4.36, changelog V8.0);
    OPEN_ITEMS (20 items), REQUIREMENTS, DESIGN_LANGUAGE, AIR_SYSTEM, DETAILS,
    STRUCTURE_STUDY, NEXT_SESSION, READMEs updated; PENDING_CHANGES cleared.
    - Review status V8: every critical and major finding with its status and version;
    the next open items in the owner's order.
    - 3D V8.0: the external stair tower, the internal stair to the first floor only,
    the HRV base under the malqaf head, the courtyard layout, the south wing v2;
    five renders (north, aerial SE, courtyard, suite court, TV wall).
    -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
    [decisions.csv, open_items.csv, taif_first_floor_V7.1.dxf, taif_first_floor_V8.0.dxf, taif_ground_floor_V7.1.dxf, taif_ground_floor_V8.0.dxf, taif_roof_V7.1.dxf, taif_roof_V8.0.dxf]
2026-11-01 Stair tower removed; maintenance ladder in the suite court; roofline lowered (work)
    Owner decisions (1 Nov 2026, after V8.0), applied to the source files only:
    - The external stair tower, its gates, landings and the office's visitors' door
    are removed; the office is reached from the suite court only (simple doors);
    an east window for the office; the suite escape window restored to y 15.0-18.6.
    - The roof by a manufactured vertical ladder in a 0.90 x 0.30 recess in a stone
    pilaster on the gym's east wall (3.7 m, locked walnut panel, self-closing gate,
    fall-arrest rail): one enlarged plan and section in studies/roof.typ page 2.
    - The attic lowered to 1.40 m above the roof finish (+8.70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
    [decisions.csv]
2026-11-01 Stair flip study (study only): the main stair turned round, compared and recommended
    Owner's idea (1 Nov 2026 after V8.0): start and arrival at the north end next to
    the lift. New studies/stair_flip.typ -> output/stair_flip.pdf: enlarged plans of
    both floors for both options, the congestion test at the flipped start, headroom
    tread by tread (identical: 2.22 m under the trimmer), the mirrored trimmers
    B16'-B18', the freed south landing (2.78 m2 net), the route table (stair top,
    lift, entrance), storage, light, escape, knock-on effects, pros / cons.
    Recommendation: flip with conditions (B); eight decisions listed for the owner.
    No design file, CSV or structure changed; the study is added to to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
2026-11-01 V8.1: tower removed, roof ladder, lowered roofline (checkpoint)
    Release V8.1 (work merged into main):
    - External stair tower removed; the office for the owner only, reached from the
    suite court; the roof by a maintenance ladder in a recess of the gym's east wall
    (closed walnut panel, stiles 1.10 m above the roof, gate in the court guard).
    - Roofline lowered: attic 1.40 m (+8.70), south parapet 0.70 m (+8.00) with a
    1.10 m guardrail set back 1.0 m; outdoor kitchen relocated; the lane service
    gate dropped (the farm's single 4 m main gate); fire study updated.
    - Documentation folded from PENDING_CHANGES.md into PROJECT_V8.md (V8.1 row),
    OPEN_ITEMS, REQUIREMENTS, DESIGN_LANGUAGE, AIR_S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
    [open_items.csv, taif_first_floor_V8.0.dxf, taif_first_floor_V8.1.dxf, taif_ground_floor_V8.0.dxf, taif_ground_floor_V8.1.dxf, taif_roof_V8.0.dxf, taif_roof_V8.1.dxf]
2026-11-02 Stair flip applied (option B, F-b); bedroom 1 bath and GF shower studies; food route accepted (work)
    Part 1 (owner decisions from studies/stair_flip.typ): the main stair turned round in
    the same well: the lower flight on the east half rises south off the family lobby,
    the half landing at the south end, the arrival at the north end beside the lift;
    trimmers B16'-B18' mirrored (headroom 2.22 m, 0.30 trimmers noted); the freed
    landing becomes the family bath's north part with a WC compartment by the shaft and
    a double basin; a balustrade along the lower flight on the riwaq; the store door
    onto the riwaq; a small west window at the half landing; a glazed side light at the
    entrance; the entry cup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
    [decisions.csv, open_edges.csv, rooms_ff.csv, rooms_gf.csv]
2026-11-02 Owner decisions recorded; site and services plan study (work)
    Part 0: bedroom 1 option A (no private bath, night lights on its route), the
    ground-floor shower deferred to the plumbing study (P1 preferred), the suite
    court's south side a mashrabiya on the 1.10 base to the frame (design_ff mark,
    south_wing s12, character.yaml data), the clerestory windows stay openable
    (open item 14 closed); decisions.csv updated.
    Part 1: studies/site_plan.typ -> output/site_plan.pdf (5 pages): the single
    4 m gate, the driveway, the optional car in the north strip, the guest path to
    the west foyer, the workers' path to the yard, the family garden (south) with its
    wall and hedge, no garden door (S-04), the serv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
    [decisions.csv]
2026-11-02 Owner decisions on the site plan recorded; plumbing and wet-room study, round 1 (work)
    Part 0: the north-strip family parking KEPT (parking inside the plot allowed by the municipality), the bay 0.2 m east so it clears the family entrance's path, the turning arc replaced by the swept path of a standard car (a 3-point manoeuvre from the driveway); the inverter and the batteries in the utility room, to be confirmed by the electrical engineer; decisions row added.
    Part 1 (study only): studies/plumbing.typ -> output/plumbing.pdf (5 pages, 9 checks): principles, the inventory of 22 wet points, the FF-over-GF overlay, the constraints map, the score of every wet point, alternatives (incl. the GF sh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
    [decisions.csv]
2026-11-02 Plumbing round 2; septic and tank positions
    A0: the existing septic outside the farm wall near corner C1 and the existing ground tank east of peg R (owner's information; approximate, to be measured); the reserved future tank beside it; the foul drainage of both clusters rerouted north and west to the septic with the inverts computed end to end (assumed falls), a pump station flagged if the surveyed inlet is higher; separations checked against assumed rules; rain fully separate; flags for the survey and the municipality.
    A1-A4 (study only): the suite bath over the kitchen in enlarged plans and dimensioned sections, (a) sunken slab vs (b) service wall + tub plinth vs (c) raised floor, the acc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
2026-11-02 V8.2: stair flip, site plan, plumbing studies (checkpoint)
    The work branch merged into main and the documentation brought up to date: the stair flipped (option B) with the larger family bath F-b, the coat cupboard and the lobby; bedroom 1 without a private bath (night lights); the ground-floor shower deferred to the plumbing study (P1 preferred); the suite court's south side a mashrabiya; the clerestories openable; the food route accepted; the site and services plan (single 4 m gate, north parking kept, guest stone path, south family garden, service yard and gas cabinet, existing water tank + reserved tank, existing septic near C1, PV provision without a generator, intercom and cameras); the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
    [decisions.csv, open_items.csv, taif_first_floor_V8.2.dxf, taif_ground_floor_V8.2.dxf, taif_roof_V8.2.dxf]
2026-11-03 Bedroom 2 en-suite + family WC, GF powder room, courtyard level layout, outdoor kitchen by the service door, plumbing decisions, facade principle; bedroom 1 B4 studied not applied (work)
    Part 1: bedroom 1's hotel-layout en-suite (B4) studied in three variants on page 3 of its study: the wedge room cannot hold the programme; criteria 2 and 3 fail; NOT applied.
    Part 2: the F-b bath split into bedroom 2's en-suite (with the former niche as its vanity niche) and a family WC from the gallery behind a screen wall, all fixtures on one service wall into the shaft (five criteria pass): rooms_ff.csv, ff_family, design_ff, sections, fire_escape, plumbing, structure X21, 3D open edges, presentation name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
    [decisions.csv, open_edges.csv, rooms_ff.csv, rooms_gf.csv]
2026-11-04 V8.3: bedroom 2 en-suite and family WC upstairs, ground-floor powder room, level courtyard, outdoor kitchen by the service door, plumbing decisions, facade principle R-37 (checkpoint)
    Documentation folded from PENDING_CHANGES.md (PROJECT_V8.md with the V8.3 changelog line, OPEN_ITEMS.md, REQUIREMENTS.md, DESIGN_LANGUAGE.md,
    NEXT_SESSION.md, the READMEs, PENDING_CHANGES.md cleared); plans, studies, the presentation (V8.3), the three DXFs and the 3D regenerated
    with two renders (the courtyard from the living, the family entrance and the stair); tools/check.py reads the PDFs with pypdf when
    pdftotext is missing or broken.
    [open_items.csv, taif_first_floor_V8.3.dxf, taif_ground_floor_V8.3.dxf, taif_roof_V8.3.dxf]
2026-11-04 Interim V&V review of V8.3
    docs/review/vv_review_v8_3.typ → output/VV_Review_V8.3.pdf (A4, English with Arabic summaries): executive summary with the top 10 issues,
    the requirements traceability matrix R-01 … R-37, the Saudi code and global practice checks with sources ("not verified" where not read
    from the source), the consistency findings, ten validation scenarios with route maps, the open decisions and engineer / survey / detail
    items, the findings register (20 findings), the prioritised action list before V9.0, the comparison with the V6 review. Review only: no
    design file changed. tools/check.py compiles it.
2026-11-04 House moved 1.24 m south; set-out sheet and field instructions
    Owner on site, 4 Nov 2026: corner B1 exactly 5.00 m from M1, the west face
    0.785 m east of the M line; the shift (0.91, 3.825) -> (0.91, 5.063), the house
    itself unchanged. Applied in design_gf.typ, the site plan, the south wing,
    plumbing and fire studies and the 3D site data; the nearest wall to the setback
    line is now 0.79 m (the lane notch on the cut wall B2-B3, every edge sampled).
    New: studies/setout_v83.typ (status from the tightest point on any wall, the
    tape table from M1 and D) in tools/check.py; site_test.typ superseded;
    docs/SITE_SETOUT.md with the field results table (M1 -> D measured 28.50 m).
    decisions.csv, open ite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
    [decisions.csv, open_items.csv]
2026-11-04 Site set-out: B2
    B2 (north-east, the start of the cut) set from M1 / D; B1 -> B2 measured
    10.30 m, model 10.25 m (+0.05 m), accepted. Next: B4, B3, the diagonals,
    M4 -> the palms.
2026-11-04 Site set-out: B3 and final checks
    B3 (the east end of the cut) set 18.16 m from B4 and 6.93 m from B2, accepted;
    the perimeter string (model 73.15 m) and the diagonals (27.78 / 26.33 m) added
    with blanks to measure. All five corners are set out on site; the outline is
    ready for the owner's walk-through.
2026-11-04 House moved 1.24 m south; set-out sheet; field results day 1
    The site move, the set-out sheet and the decision are in 1a9d2b0; this
    commit completes the record: the full day-1 field results in
    docs/SITE_SETOUT.md (M1 -> D +0.07, M1 -> B5 +0.10, M1 -> B2 +0.07, the sides
    exact, the diagonals 27.78 / 26.33 exact, the perimeter string 74.0 vs 73.15),
    the four corrections recorded as lessons, the arc-crossing warning, the B1-B3
    diagonal (14.87) and the perimeter (73.15) in the sheet and the target table,
    the decision's wording (string set-out, diagonals exact).
    [decisions.csv]
2026-11-05 Whole-farm site base v2 and old buildings
    The site baseline v2 (field check 03 Oct 2026) is the source of truth: the
    owner's inputs in site/inputs/, tools/site_frame.py writes data/site_v2.csv in
    the design frame, base.typ asserts its literals against it and gains D, R, S,
    C1 and the well. New studies/whole_farm.typ: the 20 deed corners, the gates,
    the well, the palms, the measured old buildings, the dotted "to be measured"
    items, the north zone with the new house, and the old house and its annex
    digitised from the scanned deed (data/deed_sketch.csv, rms 1.36 m, checked on
    the well and on D): west of the driveway, no conflict with the new house.
    SITE_SETOUT.md: R and S as reference points wi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
    [deed_sketch.csv, site_v2.csv, taif_north_zone_final_v2.csv, taif_north_zone_final_v2.dxf]
2026-11-05 Existing buildings: owner's answers
    The old house (the old majlis inside it) west of the driveway as on the deed
    sketch; its covered parking and the existing ground tank south of it, west of
    the driveway near peg R, the reserved tank beside it, the supply pipe across
    the driveway; the septic near C1 serves the old house and takes the new
    house's drains (a chamber at every bend, the inlet at -1.23); no farm building
    south of the build land; the field sheet extended (P1-P4, K0-K2).
    [decisions.csv]
2026-11-06 Field row 18; shift south 0.40-0.60 m: study
    [decisions.csv]
2026-11-06 0.50 m south adopted; cut wall: short study
    [decisions.csv]
2026-11-06 Cut wall -0.12 m (field 2.30); bedroom 1 en-suite study
    [decisions.csv, rooms_ff.csv, rooms_gf.csv]
2026-11-06 V9.0: Layout freeze
    Site set out on site (day 1, diagonals exact) and final position (1.24 + 0.50 m south, B1 5.49 m from M1); cut wall shortened 0.12 m (field 2.30 m; margin 0.42 m from the wall as built, 0.90 m from the deed); whole-farm base v2 (the deed is the boundary authority), the old house with its majlis, the covered parking, the water tanks and the septic placed; stair flipped; bedroom 2 en-suite, family WC upstairs, ground-floor powder room; bedroom 1 for young children without en-suite; level courtyard with movable seating, the fountain and tree at the kitchen window; outdoor kitchen by the service door; plumbing decisions (external east stack, trap primers, rain / sewage separa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
    [decisions.csv, open_items.csv, taif_first_floor_V8.3.dxf, taif_first_floor_V9.0.dxf, taif_ground_floor_V8.3.dxf, taif_ground_floor_V9.0.dxf, taif_roof_V8.3.dxf, taif_roof_V9.0.dxf]
2026-11-08 House moved to B1 6.00 m from M1; cut wall shortened (adopted)
    Owner's decision (car test on site: a full turn into the north strip):
    the house a further 0.5104 m south (shift 0.91 / 6.0734, B1 6.00 m
    from M1, west face 0.785 m east of the M line). The cut wall moved a
    further 0.24 m outwards, parallel (outer cut 6.08 m): 0.42 m from the
    wall as built (field 2.30), 0.91 m from the deed line. Set-out sheet
    re-issued, SITE_SETOUT.md updated, site re-checked (swept path drawn,
    parking bay on the turning line, soakaways moved), levels note added.
    [decisions.csv, open_items.csv, rooms_ff.csv, rooms_gf.csv]
2026-11-08 V9.1: final site position (B1 6.00 m)
    Final site position, B1 6.00 m from M1 (car test); cut wall shortened
    again to 0.42 m from the wall as built; set-out sheet re-issued; site
    items updated; levels to be set from the survey. PENDING_CHANGES folded
    into PROJECT_V9.md and the docs; review status V9.1; 3D at the new
    position (render: aerial from the south-west); presentation V9.1
    checked sheet by sheet; DXFs V9.1; the V9.0 set archived.
    [decisions.csv, open_items.csv, taif_first_floor_V9.0.dxf, taif_first_floor_V9.1.dxf, taif_ground_floor_V9.0.dxf, taif_ground_floor_V9.1.dxf, taif_roof_V9.0.dxf, taif_roof_V9.1.dxf]
2026-11-08 Small fixes: G13 label, air tower 0.90 m², attic
    - The utility room (G13) labelled on the presentation's plans; the low
    store door under the stair's half landing labelled "store".
    - The air tower back to a rectangle 1.425 x 1.0 on axes, 0.90 m² clear
    (breeze shaft 0.54, partition, HRV intake compartment 0.28); the wedge
    beside it to the maid bath (shelf niche, 3.85 m² clear) and bedroom 1
    (cupboard, 15.91 m² clear); the HRV base back to its V9.0 footprint;
    B15 / R9 1.43 m and the structure note.
    - The attic 2 cm lower (1.38 m, coping +8.68): hidden again from the
    north boundary; the roof check back to "hidden".
    [rooms_ff.csv, rooms_gf.csv]
2026-11-08 V9.2: small fixes
    V9.2: small fixes: utility room label, air tower back to ≈ 0.90 m²
    (rooms gain), attic hidden. PENDING_CHANGES folded into PROJECT_V9.md
    and the docs; presentation V9.2 (12 sheets, checked), DXFs V9.2, 3D
    rebuilt (no new renders); the V9.1 presentation, DXFs and model
    archived; the review status V9.1 unchanged.
    [taif_first_floor_V9.1.dxf, taif_first_floor_V9.2.dxf, taif_ground_floor_V9.1.dxf, taif_ground_floor_V9.2.dxf, taif_roof_V9.1.dxf, taif_roof_V9.2.dxf]
2026-11-08 Small fixes; malqaf tower: study
    Part A: the G13 label, the store door label and the 2 cm lower attic
    (hidden from the north boundary) were already applied in V9.2; checked,
    no further change.
    Part B (study only, the design files unchanged): studies/malqaf_tower.typ
    -> output/malqaf_tower.pdf. A slim shaft 0.575 x 1.565 m clear (0.90 m²)
    hugging the cut wall so the maid bath and bedroom 1 each get one straight
    wall parallel to the cut; the HRV unit in a plant room behind the attic;
    a 1.25 m square stone tower set back on the attic's corner; six variants
    compared (heads a / b / c, 2.5 / 3.5 m, flat or dome), gate-view renders
    by 3d/malqaf_variants.py; recommendation (c) at 3.5 m, flat Hijaz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
2026-11-08 Malqaf tower: location study
    Pages 6-7 of studies/malqaf_tower.typ (study only, the design files
    unchanged): four positions compared (the NE cut corner, the courtyard's
    NE corner, the west band, over the kitchen) on the breeze route and
    flow, the HRV intake separations, the rooms and walls, the structure,
    the roof, the views from the gate, the street and the courtyard, and
    the cost. Recommendation: keep the NE cut corner, with the breeze
    channel at its full width; the courtyard corner the strong alternative.
2026-11-08 Malqaf tower adopted: L1, head (c) 3.5 m
    From studies/malqaf_tower.typ (owner): at the north-east corner a slim
    shaft hugging the cut wall (0.575 x 1.565 m clear = 0.90 m²: breeze
    0.54, HRV compartment 0.30) behind one new wall parallel to the cut, a
    square end wall and a solid corner pier; the maid bath (3.04 m² clear)
    and bedroom 1 (15.10) with straight walls, a maid store and a bedroom 1
    cupboard (0.56 each); the access panel from the maid bath, the roof
    hatch, the mesh frames on cords. Above the roof a 1.25 m honey-stone
    tower on the attic's corner, head (c) of slender arched openings, crown
    +12.18, a Hijazi cornice; the HRV in a 1.6 x 1.4 m plant room behind the
    attic (the old base re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
    [decisions.csv, rooms_ff.csv, rooms_gf.csv]
2026-11-08 V9.3: the new malqaf tower
    V9.3: the new malqaf tower (north-east corner, slim shaft with straight
    room walls, head of slender arched openings 3.5 m above the attic,
    Hijazi cornice, honey stone; the HRV in a hidden plant room; the breeze
    channel at full width). PENDING_CHANGES folded into PROJECT_V9.md,
    OPEN_ITEMS.md, AIR_SYSTEM.md, DESIGN_LANGUAGE.md, NEXT_SESSION.md and the
    READMEs; presentation V9.3 checked sheet by sheet, DXFs V9.3, GLB V9.3,
    renders char_gate.png and char_aerial_ne.png; the V9.2 set archived.
    [taif_first_floor_V9.2.dxf, taif_first_floor_V9.3.dxf, taif_ground_floor_V9.2.dxf, taif_ground_floor_V9.3.dxf, taif_roof_V9.2.dxf, taif_roof_V9.3.dxf]
2026-11-08 North-east corner simplified: study
    Short study only (studies/ne_corner.typ -> output/ne_corner.pdf), the
    design files unchanged. The cut wall runs 6.1 m, the full depth of
    bedroom 1: the largest rectangle in the corner is about 8.9 m² on axes
    (7.6 clear, 1.85 m wide) with no window. Recommended: the young
    children's bedroom in the kids' room's rectangle (12.49 m² clear, its
    north escape window), the corner room the older children's study and
    gaming room (15.74), the shaft the corner trapezoid at the cut's tip
    (0.54 m² clear, breeze only, the ground floor's HRV risers down the west
    shaft), downstairs option B (the maid room in the corner, the maid bath
    a rectangle on the kitchen wall besi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
2026-11-09 Malqaf L5 Phase 0: cautions printed as CAUTION (WARNING is reserved for failed checks)
2026-11-09 Malqaf L5: Phase 1 (geometry and variants)
    Study only. Three variants in the courtyard's north-west corner; the
    first-floor gallery's turn past bedroom 2's bath limits the shaft to
    1.2 x 0.8 m clear (0.96 m2) for a 1.5 m passage. V-c recommended: the
    foot chamber in the first arcade bay (1.2 x 1.97 m clear) with the dust
    trap, filters and EC fan and the mobile cooler, the outlet in the first
    arch, a 1.0 m carved door; about 3.5 x the L1 breeze (assumed). Wind
    shadows: the old house is clear; the new house's own roof bubble needs
    the head's openings at about +11.0 to +12.6. Weather station advice.
2026-11-09 No stone recorded; facade study and D11 open items; Malqaf L5: Phase 2 (structure)
    Owner decision 9 Nov 2026 recorded in data/decisions.csv and
    docs/DESIGN_LANGUAGE.md: no stone on the exterior, render and paint,
    the character built into the structure; open items 20 (the facade study
    in three stages, after the plan freeze) and 21 (D11 facade bands). The
    L5 study: core and head in render and paint; the Phase 1 answers
    recorded (V-c, the winter late mornings); Phase 2: an independent RC
    core on one pad absorbing C17, C21 and the first arcade column, the
    fourth support of the west projection (B3 / B4 first spans 6.50 to
    4.33 m), loads and bearing, the head above the roof governed by
    earthquake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
    [decisions.csv, open_items.csv]
2026-11-09 Floors: no stone, porcelain (recorded); Malqaf L5: Phase 3 (facade)
    Owner decision recorded in data/decisions.csv and DESIGN_LANGUAGE.md: no
    stone and no marble on any floor, marble-look porcelain inside and
    anti-slip R11 porcelain outside. L5 Phase 3 (study only): the courtyard's
    west face in three options with the malqaf as the head of the
    colonnade; F3 recommended (the head 1.6 x 2.4 over the first arcade bay,
    on its axis); the view north and from the riwaq; the gallery's carved
    grille into the shaft; the filtered-air grilles; D11 cautions.
    [decisions.csv]
2026-11-09 Malqaf L5: Phase 4 (air system and controls)
    Study only. The owner's Phase 3 answers recorded (F3 with the south
    overhang, the carved grille, W1's sill +3.80, the bench). Phase 4: the
    two paths after the head (the unfiltered breeze path with its dampers,
    dust trap, foot chamber and courtyard outlet; the filtered path with a
    never-closing inlet under the overhang, two filters and a 750 m3/h EC
    fan feeding the family living, the gallery, the riwaq and the majlis);
    the dampers; positive pressure and the kitchen hood caution; the
    exhausts relative to the head (the west vent upwind); insulation,
    moisture, sensors; the seven control modes; the maintenance plan from
    the courtyard door; rough perfor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
2026-11-09 Malqaf L5: the owner's simplifications; Phase 3 addendum; Phase 5 (the head)
    Study only. Phases 1, 3 and 4 simplified as the owner asked: wall
    switches only with one dust-sensor relay and spring-return dampers, no
    controller and no modes; the gallery grille a sealed provision; the
    cooler an option (a dry system); the filters and the fan in the foot
    chamber with a silencer; the bathrooms' vent re-routed south-east; the
    hood's make-up inlet mandatory. A Phase 3 addendum with two eye-level
    perspectives of the riwaq and the strip. Phase 5: the head 1.6 x 2.4 in
    render and paint, F3 proved on the roof beams with two small additions
    (else F2), visibility (hidden from the gate, seen from the courty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
2026-11-09 Malqaf L5 adopted
    The owner's decision of 9 Nov 2026 (studies/malqaf_L5.typ, Phase 6; an approved exception to the layout freeze): the malqaf moves to the courtyard's north-west corner, variant V-c with head F3 (fall-back F2).
    - Rooms: the courtyard an L-shape round the core, the riwaq's sliver, the gallery less the shaft; the north-east corner back to V9.1 (the maid bath straight, the store the whole cut tip, bedroom 1 with the tip, no cupboard).
    - design_gf.typ: tower-csv (the foot chamber), the carved door and the outlet; the FF studies, the east wing, the shower, the site plan, the plumbing (the gully to the west run, the west vent re-routed SE, no channel), the courtyard layout (the ou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
    [decisions.csv, open_items.csv, rooms_ff.csv, rooms_gf.csv]
2026-11-09 V10.0: the malqaf (L5)
    The malqaf moved to the courtyard's north-west corner (L5): breeze at the seating ~4x L1, foot chamber with dust trap, filters, fan and cooler space, head F3 on the first bay's axis, the core as the fourth support of the west projection; the HRV replaced by a filtered supply fan; the north-east corner restored; no stone anywhere (render and paint; porcelain floors); simple controls (two switches and a dust relay).
    - PROJECT_V10.md (from PROJECT_V9.md, archived): the schedules, 4.10, 4.63 (L5), 4.64 (no stone), 5 (the approved exception), the changelog.
    - OPEN_ITEMS, REQUIREMENTS, DESIGN_LANGUAGE, AIR_SYSTEM (v4), NEXT_SESSION (next: the bathrooms interior study, the w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
    [decisions.csv, open_items.csv, taif_first_floor_V10.0.dxf, taif_first_floor_V9.3.dxf, taif_ground_floor_V10.0.dxf, taif_ground_floor_V9.3.dxf, taif_roof_V10.0.dxf, taif_roof_V9.3.dxf]
